saltscapstone/capstone/robot_photos/IMG_0165.JPG

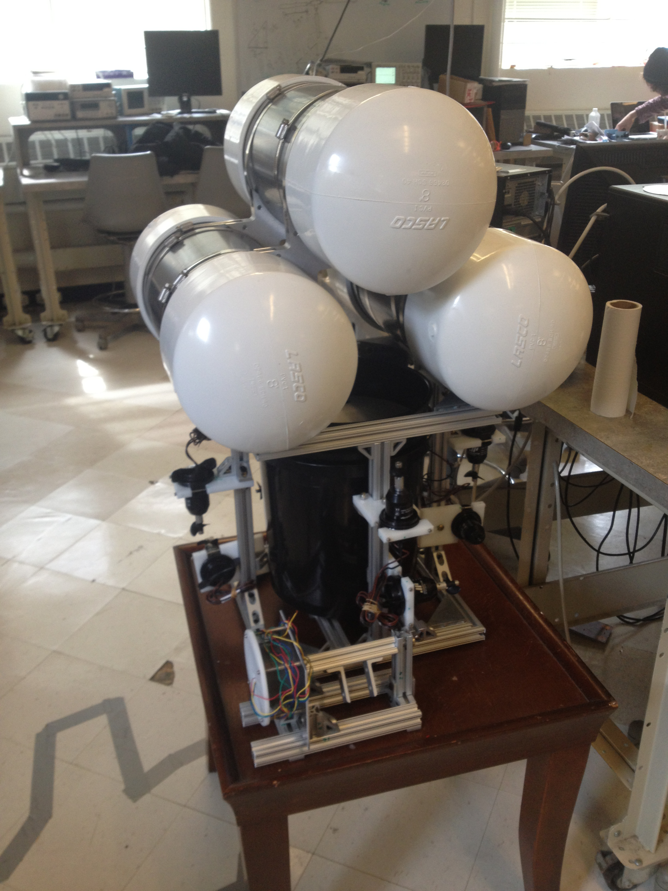
robot_photos/IMG_0165.JPG
