saltscapstone/capstone/robot_photos/IMG_0167.JPG

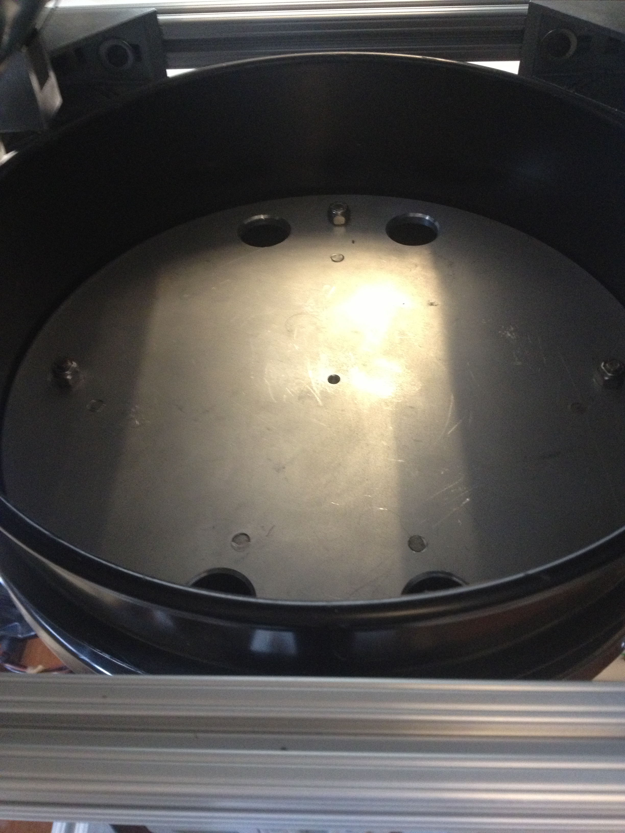
robot_photos/IMG_0167.JPG
