saltscapstone/capstone/robot_final/Team Drawings/E-VolumeForElectronics.pdf

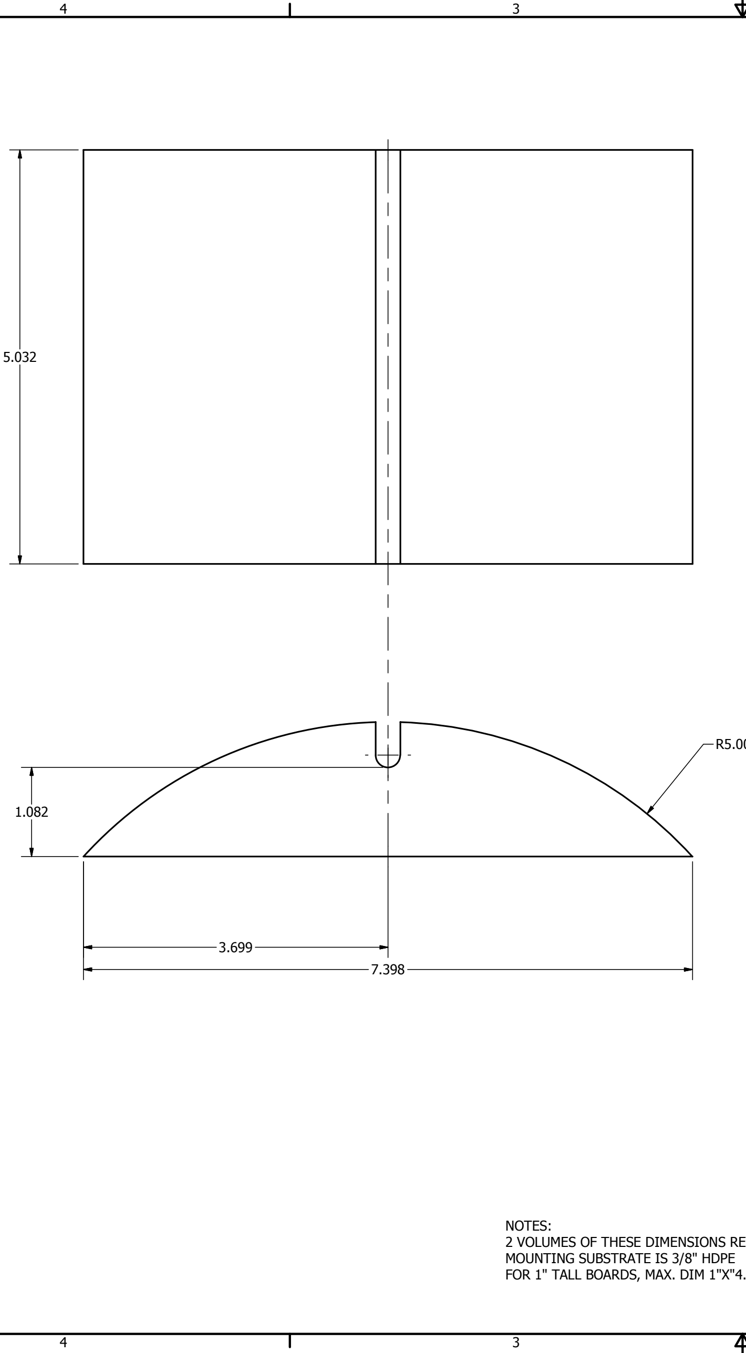
[picture p35: figure]
RAT
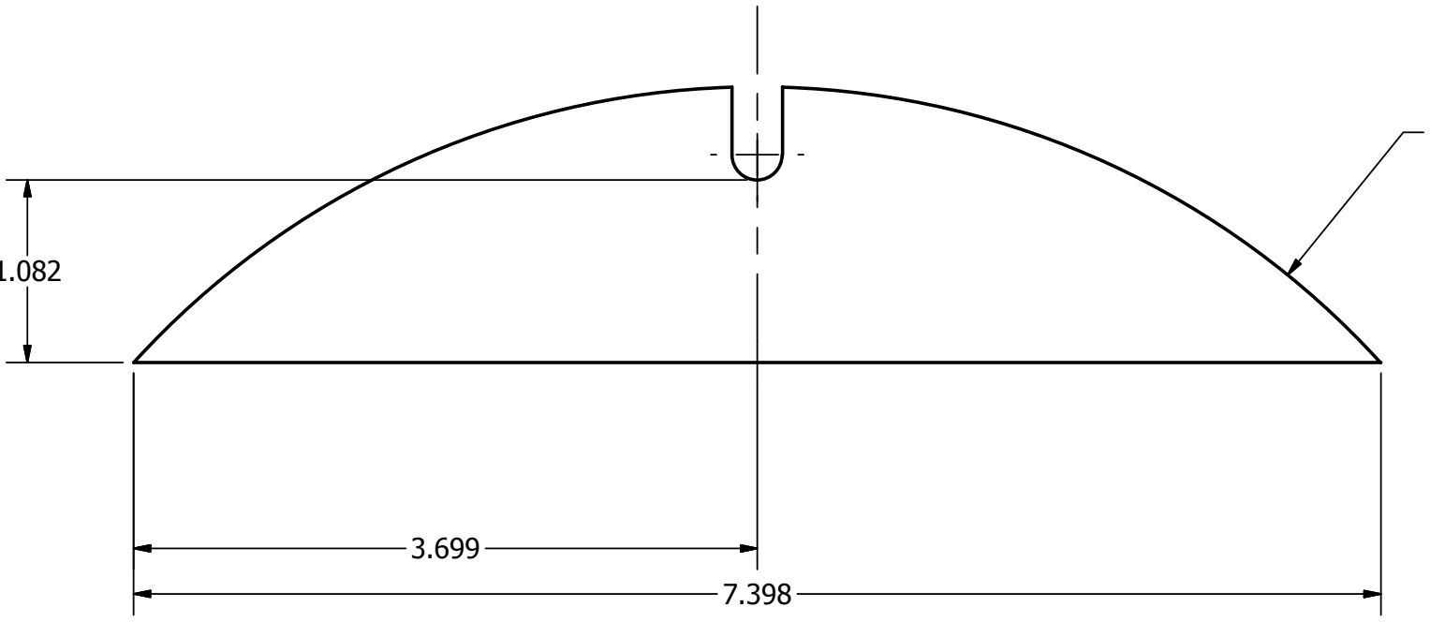
[picture p36: figure]

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
## TIO

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
## TIO

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
## PRODUCED BY AN AUTODESK EDUCATIONAL PRODUCT

## PRODUCED BY AN AUTODESK EDUCATIONAL PRODUCT

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
## olu

m

e

F

o

r

## Ele

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
