saltscapstone/capstone/robot_final/Drawings/RenumberedDrawings/1.pdf

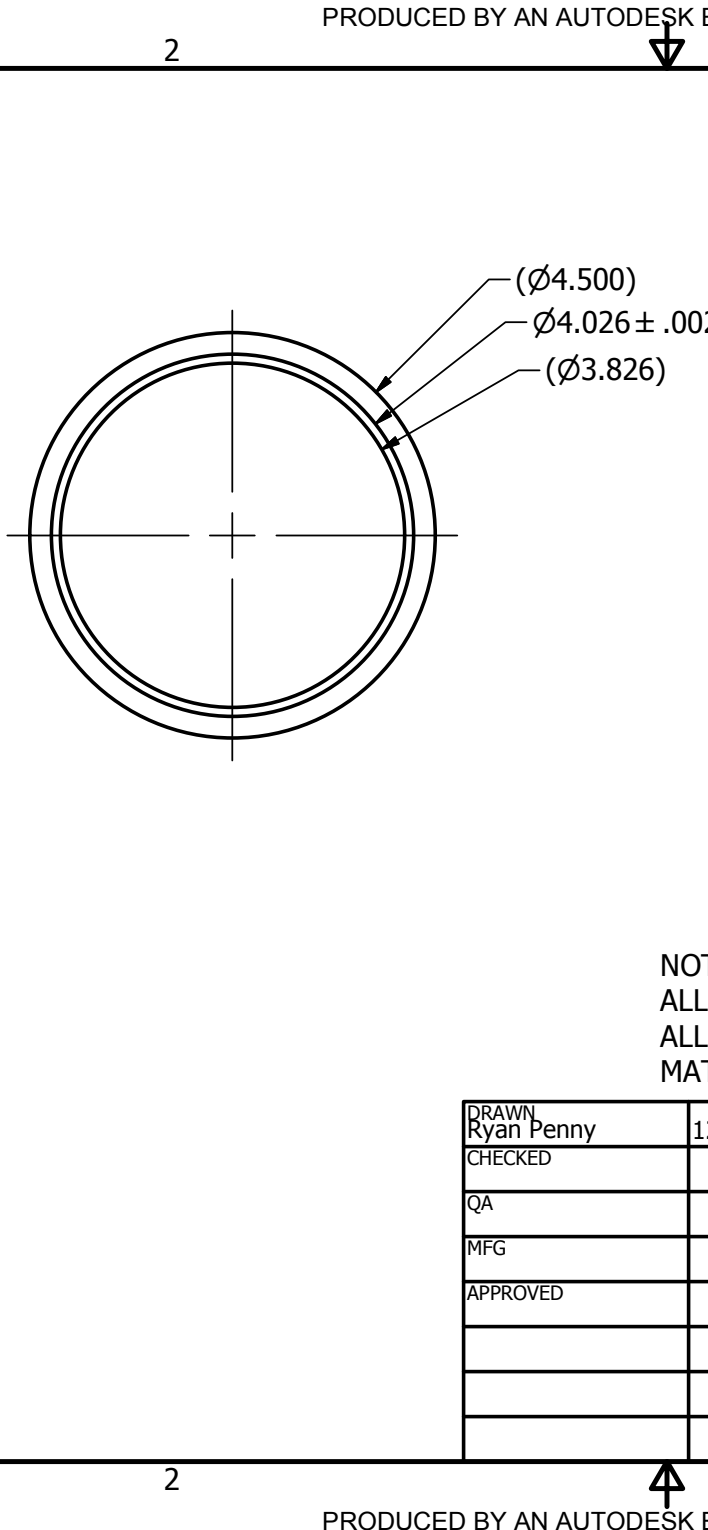
[picture p37: figure]
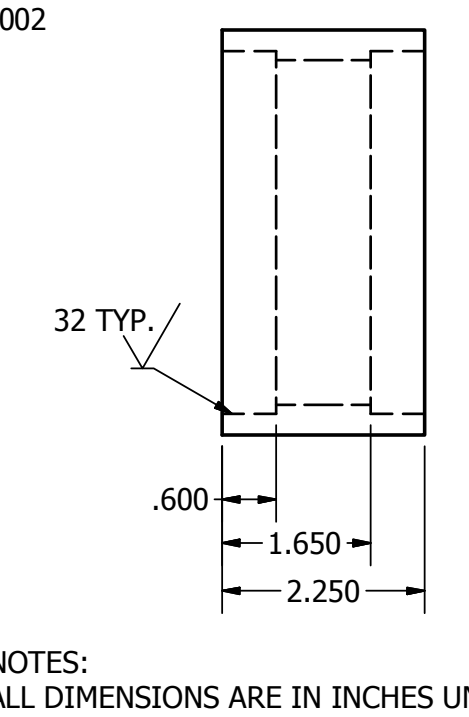
[picture p38: figure]

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
PRODUCED BY AN AUTODESK EDUCATIONAL PRODUCT

PRODUCED BY AN AUTODESK EDUCATIONAL PRODUCT

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
