saltscapstone/capstone/robot_final/Drawings/RenumberedDrawings/13.pdf

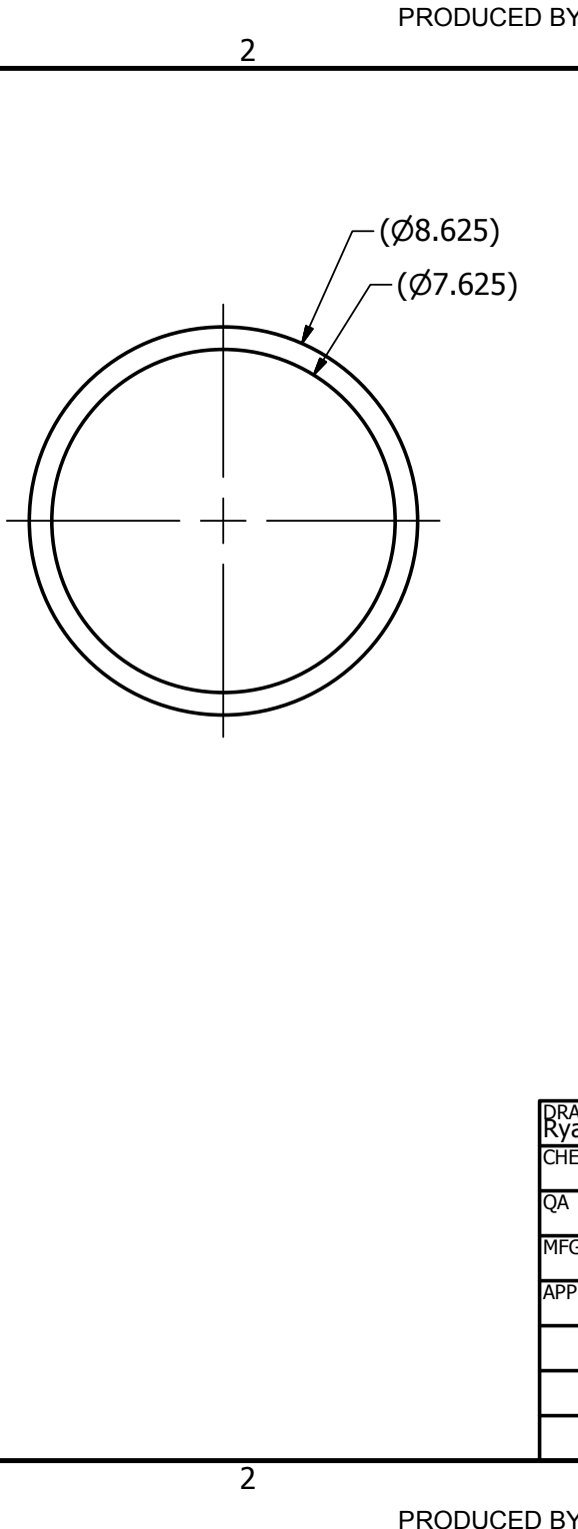
[picture p39: figure]

Y

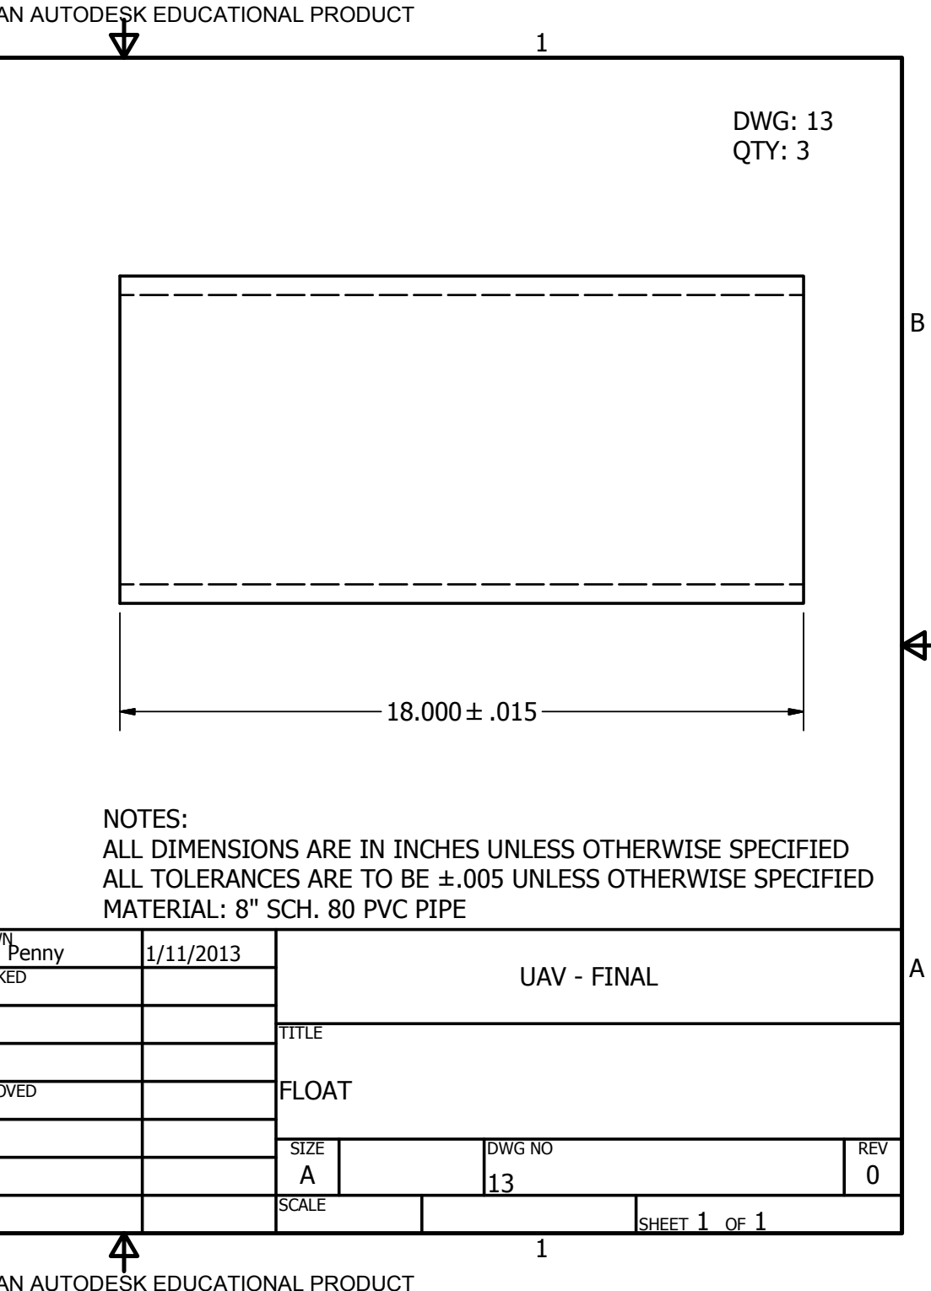
[picture p40: figure]
TIO

A

Y

A

PRODUCED BY AN AUTODESK EDUCATIONAL PRODUCT

PRODUCED BY AN AUTODESK EDUCATIONAL PRODUCT

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
