saltscapstone/capstone/robot_final/Drawings/RenumberedDrawings/24.pdf

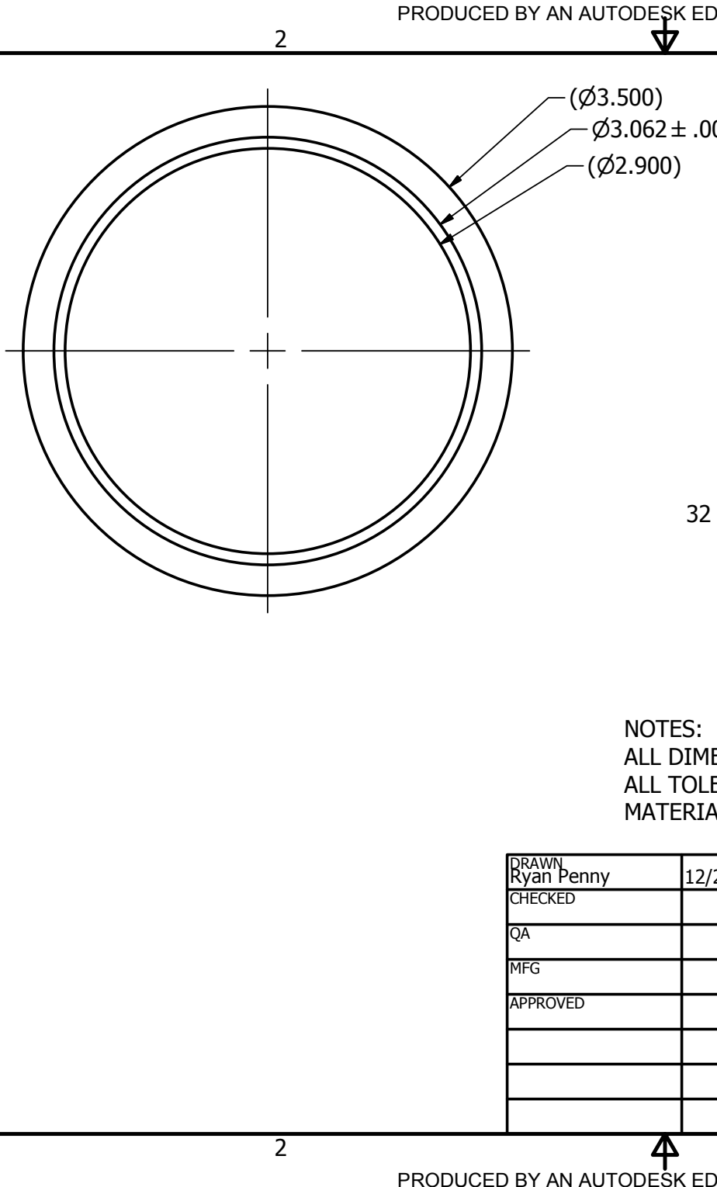
[picture p41: figure]

PRODUCED BY AN AUTODESK EDUCATIONAL PRODUCT

PRODUCED BY AN AUTODESK EDUCATIONAL PRODUCT

A

A

B

B

R

E

V0

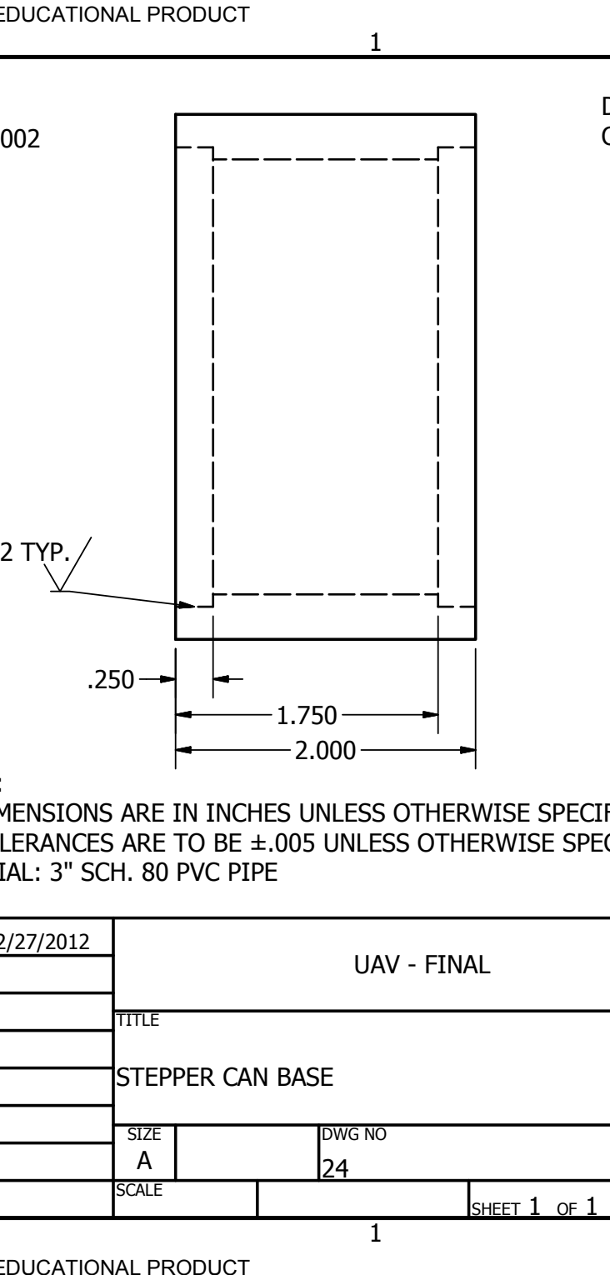
[picture p42: figure]
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
