saltscapstone/capstone/robot_final/MotorAssyR.bmp

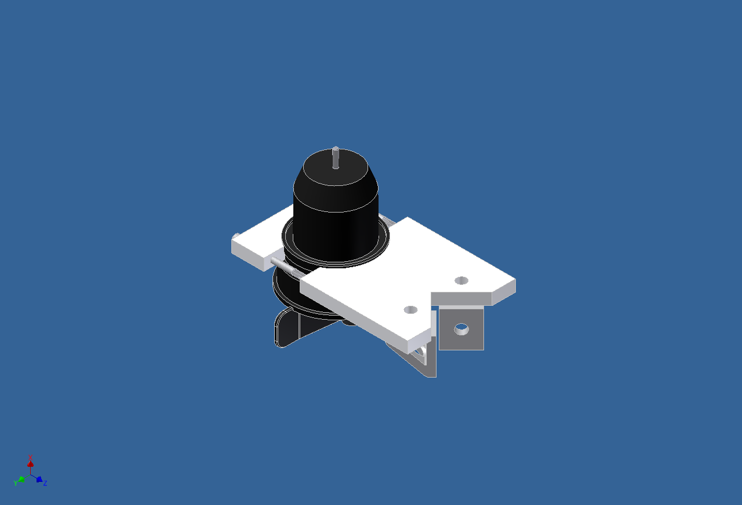
robot_final/MotorAssyR.bmp
