saltscapstone/capstone/robot_final/Team Drawings/JAN-8-2012.jpg

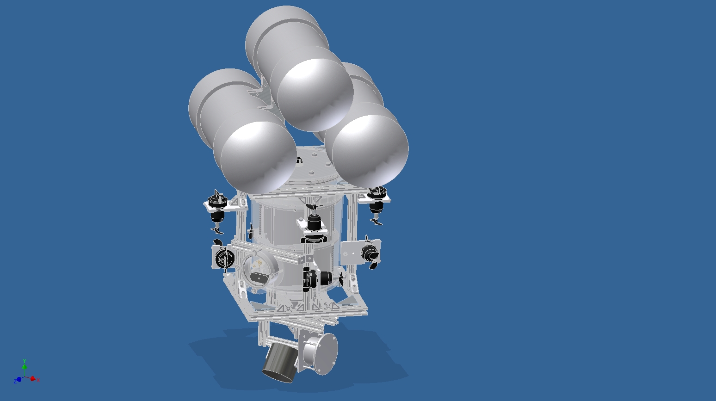
robot_final/Team Drawings/JAN-8-2012.jpg
