saltscapstone/capstone/robot_photos/Camera.bmp

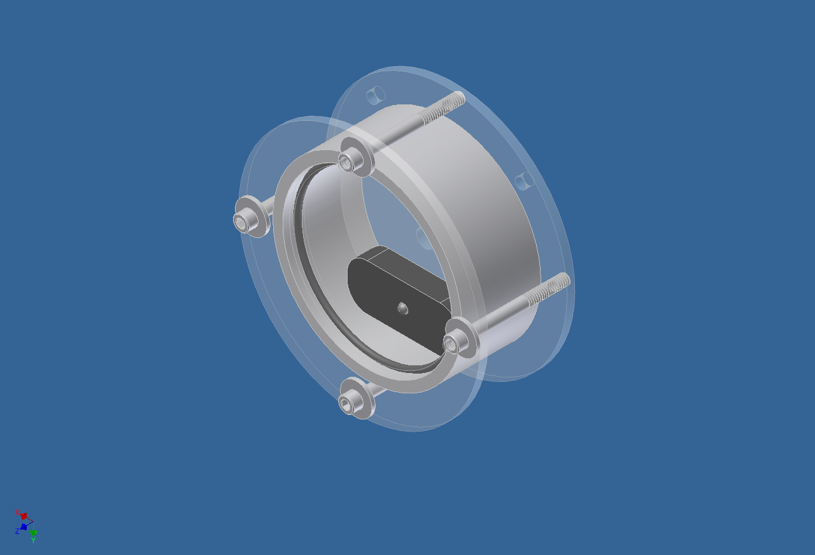
robot_photos/Camera.bmp
