saltscapstone/capstone/robot_photos/Electrical2.bmp

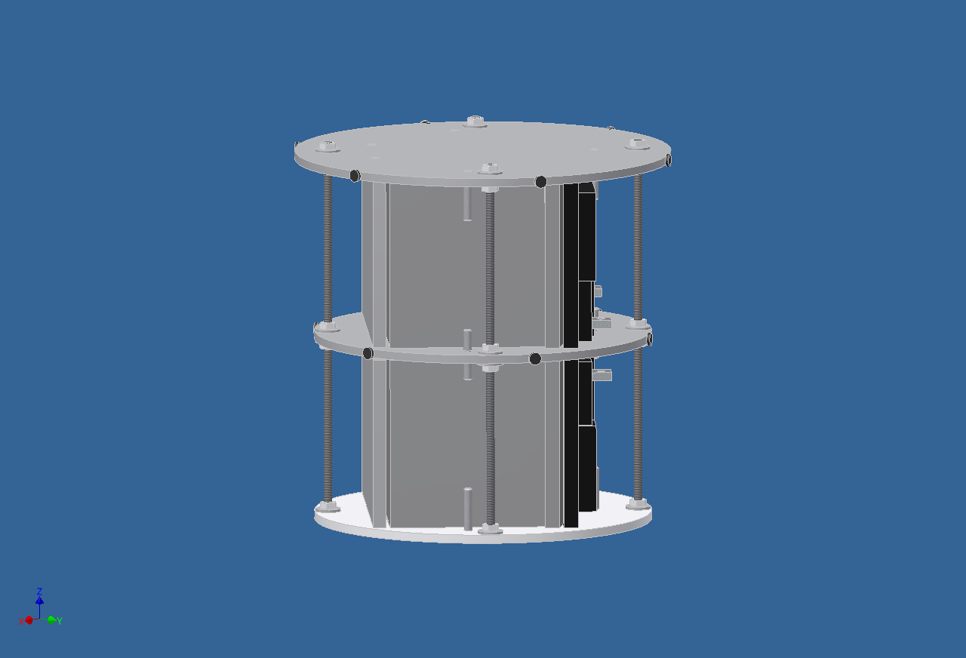
robot_photos/Electrical2.bmp
