saltscapstone/capstone/robot_photos/Electrical.bmp

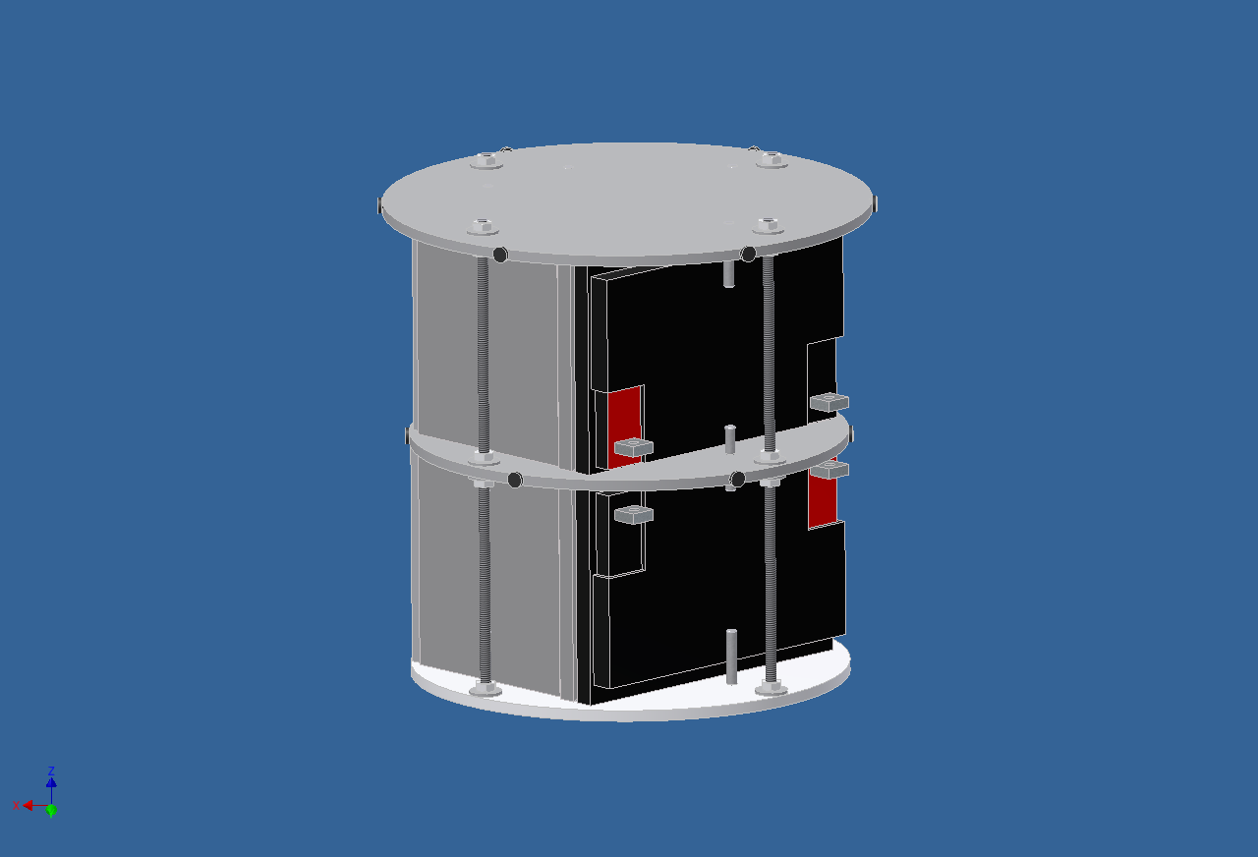
robot_photos/Electrical.bmp
