saltscapstone/capstone/robot_photos/Gimbal.bmp

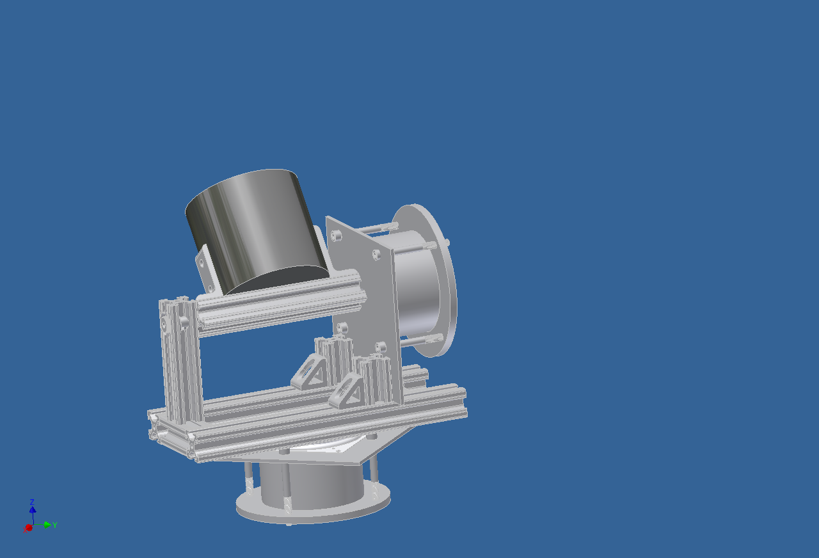
robot_photos/Gimbal.bmp
