saltscapstone/capstone/robot_photos/IMG_0157.JPG

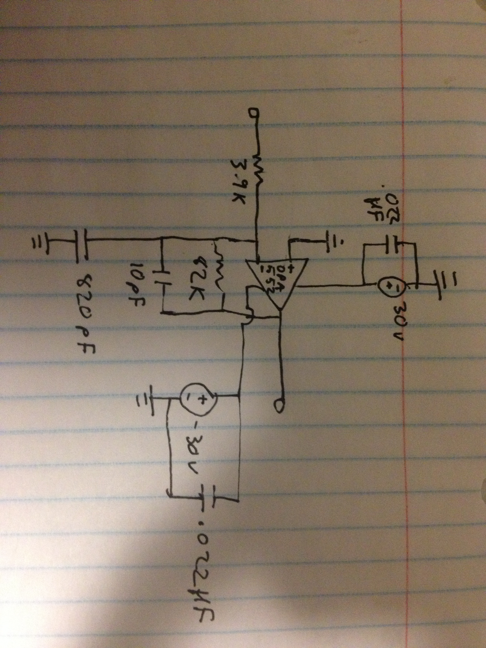
robot_photos/IMG_0157.JPG
