saltscapstone/capstone/robot_photos/IMG_0159.JPG

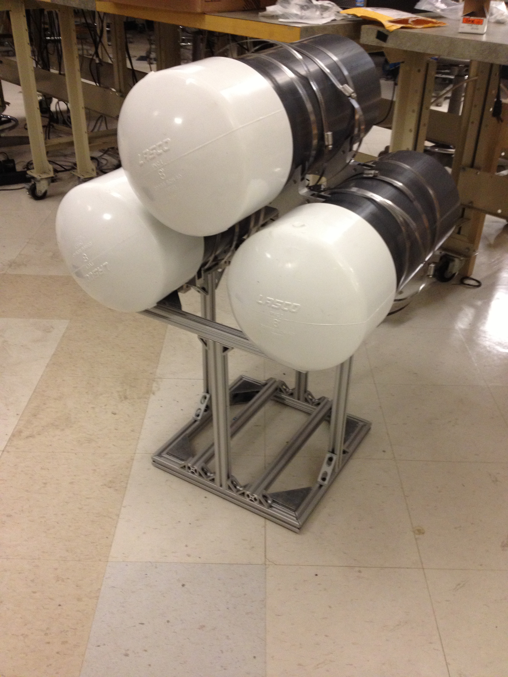
robot_photos/IMG_0159.JPG
