saltscapstone/capstone/robot_photos/IMG_0160.JPG

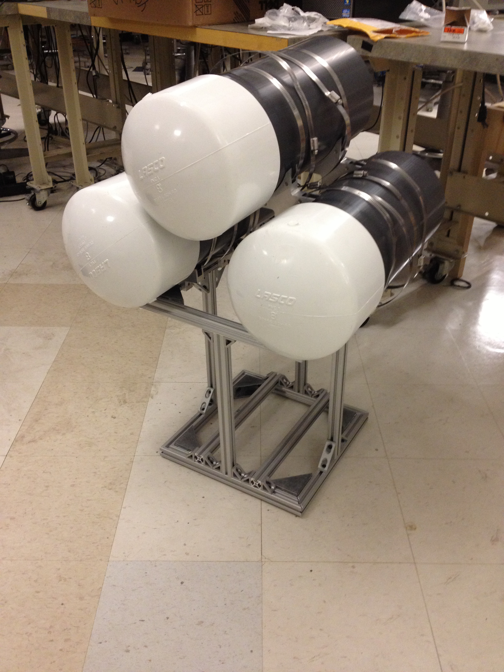
robot_photos/IMG_0160.JPG
