saltscapstone/capstone/robot_photos/IMG_0163.JPG

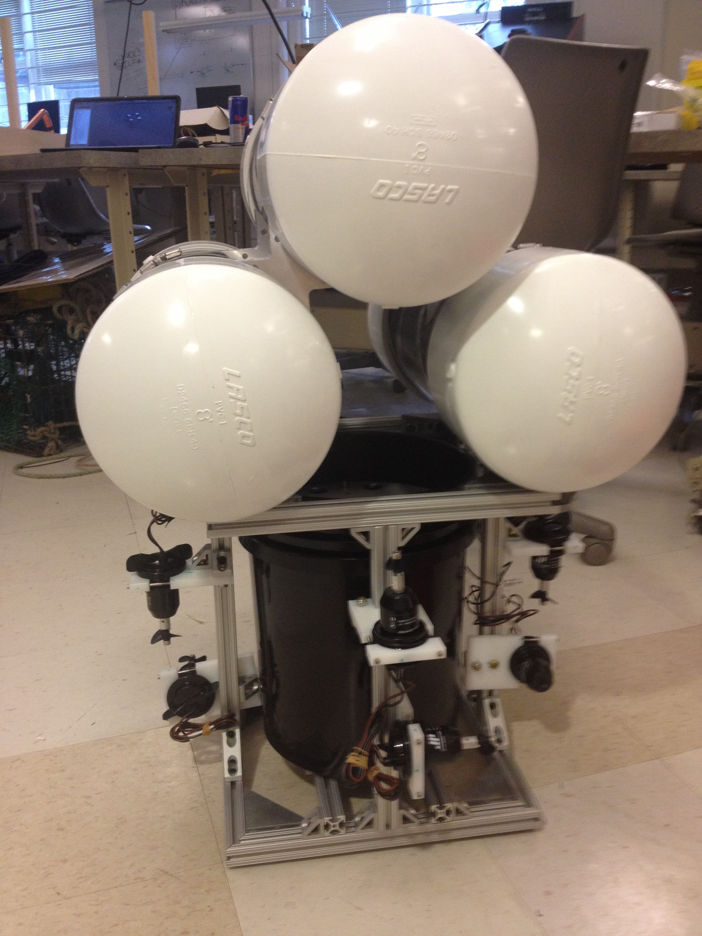
robot_photos/IMG_0163.JPG
