saltscapstone/capstone/robot_photos/IMG_0164.JPG

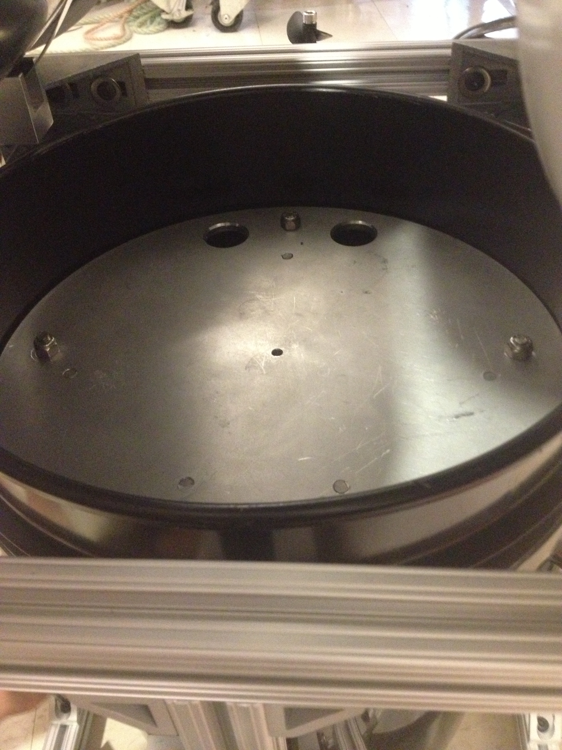
robot_photos/IMG_0164.JPG
