saltscapstone/capstone/robot_photos/IMG_0166.JPG

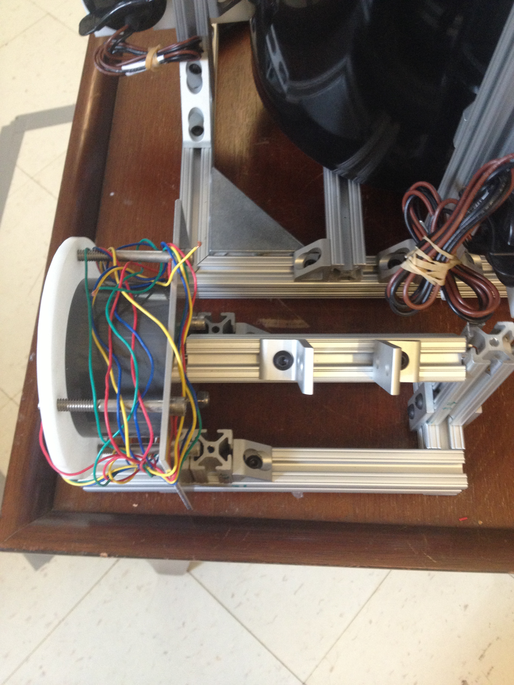
robot_photos/IMG_0166.JPG
