saltscapstone/capstone/robot_photos/IMG_0179.JPG

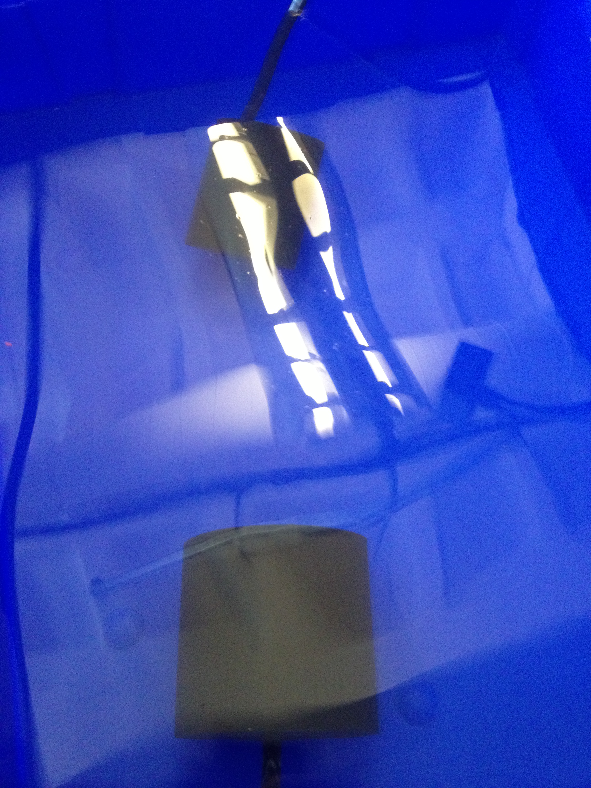
robot_photos/IMG_0179.JPG
