saltscapstone/capstone/robot_photos/IMG_0183.JPG

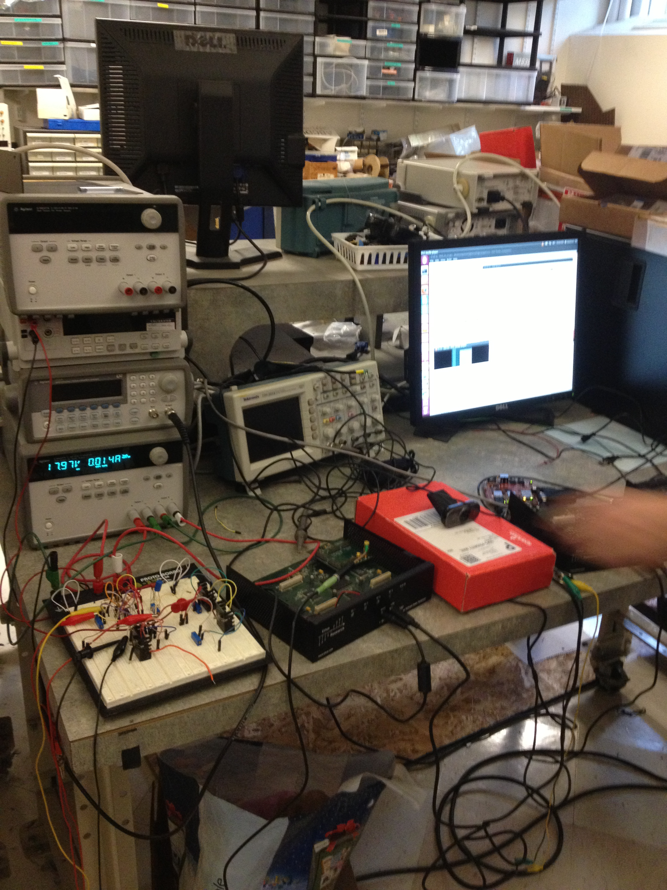
robot_photos/IMG_0183.JPG
