saltscapstone/capstone/robot_photos/IMG_0184.JPG

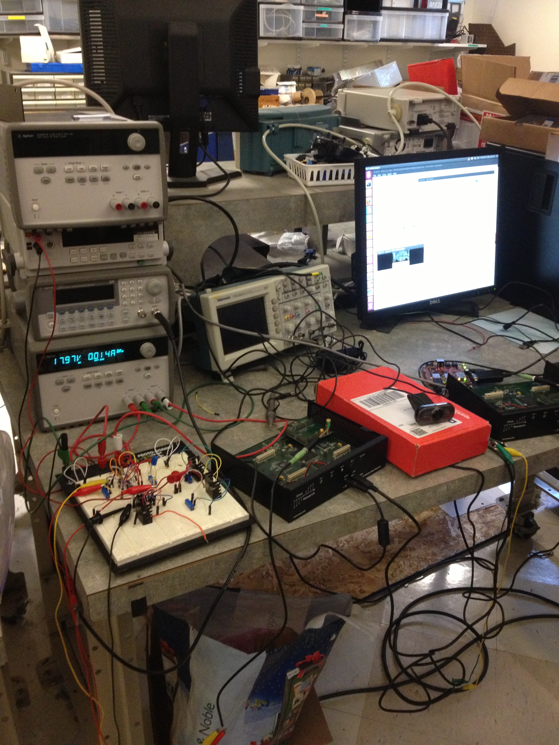
robot_photos/IMG_0184.JPG
