saltscapstone/capstone/robot_photos/IMG_0185.JPG

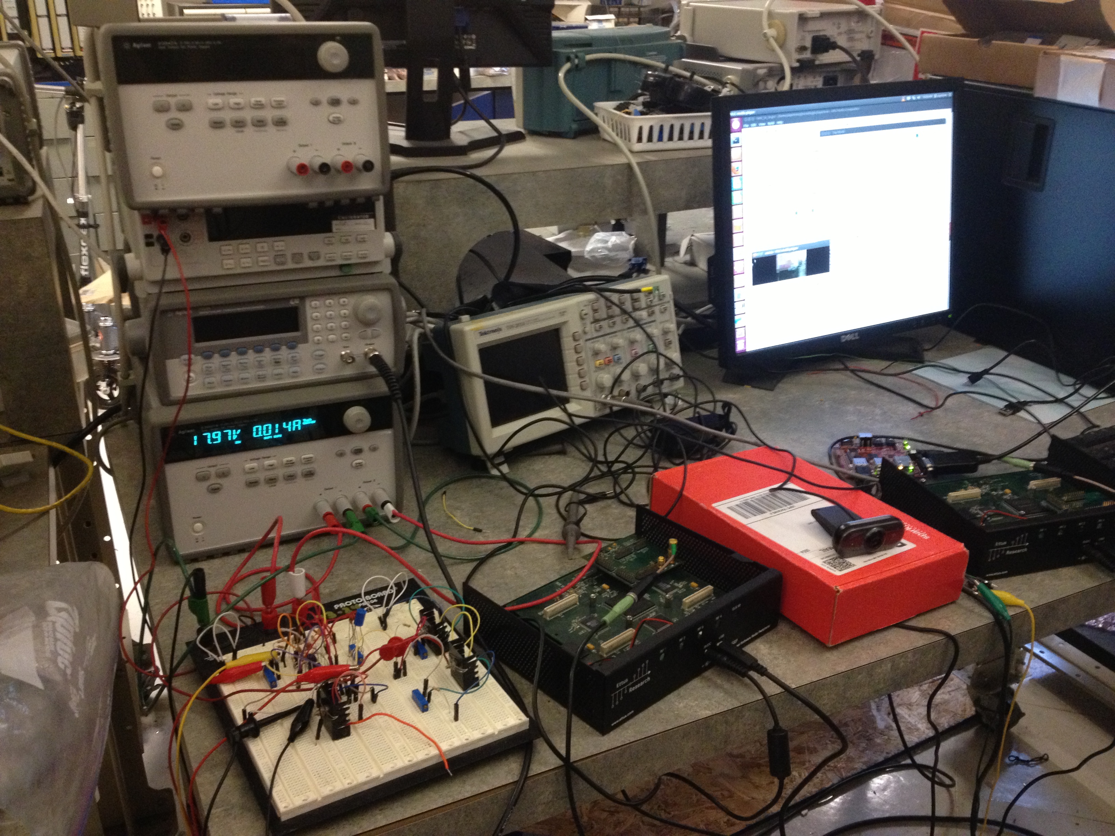
robot_photos/IMG_0185.JPG
