saltscapstone/capstone/robot_photos/MotorAssyT.bmp

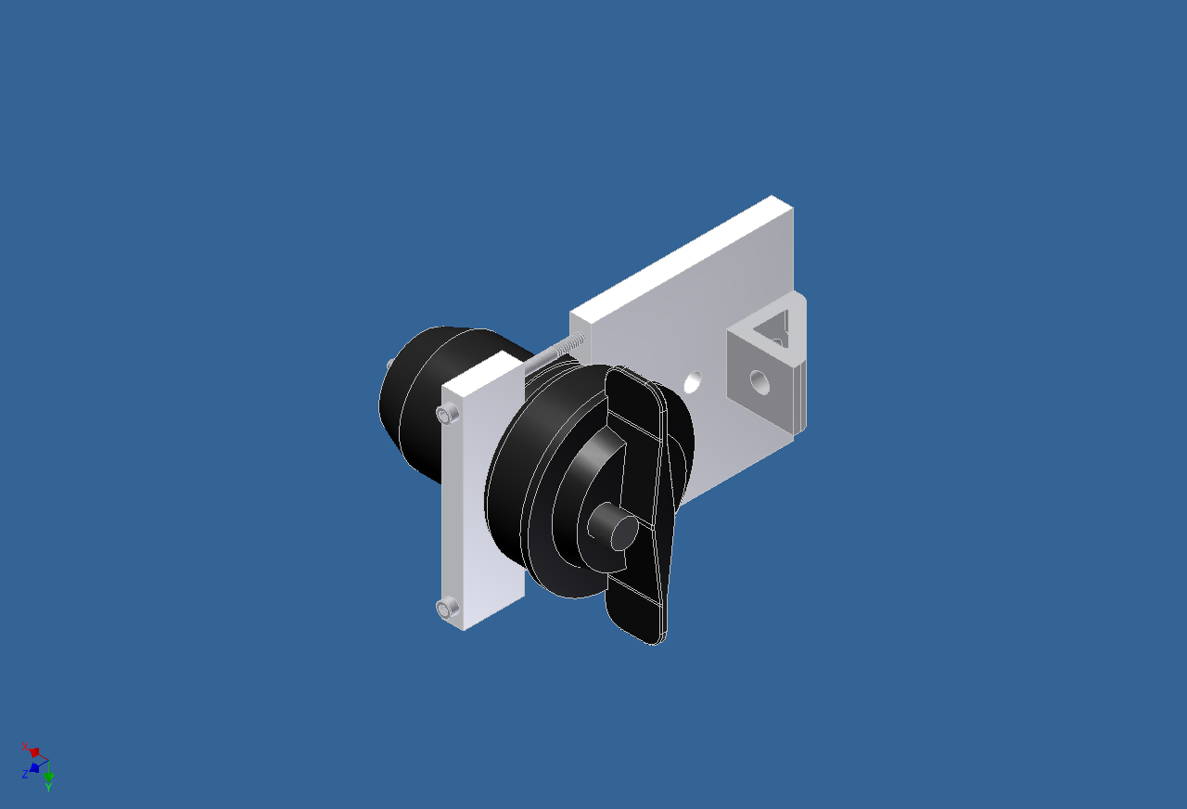
robot_photos/MotorAssyT.bmp
