saltscapstone/capstone/admin/Capstone Group 1 Expense Report.xlsx

Date | Part # | Item Name | QTY | Subtotal | Shipping(if any) | Tax(if any) | Reimburse | Link
2012-06-08 | N/A | Logitech Webcam C210 | 1 | 24.94 | 0 | 0 | Rafal | http://www.amazon.com/gp/product/B003LVZO88/ref=oh_details_o06_s00_i00?ie=UTF8&psc=1
2012-09-13 | SLA-12V35 | 12 Volt 35 Ah AGM Lead Acid Battery | 2 | 129.44 | 18.01 | 0 | Rafal | http://www.batterymart.com/p-12v-35ah-sealed-lead-acid-battery-group-u1.html
2012-09-13 | GW0.5-01-14 | Acetal Worm Gear | 3 | 7.5 | 0 | 0 | Rafal | http://www.gizmoszone.com/shopping/agora.cgi
 | GWG0.5-20-31 | 20 Tooth Acetal Worm Gear | 3 | 6.45 | 4 | 0 | Rafal | http://www.gizmoszone.com/shopping/agora.cgi
2012-09-13 | MAY-28552 | MayFair Bilge Pump Motors | 8 | 136.56 | 10.89 | 0 | Rafal | http://www.wholesalemarine.com/p/MAY-28552/Mayfair+Replacement+Cartridge+Bilge+Pump+Motors.html
2012-09-13 | 3995T439 | 5 Gallon Bucket | 2 | 21.78 | 12.91 | 0 | Rafal | 3995T439
2012-09-13 | ROB-09238 | Stepper Motors | 2 | 29.9 | 7.78 | 0 | Rafal | ROB-09238
2012-11-28 | RA3002 | 40mm Propeller Dog | 7 | 11.83 | 2.55 | 0 | Rafal | http://www.hobby-lobby.com/40mm_prop_3_16_drive_dog_2939_prd1.htm
2013-01-11 | 296-25798-ND | BEAGLEBOARD XM | 1 | 149 | 5.61 | 9.31 | Rafal | http://www.digikey.com/scripts/DkSearch/dksus.dll?WT.z_header=search_go&lang=en&x=0&y=0&cur=USD
2013-01-25 | 927 | .5 EXT AL ROUND | 1 | 0 | 0 | 0 | Rafal | N/A - In Peson
 | 7974 | .125 AL SHEET | 1 | 0 | 0 | 0 | Rafal | N/A - In Peson
 | R4271 | .25 AL PLATE | 1 | 0 | 0 | 0 | Rafal | N/A - In Peson
 | 772 | 3x5 AL RECTANGLE | 1 | 153.92 | 0 | 0 | Rafal | N/A - In Peson
2013-01-28 | 1008 | 12x4 EXT AL ROUND | 1 | 155.09 | 0 | 0 | Rafal | N/A - In Peson
2013-01-30 | 8549T28 | 3/8 NPT Male to Male | 1 | 22.37 | 0 | 0 | Rafal | http://www.mcmaster.com/nav/enter.asp?partnum=8549T28
 | 4464K236 | Type 304 Stainless Steel Fitting | 1 | 6.32 | 0 | 0 | Rafal | http://www.mcmaster.com/nav/enter.asp?partnum=4464K236
 | 8619k83 | 12"x48 HDPE Polyethylene | 1 | 60.21 | 0 | 0 | Rafal | http://www.mcmaster.com/nav/enter.asp?partnum=8619K83
 | 93250A029 | 1/4"-20 Thread 6' Stainless STL ROD | 1 | 12.04 | 0 | 0 | Rafal | http://www.mcmaster.com/nav/enter.asp?partnum=93250A029
 | 48855K43 | Sched 80 PVC Unthreaded | 1 | 116.19 | 0 | 0 | Rafal | http://www.mcmaster.com/nav/enter.asp?partnum=48855K43
 | 9173K421 | Sched 80 PVC Size 3 Nipple | 1 | 24.2 | 0 | 0 | Rafal | http://www.mcmaster.com/nav/enter.asp?partnum=9173K421
 | 9173K622 | Sched 80 PVC Size 4 Nipple | 1 | 17.44 | 48.49 | 0 | Rafal | http://www.mcmaster.com/nav/enter.asp?partnum=9173K622
2013-01-30 | 8560K165 | Optically Clear Acryllic Sheet | 1 | 21.38 | 5.47 | 0 | Rafal | http://www.mcmaster.com/#catalog/119/3558/=m28qoe
2013-01-31 | 6620K41 | 12"x12" Type 304 Stainless Steel | 1 | 123.97 | 9.52 | 0 | Rafal | http://www.mcmaster.com/nav/enter.asp?partnum=6620K41
2013-01-31 | 1010x97 | 80/20 Extrusion | 3 | 66.93 | 19.8 | 0 | Rafal | www.airinc.com
2013-02-06 | PA0095-S | Stensil | 1 | 10.99 | 0 | 0 | Rafal
 | PA0095 | Break Out Board | 1 | 12.99 | 8 | 0 | Rafal | http://www.proto-advantage.com/store/product_info.php?products_id=2200111{1}1{2}6
2013-02-26 | 25R8311 | Microchip PicKit3 | 1 | 44.95 | 5.29 | 0 | Rafal | http://www.newark.com/microchip/dv164131/debug-express-pickit-3-mplab-ide/dp/50P9695
2013-03-10 | DA2032-ALB | Transformers | 5 | 11.9 | 8 | 0 | Rafal | http://www.coilcraft.com/da2032.cfm | Transformers | 5 | 11.9 | 8 | 0 | Rafal
 |  |  |  | 1378.29 | 166.32 | 9.31
 |  |  |  | Total Cost | Total Shipping | Total Tax | 1544.61 | Reimburse Complete
2013-03-12 | 9452K375 | Buna-N O-Ring,Number 276 | 2 | 17.94 |  | 0 | Rafal
 | 9452K191 | Buna-N O-Ring, AS568A Dash Number 240 | 1 | 11.15 |  | 0 | Rafal
 | 9452K157 | Buna-N O-Ring, AS568A Dash Number 150 | 1 | 8.68 |  | 0 | Rafal
 | 6031K2 | Corrosion-Resistant Turntable, Aluminum, 4" Square | 1 | 14.95 |  | 0 | Rafal
 | 91292A025 | Metric 18-8 Stainless Steel Socket Head Cap Screw, M3 Thread, 45MM Length, 0.5MM Pitch, packs of 50 | 1 | 10.81 |  | 0 | Rafal
 | 92290A113 | Metric 316 Stainless Steel Socket Head Cap Screw, M3 Thread, 8MM Length, .5MM Pitch, packs of 50 | 1 | 9.63 |  | 0 | Rafal
 | 93783A007 | Pressure-Sealing Washer for Screws & Bolts, No. 6 Screw Size, .39" OD, .03"-.05" Thickness, packs of 10 | 2 | 20.6 |  | 0 | Rafal
 | 97345A624 | 316 Stainless Steel Shoulder Screw, 3/8" Shoulder Diameter, 1" L Shoulder, 5/16"-18 Thread | 1 | 6.07 |  | 0 | Rafal
 | 93783A031 | Pressure-Sealing Washer for Screws & Bolts, 3/8" Screw Size, .67" OD, .04"-.06" Thickness, packs of 10 | 1 | 10.64 |  | 0 | Rafal
 | 92196A621 | 18-8 Stainless Steel Socket Head Cap Screw, 3/8"-16 Thread, 5/8" Length, packs of 10 | 1 | 6.8 |  | 0 | Rafal
 | 97022A243 | Type 316 Stainless Steel Shim, .045" Thick, 1/2" ID, 3/4" OD, packs of 10 | 1 | 11.27 |  | 0 | Rafal
 | 91831A029 | 18-8 Stainless Steel Nylon-Insert Hex Locknut, 1/4"-20 Thread Size, 7/16" Width, 5/16" Height, packs of 50 | 1 | 5.01 |  | 0 | Rafal
 | 92313A143 | Type 316 Stainless Steel Cup Point Set Screw, 6-32 Thread, 3/16" Long, packs of 50 | 1 | 5.14 |  | 0 | Rafal
 | 92185A541 | Type 316 Stainless Steel Socket Head Cap Screw, 1/4"-20 Thread, 7/8" Length, packs of 10 | 1 | 5.23 |  | 0 | Rafal
 | 92196A160 | 18-8 Stainless Steel Socket Head Cap Screw, 6-32 Thread, 2-1/4" Length, packs of 25 | 1 | 5.71 |  | 0 | Rafal
 | 8635K83 | Medium-Strength Oil-Resistant Buna-N Rubber, Adhesive Back, 1/8" Thickness, 12" X 24", 40A Durometer | 1 | 29.35 |  | 0 | Rafal
 | 9309K12 | Rubber Push-in Bumper, Tight-Grip Ridged Stem, Fits 5/32" Hole Size, packs of 100 | 1 | 8.15 |  | 0 | Rafal
 | 93852A102 | 18-8 Stainless Steel Type A USS Flat Washer, 1/4" Screw Size, 3/4" OD, .05"-.08" Thick, packs of 50 | 1 | 5.88 |  | 0 | Rafal
 | 92196A552 | 18-8 Stainless Steel Socket Head Cap Screw, 1/4"-20 Thread, 2-1/2" Length, packs of 25 | 1 | 9.14 |  | 0 | Rafal
 | 4880K142 | Standard-Wall White PVC Pipe Fitting, 8 Pipe Size, Cap | 6 | 192.18 |  | 0 | Rafal
 | 5416K43 | Worm-Drive Hose & Tube Clamp with 410SS Screw, 7-1/8" to 10" Clamp Diameter Range, 9/16" Band Width, Packs of 5 | 2 | 18.46 |  | 0 | Rafal
 | 90145A542 | 18-8 Stainless Steel Dowel Pin, 1/4" Diameter, 1" Length, Packs of 10 | 4 | 24.96 | 28.88 | 0 | Rafal
2013-03-15 | 91292A025 | Metric 18-8 Stainless Steel Socket Head Cap Screw, M3 Thread, 45MM Length, 0.5MM Pitch, Packs of 50 | 1 | 10.81 | 4.8 | 0 | Rafal
2013-03-15 | RA3002 | 40mm Propeller Dog | 1 | 1.69 | 1 | 0 | Rafal | http://www.hobby-lobby.com/40mm_prop_3_16_drive_dog_2939_prd1.htm
2013-03-18 | 14103 | 4 Hole inside corner bracket | 8 | 44.8 |  | 0 | Rafal | www.airinc.com
 | 4132 | 1x1 corner gusset | 33 | 130.35 |  | 0 | Rafal | www.airinc.com
 | 4136 | 2x1 ins corner gusser | 16 | 90.4 |  | 0 | Rafal | www.airinc.com
 | 4176 | #10 ins/cor/bracket | 4 | 15.4 |  | 0 | Rafal | www.airinc.com
 | 4107 | #10 2hole join strip | 10 | 34 |  | 0 | Rafal | www.airinc.com
 | 3204 | 10s 1/4-20 std t-nut black | 200 | 158 | 10.51 | 0 | Rafal | www.airinc.com
2013-03-22 | 1010x97 | 80/20 Extrusion | 1 | 24.26 | 12.3 | 0 | Rafal
2013-03-26 | 18815K91 | PVC Cement for 8" & Up Pipe, 8 oz Can, Clear | 1 | 5.3 |  | 0 | Rafal
 | 18815K71 | PVC & CPVC Primer, 8 oz Can, Purple | 1 | 5.16 |  | 0 | Rafal
 | 7448A22 | Urethane Adhesive in Easy-Dispensing Syringe, Begins to Harden at 4-6 Minutes, 1.7-Ounce, Black | 1 | 10.1 |  | 0 | Rafal
 | 3995T21 | Snap-Lock Black Lid with Spout for, UN-Compliant Plastic Shipping Pail | 2 | 9.36 |  | 0 | Rafal
 | 5416K44 | Worm-Drive Hose & Tube Clamp with 410SS Screw, 9-3/8" to 12-1/4" Clamp Diameter Range, 9/16" Band Width, packs of 5 | 1 | 9.25 |  | 0 | Rafal
 | 8969K73 | Ultra-Strength Oil-Resistant Buna-N Rubber, Plain Back, 1/16" Thick, 12" X 24", 50A Durometer | 1 | 17.85 |  | 0 | Rafal
 | 6455K15 | Lubrication-Free Acetal Ball Bearing, Stainless Steel Balls, 3/8" Shaft Diameter, 7/8" OD, 7/32" Width | 1 | 6.39 |  | 0 | Rafal
 | 9452K168 | Buna-N O-Ring, AS568A Dash Number 106, packs of 100 | 1 | 1.97 |  | 0 | Rafal
 | 91420A140 | Metric Flat Head Phillips Machine Screw, Zinc-Plated Steel, M3 Size, 50MM Length, .5MM Pitch, packs of 50 | 1 | 9 |  | 0 | Rafal
 | 91292A026 | Multicord Nylon Liquid-Tight Cord Grip, 1/2" NPT, for 6 Cords, 0.10"-0.12" Cord Diameter Range | 3 | 12.99 |  | 0 | Rafal
 | 7807K42 | Multicord Nylon Liquid-Tight Cord Grip, 3/4" NPT, for 4 Cords, 0.20"-0.24" Cord Diameter Range | 1 | 6.24 |  | 0 | Rafal
 | 7807K46 | Nylon Liquid-Tight Cord Grip (NEMA 6), Straight Standard, 1/2" NPT, .39"-.56" Cord Diameter | 1 | 3.46 |  | 0 | Rafal
 | 69915K57 | Metric 18-8 Stainless Steel Socket Head Cap Screw, M3 Thread, 14MM Length, 0.5MM Pitch, packs of 100 | 1 | 3.26 | 5.97 | 0 | Rafal
2013-03-26 | 5416K43 | Worm-Drive Hose & Tube Clamp with 410SS Screw, 7-1/8" to 10" Clamp Diameter Range, 9/16" Band Width, Packs of 5 | 1 | 9.23 | 4.8 | 0 | Rafal
2013-03-22 | 1124049 | 1/4-20 x1/2 BHSCS | 1 | 10.71 | 0 | 0.67 | Rafal | Fastenal (in store)
2013-04-12 | 1124050 | 1/4-20 x5/8 BHSCS | 1 | 12.48 | 0 |  | Rafal
 | 1123214 | 1/4-20 x2-3/4 SHCS | 1 | 22.38 | 0 |  | Rafal
 | 1124049 | 1/2-20 x1/2 BHSCS | 1 | 10.71 | 0 | 2.85 | Rafal
2013-03-22 |  | allen wrenches | 1 | 10.59 | 0 | 0 | Rafal | home depot (in store)
2013-04-15 |  | 1/4-20 x2.5 pan handle plus 1/4-20 x3/4 pan screw | 1 | 10.41 | 0 | 0 | Rafal | home depot (in store)
 |  | 1/4-20 by 1inch screws | 1 | 8.16 | 0 | 0 | Rafal | home depot (in store)
 |  |  |  | 1142.46 | 68.26 |  | 1210.72
Date | Part # | Item Name | QTY | Subtotal | Shipping(if any) | Tax(if any) | Reimburse | Link
2013-02-27 | 844-IRF9630PBF | P-Chan 200V 6.5A | 5 | 12.84 | 6.99 | 0 | JAMES
2013-02-27 | AIUR-06-8R2K-ND | Inductor Power 8.2UH 10% T/H | 10 | 5.5 | 0 | 0 | JAMES
 | OPA552FAKTWT | IC OPAMP GP 12MHz SGL HV | 5 | 34.35 | 0 | 0 | JAMES
 | 1N4007-E3/54GICT-ND | DIODE GP 1000V 1A | 10 | 2.85 | 0 | 0 | JAMES
 | IRF630PBF-ND | MOSFET N-Chan 200V 9A | 3 | 3.27 | 0 | 0 | JAMES
 | 237-1251-ND | XFORMER PWR 10.0VCT 2.5A QC .187 | 1 | 7.8 | 7.66 | 4.71 | JAMES
2013-03-06 | LMD18201T/NOPB | Drivers 3A 55V H-Bridge | 14 | 194.04 | 0 | 0 | JAMES
 | 593002B03400G | Heat Sinks TO-220 VERT 13.4 TR | 20 | 12.6 | 0 | 0 | JAMES
 | IRF9630PBF | MOSFET P-Chan 200V 6.5 Amp | 3 | 3.51 | 0 | 0 | JAMES
 | IRF630PBF | MOSFET N-Chan 200V 9.0 Amp | 4 | 4.36 | 0 | 0 | JAMES
 | 1N4744A-TR | Zener Diodes 15 Volt 1.3 Watt | 5 | 1.25 | 0 | 0 | JAMES
 | PCA9306DC1,125 | Translation - Voltage Levels DUAL I2C | 2 | 1.6 | 0 | 0 | JAMES
 | 2N5401G | Transistors Bipolar - BJT 500mA 160V PNP | 5 | 0.6 | 0 | 0 | JAMES
 | 2N5550G | Transistors Bipolar - BJT 600mA 160V NPN | 5 | 1.75 | 6.99 | 0 | JAMES
 | ROBOT_REVA | Robot Board | 2 | 66 | 30.72 | 0 | JAMES
 |  |  |  | 352.32 | 52.36 | 4.71
 |  |  |  | Total Cost | Total Shipping | Total Tax | 409.39
Date | Part # | Item Name | QTY | Subtotal | Shipping(if any) | Tax(if any) | Reimburse | Link
 |  |  |  |  |  |  | COLEMAN
 |  |  |  | Total Cost | Total Shipping | Total Tax
Date | Part # | Item Name | QTY | Subtotal | Shipping(if any) | Tax(if any) | Reimburse | Link
 |  |  |  |  |  |  | RYAN
 |  |  |  | Total Cost | Total Shipping | Total Tax
Date | Part # | Item Name | QTY | Subtotal | Shipping(if any) | Tax(if any) | Reimburse | Link
 |  |  |  |  |  |  | PAT
 |  |  |  | Total Cost | Total Shipping | Total Tax
Date | Part # | Item Name | QTY | Subtotal | Shipping(if any) | Tax(if any) | Reimburse | Link
 |  |  |  |  |  |  | STEVE
 |  |  |  | Total Cost | Total Shipping | Total Tax
 |  | Total Budget
 |  | 3160.01
 |  | 1210.72
 |  | 863.34
 |  | 17.95
 |  | 49.07
 |  | 2141.08
 |  | 678.4
