saltscapstone/capstone/robot_final/8020-4136.SLDPRT

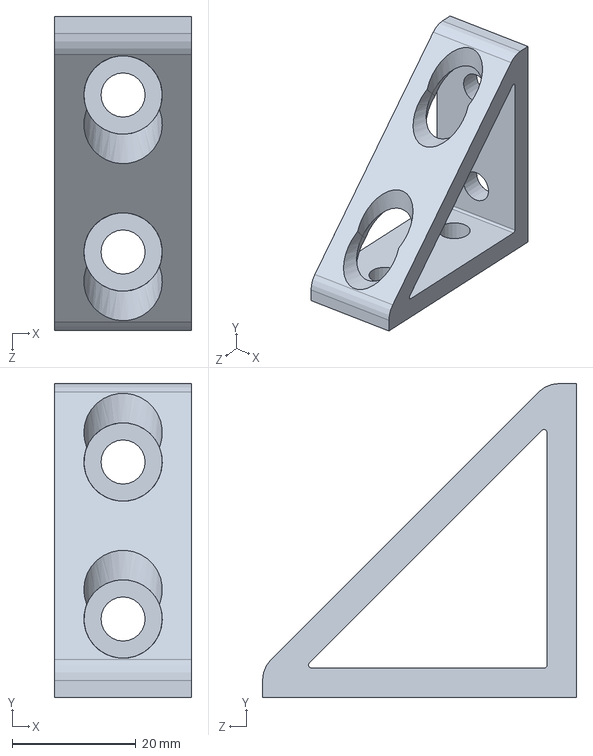
[picture p60: CAD file, 2013-04-26]
robot_final/8020-4136.SLDPRT
22.2 x 50.8 x 50.8 mm
