saltscapstone/capstone/robot_final/92196A160.SLDPRT

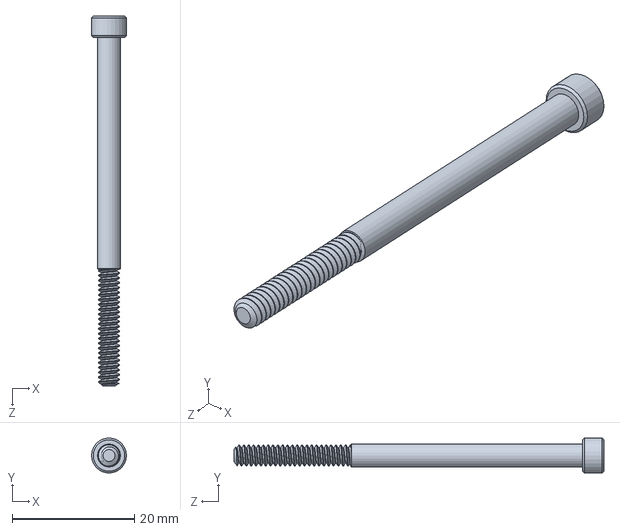
[picture p61: CAD file, 2013-04-26]
robot_final/92196A160.SLDPRT
5.74 x 5.70 x 60.7 mm
