saltscapstone/capstone/robot_project/UAV Final/90145A540.SLDPRT

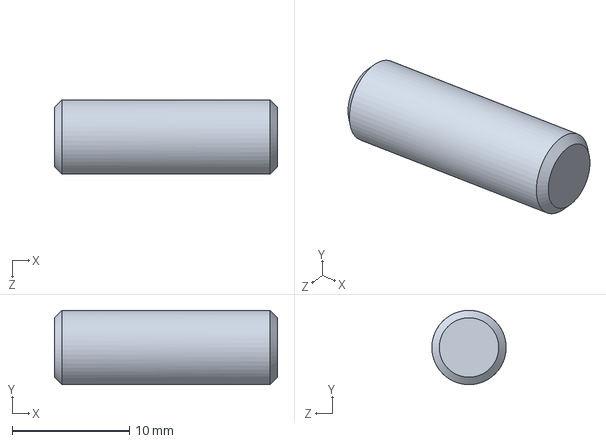
[picture p62: CAD file, 2013-04-26]
robot_project/UAV Final/90145A540.SLDPRT
19.1 x 6.35 x 6.35 mm
