saltscapstone/capstone/robot_project/UAV Final/90145A542.SLDPRT

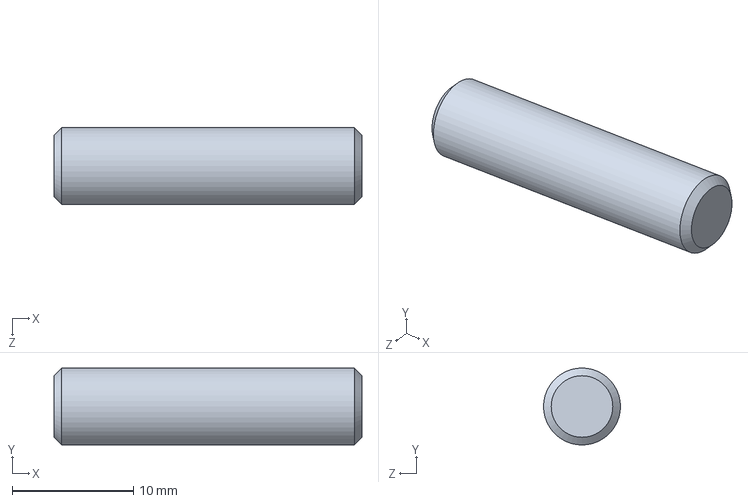
[picture p63: CAD file, 2013-04-26]
robot_project/UAV Final/90145A542.SLDPRT
25.4 x 6.35 x 6.35 mm
