saltscapstone/capstone/robot_final/92290A113.SLDPRT

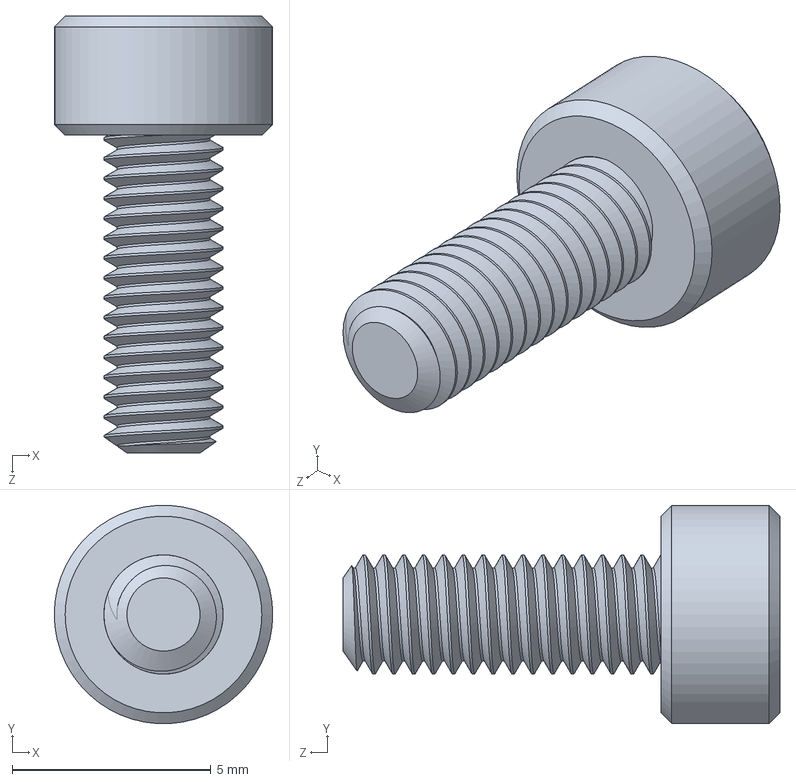
[picture p64: CAD file, 2013-04-26]
robot_final/92290A113.SLDPRT
5.50 x 5.49 x 11.0 mm
