saltscapstone/capstone/robot_project/UAV Final/1413T160.SLDPRT

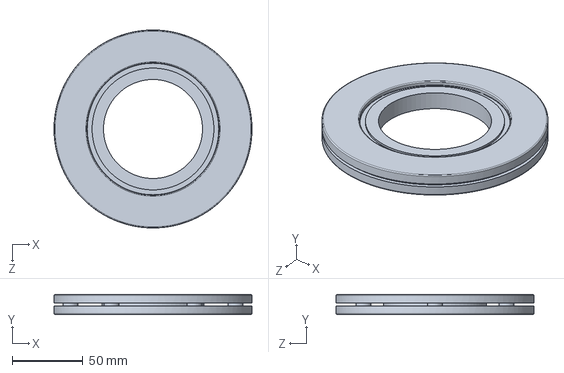
[picture p65: CAD file, 2013-04-26]
robot_project/UAV Final/1413T160.SLDPRT
139.7 x 14.3 x 139.7 mm
