saltscapstone/capstone/robot_final/93783A032.SLDPRT

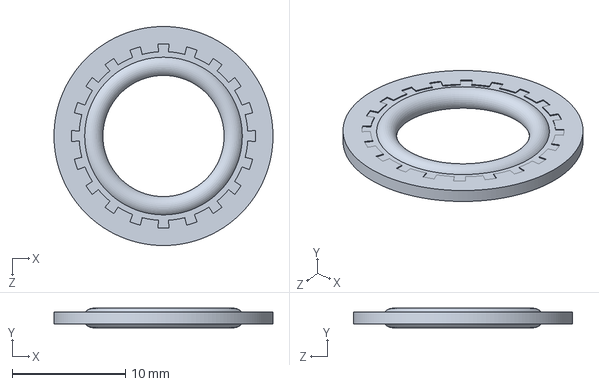
[picture p66: CAD file, 2013-04-26]
robot_final/93783A032.SLDPRT
19.3 x 1.72 x 19.3 mm
