saltscapstone/capstone/robot_final/92185A541.SLDPRT

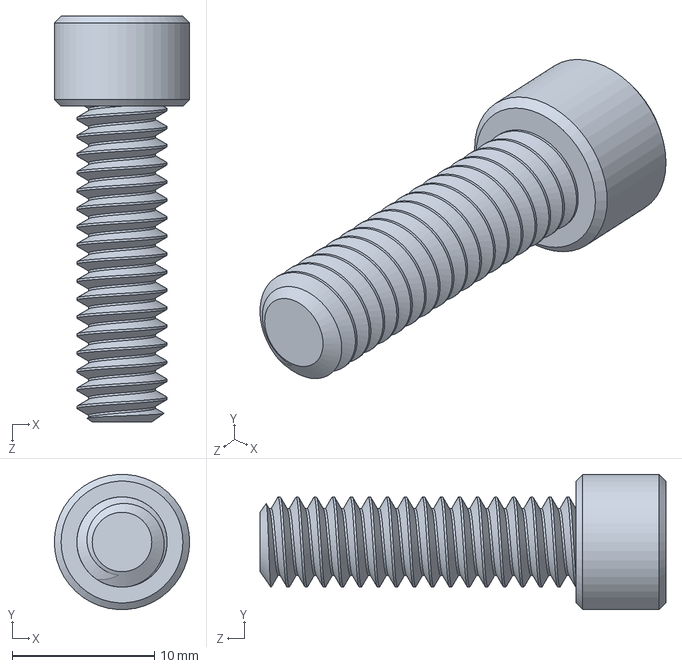
[picture p67: CAD file, 2013-04-26]
robot_final/92185A541.SLDPRT
9.53 x 9.50 x 28.6 mm
