saltscapstone/capstone/robot_project/UAV Final/4452K544.SLDPRT

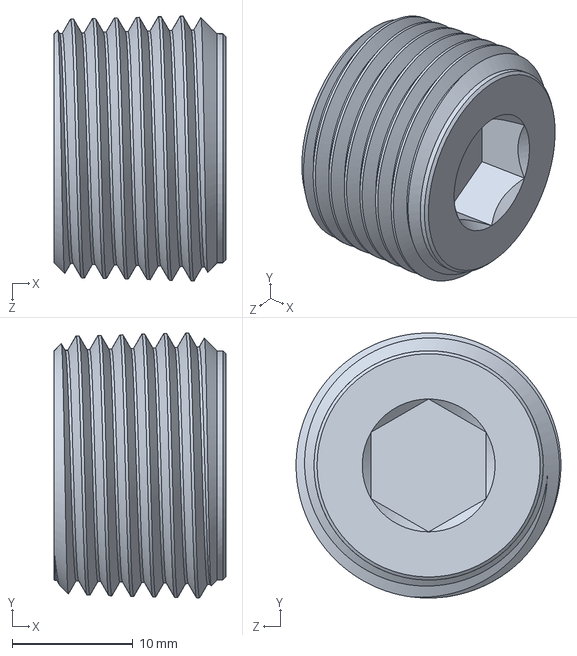
[picture p68: CAD file, 2013-04-26]
robot_project/UAV Final/4452K544.SLDPRT
14.2 x 21.9 x 21.9 mm
