saltscapstone/capstone/robot_final/92196A537.SLDPRT

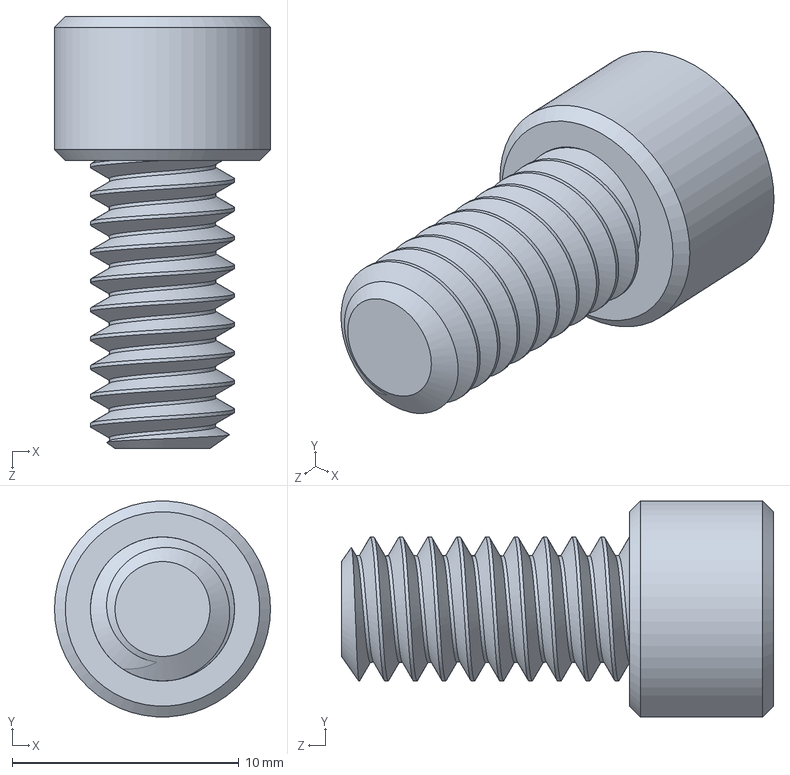
[picture p69: CAD file, 2013-04-26]
robot_final/92196A537.SLDPRT
9.53 x 9.51 x 19.1 mm
