saltscapstone/capstone/robot_project/UAV Final/6031K200.SLDPRT

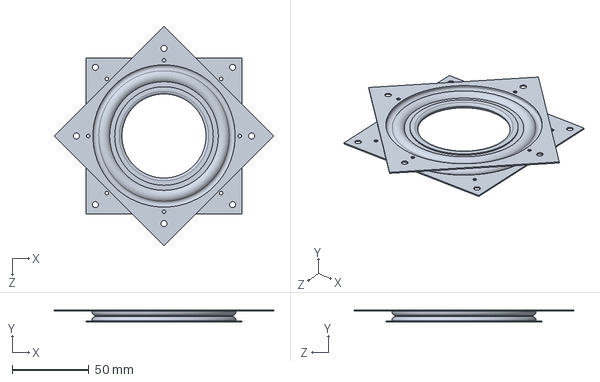
[picture p70: CAD file, 2013-04-26]
robot_project/UAV Final/6031K200.SLDPRT
143.7 x 8.13 x 143.7 mm
