saltscapstone/capstone/robot_final/92196A665.SLDPRT

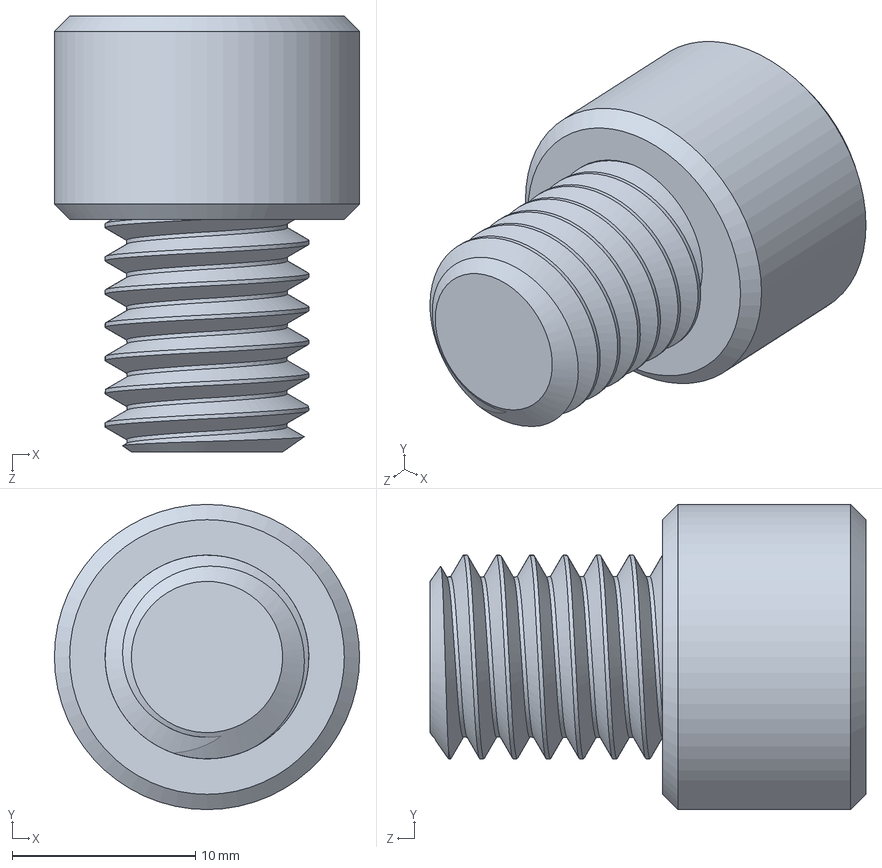
[picture p71: CAD file, 2013-04-26]
robot_final/92196A665.SLDPRT
16.7 x 16.7 x 23.8 mm
