saltscapstone/capstone/robot_project/UAV Final/90257A029.SLDPRT

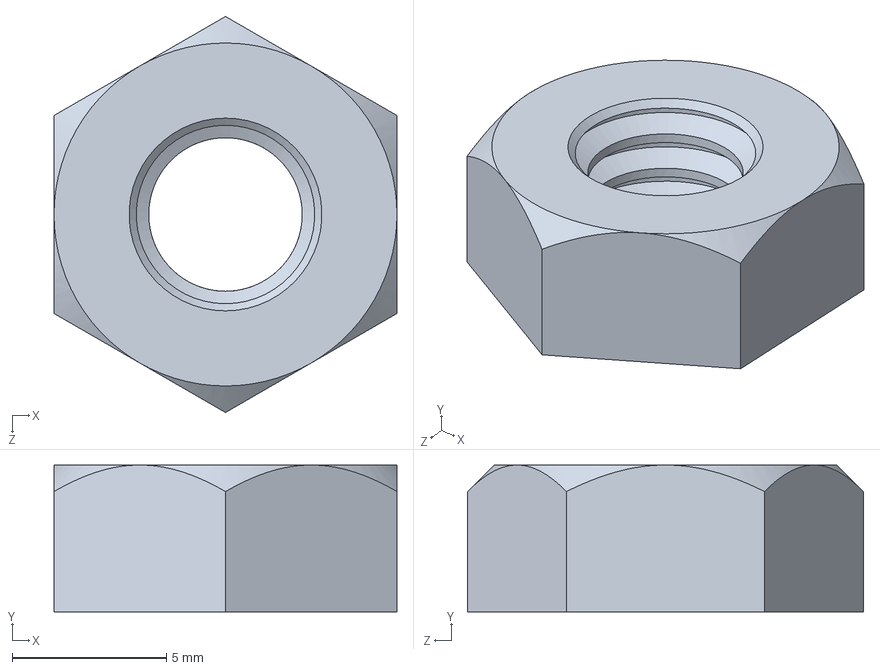
[picture p72: CAD file, 2013-04-26]
robot_project/UAV Final/90257A029.SLDPRT
11.1 x 4.76 x 12.8 mm
