saltscapstone/capstone/robot_final/92196A552.SLDPRT

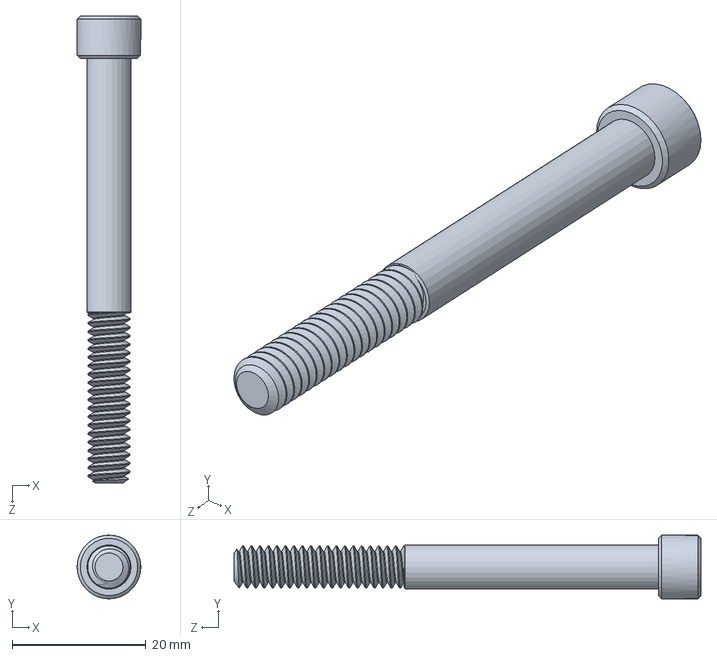
[picture p73: CAD file, 2013-04-26]
robot_final/92196A552.SLDPRT
9.53 x 9.51 x 69.8 mm
