saltscapstone/capstone/robot_project/UAV Final/6455K150.SLDPRT

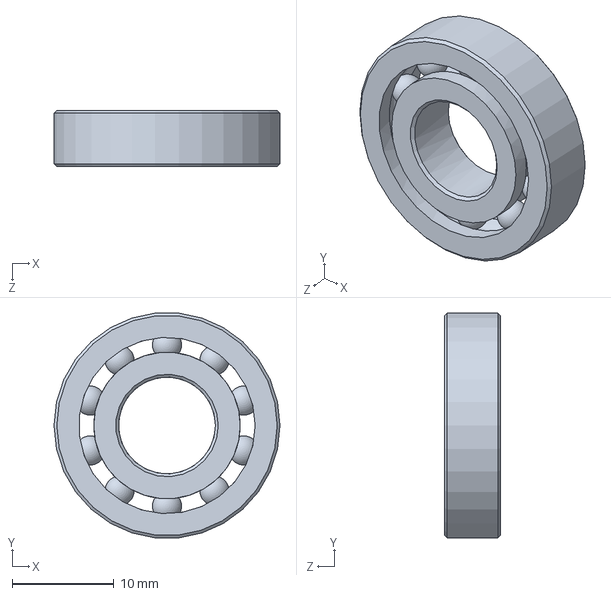
[picture p74: CAD file, 2013-04-26]
robot_project/UAV Final/6455K150.SLDPRT
22.2 x 22.1 x 5.56 mm
