saltscapstone/capstone/robot_final/93783A031.SLDPRT

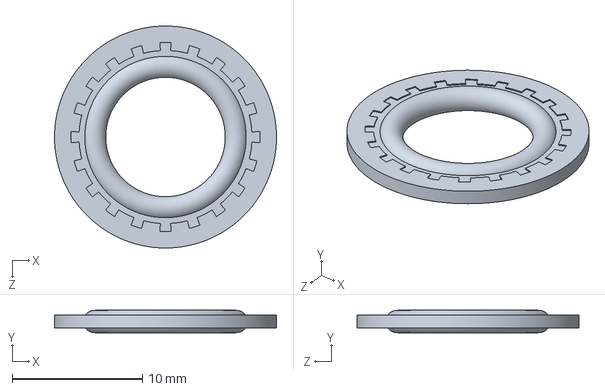
[picture p75: CAD file, 2013-04-26]
robot_final/93783A031.SLDPRT
17.0 x 1.73 x 17.0 mm
