saltscapstone/capstone/robot_final/91292A025.SLDPRT

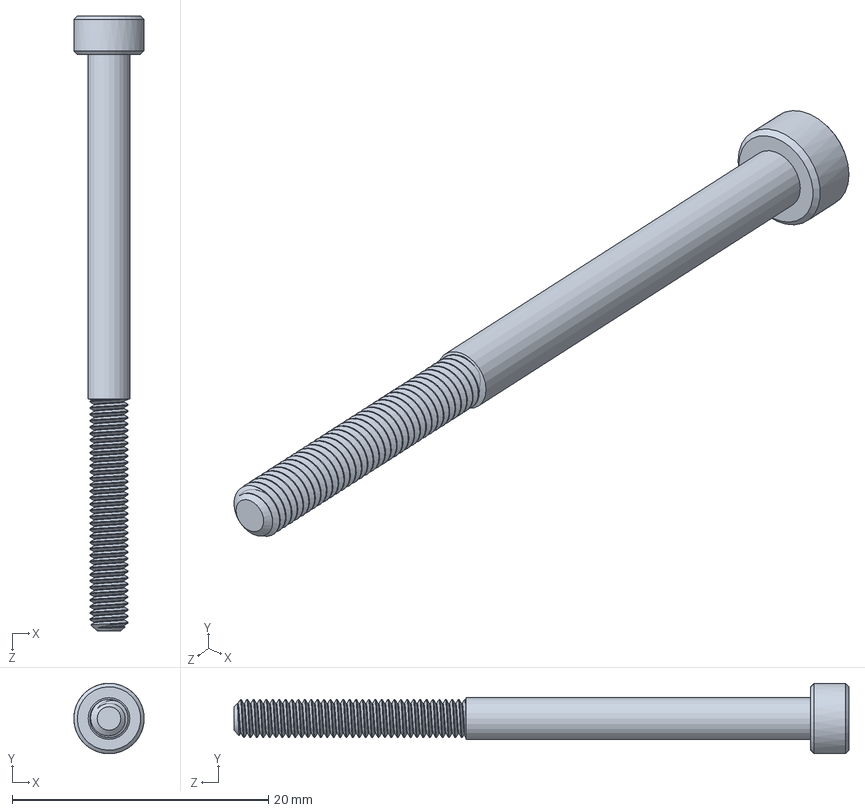
[picture p76: CAD file, 2013-04-26]
robot_final/91292A025.SLDPRT
5.50 x 5.49 x 48.0 mm
