saltscapstone/capstone/(list of files, cad)

Other CAD files:
robot_final/1010-1-5.ipt
robot_final/1010-10.ipt
robot_final/1010-11.75.ipt
robot_final/1010-12.ipt
robot_final/1010-13.75.ipt
robot_final/1010-14.ipt
robot_final/1010-15.ipt
robot_final/1010-18.ipt
robot_final/1010-2-188-M.ipt
robot_final/1010-2-188.ipt
robot_final/1010-2-5.ipt
robot_final/1010-3.ipt
robot_final/1010-4-2.ipt
robot_final/1010-6.ipt
robot_final/1010-8020-12.ipt
robot_final/1010-9-753.ipt
robot_final/1010-M-11-96.ipt
robot_final/1010-M-15.ipt
robot_final/1010-M-7-5.ipt
robot_final/1010-M-9-96.ipt
robot_final/12V 35Ah SLAB.ipt
robot_final/1413T160-TURNTABLE.ipt
robot_final/3IN-PVC-CAP.ipt
robot_final/40MM PROPELLER.ipt
robot_final/4452K544-1-2-NPT PLUG.ipt
robot_final/4464K236-1-NPT PLUG.ipt
robot_final/451-O-Ring-Stretched.ipt
robot_final/4IN-PVC ELBOW-SCH80.ipt
robot_final/6031K200-TURNABLE.ipt
robot_final/6455K150-BALL BEARING.ipt
robot_final/6455K150-BALL BERRING.ipt
robot_final/8020-14103-CORNER BRACKET.ipt
robot_final/8020-14103.ipt
robot_final/8020-4107.PRT
robot_final/8020-4107.ipt
robot_final/8020-4132.PRT
robot_final/8020-4132.ipt
robot_final/8020-4136.PRT
robot_final/8020-4136.ipt
robot_final/8020-4152.PRT
robot_final/8020-4152.ipt
robot_final/8020-4176.PRT
robot_final/8020-4176.ipt
robot_final/8IN-12-SCH80PVC.ipt
robot_final/8IN-CAP-SCH80-PVC.ipt
robot_final/8INx18-SCH80-PVC.ipt
robot_final/90145A540-1-4-DOWEL PIN.ipt
robot_final/90145A542-1-4x1-DOWEL PIN.ipt
robot_final/90257A029-1-4-NUT.ipt
robot_final/91292A025-M3-45-SHCS.ipt
robot_final/91831A029-1-4-LOCK NUT.ipt
robot_final/91831A029.SLDPRT
robot_final/92185A541-1-4-7-8-SHCS.ipt
robot_final/92196A160-6-32-SHCS.ipt
robot_final/92196A537-1-4-1-2.ipt
robot_final/92196A552-1-4-20x2-1-2.ipt
robot_final/92196A621-3-8-5-8-SHCS.ipt
robot_final/92196A621.SLDPRT
robot_final/92196A665-7-16-1-2-SHCS.ipt
robot_final/92290A113-M3-8.ipt
robot_final/92313A143-6-32--1-8-SET SCREW.ipt
robot_final/92313A143.SLDPRT
robot_final/9309K12-BUMPER.ipt
robot_final/93783A007-Sealing Washer No 6.ipt
robot_final/93783A007.SLDPRT
robot_final/93783A031-3-8-SEALING WASHER.ipt
robot_final/93783A032-7-16-SEALING WASHER.ipt
robot_final/93852A102-1-4-WASHER.ipt
robot_final/93852A102.SLDPRT
robot_final/97022A243-SHIMS.ipt
robot_final/97345A624-SHOULDER-BOLT.ipt
robot_final/97345A624.SLDPRT
robot_final/97395A494-1-4 Dowel Pin-316SS.ipt
robot_final/97395A494.SLDPRT
robot_final/9964K110-SHAFT COLLAR.ipt
robot_final/9964K110.SLDPRT
robot_final/C-101.ipt
robot_final/C-102.ipt
robot_final/C-103.ipt
robot_final/C-104.ipt
robot_final/Camera.iam
robot_final/CompleteAssy.iam
robot_final/Drawings/Inconsistant Drawings/1010-A.idw
robot_final/Drawings/Inconsistant Drawings/C-102-0.idw
robot_final/Drawings/Inconsistant Drawings/C-103-0.idw
robot_final/Drawings/Inconsistant Drawings/C-104-0.idw
robot_final/Drawings/Inconsistant Drawings/E-104.idw
robot_final/Drawings/OldVersions/1010-15-0-M.0001.idw
robot_final/Drawings/OldVersions/1010-2-5-M.0001.idw
robot_final/Drawings/OldVersions/1010-4-2-M.0001.idw
robot_final/Drawings/OldVersions/1010.0001.idw
robot_final/Drawings/OldVersions/C-102-0.0005.idw
robot_final/Drawings/OldVersions/C-102.0002.idw
robot_final/Drawings/OldVersions/C-103-0.0004.idw
robot_final/Drawings/OldVersions/C-103.0003.idw
robot_final/Drawings/OldVersions/C-104.0003.idw
robot_final/Drawings/OldVersions/E-102.0005.idw
robot_final/Drawings/OldVersions/E-104-105.0003.idw
robot_final/Drawings/OldVersions/E-104.0002.idw
robot_final/Drawings/OldVersions/E-106.0001.idw
robot_final/Drawings/OldVersions/F-101.0003.idw
robot_final/Drawings/OldVersions/F-102.0001.idw
robot_final/Drawings/OldVersions/F-103.0002.idw
robot_final/Drawings/OldVersions/F-104.0001.idw
robot_final/Drawings/OldVersions/F-104.0002.idw
robot_final/Drawings/OldVersions/G-101.0003.idw
robot_final/Drawings/OldVersions/G-102.0001.idw
robot_final/Drawings/OldVersions/G-103.0002.idw
robot_final/Drawings/OldVersions/MA-101.0004.idw
robot_final/Drawings/OldVersions/MA-102.0002.idw
robot_final/Drawings/OldVersions/MA-103.0003.idw
robot_final/Drawings/OldVersions/MA-104.0001.idw
robot_final/Drawings/OldVersions/MA-104.0003.idw
robot_final/Drawings/OldVersions/PV-101.0002.idw
robot_final/Drawings/OldVersions/PV-102.0002.idw
robot_final/Drawings/OldVersions/SC-101.0003.idw
robot_final/Drawings/OldVersions/SC-102.0003.idw
robot_final/Drawings/OldVersions/SC-103.0003.idw
robot_final/Drawings/RenumberedDrawings/1.idw
robot_final/Drawings/RenumberedDrawings/10.idw
robot_final/Drawings/RenumberedDrawings/11.idw
robot_final/Drawings/RenumberedDrawings/12.idw
robot_final/Drawings/RenumberedDrawings/13.idw
robot_final/Drawings/RenumberedDrawings/14.idw
robot_final/Drawings/RenumberedDrawings/15.idw
robot_final/Drawings/RenumberedDrawings/16.idw
robot_final/Drawings/RenumberedDrawings/17.idw
robot_final/Drawings/RenumberedDrawings/18.idw
robot_final/Drawings/RenumberedDrawings/19.idw
robot_final/Drawings/RenumberedDrawings/2.idw
robot_final/Drawings/RenumberedDrawings/20.idw
robot_final/Drawings/RenumberedDrawings/21.idw
robot_final/Drawings/RenumberedDrawings/22-23.idw
robot_final/Drawings/RenumberedDrawings/24.idw
robot_final/Drawings/RenumberedDrawings/25.idw
robot_final/Drawings/RenumberedDrawings/26.idw
robot_final/Drawings/RenumberedDrawings/27-32.idw
robot_final/Drawings/RenumberedDrawings/3.idw
robot_final/Drawings/RenumberedDrawings/33.idw
robot_final/Drawings/RenumberedDrawings/34.idw
robot_final/Drawings/RenumberedDrawings/35.idw
robot_final/Drawings/RenumberedDrawings/36.idw
robot_final/Drawings/RenumberedDrawings/4.idw
robot_final/Drawings/RenumberedDrawings/5-REDIM.idw
robot_final/Drawings/RenumberedDrawings/5.idw
robot_final/Drawings/RenumberedDrawings/6-7-REDIM.idw
robot_final/Drawings/RenumberedDrawings/6-7.idw
robot_final/Drawings/RenumberedDrawings/8.idw
robot_final/Drawings/RenumberedDrawings/9.idw
robot_final/Drawings/RenumberedDrawings/OldVersions/10.0002.idw
robot_final/Drawings/RenumberedDrawings/OldVersions/101.0003.idw
robot_final/Drawings/RenumberedDrawings/OldVersions/1010.0002.idw
robot_final/Drawings/RenumberedDrawings/OldVersions/11.0003.idw
robot_final/Drawings/RenumberedDrawings/OldVersions/12.0004.idw
robot_final/Drawings/RenumberedDrawings/OldVersions/13.0001.idw
robot_final/Drawings/RenumberedDrawings/OldVersions/14.0005.idw
robot_final/Drawings/RenumberedDrawings/OldVersions/15.0002.idw
robot_final/Drawings/RenumberedDrawings/OldVersions/16.0003.idw
robot_final/Drawings/RenumberedDrawings/OldVersions/17.0005.idw
robot_final/Drawings/RenumberedDrawings/OldVersions/18.0004.idw
robot_final/Drawings/RenumberedDrawings/OldVersions/19.0004.idw
robot_final/Drawings/RenumberedDrawings/OldVersions/2.0004.idw
robot_final/Drawings/RenumberedDrawings/OldVersions/20.0004.idw
robot_final/Drawings/RenumberedDrawings/OldVersions/21.0003.idw
robot_final/Drawings/RenumberedDrawings/OldVersions/22-23.0003.idw
robot_final/Drawings/RenumberedDrawings/OldVersions/24.0004.idw
robot_final/Drawings/RenumberedDrawings/OldVersions/25.0004.idw
robot_final/Drawings/RenumberedDrawings/OldVersions/26.0005.idw
robot_final/Drawings/RenumberedDrawings/OldVersions/3.0004.idw
robot_final/Drawings/RenumberedDrawings/OldVersions/33.0002.idw
robot_final/Drawings/RenumberedDrawings/OldVersions/34.0002.idw
robot_final/Drawings/RenumberedDrawings/OldVersions/35.0001.idw
robot_final/Drawings/RenumberedDrawings/OldVersions/36.0002.idw
robot_final/Drawings/RenumberedDrawings/OldVersions/4.0001.idw
robot_final/Drawings/RenumberedDrawings/OldVersions/5.0008.idw
robot_final/Drawings/RenumberedDrawings/OldVersions/6-7.0004.idw
robot_final/Drawings/RenumberedDrawings/OldVersions/8.0002.idw
robot_final/Drawings/RenumberedDrawings/OldVersions/9.0004.idw
robot_final/E-101-1.ipt
robot_final/E-102-1.ipt
robot_final/E-103-1.ipt
robot_final/E-104-1.ipt
robot_final/E-105-1.ipt
robot_final/E-106-1.ipt
robot_final/E-VolumeForElectronics.ipt
robot_final/Electrical.iam
robot_final/F-101-0.ipt
robot_final/F-102-0.ipt
robot_final/F-103-0.ipt
robot_final/F-104-0.ipt
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
