saltscapstone/capstone/lab/Transducer Characterizations.xlsx

Sheet: L-Tx_B-Rx_1ft
Freq (kHz) | Vp-p(Tx) | Vp-p(Rx) | Loss (dB) | Vp-p(Tx) | Vp-p(Rx) | Loss (dB) | Vp-p(Tx) | Vp-p(Rx) | Loss (dB)
45 | 1 | 0.156 | -16.13750803 | 0.1 | 0.02 | -13.97940009 | 10 | 1.58 | -16.02685826
45.5 | 1 | 0.128 | -17.85580061 | 0.1 | 0.019 | -14.42492798 | 10 | 1.3 | -17.72113295
46 | 1 | 0.128 | -17.85580061 | 0.1 | 0.022 | -13.15154638 | 10 | 1.26 | -17.9925891
46.5 | 1 | 0.184 | -14.70364354 | 0.1 | 0.019 | -14.42492798 | 10 | 1.86 | -14.60974112
47 | 1 | 0.156 | -16.13750803 | 0.1 | 0.019 | -14.42492798 | 10 | 1.58 | -16.02685826
47.5 | 1 | 0.164 | -15.70312304 | 0.1 | 0.02 | -13.97940009 | 10 | 1.66 | -15.59783824
48 | 1 | 0.144 | -16.83275016 | 0.1 | 0.02 | -13.97940009 | 10 | 1.44 | -16.83275016
48.5 | 1 | 0.208 | -13.6387333 | 0.1 | 0.026 | -11.70053304 | 10 | 2.08 | -13.6387333
49 | 1 | 0.121 | -18.34429259 | 0.1 | 0.02 | -13.97940009 | 10 | 1.26 | -17.9925891
49.5 | 1 | 0.168 | -15.49381437 | 0.1 | 0.021 | -13.55561411 | 10 | 1.7 | -15.39102157
50 | 1 | 0.192 | -14.33397543 | 0.1 | 0.026 | -11.70053304 | 10 | 1.92 | -14.33397543
50.5 | 1 | 0.188 | -14.51684301 | 0.1 | 0.024 | -12.39577517 | 10 | 1.84 | -14.70364354
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
