saltscapstone/capstone/power/webench_project_3520048_6_294604728.pdf

# WEBENCH® Power Architect

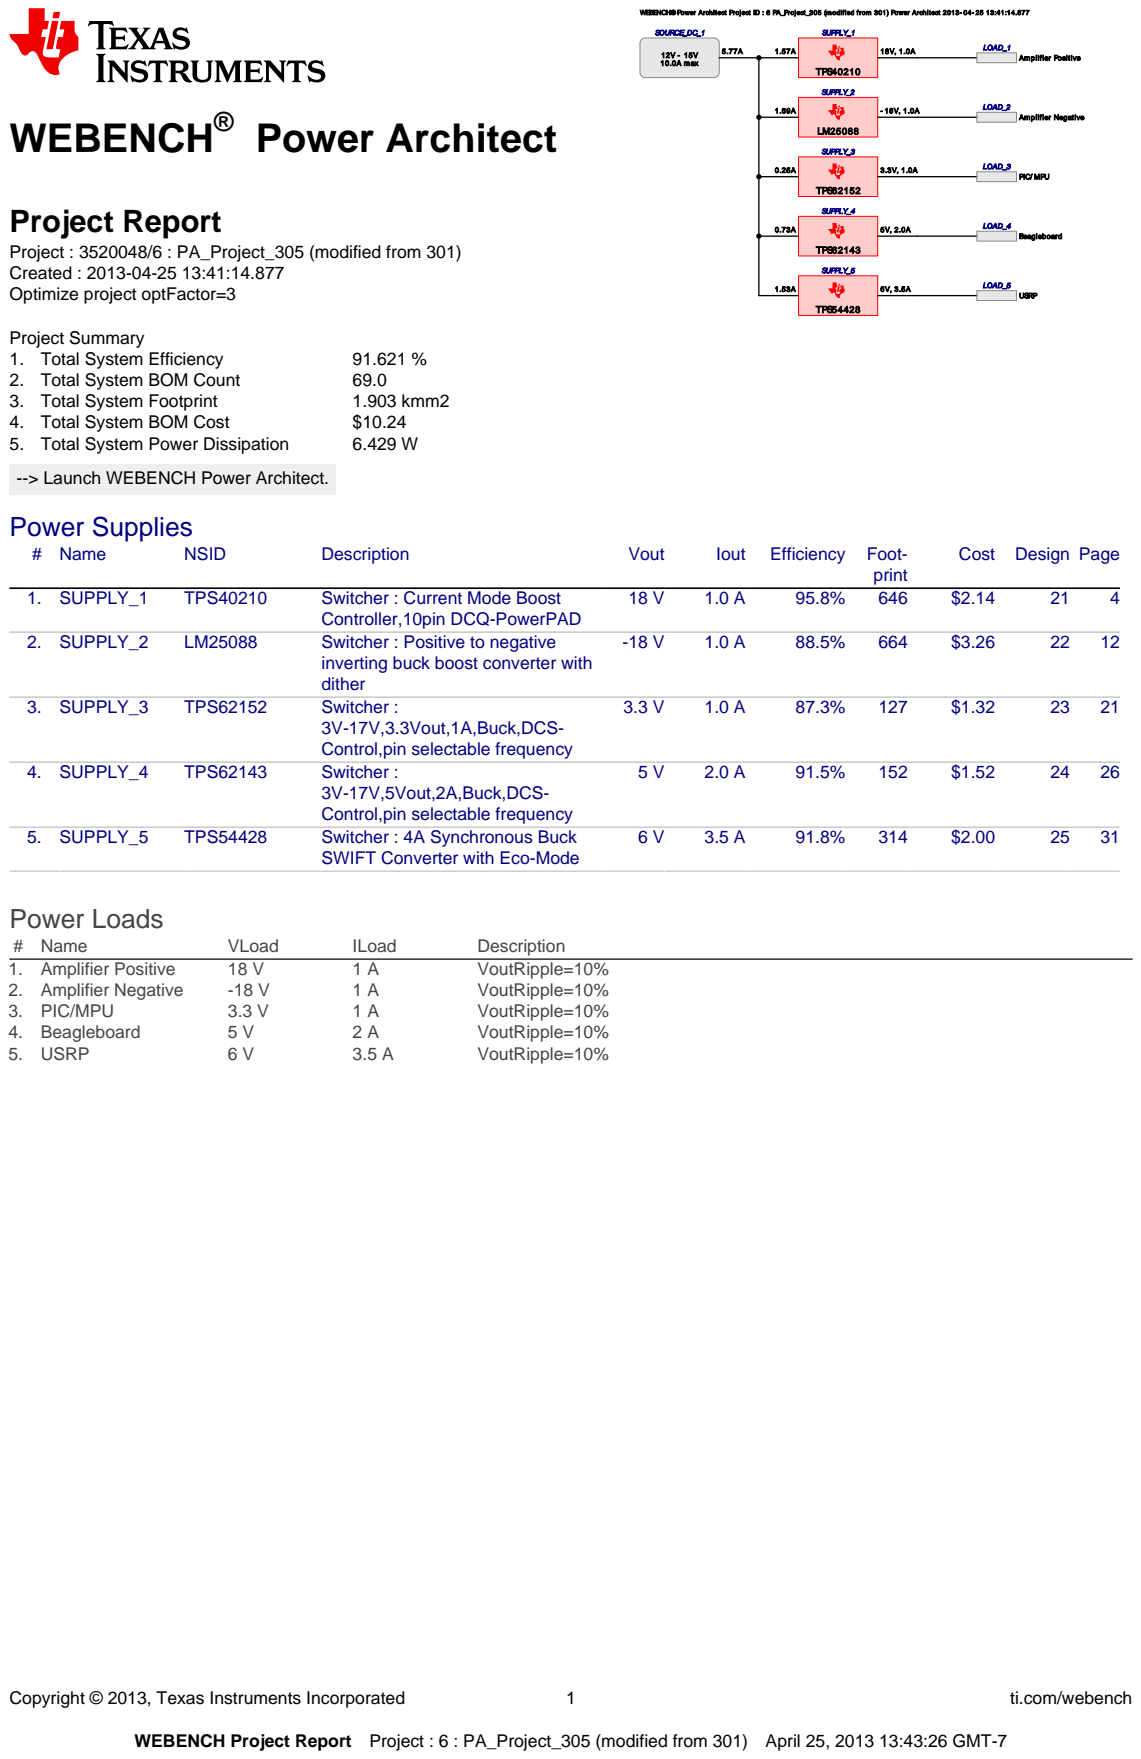
[picture p77: page 1]
Copyright © 2013, Texas Instruments Incorporated; ti.com/webench; 1. Total System Efficiency; 2. Total System BOM Count; 3. Total System Footprint; 1.903 kmm2; 4. Total System BOM Cost; 5. Total System Power Dissipation; LOAD_1; Amplifier Positive; TPS40210; SUPPLY_1; LOAD_2; Amplifier Negative; SUPPLY_2; LOAD_3; PIC/ MPU; TPS62152; SUPPLY_3; LOAD_4; Beagleboard; TPS62143; SUPPLY_4; LOAD_5; USRP; TPS54428; SUPPLY_5; 12V - 15V 10.0A max; SOURCE_DC_1; # Name; NSID; Description; Vout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

WEBENCH® Power Architect Project ID : 6 PA_Project_305 (modified from 301) Power Architect 2013- 04- 25 13:41:14.877

Project Report
Project : 3520048/6 : PA_Project_305 (modified from 301)
Created : 2013-04-25 13:41:14.877
Optimize project optFactor=3

Project Summary
--> Launch WEBENCH Power Architect. (http://webench.ti.com/webench5/power/webench5.cgi?app=powerarchitect&project_id=6)
Power Supplies

Cost Design Page

Controller,10pin DCQ-PowerPAD

inverting buck boost converter with
dither

3V-17V,3.3Vout,1A,Buck,DCS-
Control,pin selectable frequency

3V-17V,5Vout,2A,Buck,DCS-

SWIFT Converter with Eco-Mode

WEBENCH Project Report Project : 6 : PA_Project_305 (modified from 301) April 25, 2013 13:43:26 GMT-7

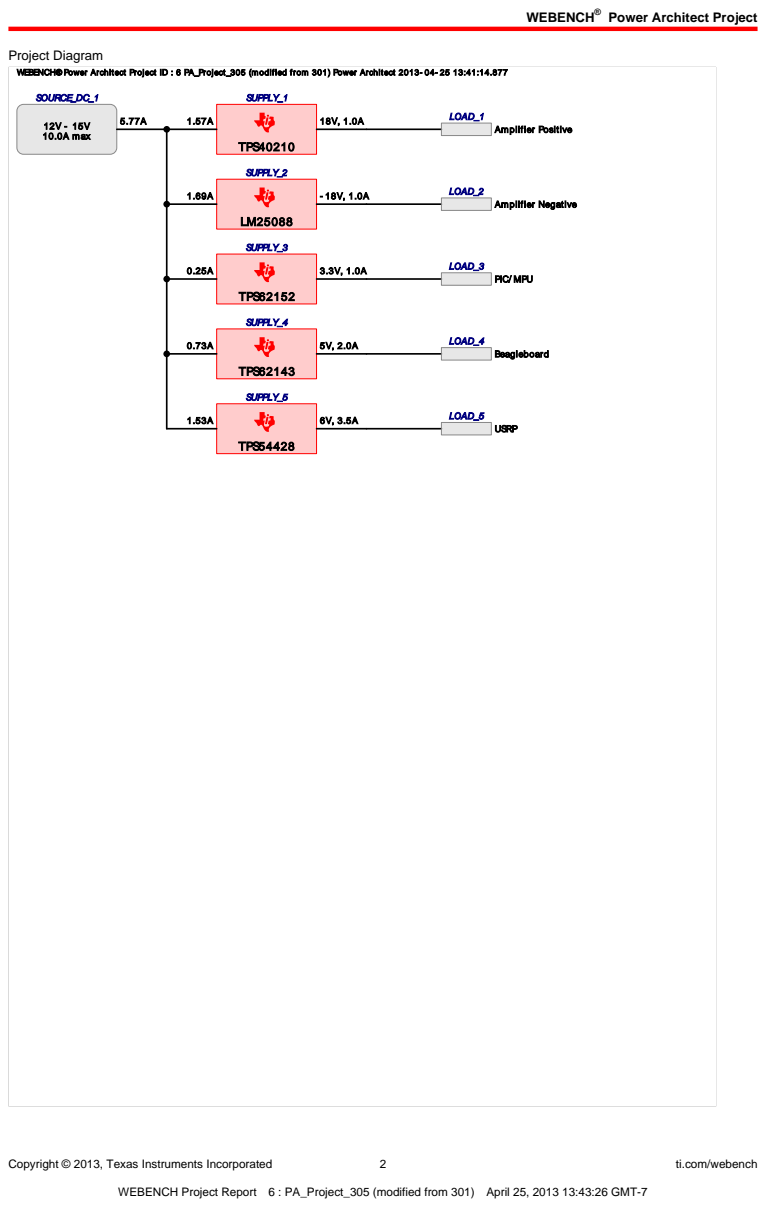
[picture p78: page 2]
WEBENCH®; Copyright © 2013, Texas Instruments Incorporated; ti.com/webench; Project Diagram; LOAD_1; Amplifier Positive; TPS40210; SUPPLY_1; LOAD_2; Amplifier Negative; SUPPLY_2; LOAD_3; PIC/ MPU; TPS62152; SUPPLY_3; LOAD_4; Beagleboard; TPS62143; SUPPLY_4; LOAD_5; USRP; TPS54428; SUPPLY_5; 12V - 15V 10.0A max; SOURCE_DC_1

Power Architect Project

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

WEBENCH Project Report 6 : PA_Project_305 (modified from 301) April 25, 2013 13:43:26 GMT-7

Copyright © 2013, Texas Instruments Incorporated | 3 | ti.com/webench

### Electrical Procurement BOM

Manufacturer | Part Number | Description | Quantity Budgetary Price | Footprint
(mm²
)
AVX | 08053C104KAT2A | 0805 | 2 | $0.01 | 26
AOS | AON7246 | TRANS_AOS_DFN3X3 | 1 | $0.26 | 25
Diodes Inc. | B340A-13-F | SMA | 1 | $0.11 | 37
Kemet | C0603C104K3RACTU | 0603 | 1 | $0.01 | 10
Kemet | C0805C332K5RACTU | 0805 | 2 | $0.01 | 26
Kemet | C1206C105K3RACTU | 1206 | 1 | $0.04 | 19
TDK | C1608X5R1C105K | 0603 | 2 | $0.01 | 20
TDK | C2012X5R0J226M | 0805 | 1 | $0.06 | 13
TDK | C3216X7R1H105K | 1206 | 1 | $0.04 | 19
TDK | C5750X7R1E226M | 2220 | 1 | $0.84 | 60
Yageo America | CC0805DRNP09BN7R0 | 0805 | 1 | $0.01 | 13
Yageo America | CC0805DRNP09BN9R0 | 0805 | 1 | $0.01 | 13
Yageo America | CC0805JRNP09BN101 | 0805 | 1 | $0.01 | 13
Yageo America | CC0805JRNP09BN151 | 0805 | 1 | $0.01 | 13
Yageo America | CC0805KRX7R9BB152 | 0805 | 1 | $0.01 | 13
Yageo America | CC0805KRX7R9BB821 | 0805 | 1 | $0.01 | 13
Vishay-Dale | CRCW0402100KFKED | 0402 | 2 | $0.01 | 15
Vishay-Dale | CRCW040210K0FKED | 0402 | 2 | $0.01 | 15
Vishay-Dale | CRCW040210K2FKED | 0402 | 1 | $0.01 | 8
Vishay-Dale | CRCW0402154KFKED | 0402 | 1 | $0.01 | 8
Vishay-Dale | CRCW0402187KFKED | 0402 | 1 | $0.01 | 8
Vishay-Dale | CRCW04021K00FKED | 0402 | 1 | $0.01 | 8
Vishay-Dale | CRCW04021K43FKED | 0402 | 1 | $0.01 | 8
Vishay-Dale | CRCW04021K65FKED | 0402 | 1 | $0.01 | 8
Vishay-Dale | CRCW040222K1FKED | 0402 | 1 | $0.01 | 8
Vishay-Dale | CRCW040223K2FKED | 0402 | 2 | $0.01 | 15
Vishay-Dale | CRCW04022K05FKED | 0402 | 1 | $0.01 | 8
Vishay-Dale | CRCW040251K1FKED | 0402 | 1 | $0.01 | 8
Vishay-Dale | CRCW040251R1FKED | 0402 | 1 | $0.01 | 8
Vishay-Dale | CRCW0402649KFKED | 0402 | 1 | $0.01 | 8
Texas Instruments | CSD17313Q2 | TRANS_NexFET_Q2 | 1 | $0.17 | 16
Stackpole Electronics Inc | CSR1206FK20L0 | 1206 | 1 | $0.10 | 19
Panasonic | EEE-FK1V331P | SM_RADIAL_G | 1 | $0.28 | 172
Panasonic | ERJ-L14KF39MU | 1210 | 1 | $0.11 | 23
Taiyo Yuden | GMK212B7105KG-T | 0805 | 1 | $0.05 | 13
MuRata | GRM1555C1E301JA01D | 0402 | 1 | $0.01 | 8
MuRata | GRM155C80J334KE01D | 0402 | 1 | $0.01 | 8
MuRata | GRM155R61A105KE15D | 0402 | 1 | $0.01 | 8
MuRata | GRM155R61A154KE19D | 0402 | 1 | $0.01 | 8
MuRata | GRM155R61A274KE15D | 0402 | 1 | $0.02 | 8
MuRata | GRM155R71A104KA01D | 0402 | 1 | $0.01 | 8
MuRata | GRM155R71A393KA01D | 0402 | 1 | $0.01 | 8
MuRata | GRM155R71E822KA01D | 0402 | 1 | $0.01 | 8
MuRata | GRM1885C1H750JA01D | 0603 | 1 | $0.01 | 10
MuRata | GRM21BR61E475MA12L | 0805 | 2 | $0.06 | 13
MuRata | GRM31CR61E106KA12L | 1206 | 2 | $0.07 | 37
MuRata | GRM32ER61C476ME15L | 1210 | 1 | $0.22 | 23
MuRata | GRM32ER61E226KE15L | 1210 | 1 | $0.31 | 23
Texas Instruments | LM25088MH-1/NOPB | MXA16A | 1 | $1.25 | 59
Taiyo Yuden | LMK212BJ226MG-T | 0805 | 1 | $0.12 | 13
Susumu Co Ltd | RR1220P-124-D | 0805 | 1 | $0.01 | 13
Bourns | SDR0403-2R2ML | SDR0403 | 1 | $0.17 | 39
Bourns | SDR1307-120ML | SDR1307 | 1 | $0.34 | 227
TDK | SLF10165T-4R7N4R73PF | SLF10165 | 1 | $0.05 | 146
Bourns | SRN6045-2R2Y | SRN6045 | 1 | $0.16 | 64
Bourns | SRR1260-330M | SRR1260 | 1 | $0.41 | 210
Vishay-Semiconductor | SS36-E3/57T | SMC | 1 | $0.18 | 83
Texas Instruments | TPS40210DGQR | S-PDSO-G10 | 1 | $0.80 | 36
Texas Instruments | TPS54428DDAR | R-PDSO-G8 | 1 | $1.35 | 57
Texas Instruments | TPS62143RGTR | S-PVQFN-N16 | 1 | $1.15 | 36
Texas Instruments | TPS62152RGTR | S-PVQFN-N16 | 1 | $1.00 | 36
Total | | | 69 | $10.25 | 1,891

## WEBENCH ® Design Report

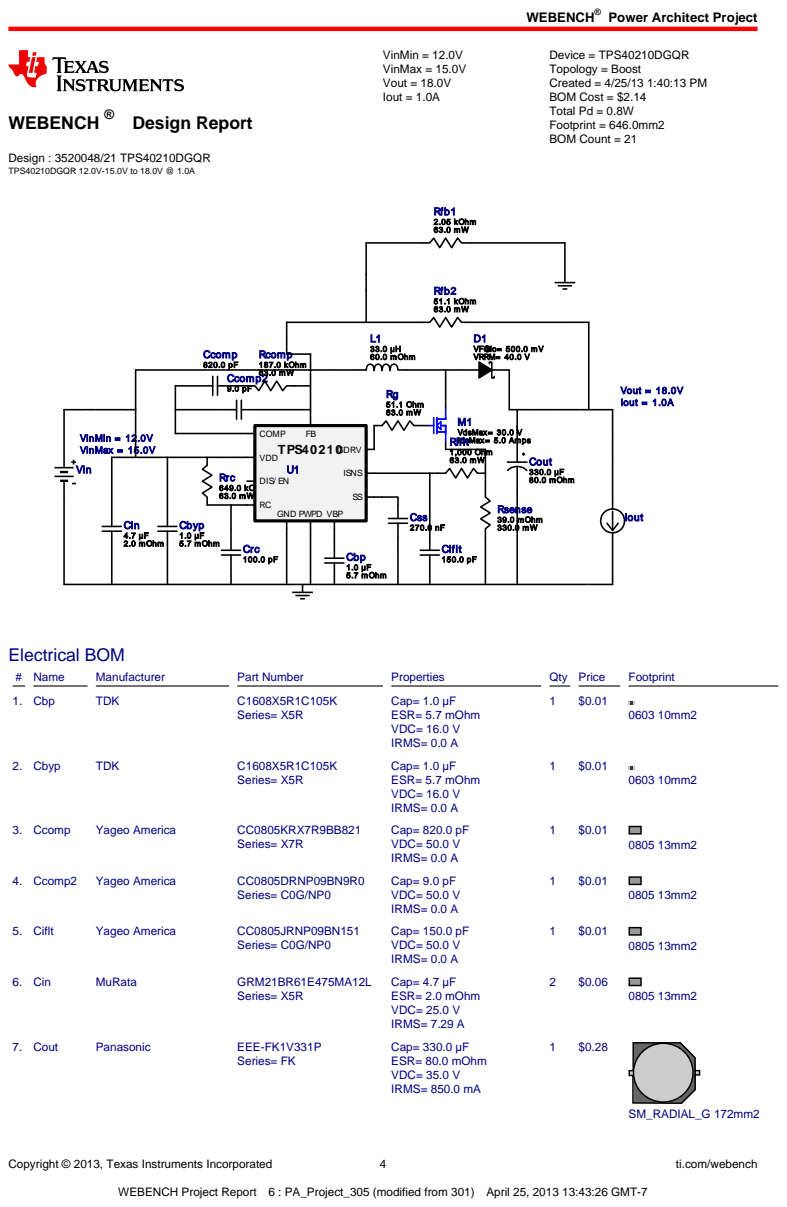
[picture p79: page 4]
Copyright © 2013, Texas Instruments Incorporated; ti.com/webench; Design : 3520048/21 TPS40210DGQR TPS40210DGQR 12.0V-15.0V to 18.0V @ 1.0A; VinMin = 12.0V VinMax = 15.0V Vout = 18.0V Iout = 1.0A; Device = TPS40210DGQR Topology = Boost Created = 4/25/13 1:40:13 PM BOM Cost = $2.14 Total Pd = 0.8W Footprint = 646.0mm2 BOM Count = 21; Cbp 1.0 µF 5.7 mOhm; Cbyp 1.0 µF 5.7 mOhm; Ccomp 820.0 pF Ccomp2 9.0 pF; Ciflt 150.0 pF; Cin 4.7 µF 2.0 mOhm; Cout 330.0 µF 80.0 mOhm; Crc 100.0 pF; Css 270.0 nF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

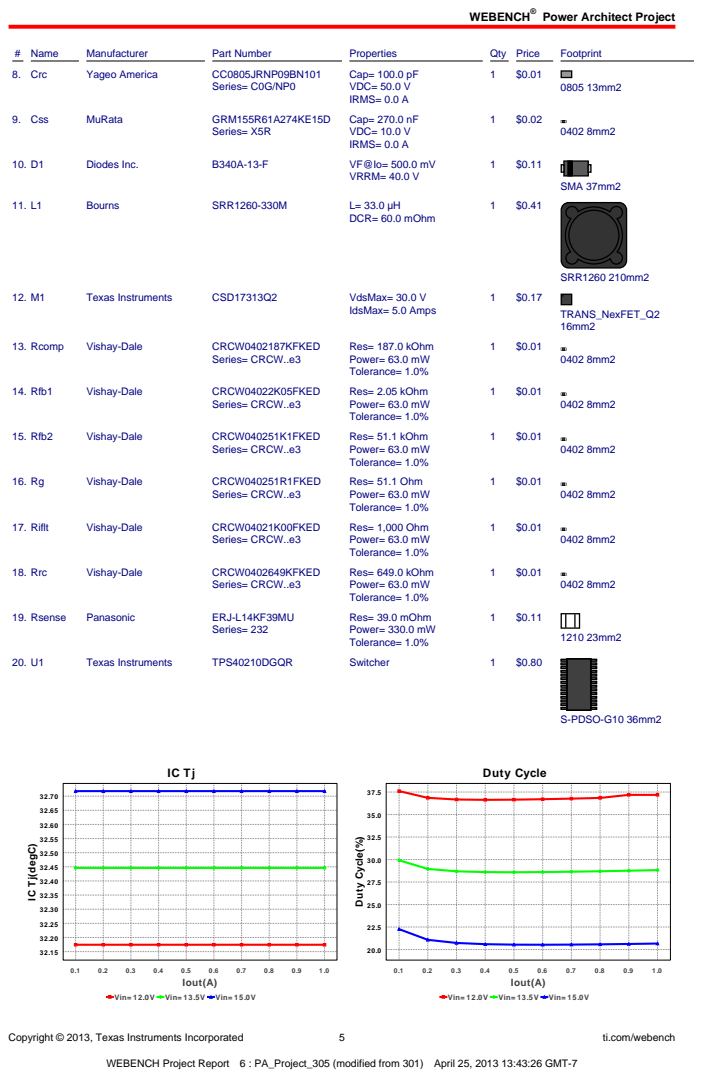
[picture p80: page 5]
Copyright © 2013, Texas Instruments Incorporated; ti.com/webench; # Name; Manufacturer; Part Number; Properties; Qty Price; Footprint; 8. Crc; Yageo America; CC0805JRNP09BN101; Series= C0G/NP0; Cap= 100.0 pF VDC= 50.0 V IRMS= 0.0 A; 9. Css; MuRata; GRM155R61A274KE15D; Series= X5R; Cap= 270.0 nF VDC= 10.0 V IRMS= 0.0 A; Diodes Inc.; VRRM= 40.0 V; SMA 37mm2; Bourns; SRR1260-330M; DCR= 60.0 mOhm; SRR1260 210mm2; Texas Instruments; CSD17313Q2; VdsMax= 30.0 V; IdsMax= 5.0 Amps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

IC Tj(degC)

Vin= 12.0V Vin= 13.5V Vin= 15.0V

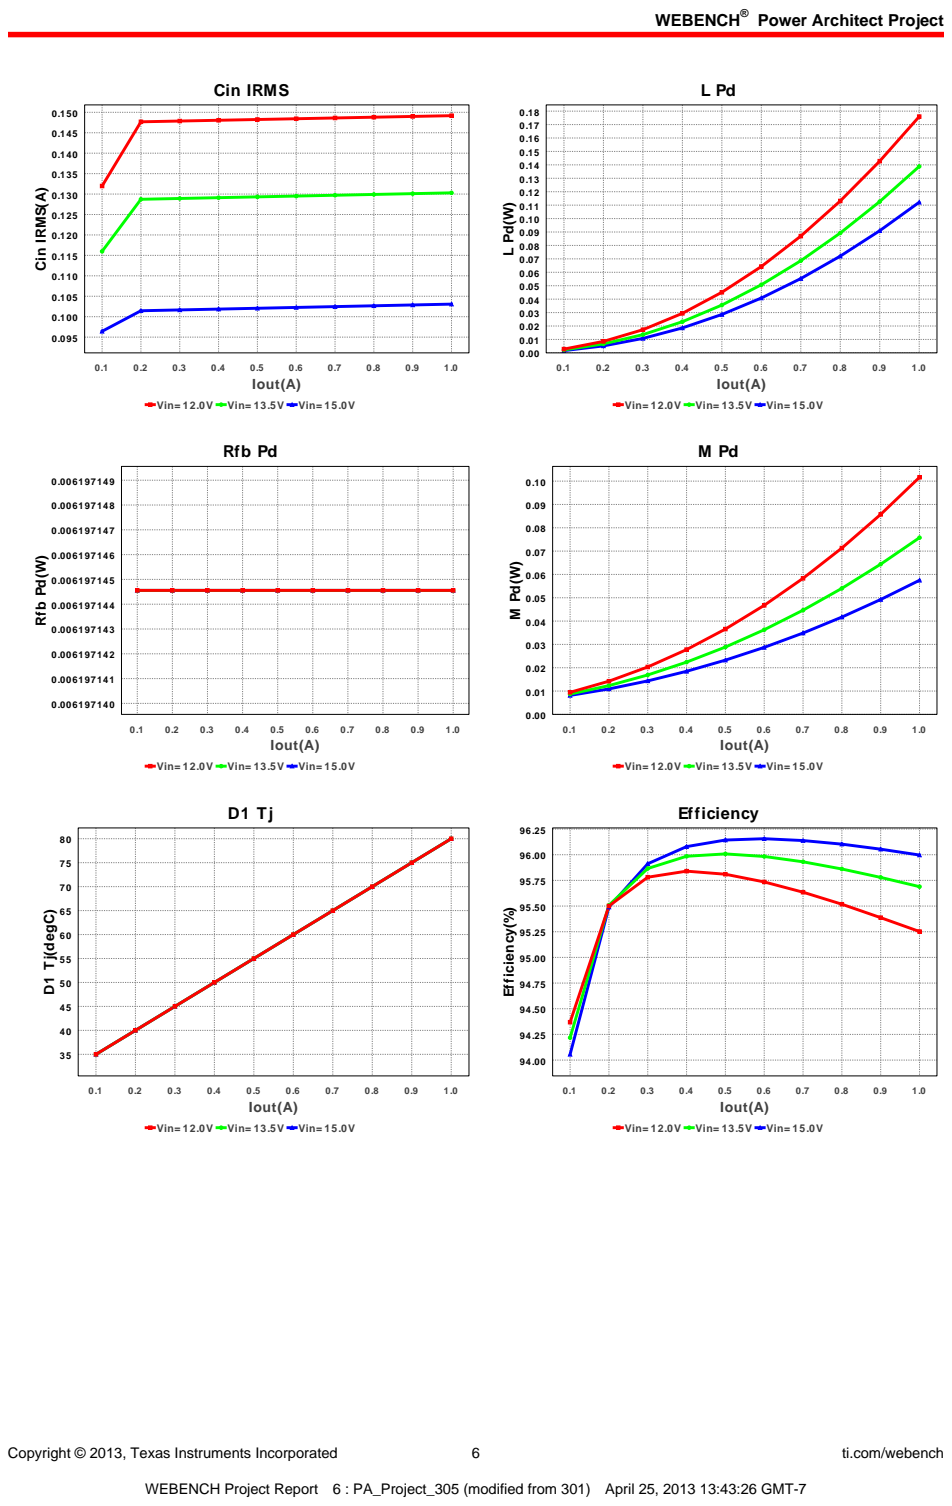
[picture p81: page 6]
Copyright © 2013, Texas Instruments Incorporated; ti.com/webench; Cin IRMS; Iout(A); Cin IRMS(A); Rfb Pd; Rfb Pd(W); D1 Tj(degC); Efficiency; Efficiency(%)

Vin= 12.0V Vin= 13.5V Vin= 15.0V

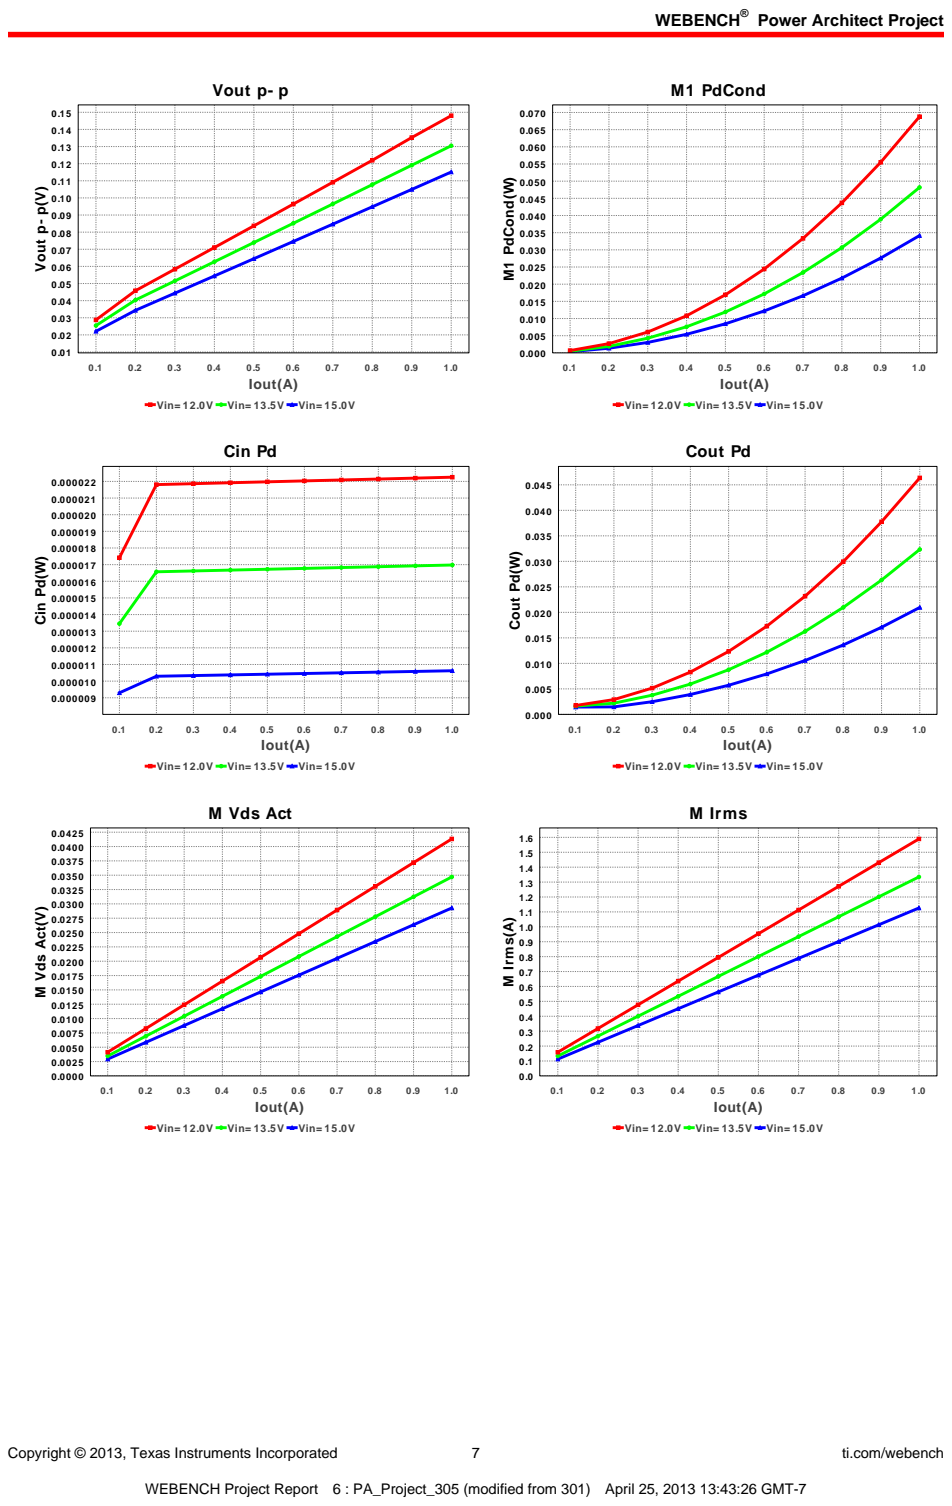
[picture p82: page 7]
Copyright © 2013, Texas Instruments Incorporated; ti.com/webench; Vout p- p; Iout(A); Vout p- p(V); M1 PdCond; M1 PdCond(W); Cin Pd; Cin Pd(W); Cout Pd; Cout Pd(W); M Vds Act; M Vds Act(V); M Irms; M Irms(A)

Vin= 12.0V Vin= 13.5V Vin= 15.0V

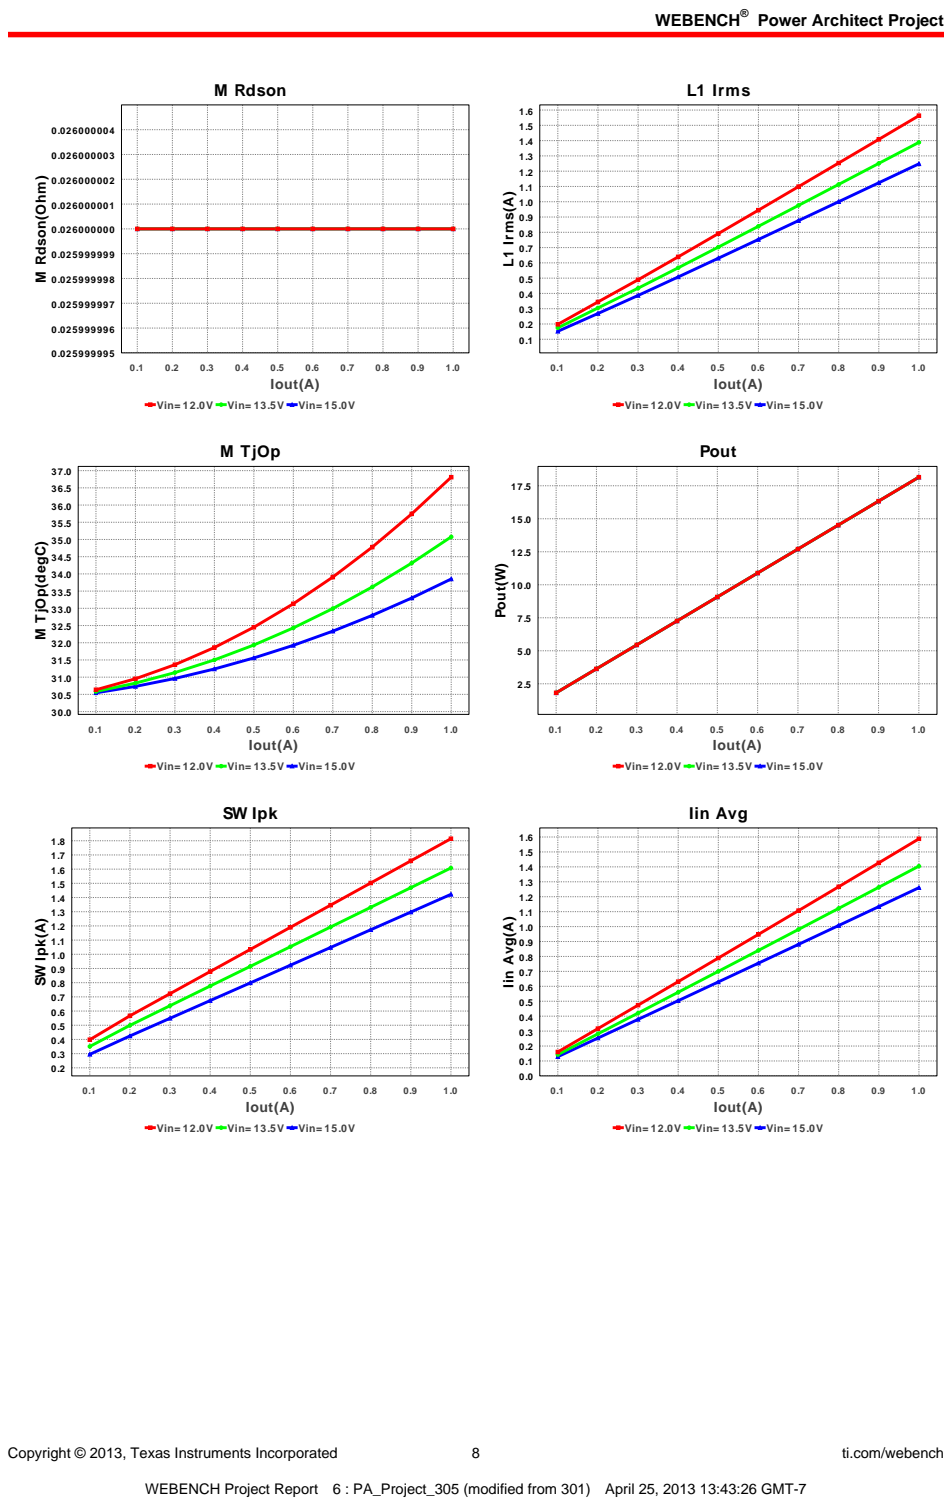
[picture p83: page 8]
Copyright © 2013, Texas Instruments Incorporated; ti.com/webench; M Rdson; Iout(A); M Rdson(Ohm); L1 Irms; L1 Irms(A); M TjOp; M TjOp(degC); Pout; Pout(W); SW Ipk; SW Ipk(A); Iin Avg; Iin Avg(A)

Vin= 12.0V Vin= 13.5V Vin= 15.0V

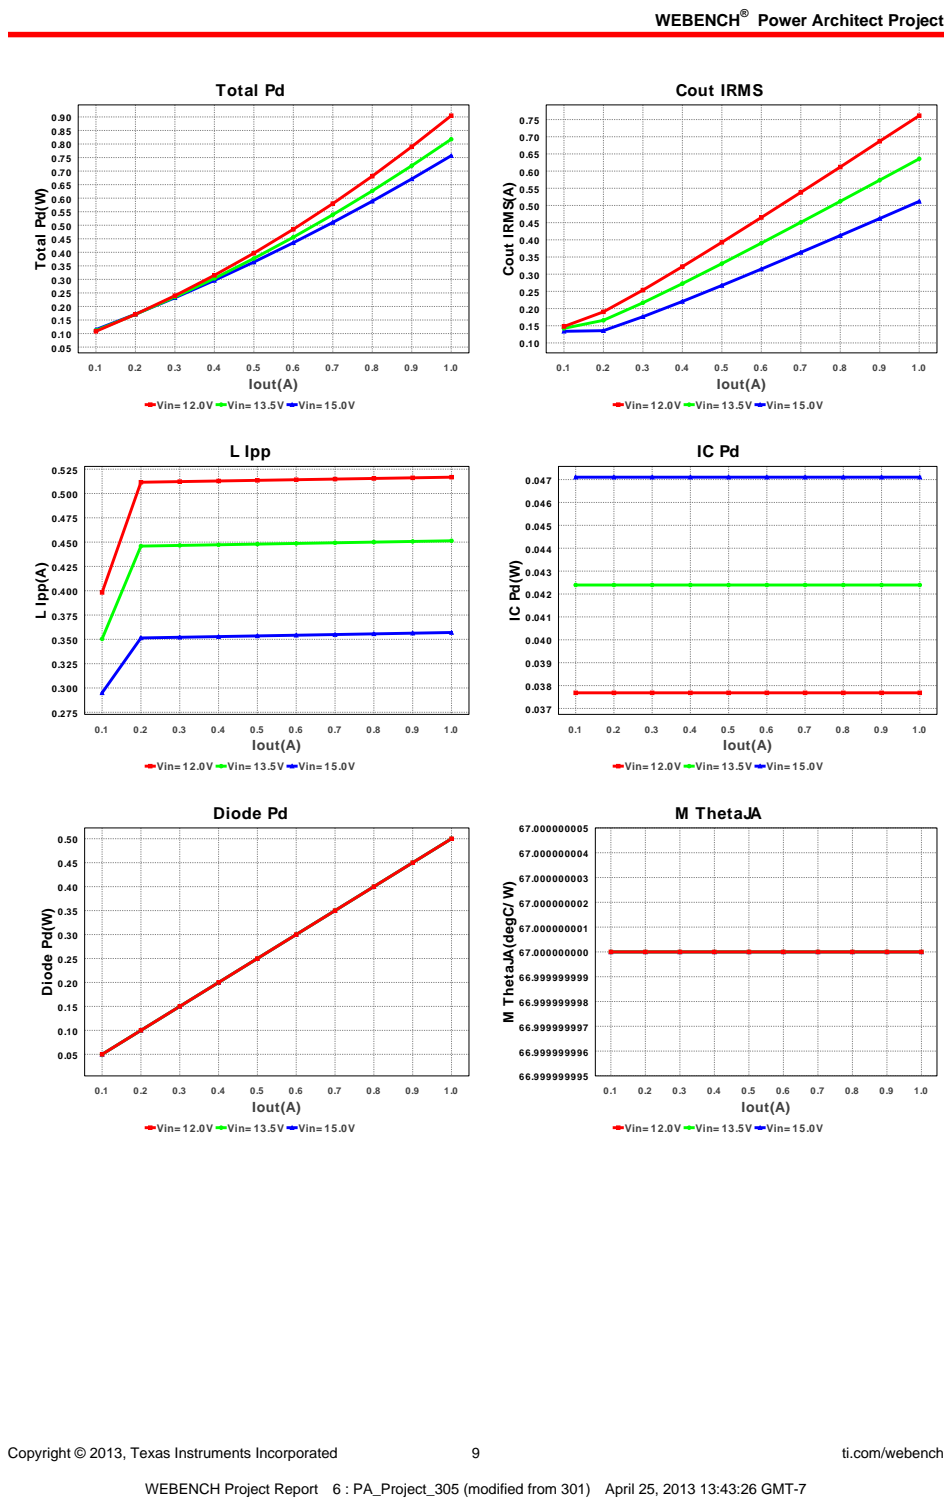
[picture p84: page 9]
Copyright © 2013, Texas Instruments Incorporated; ti.com/webench; Total Pd; Iout(A); Total Pd(W); Cout IRMS; Cout IRMS(A); L Ipp; L Ipp(A); Diode Pd; Diode Pd(W); M ThetaJA; M ThetaJA(degC/ W)

Vin= 12.0V Vin= 13.5V Vin= 15.0V

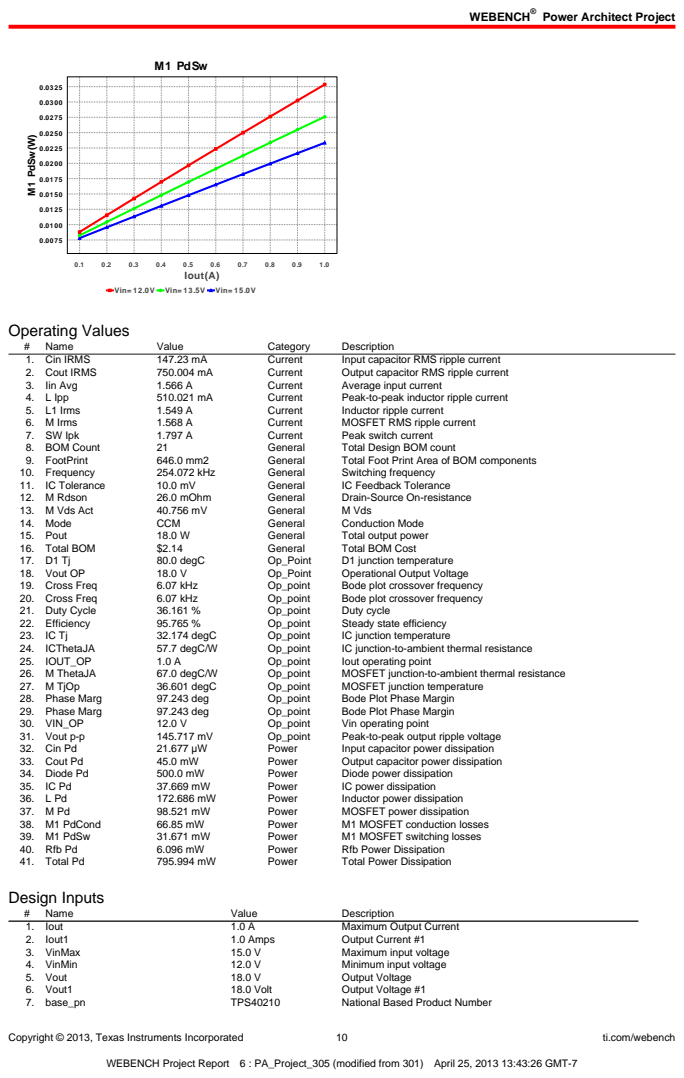
[picture p85: page 10]
Copyright © 2013, Texas Instruments Incorporated; ti.com/webench; M1 PdSw; Iout(A); M1 PdSw(W); Operating Values; Name; Value; Category; Description; 1. Cin IRMS; Current; Input capacitor RMS ripple current; 2. Cout IRMS; Output capacitor RMS ripple current; 3. Iin Avg; Average input current; 4. L Ipp; Peak-to-peak inductor ripple current; 5. L1 Irms; Inductor ripple current; 6. M Irms; MOSFET RMS ripple current; 7. SW Ipk; Peak switch current; 8. BOM Count; General; Total Design BOM count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

Vin= 12.0V Vin= 13.5V Vin= 15.0V

Copyright © 2013, Texas Instruments Incorporated | 11 | ti.com/webench
# | Name | Value | Description

8. source | DC | Input Source Type
9. Ta | 30.0 degC | Ambient temperature

## Design Assistance

1. TPS40210 Product Folder : http://www.ti.com/product/tps40210 : contains the data sheet and other resources.

## WEBENCH ® Design Report

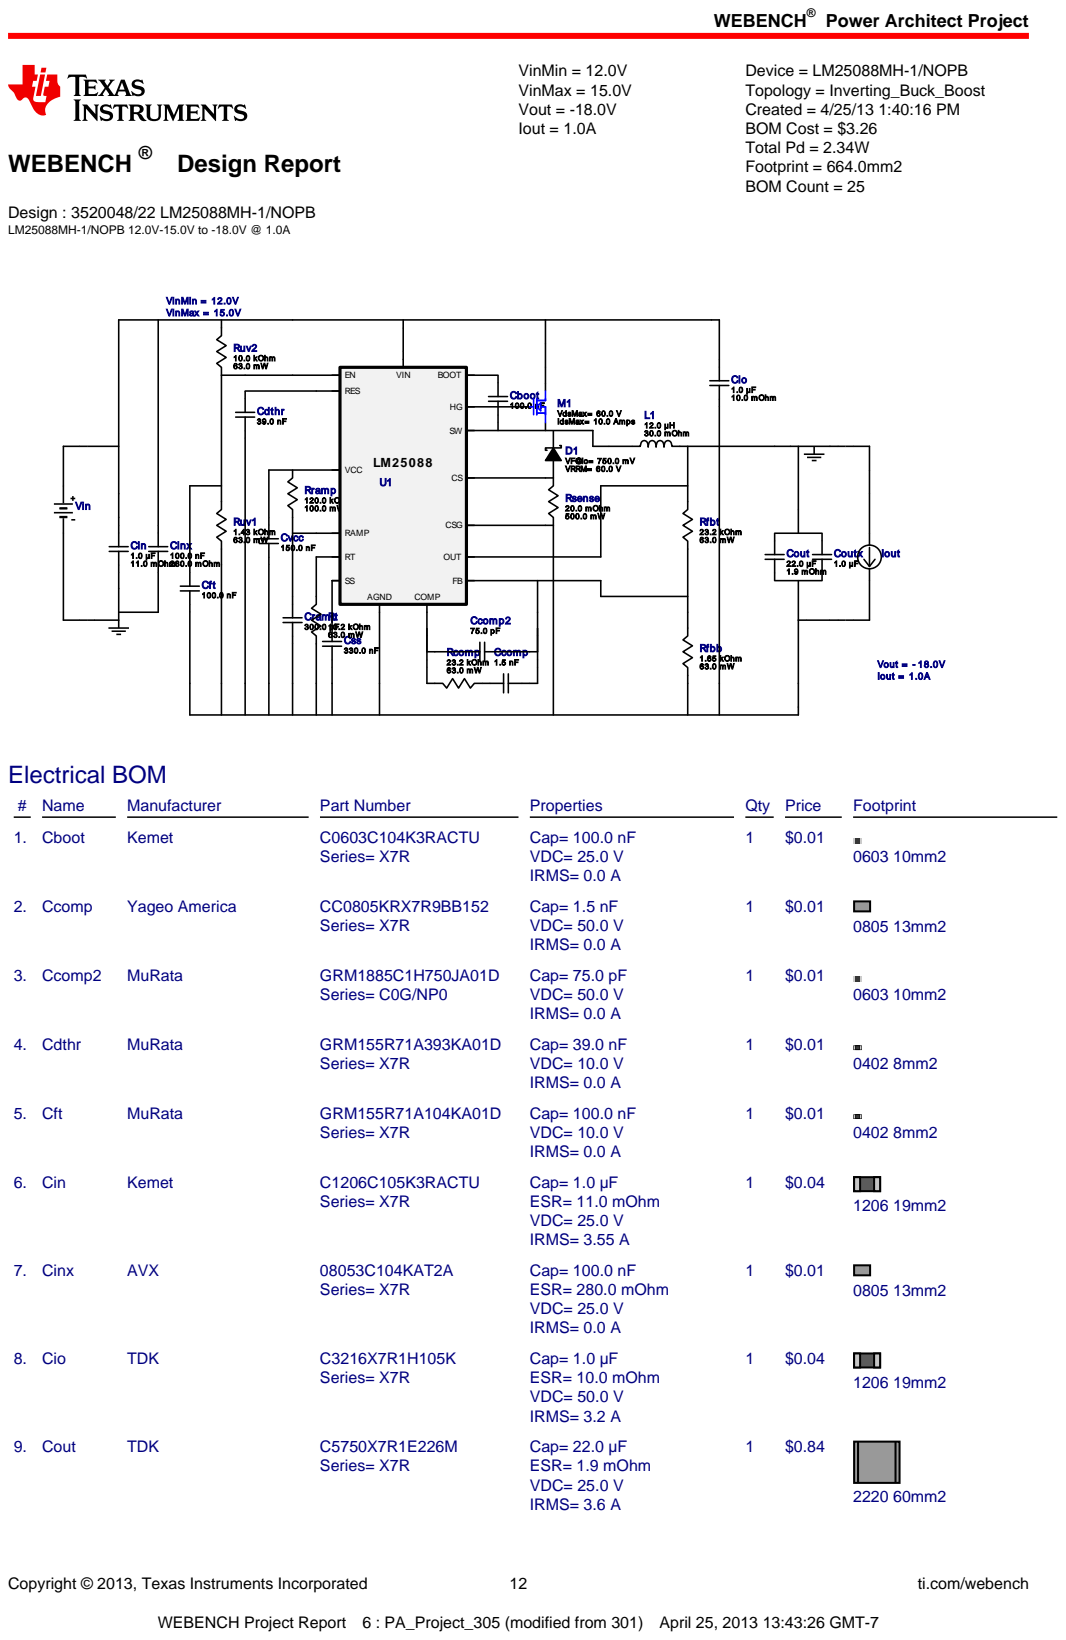
[picture p86: page 12]
Copyright © 2013, Texas Instruments Incorporated; ti.com/webench; Design : 3520048/22 LM25088MH-1/NOPB LM25088MH-1/NOPB 12.0V-15.0V to -18.0V @ 1.0A; VinMin = 12.0V VinMax = 15.0V Vout = -18.0V Iout = 1.0A; Device = LM25088MH-1/NOPB Topology = Inverting_Buck_Boost Created = 4/25/13 1:40:16 PM BOM Cost = $3.26 Total Pd = 2.34W Footprint = 664.0mm2 BOM Count = 25; Cboot; nF Cdthr; Cft 100.0 nF; Cin 1.0 µF 11.0 mOhm; Cinx 100.0 nF 280.0 mOhm; Cio 1.0 µF 10.0 mOhm; Cout 22.0 µF 1.9 mOhm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

Copyright © 2013, Texas Instruments Incorporated | 13 | ti.com/webench
# Name | Manufacturer | Part Number | Properties | Qty Price | Footprint

10. Coutx | Taiyo Yuden | GMK212B7105KG-T (http://www.yuden.co.jp/ut/product/pdf/djmk%5Fe.pdf) Series= X7R | Cap= 1.0 µF VDC= 35.0 V IRMS= 0.0 A
1 | $0.05
| | | | | 0805 13mm2
11. Cramp | MuRata | GRM1555C1E301JA01D (http://search.murata.co.jp/Ceramy/PnsearchViewAction.do) Series= C0G/NP0 | Cap= 300.0 pF VDC= 25.0 V IRMS= 0.0 A
1 | $0.01
| | | | | 0402 8mm2
12. Css | MuRata | GRM155C80J334KE01D (http://search.murata.co.jp/Ceramy/PnsearchViewAction.do) Series= 379 | Cap= 330.0 nF VDC= 6.3 V IRMS= 0.0 A
1 | $0.01
| | | | | 0402 8mm2
13. Cvcc | MuRata | GRM155R61A154KE19D (http://search.murata.co.jp/Ceramy/PnsearchViewAction.do) Series= X5R | Cap= 150.0 nF VDC= 10.0 V IRMS= 0.0 A
1 | $0.01
| | | | | 0402 8mm2
14. D1 | Vishay-Semiconductor | SS36-E3/57T (http://www.vishay.com/docs/88751/88751.pdf) | VF@Io= 750.0 mV VRRM= 60.0 V
1 | $0.18
| | | | | SMC 83mm2
15. L1 | Bourns | SDR1307-120ML (http://www.bourns.com/pdfs/SDR1307.pdf) | L= 12.0 µH DCR= 30.0 mOhm
1 | $0.34

SDR1307 227mm2
16. M1 | AOS | AON7246 (http://www.aosmd.com/res/data%5Fsheets/AON7246.pdf) | VdsMax= 60.0 V IdsMax= 10.0 Amps | 1 | $0.26

TRANS_AOS_DFN3X3
25mm2
17. Rcomp | Vishay-Dale | CRCW040223K2FKED (http://www.vishay.com/docs/20035/dcrcwe3.pdf) Series= CRCW..e3 | Res= 23.2 kOhm Power= 63.0 mW Tolerance= 1.0% | 1 | $0.01
0402 8mm2
18. Rfbb | Vishay-Dale | CRCW04021K65FKED (http://www.vishay.com/docs/20035/dcrcwe3.pdf) Series= CRCW..e3 | Res= 1.65 kOhm Power= 63.0 mW Tolerance= 1.0% | 1 | $0.01
0402 8mm2
19. Rfbt | Vishay-Dale | CRCW040223K2FKED (http://www.vishay.com/docs/20035/dcrcwe3.pdf) Series= CRCW..e3 | Res= 23.2 kOhm Power= 63.0 mW Tolerance= 1.0% | 1 | $0.01
0402 8mm2
20. Rramp | Susumu Co Ltd | RR1220P-124-D (http://www.susumu.co.jp/english/pdf/products-j01-04.pdf) Series= 264 | Res= 120.0 kOhm Power= 100.0 mW Tolerance= 0.5% | 1 | $0.01
0805 13mm2
21. Rsense | Stackpole Electronics Inc CSR1206FK20L0 (http://www.seielect.com/Catalog/SEI-csr.pdf)
| | Series= ? | Res= 20.0 mOhm Power= 500.0 mW Tolerance= 1.0% | 1 | $0.10
1206 19mm2
22. Rt | Vishay-Dale | CRCW040210K2FKED (http://www.vishay.com/docs/20035/dcrcwe3.pdf) Series= CRCW..e3 | Res= 10.2 kOhm Power= 63.0 mW Tolerance= 1.0% | 1 | $0.01
0402 8mm2
23. Ruv1 | Vishay-Dale | CRCW04021K43FKED (http://www.vishay.com/docs/20035/dcrcwe3.pdf) Series= CRCW..e3 | Res= 1.43 kOhm Power= 63.0 mW Tolerance= 1.0% | 1 | $0.01
0402 8mm2
24. Ruv2 | Vishay-Dale | CRCW040210K0FKED (http://www.vishay.com/docs/20035/dcrcwe3.pdf) Series= CRCW..e3 | Res= 10.0 kOhm Power= 63.0 mW Tolerance= 1.0% | 1 | $0.01
0402 8mm2
25. U1 | Texas Instruments | LM25088MH-1/NOPB (http://www.ti.com/product/lm25088) | Switcher | 1 | $1.25

MXA16A 59mm2

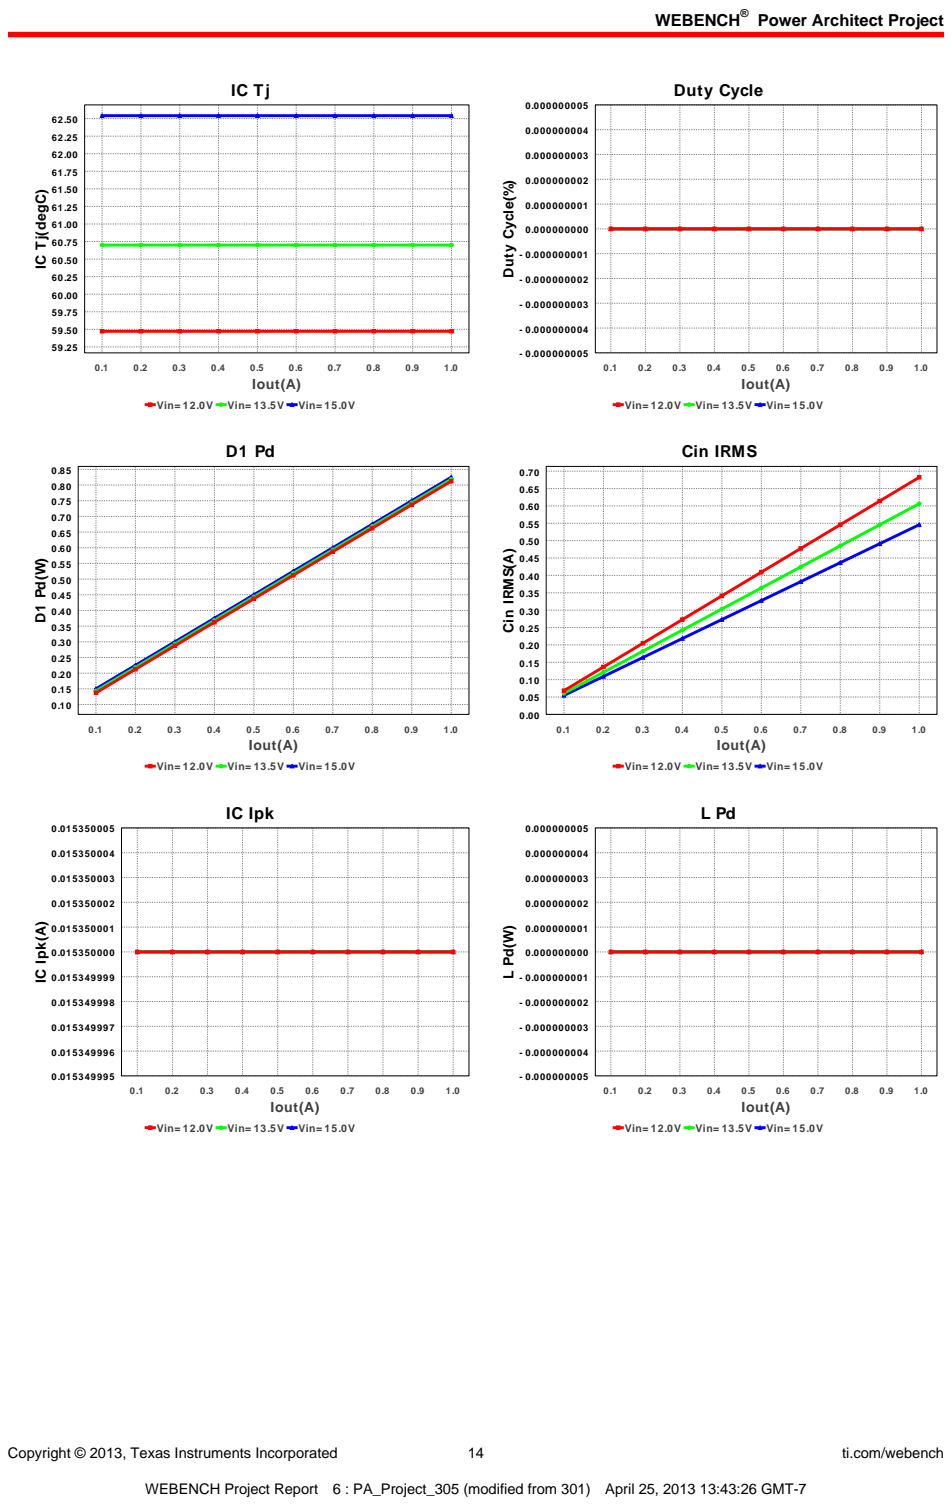
[picture p87: page 14]
Copyright © 2013, Texas Instruments Incorporated; ti.com/webench; Iout(A); Duty Cycle; Duty Cycle(%); Cin IRMS; Cin IRMS(A); IC Ipk; IC Ipk(A)

IC Tj(degC)

Vin= 12.0V Vin= 13.5V Vin= 15.0V

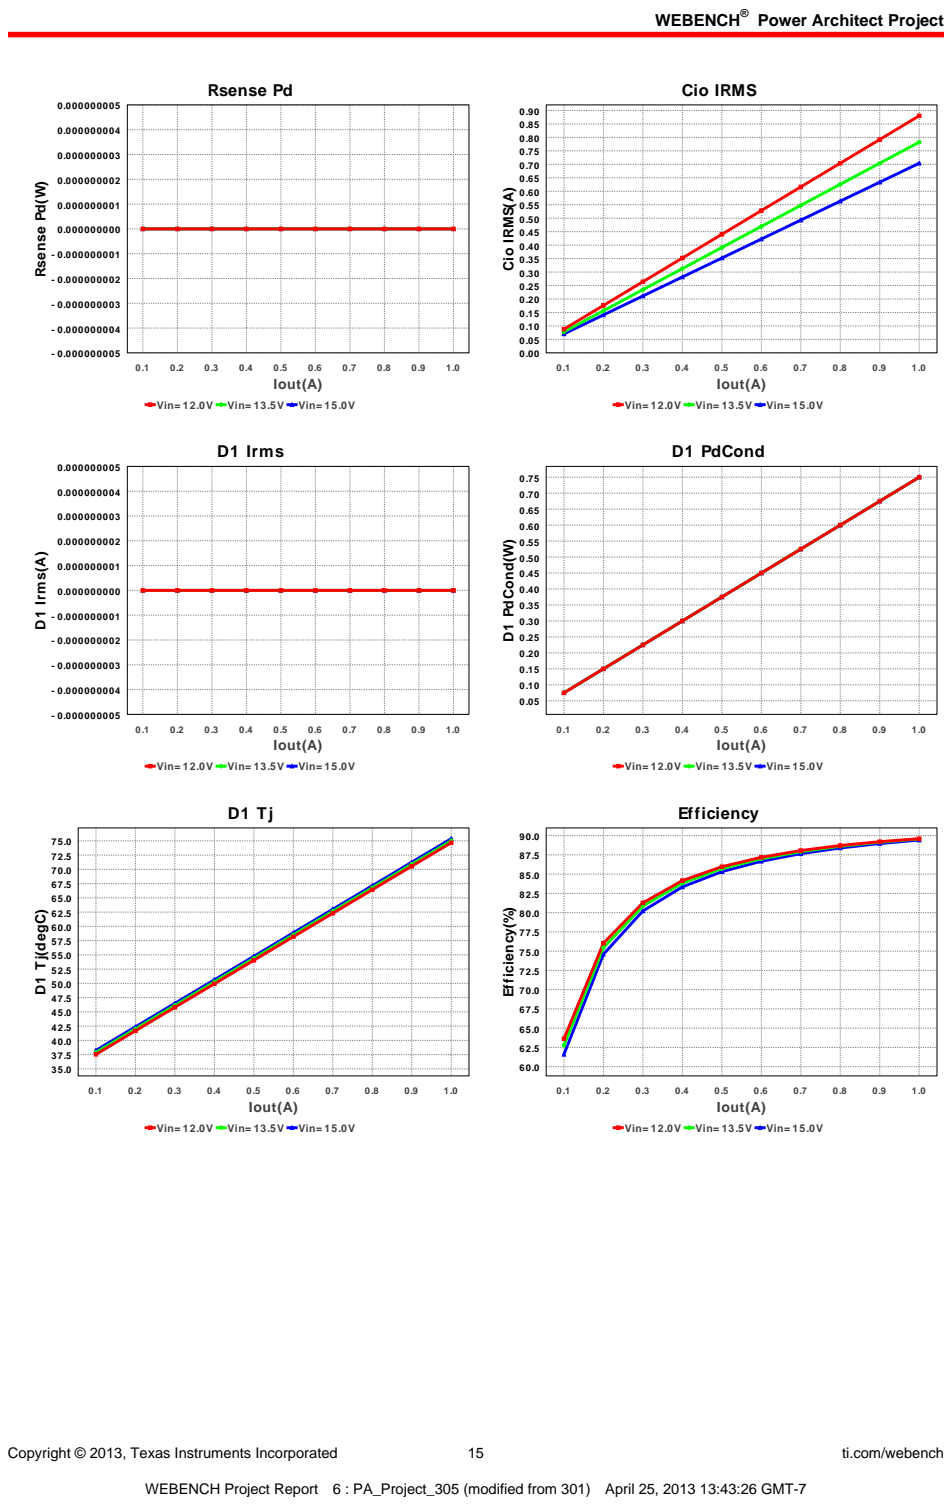
[picture p88: page 15]
Copyright © 2013, Texas Instruments Incorporated; ti.com/webench; Rsense Pd; Iout(A); Rsense Pd(W); Cio IRMS; Cio IRMS(A); D1 Irms; D1 Irms(A); D1 PdCond; D1 PdCond(W); D1 Tj(degC); Efficiency; Efficiency(%)

Vin= 12.0V Vin= 13.5V Vin= 15.0V

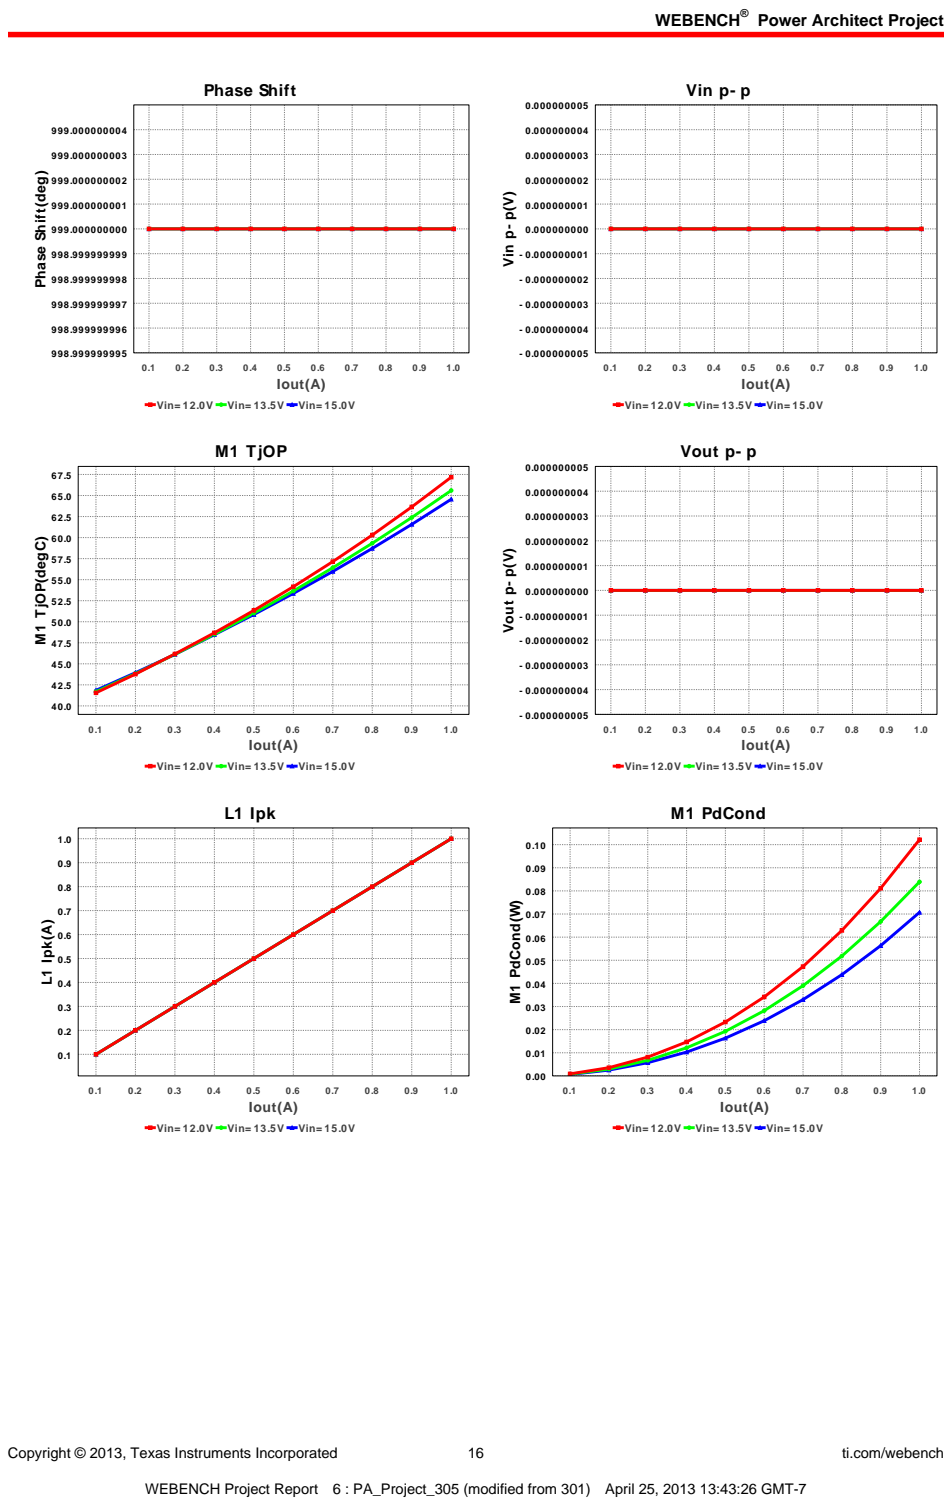
[picture p89: page 16]
Copyright © 2013, Texas Instruments Incorporated; ti.com/webench; Phase Shift; Iout(A); Vin p- p; Vin p- p(V); M1 TjOP; M1 TjOP(degC); Vout p- p; Vout p- p(V); L1 Ipk; L1 Ipk(A); M1 PdCond; M1 PdCond(W)

Phase Shift(deg)

Vin= 12.0V Vin= 13.5V Vin= 15.0V

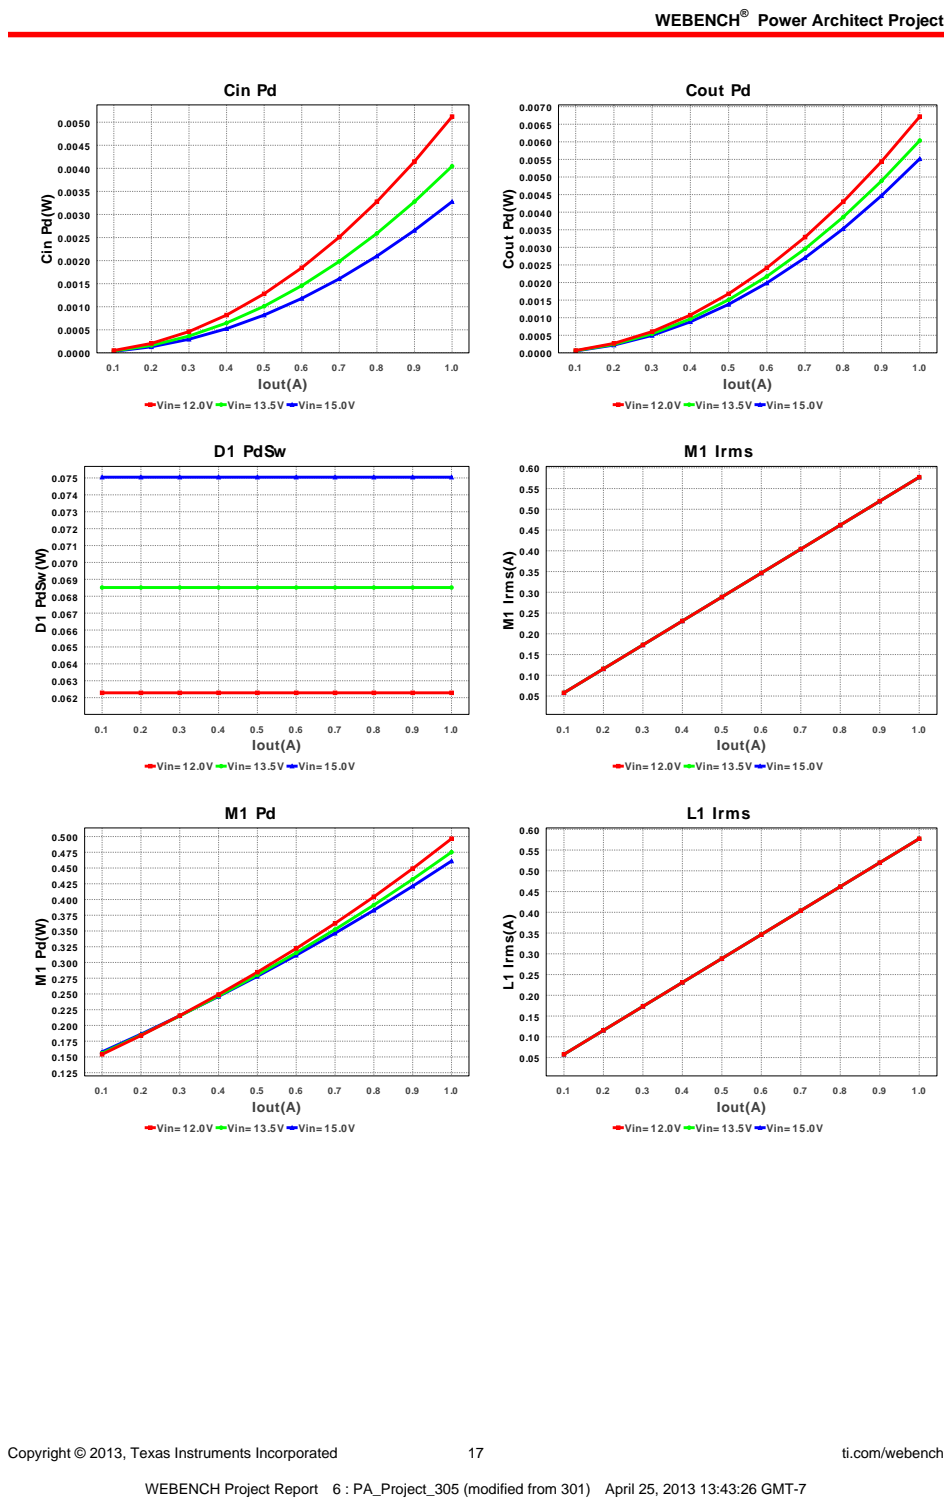
[picture p90: page 17]
Copyright © 2013, Texas Instruments Incorporated; ti.com/webench; Cin Pd; Iout(A); Cin Pd(W); Cout Pd; Cout Pd(W); D1 PdSw; D1 PdSw(W); M1 Irms; M1 Irms(A); L1 Irms; L1 Irms(A)

Vin= 12.0V Vin= 13.5V Vin= 15.0V

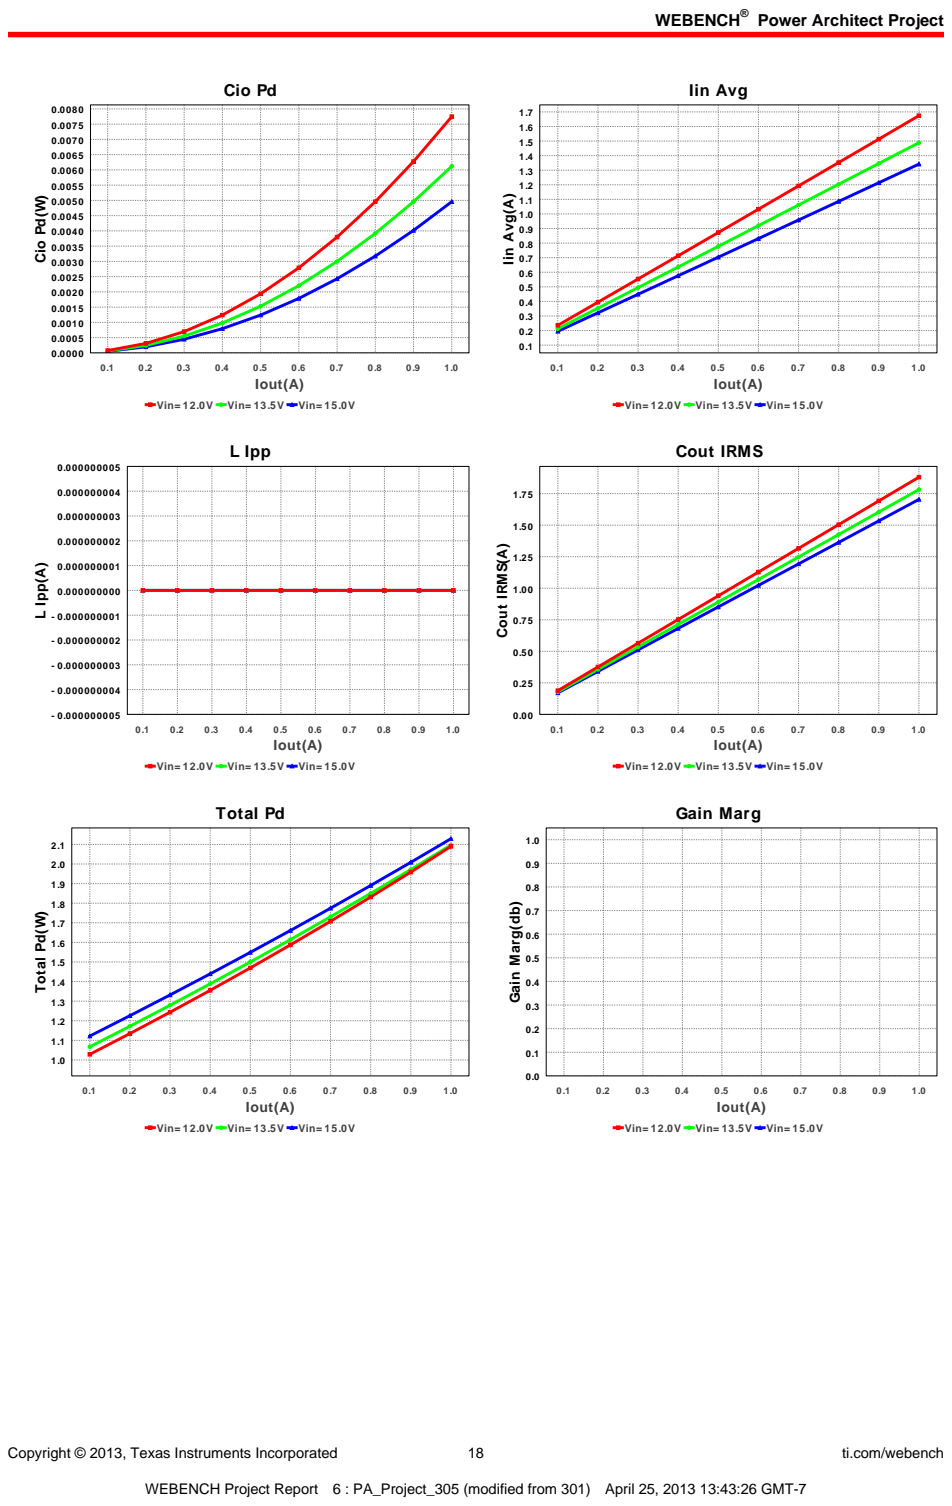
[picture p91: page 18]
Copyright © 2013, Texas Instruments Incorporated; ti.com/webench; Cio Pd; Iout(A); Cio Pd(W); Iin Avg; Iin Avg(A); L Ipp; L Ipp(A); Cout IRMS; Cout IRMS(A); Total Pd; Total Pd(W); Gain Marg

Vin= 12.0V Vin= 13.5V Vin= 15.0V

Gain Marg(db)

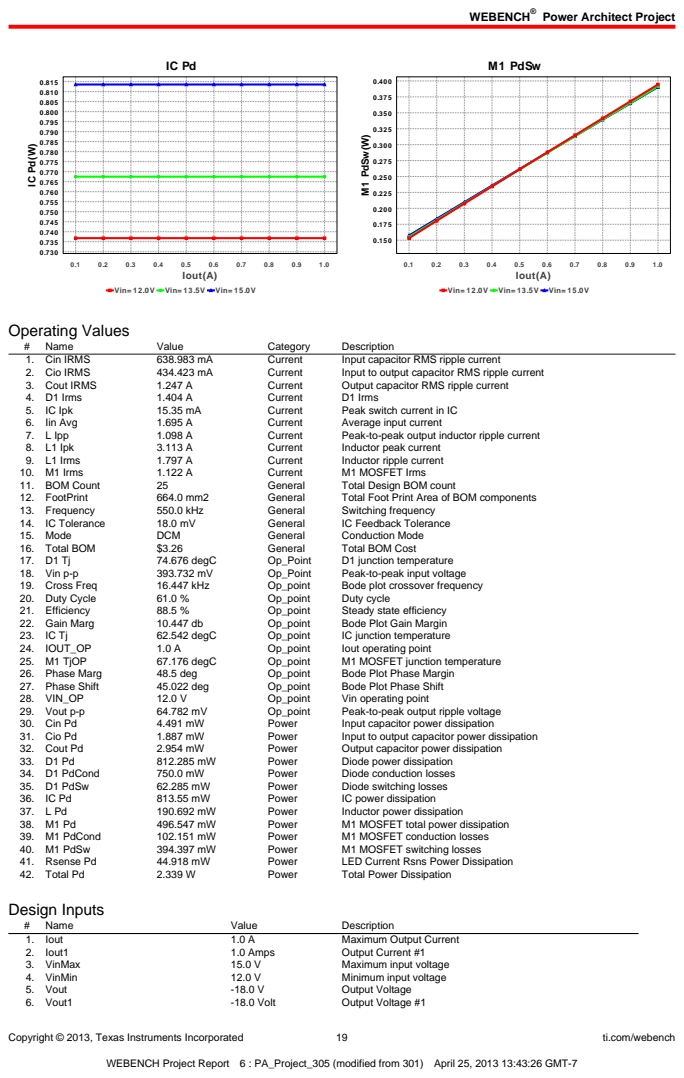
[picture p92: page 19]
Copyright © 2013, Texas Instruments Incorporated; ti.com/webench; Iout(A); M1 PdSw; M1 PdSw(W); Operating Values; Name; Value; Category; Description; 1. Cin IRMS; Current; Input capacitor RMS ripple current; 2. Cio IRMS; Input to output capacitor RMS ripple current; 3. Cout IRMS; Output capacitor RMS ripple current; 4. D1 Irms; D1 Irms; 5. IC Ipk; Peak switch current in IC; 6. Iin Avg; Average input current; 7. L Ipp; Peak-to-peak output inductor ripple current; 8. L1 Ipk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

Vin= 12.0V Vin= 13.5V Vin= 15.0V

Copyright © 2013, Texas Instruments Incorporated | 20 | ti.com/webench
# | Name | Value | Description

7. base_pn | LM25088 | National Based Product Number
8. source | DC | Input Source Type
9. Ta | 30.0 degC | Ambient temperature

## Design Assistance

1. LM25088 Product Folder : http://www.ti.com/product/lm25088 : contains the data sheet and other resources.

## WEBENCH ® Design Report

### TPS62152

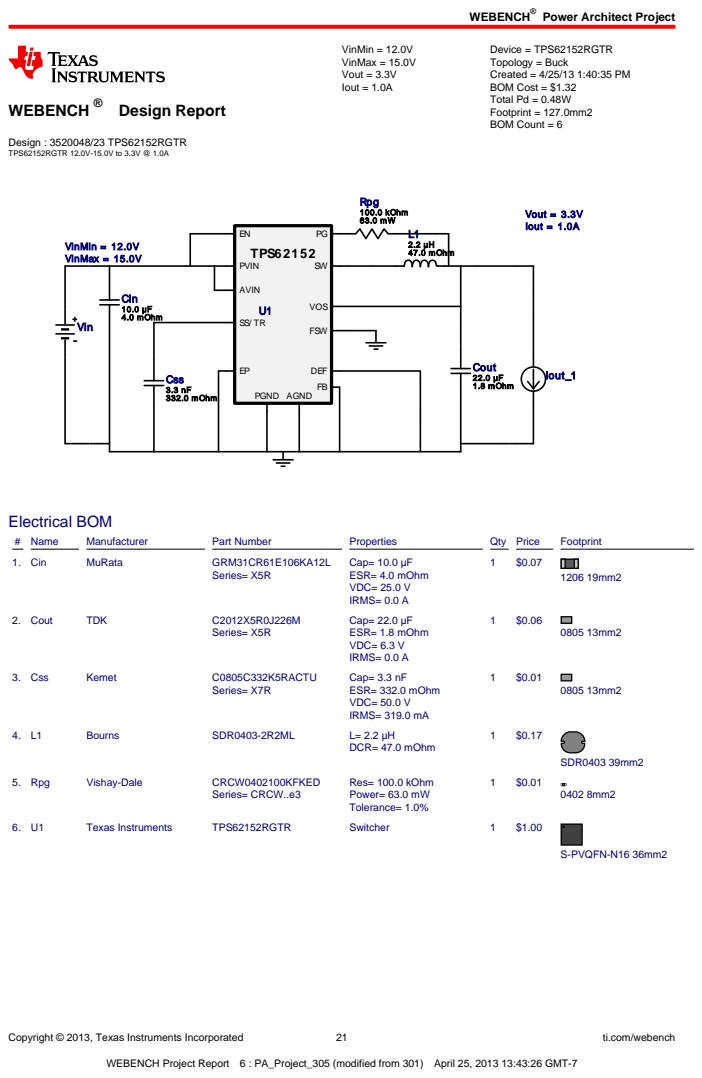
[picture p93: page 21]
Copyright © 2013, Texas Instruments Incorporated; ti.com/webench; Design : 3520048/23 TPS62152RGTR TPS62152RGTR 12.0V-15.0V to 3.3V @ 1.0A; VinMin = 12.0V VinMax = 15.0V Vout = 3.3V Iout = 1.0A; Device = TPS62152RGTR Topology = Buck Created = 4/25/13 1:40:35 PM BOM Cost = $1.32 Total Pd = 0.48W Footprint = 127.0mm2 BOM Count = 6; Cin 10.0 µF 4.0 mOhm; Cout 22.0 µF 1.8 mOhm Css 3.3 nF 332.0 mOhm; L1 2.2 µH 47.0 mOhm; Rpg 100.0 kOhm 63.0 mW; AGND; FSW; DEF; AVIN; PVIN; VOS; PGND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

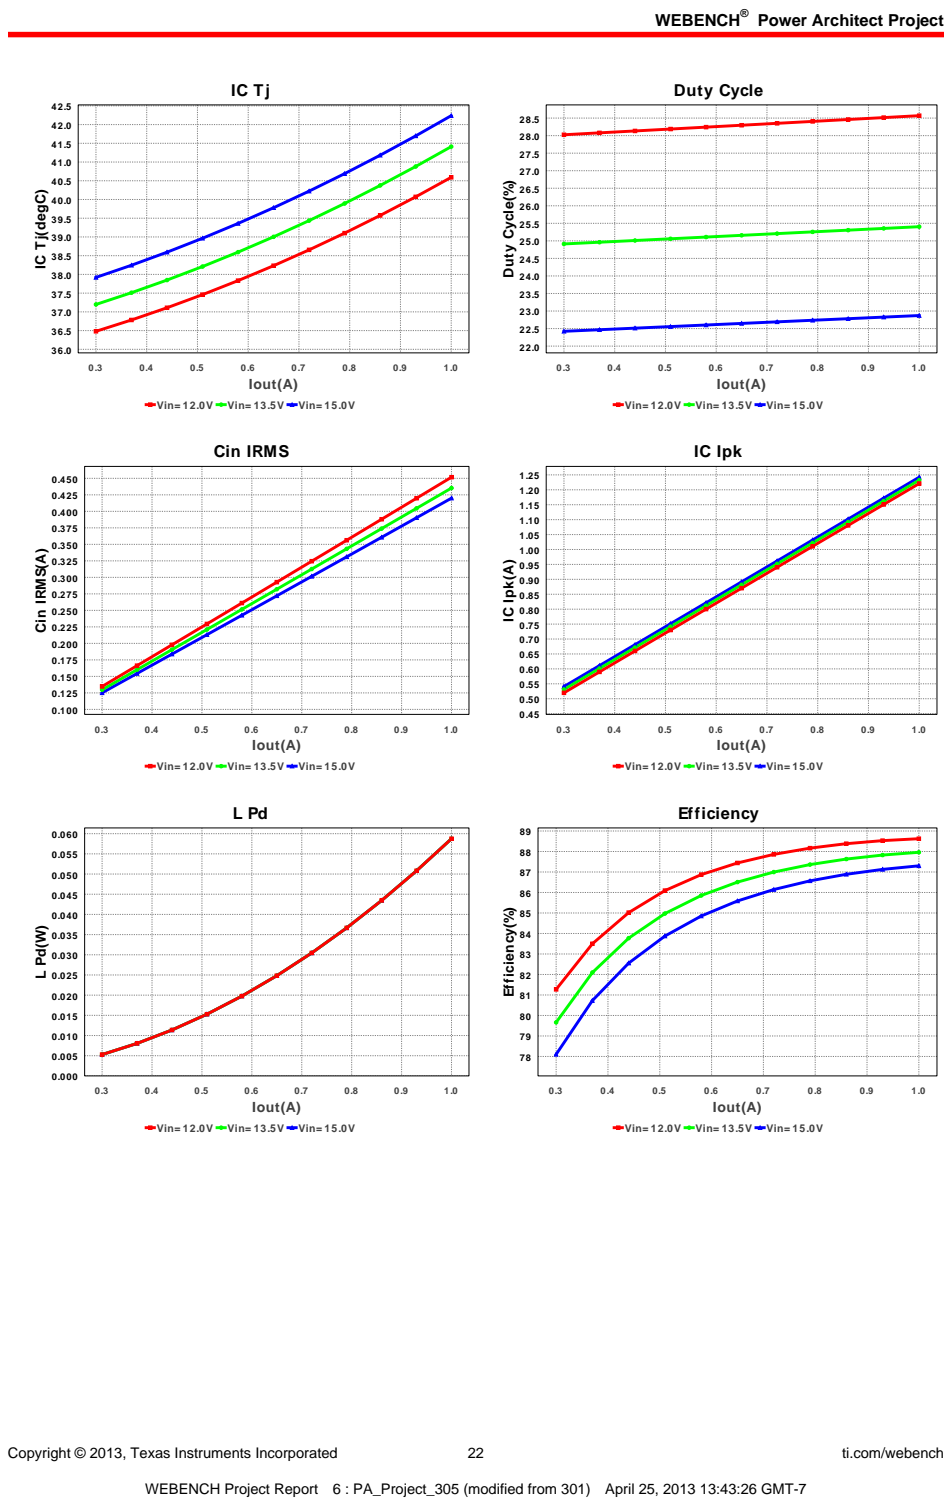
[picture p94: page 22]
Copyright © 2013, Texas Instruments Incorporated; ti.com/webench; Iout(A); Duty Cycle; Duty Cycle(%); Cin IRMS; Cin IRMS(A); IC Ipk; IC Ipk(A); Efficiency; Efficiency(%)

IC Tj(degC)

Vin= 12.0V Vin= 13.5V Vin= 15.0V

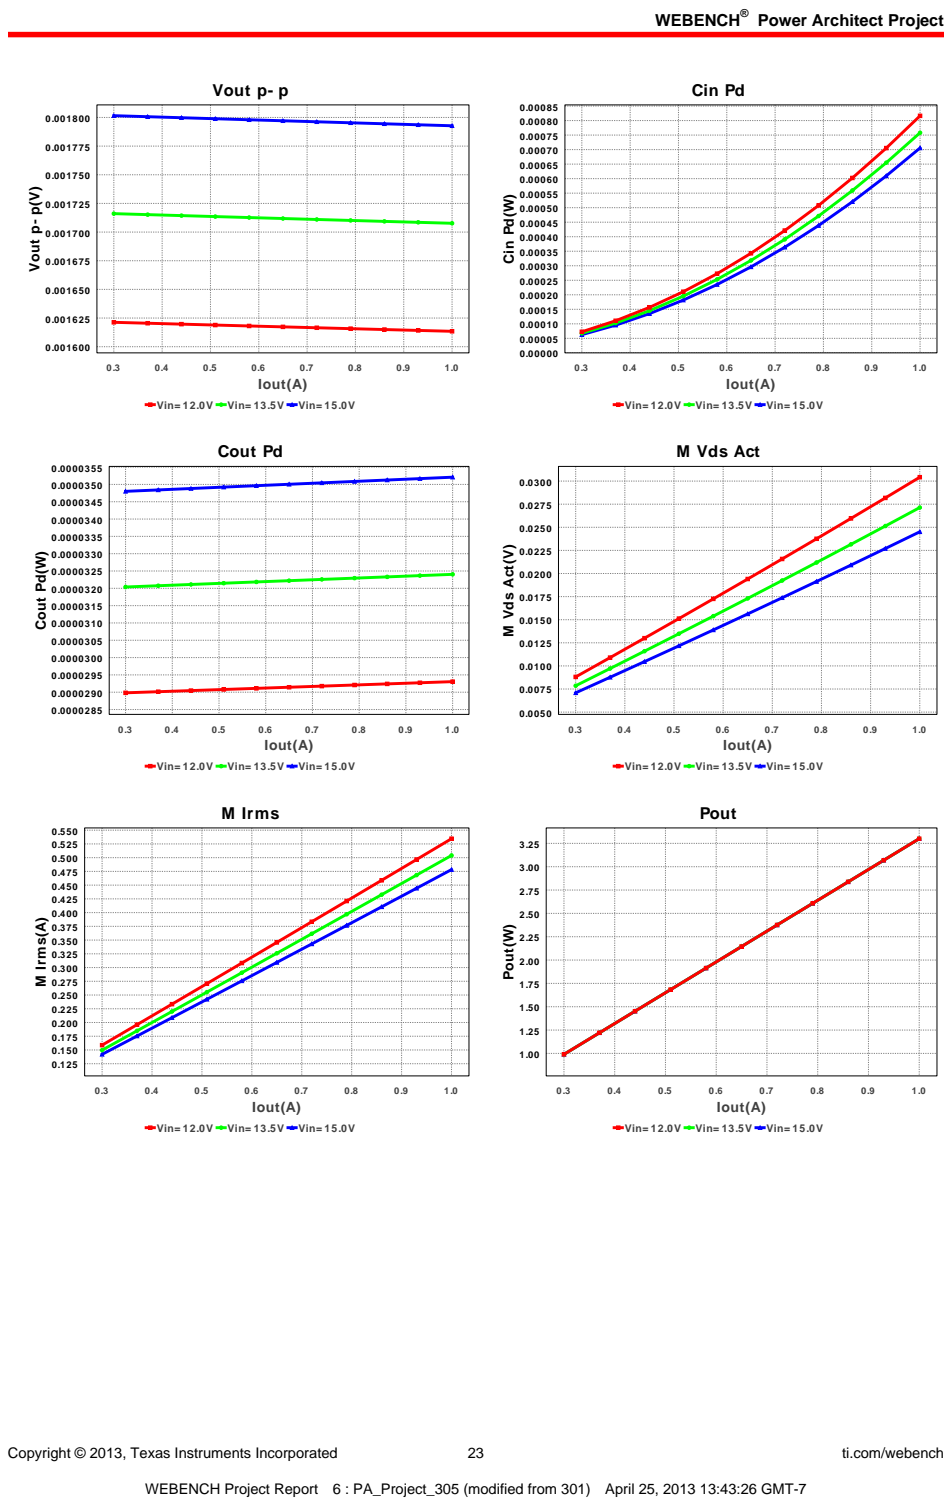
[picture p95: page 23]
Copyright © 2013, Texas Instruments Incorporated; ti.com/webench; Vout p- p; Iout(A); Vout p- p(V); Cin Pd; Cin Pd(W); Cout Pd; Cout Pd(W); M Vds Act; M Vds Act(V); M Irms; M Irms(A); Pout; Pout(W)

Vin= 12.0V Vin= 13.5V Vin= 15.0V

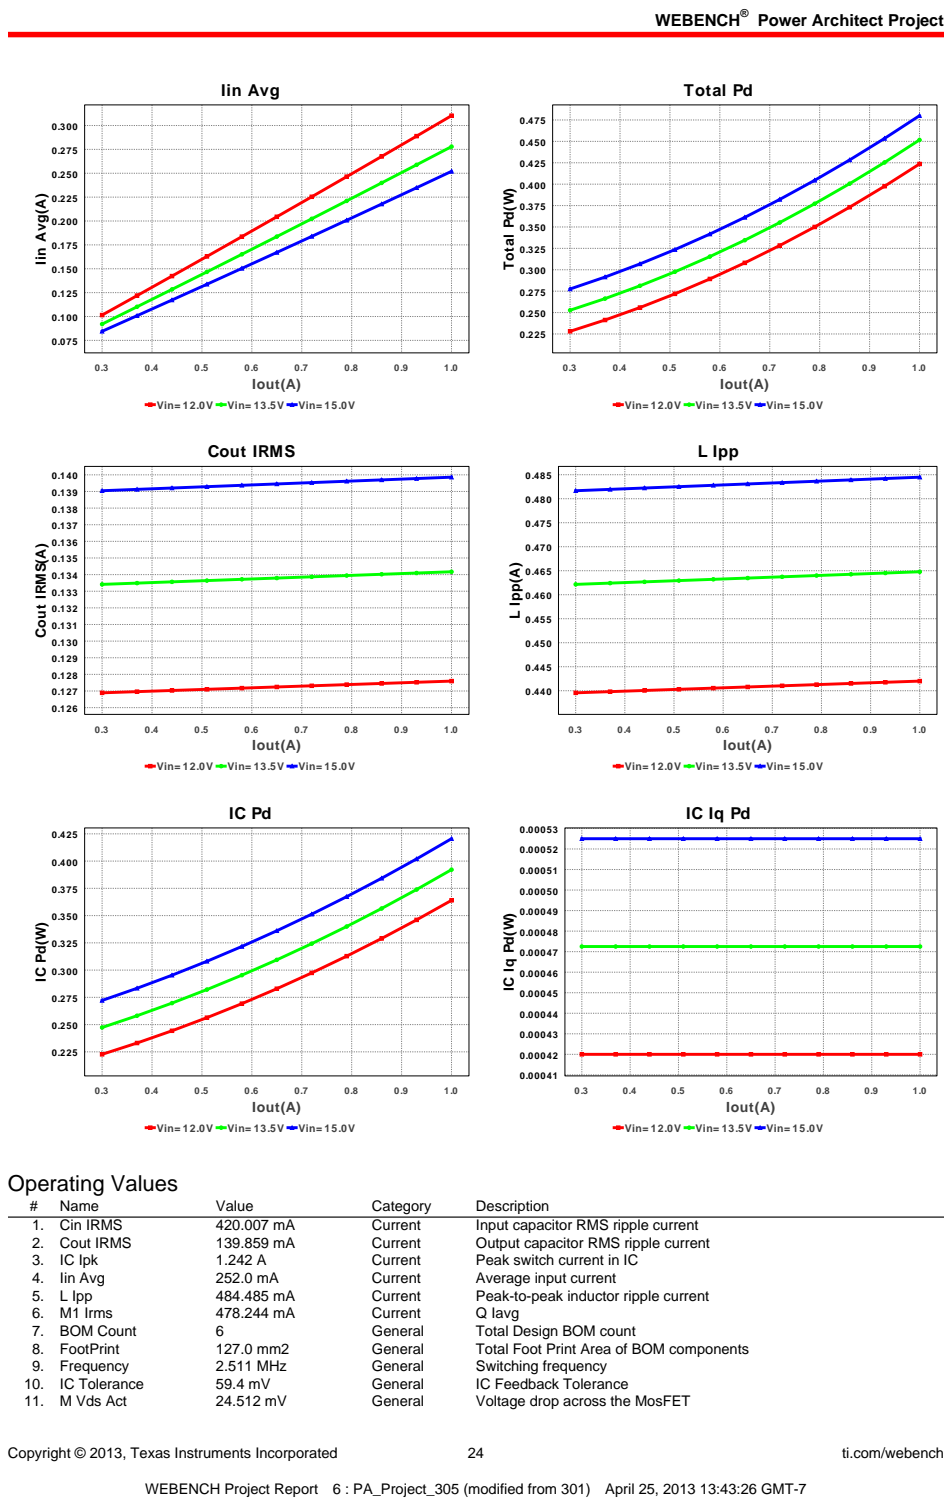
[picture p96: page 24]
Copyright © 2013, Texas Instruments Incorporated; ti.com/webench; Iin Avg; Iout(A); Iin Avg(A); Total Pd; Total Pd(W); Cout IRMS; Cout IRMS(A); L Ipp; L Ipp(A); Operating Values; Name; Value; Category; Description; 1. Cin IRMS; Current; Input capacitor RMS ripple current; 2. Cout IRMS; Output capacitor RMS ripple current; 3. IC Ipk; Peak switch current in IC; 4. Iin Avg; Average input current; 5. L Ipp; Peak-to-peak inductor ripple current; 6. M1 Irms; Q Iavg; 7. BOM Count; General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

Vin= 12.0V Vin= 13.5V Vin= 15.0V

Copyright © 2013, Texas Instruments Incorporated | 25 | ti.com/webench
# | Name | Value | Category | Description

12. Mode | CCM | General | Conduction Mode
13. Pout | 3.3 W | General | Total output power
14. Total BOM | $1.32 | General | Total BOM Cost
15. Vout OP | 3.3 V | Op_Point | Operational Output Voltage
16. Duty Cycle | 22.872 % | Op_point | Duty cycle
17. Efficiency | 87.301 % | Op_point | Steady state efficiency
18. IC Tj | 42.238 degC | Op_point | IC junction temperature
19. ICThetaJA | 29.1 degC/W | Op_point | IC junction-to-ambient thermal resistance
20. IOUT_OP | 1.0 A | Op_point | Iout operating point
21. VIN_OP | 15.0 V | Op_point | Vin operating point
22. Vout p-p | 1.793 mV | Op_point | Peak-to-peak output ripple voltage
23. Cin Pd | 705.623 µW | Power | Input capacitor power dissipation
24. Cout Pd | 35.209 µW | Power | Output capacitor power dissipation
25. IC Pd | 420.539 mW | Power | IC power dissipation
26. L Pd | 58.75 mW | Power | Inductor power dissipation
27. Total Pd | 480.022 mW | Power | Total Power Dissipation

## Design Inputs

# | Name | Value | Description

1. Iout | 1.0 A | Maximum Output Current
2. Iout1 | 1.0 Amps | Output Current #1
3. VinMax | 15.0 V | Maximum input voltage
4. VinMin | 12.0 V | Minimum input voltage
5. Vout | 3.3 V | Output Voltage
6. Vout1 | 3.3 Volt | Output Voltage #1
7. base_pn | TPS62152 | National Based Product Number
8. source | DC | Input Source Type
9. Ta | 30.0 degC | Ambient temperature

## Design Assistance

1. Feature Highlights: DCS-Control(TM) Architecture with upto 1A output current, 3V to 17V Input Voltage Range, 3.3V Fixed Output voltageSelectable operating frequency, Optional Softstart Capacitor for slow startup, Tracking,Pin selectable output voltage (nominal, +5%) Seamless Power Save Mode for Light Load Efficiency, Power Good Output, 100% Duty Cycle mode, Short Circuit Protection, Thermal Shutdown
2. TPS62152 Product Folder : http://www.ti.com/product/tps62152 : contains the data sheet and other resources.

## WEBENCH ® Design Report

### TPS62143

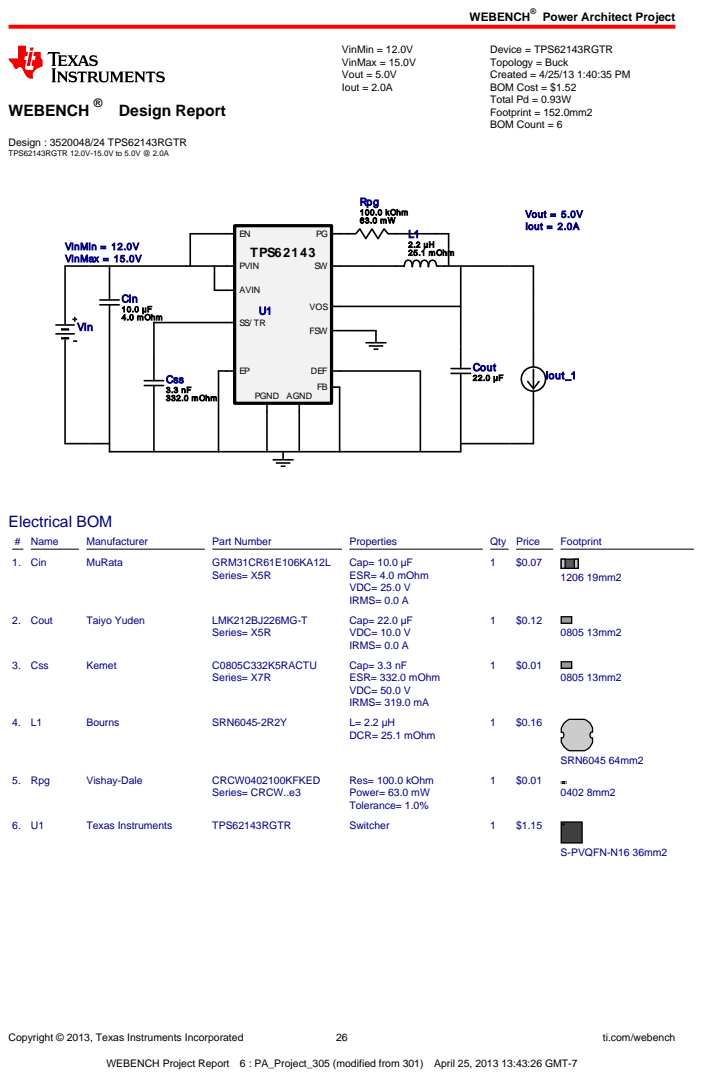
[picture p97: page 26]
Copyright © 2013, Texas Instruments Incorporated; ti.com/webench; Design : 3520048/24 TPS62143RGTR TPS62143RGTR 12.0V-15.0V to 5.0V @ 2.0A; VinMin = 12.0V VinMax = 15.0V Vout = 5.0V Iout = 2.0A; Device = TPS62143RGTR Topology = Buck Created = 4/25/13 1:40:35 PM BOM Cost = $1.52 Total Pd = 0.93W Footprint = 152.0mm2 BOM Count = 6; Cin 10.0 µF 4.0 mOhm; Cout; Css; 3.3 nF 332.0 mOhm; L1 2.2 µH 25.1 mOhm; Rpg 100.0 kOhm 63.0 mW; AGND; FSW; DEF; AVIN; PVIN; VOS; PGND; VinMin = 12.0V VinMax = 15.0V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

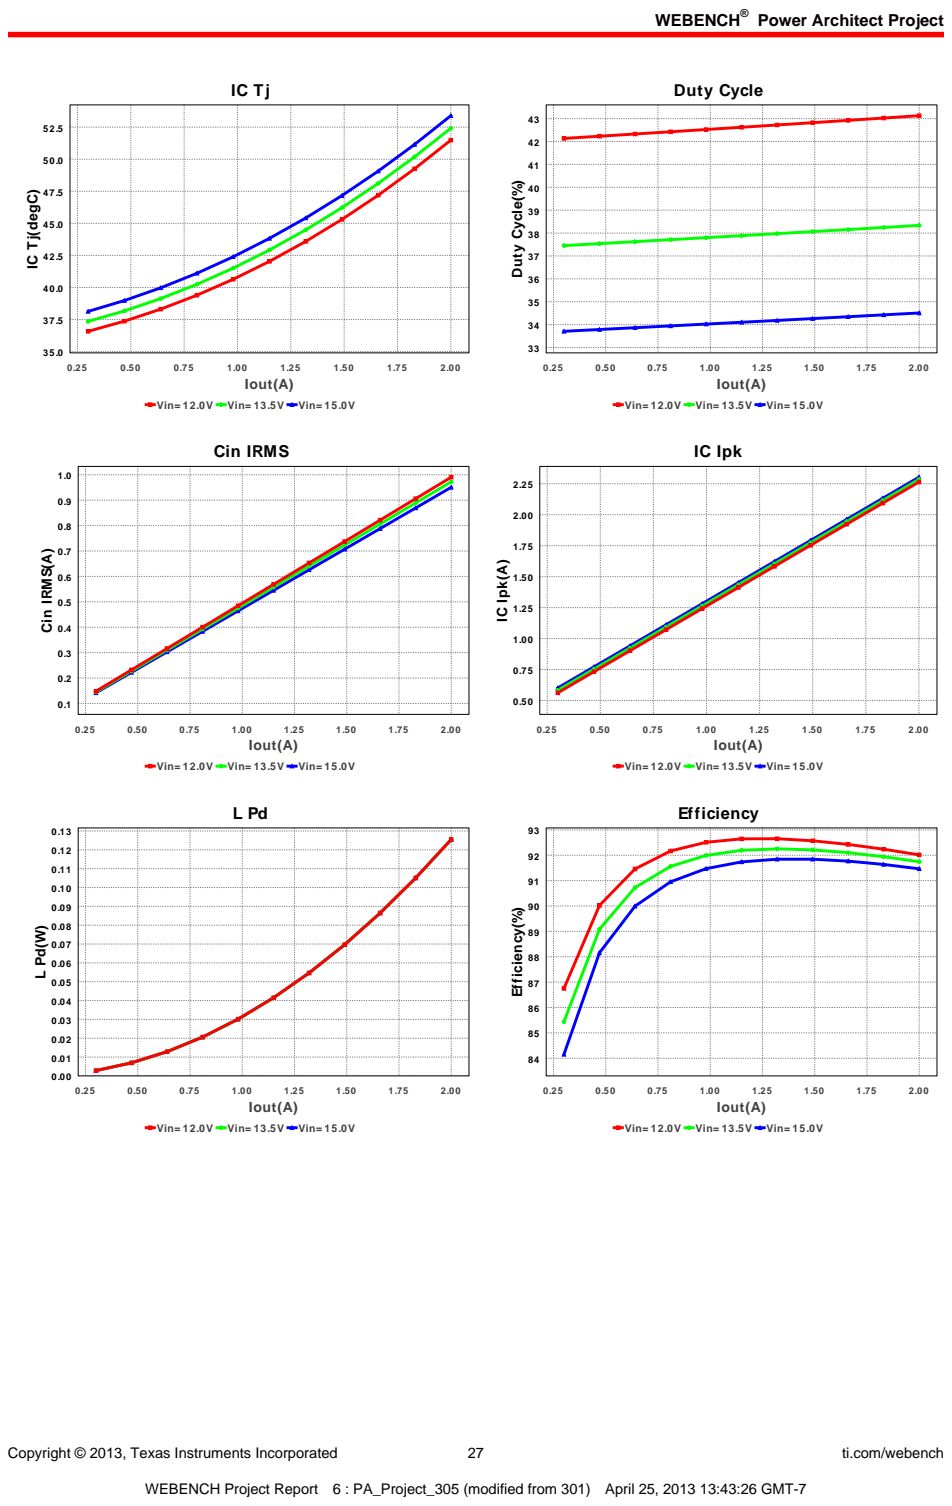
[picture p98: page 27]
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

IC Tj(degC)

Vin= 12.0V Vin= 13.5V Vin= 15.0V

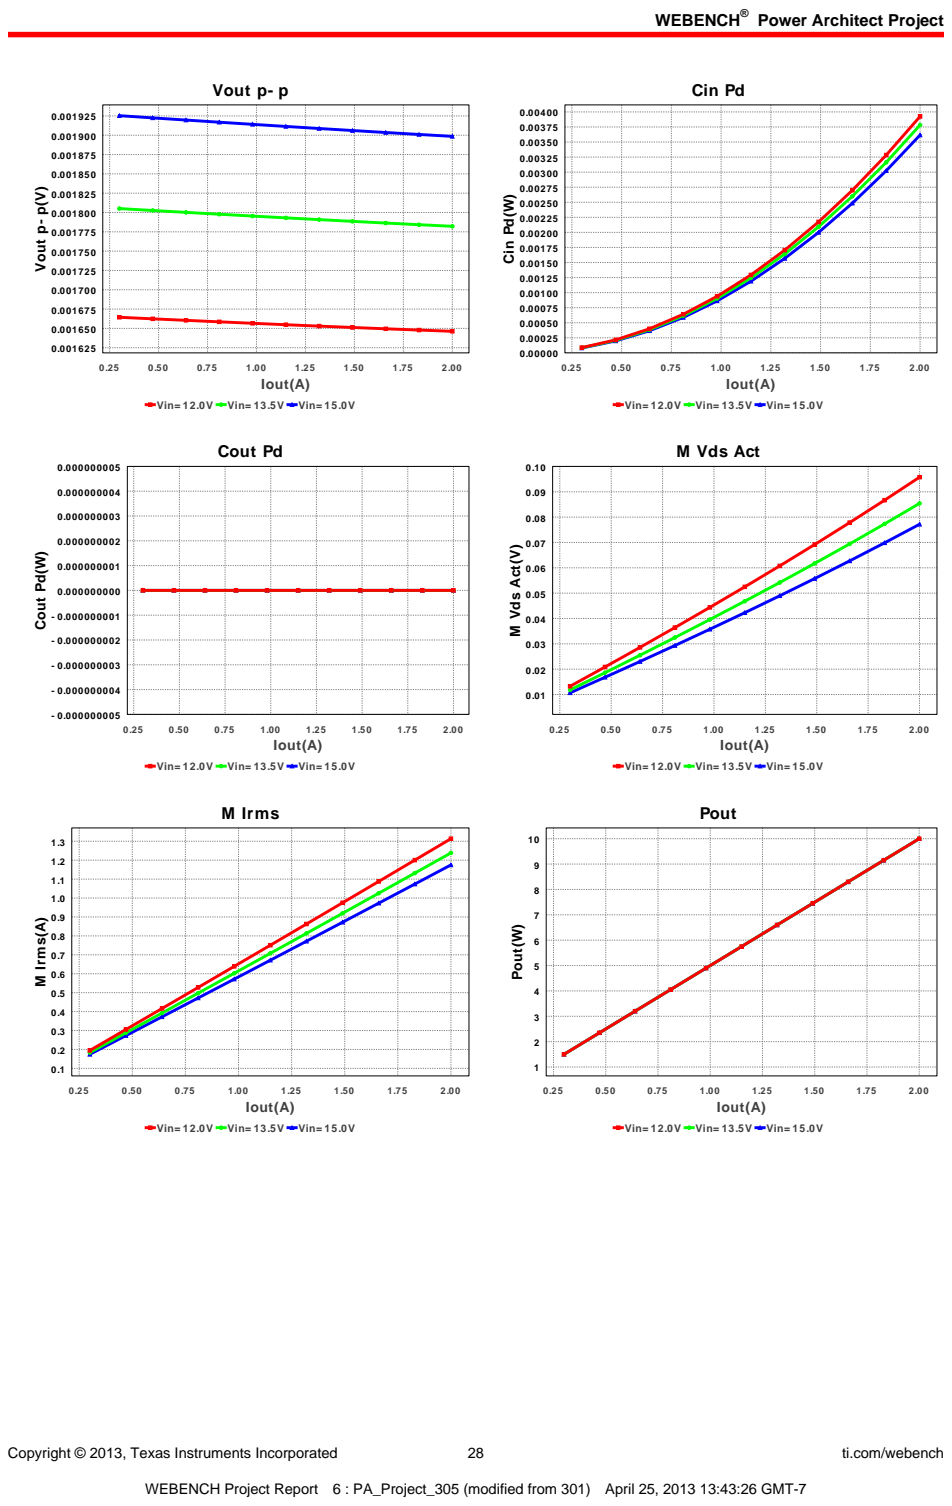
[picture p99: page 28]
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

Vin= 12.0V Vin= 13.5V Vin= 15.0V

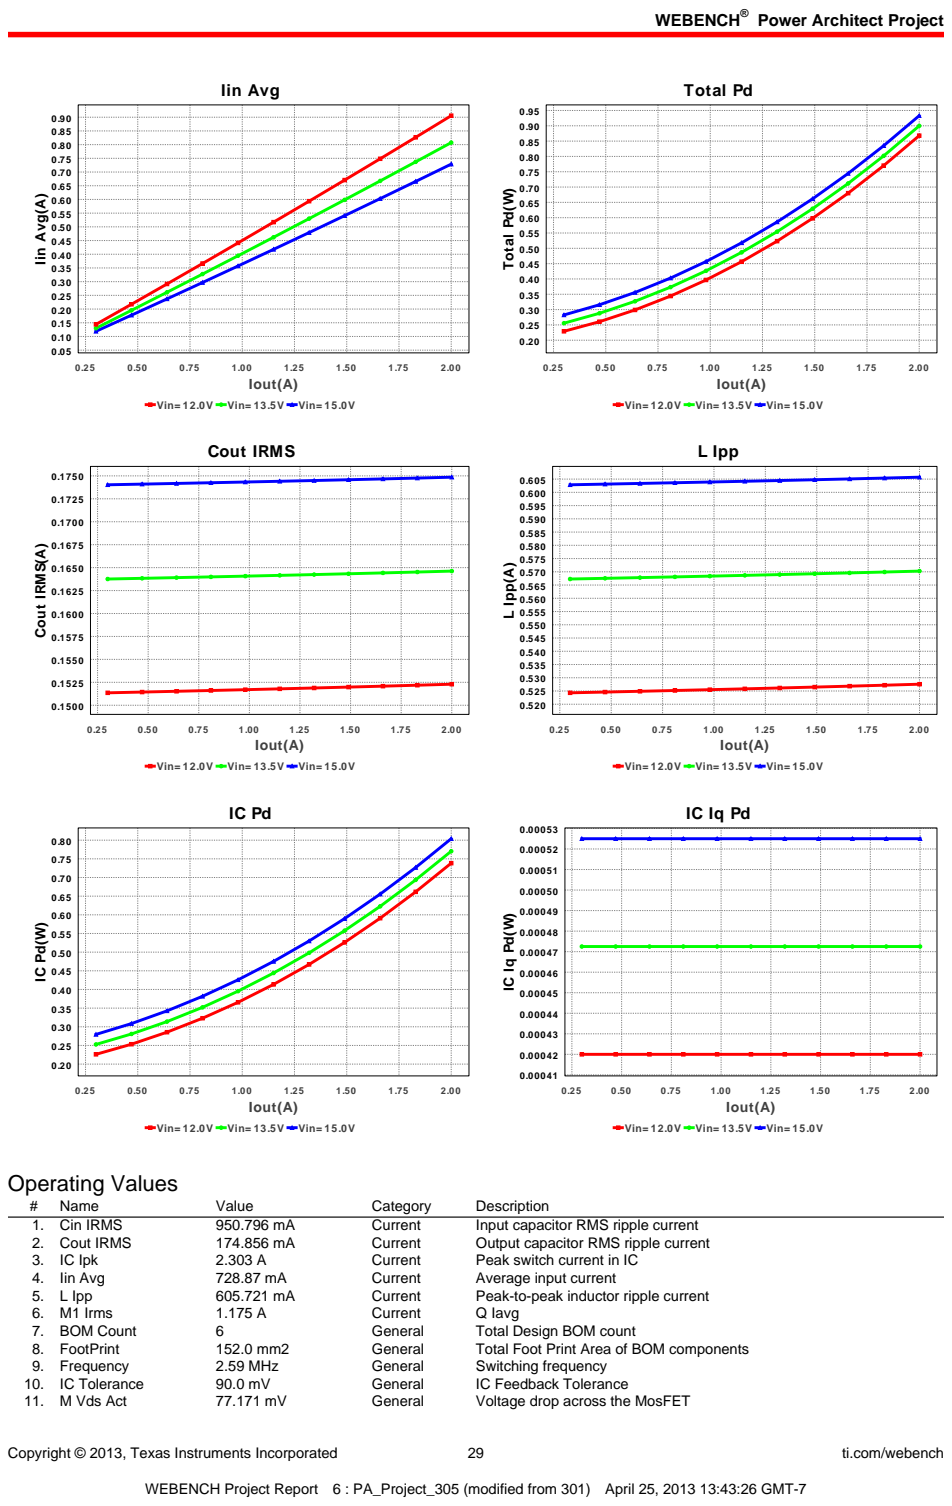
[picture p100: page 29]
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

Vin= 12.0V Vin= 13.5V Vin= 15.0V

Copyright © 2013, Texas Instruments Incorporated | 30 | ti.com/webench
# | Name | Value | Category | Description

12. Mode | CCM | General | Conduction Mode
13. Pout | 10.0 W | General | Total output power
14. Total BOM | $1.52 | General | Total BOM Cost
15. Vout OP | 5.0 V | Op_Point | Operational Output Voltage
16. Duty Cycle | 34.509 % | Op_point | Duty cycle
17. Efficiency | 91.466 % | Op_point | Steady state efficiency
18. IC Tj | 53.395 degC | Op_point | IC junction temperature
19. ICThetaJA | 29.1 degC/W | Op_point | IC junction-to-ambient thermal resistance
20. IOUT_OP | 2.0 A | Op_point | Iout operating point
21. VIN_OP | 15.0 V | Op_point | Vin operating point
22. Vout p-p | 1.899 mV | Op_point | Peak-to-peak output ripple voltage
23. Cin Pd | 3.616 mW | Power | Input capacitor power dissipation
24. Cout Pd | 0.0 W | Power | Output capacitor power dissipation
25. IC Pd | 803.942 mW | Power | IC power dissipation
26. L Pd | 125.5 mW | Power | Inductor power dissipation
27. Total Pd | 933.026 mW | Power | Total Power Dissipation

## Design Inputs

# | Name | Value | Description

1. Iout | 2.0 A | Maximum Output Current
2. Iout1 | 2.0 Amps | Output Current #1
3. VinMax | 15.0 V | Maximum input voltage
4. VinMin | 12.0 V | Minimum input voltage
5. Vout | 5.0 V | Output Voltage
6. Vout1 | 5.0 Volt | Output Voltage #1
7. base_pn | TPS62143 | National Based Product Number
8. source | DC | Input Source Type
9. Ta | 30.0 degC | Ambient temperature

## Design Assistance

1. Feature Highlights: DCS-Control(TM) Architecture with upto 2A output current, 3V to 17V Input Voltage Range, 5.0V Fixed Output voltageSelectable operating frequency, Optional Softstart Capacitor for slow startup, Tracking,Pin selectable output voltage (nominal, +5%) Seamless Power Save Mode for Light Load Efficiency, Power Good Output, 100% Duty Cycle mode, Short Circuit Protection, Thermal Shutdown
2. TPS62143 Product Folder : http://www.ti.com/product/tps62143 : contains the data sheet and other resources.

## WEBENCH ® Design Report

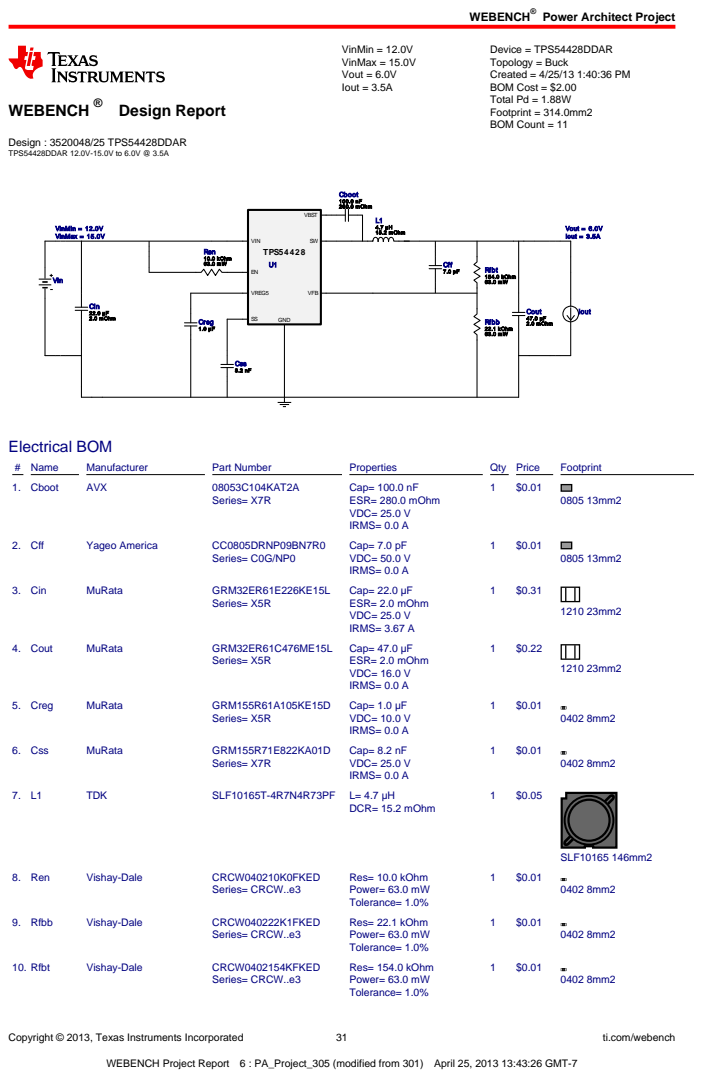
[picture p101: page 31]
Copyright © 2013, Texas Instruments Incorporated; ti.com/webench; Design : 3520048/25 TPS54428DDAR TPS54428DDAR 12.0V-15.0V to 6.0V @ 3.5A; VinMin = 12.0V VinMax = 15.0V Vout = 6.0V Iout = 3.5A; Device = TPS54428DDAR Topology = Buck Created = 4/25/13 1:40:36 PM BOM Cost = $2.00 Total Pd = 1.88W Footprint = 314.0mm2 BOM Count = 11; Cff 7.0 pF; Cboot 100.0 nF 280.0 mOhm; Cin 22.0 µF 2.0 mOhm; Cout; 47.0 µF Creg; 2.0 mOhm; Css 8.2 nF; L1 4.7 µH 15.2 mOhm; Ren 10.0 kOhm 63.0 mW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

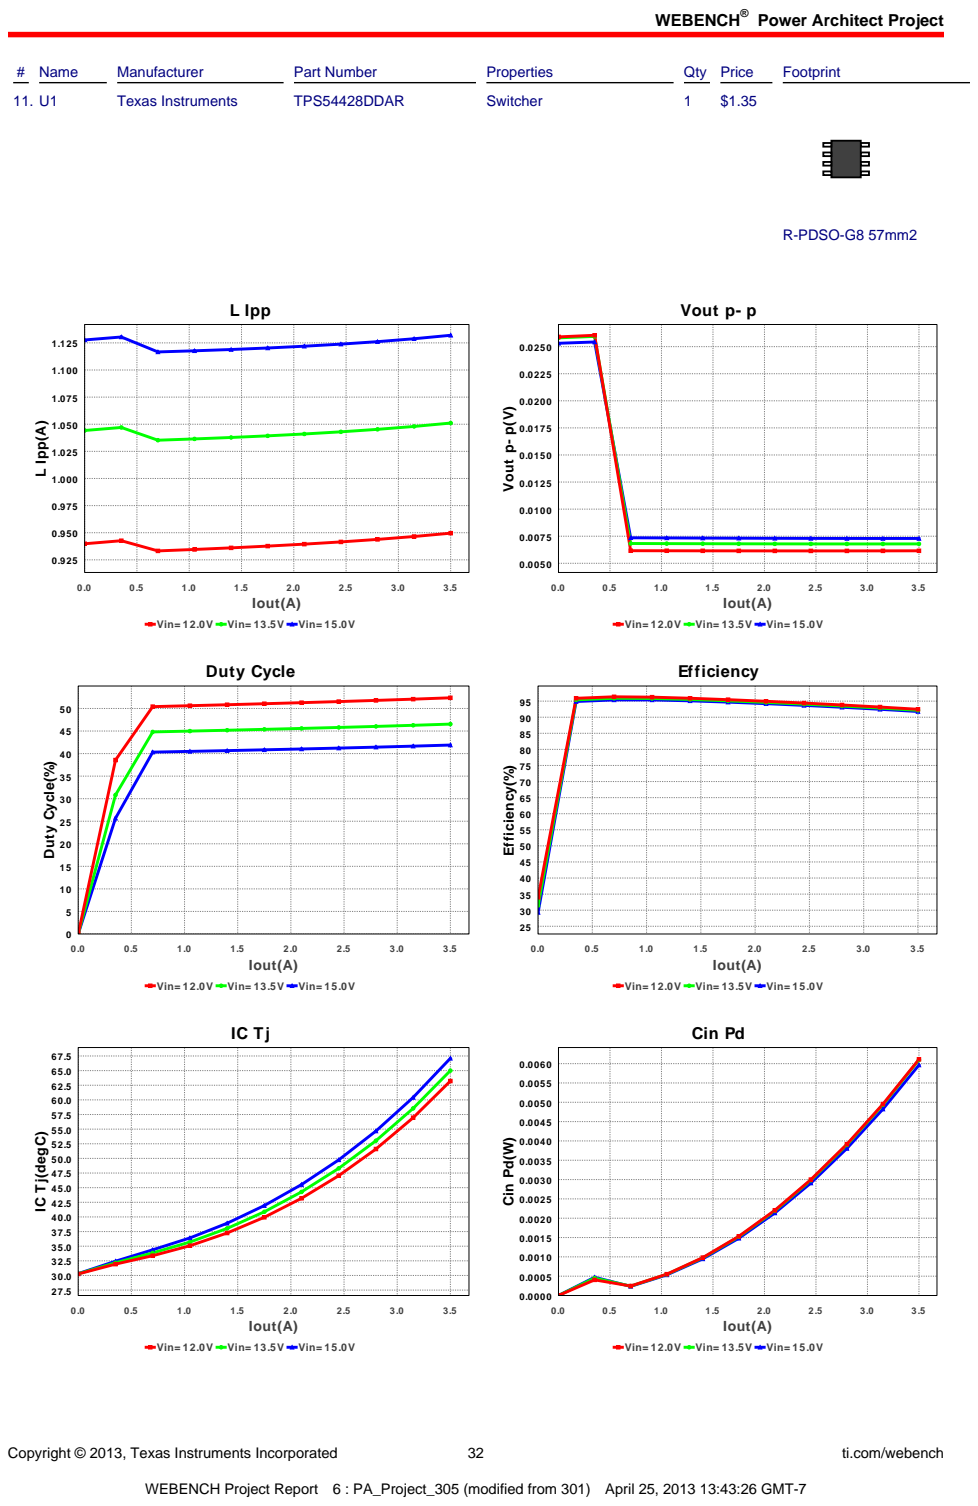
[picture p102: page 32]
Copyright © 2013, Texas Instruments Incorporated; ti.com/webench; # Name; Manufacturer; Part Number; Properties; Qty Price; Footprint; Texas Instruments; TPS54428DDAR; Switcher; R-PDSO-G8 57mm2; L Ipp; Iout(A); L Ipp(A); Vout p- p; Vout p- p(V); Duty Cycle; Duty Cycle(%); Efficiency; Efficiency(%); Cin Pd; Cin Pd(W)

Vin= 12.0V Vin= 13.5V Vin= 15.0V

IC Tj(degC)

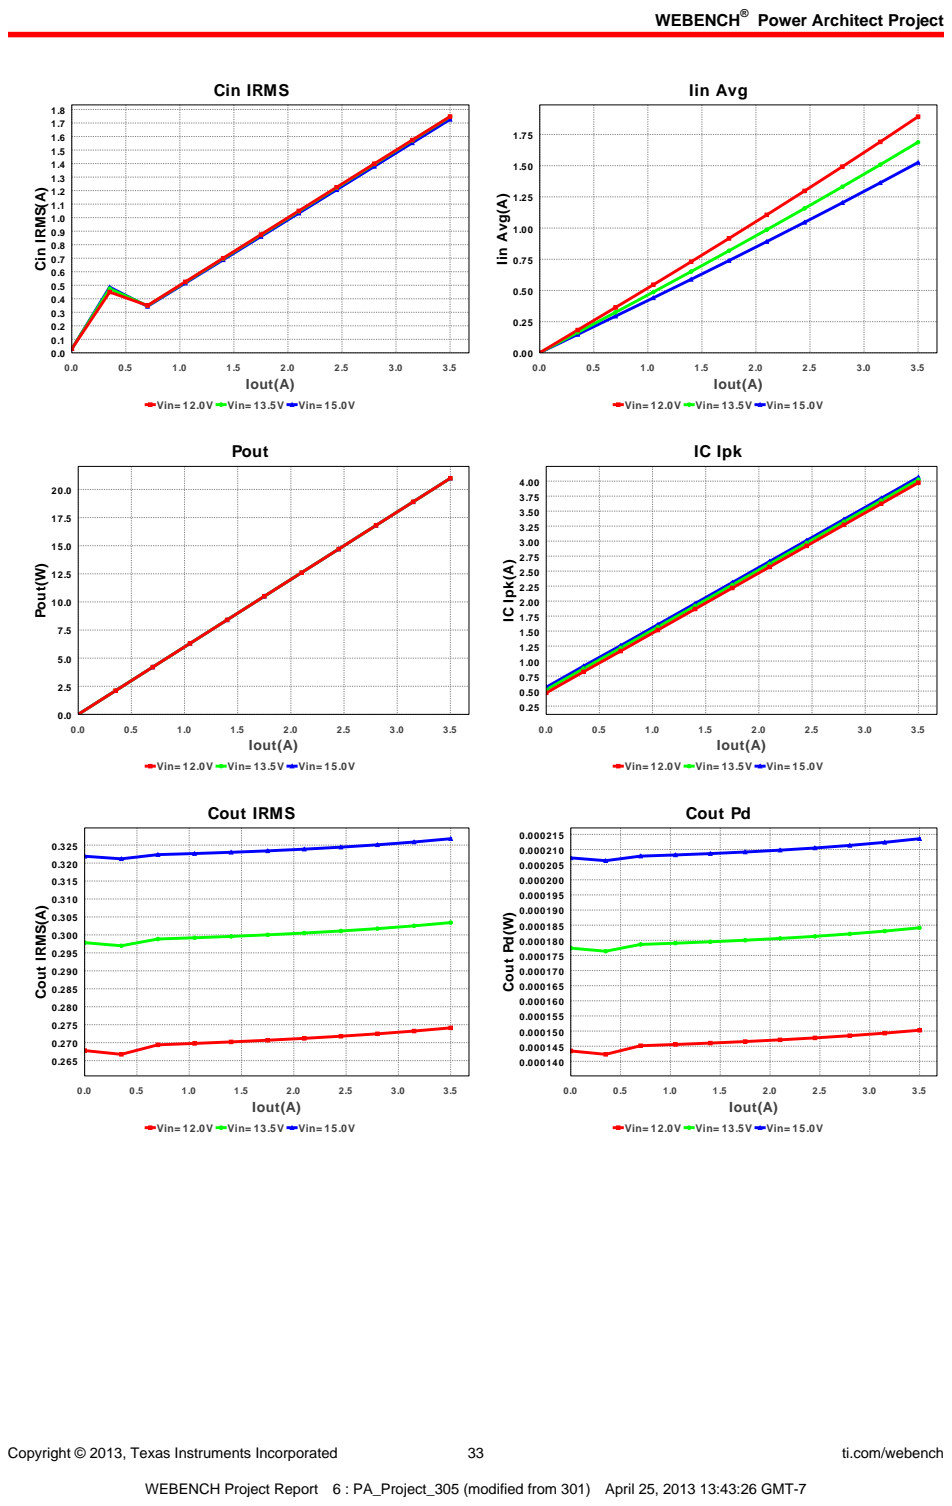
[picture p103: page 33]
Copyright © 2013, Texas Instruments Incorporated; ti.com/webench; Cin IRMS; Iout(A); Cin IRMS(A); Iin Avg; Iin Avg(A); Pout; Pout(W); IC Ipk; IC Ipk(A); Cout IRMS; Cout IRMS(A); Cout Pd; Cout Pd(W)

Vin= 12.0V Vin= 13.5V Vin= 15.0V

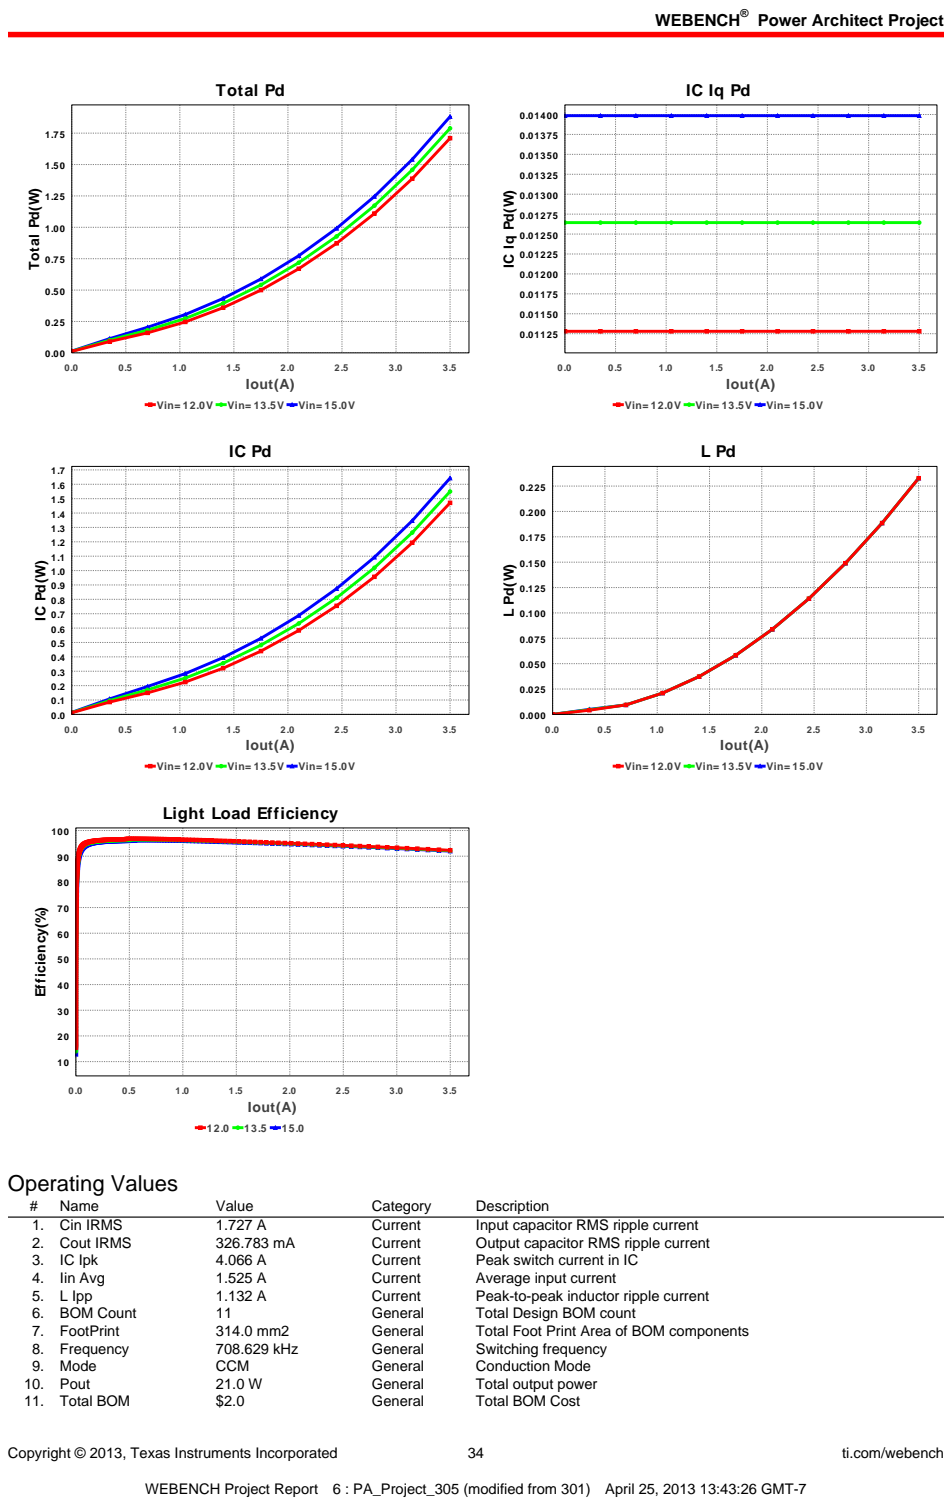
[picture p104: page 34]
Copyright © 2013, Texas Instruments Incorporated; ti.com/webench; Total Pd; Iout(A); Total Pd(W); Efficiency(%); Operating Values; Name; Value; Category; Description; 1. Cin IRMS; Current; Input capacitor RMS ripple current; 2. Cout IRMS; Output capacitor RMS ripple current; 3. IC Ipk; Peak switch current in IC; 4. Iin Avg; Average input current; 5. L Ipp; Peak-to-peak inductor ripple current; 6. BOM Count; General; Total Design BOM count; 7. FootPrint; Total Foot Print Area of BOM components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

Vin= 12.0V Vin= 13.5V Vin= 15.0V

Light Load Efficiency

Copyright © 2013, Texas Instruments Incorporated | 35 | ti.com/webench
# | Name | Value | Category | Description

12. Vout OP | 6.0 V | Op_Point | Operational Output Voltage
13. Duty Cycle | 41.891 % | Op_point | Duty cycle
14. Efficiency | 91.777 % | Op_point | Steady state efficiency
15. IC Tj | 67.102 degC | Op_point | IC junction temperature
16. ICThetaJA | 45.3 degC/W | Op_point | IC junction-to-ambient thermal resistance
17. IOUT_OP | 3.5 A | Op_point | Iout operating point
18. VIN_OP | 15.0 V | Op_point | Vin operating point
19. Vout p-p | 7.293 mV | Op_point | Peak-to-peak output ripple voltage
20. Cin Pd | 5.964 mW | Power | Input capacitor power dissipation
21. Cout Pd | 213.574 µW | Power | Output capacitor power dissipation
22. IC Iq Pd | 13.985 mW | Power | IC Iq Pd
23. IC Pd | 1.643 W | Power | IC power dissipation
24. L Pd | 232.75 mW | Power | Inductor power dissipation
25. Total Pd | 1.882 W | Power | Total Power Dissipation

## Design Inputs

# | Name | Value | Description

1. Iout | 3.5 A | Maximum Output Current
2. Iout1 | 3.5 Amps | Output Current #1
3. VinMax | 15.0 V | Maximum input voltage
4. VinMin | 12.0 V | Minimum input voltage
5. Vout | 6.0 V | Output Voltage
6. Vout1 | 6.0 Volt | Output Voltage #1
7. base_pn | TPS54428 | National Based Product Number
8. source | DC | Input Source Type
9. Ta | 30.0 degC | Ambient temperature

## Design Assistance

1. TPS54428 Product Folder : http://www.ti.com/product/tps54428 : contains the data sheet and other resources.

Texas Instruments' WEBENCH simulation tools attempt to recreate the performance of a substantially equivalent physical implementation
of the design. Simulations are created using Texas Instruments' published specifications as well as the published specifications of other device manufacturers. While Texas Instruments does update this information periodically, this information may not be current at the time the simulation is built. Texas Instruments does not warrant the accuracy or completeness of the specifications or any information contained therein. Texas Instruments does not warrant that any designs or recommended parts will meet the specifications you entered, will be suitable for your application or fit for any particular purpose, or will operate as shown in the simulation in a physical implementation. Texas Instruments does not warrant that the designs are production worthy.
You should completely validate and test your design implementation to confirm the system functionality for your application prior to production.
Use of Texas Instruments' WEBENCH simulation tools is subject to Texas Instruments' Site Terms and Conditions of Use. (http://www.ti.com/corp/docs/legal/termsofuse.shtml) Prototype boards based on WEBENCH created designs are provided AS IS without warranty of any kind for evaluation and testing purposes and are subject to the terms of the Evaluation License Agreement. (http://www.ti.com/corp/docs/legal/termsofuse_estore.shtml)
