saltscapstone/capstone/robot_board/robot.pdf

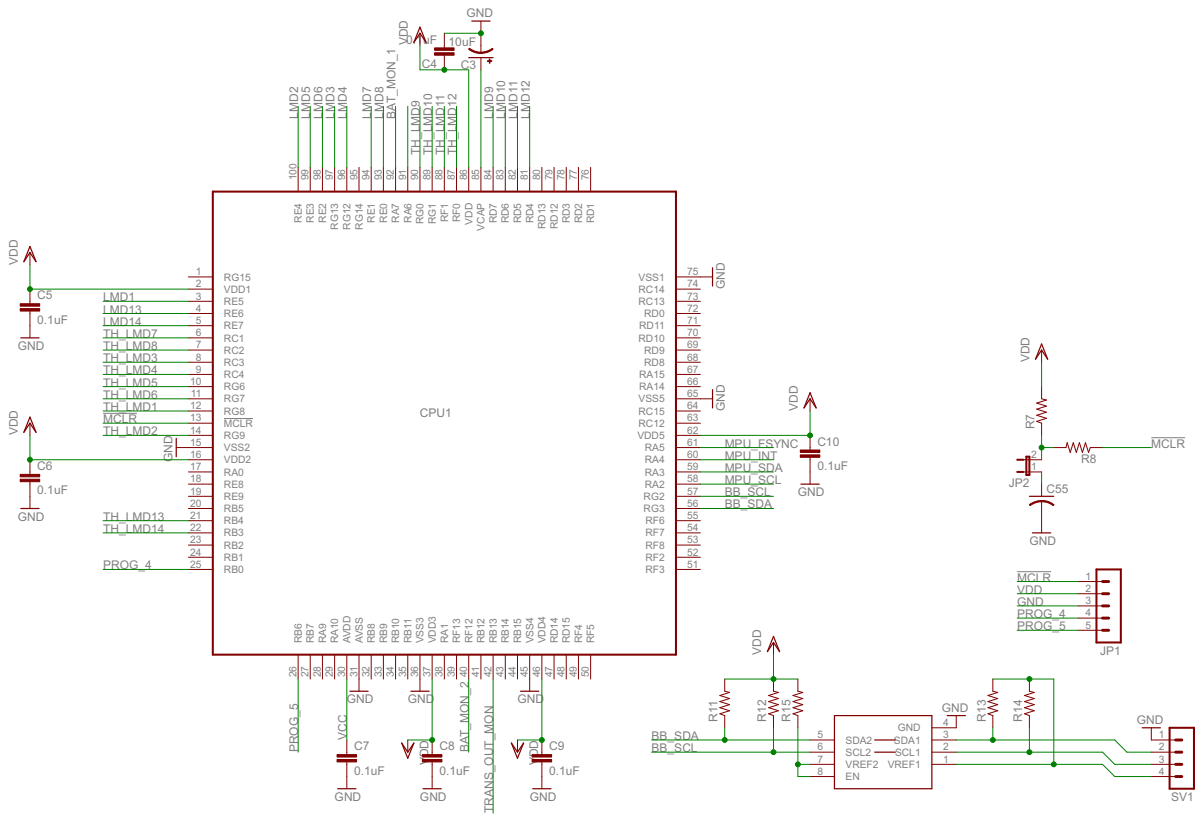
[picture p105: page 1]

GND GND GND GND GND GND 10uFGND 0.1uF 0.1uF 0.1uF 0.1uF 0.1uF 0.1uF 0.1uF GND GND GND GND GND GND VDD VDD VDD VDD VDD VDD VDD GND VDD GND GND CPU1 RG15 1 VDD1 2 RE5 3 RE6 4 RE7 5 RC1 6 RC2 7 RC3 8 RC4 9 RG6 10 RG7 11 RG8 12 MCLR 13 RG9 14 VSS2 15 VDD2 16 RA0 17 RE8 18 RE9 19 RB5 20 RB4 21 RB3 22 RB2 23 RB1 24 RB0 25 RB6 26 RB7 27 RA9 28 RA10 29 AVDD 30 AVSS 31 RB8 32 RB9 33 RB10 34 RB11 35 VSS3 36 VDD3 37 RA1 38 RF13 39 RF12 40 RB12 41 RB13 42 RB14 43 RB15 44 VSS4 45 VDD4 46 RD14 47 RD15 48 RF4 49 RF5 50 RF3 51 RF2 52 RF8 53 RF7 54 RF6 55 RG3 56 RG2 57 RA2 58 RA3 59 RA4 60 RA5 61 VDD5 62 RC12 63 RC15 64 VSS5 65 RA14 66 RA15 67 RD8 68 RD9 69 RD10 70 RD11 71 RD0 72 RC13 73 RC14 74 VSS1 75 RD1 76 RD2 77 RD3 78 RD12 79 RD13 80 RD4 81 RD5 82 RD6 83 RD7 84 VCAP 85 VDD 86 RF0 87 RF1 88 RG1 89 RG0 90 RA6 91 RA7 92 RE0 93 RE1 94 RG14 95 RG12 96 RG13 97 RE2 98 RE3 99 RE4 100 C4 C3 C5C6 C7 C8 C9 C10 JP1 12345 JP2 12R7 R8 C55 SDA1 3 SCL1 2 EN 8 VREF1 1 VREF2 7 SCL2 6 SDA2 5 GND 4 R11 R12 R13 R14 R15 SV1 1234 GND VDD VCC LMD1 MCLR MCLR MCLR PROG_4 PROG_4 PROG_5 PROG_5 BB_SCL BB_SCL BB_SDA BB_SDA LMD12 LMD11 LMD10 LMD9 LMD8 LMD7 LMD2 LMD13 LMD14 TRANS_OUT_MON MPU_INT MPU_FSYNC MPU_SCL MPU_SDA BAT_MON_2 TH_LMD12 TH_LMD9 BAT_MON_1 TH_LMD11 TH_LMD10 LMD3 LMD4 LMD6 LMD5 TH_LMD3 TH_LMD4 TH_LMD5 TH_LMD6 TH_LMD13 TH_LMD14 TH_LMD2 TH_LMD1 TH_LMD7 TH_LMD8

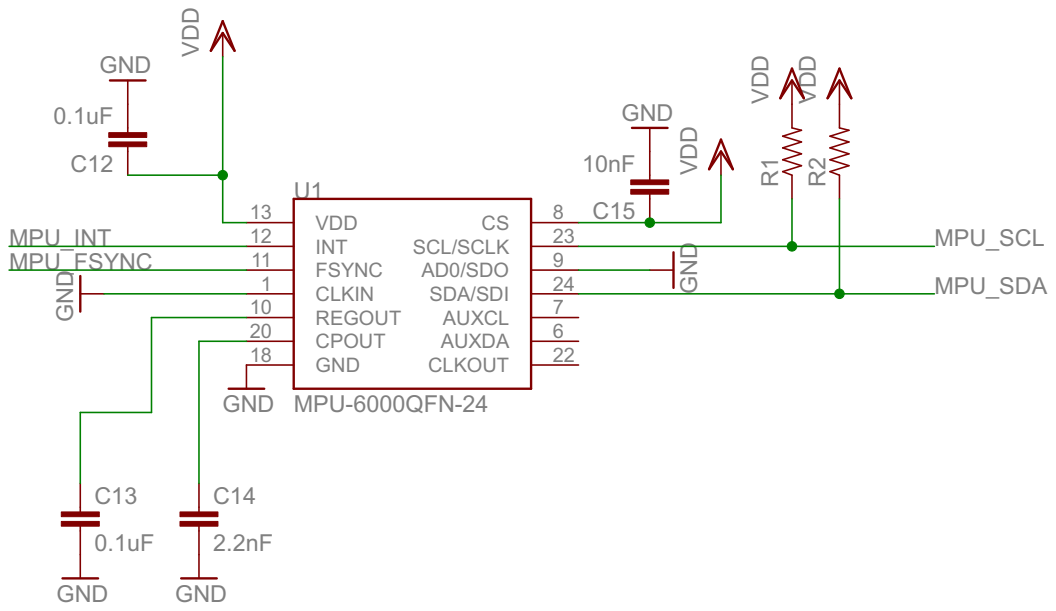
[picture p106: page 2]

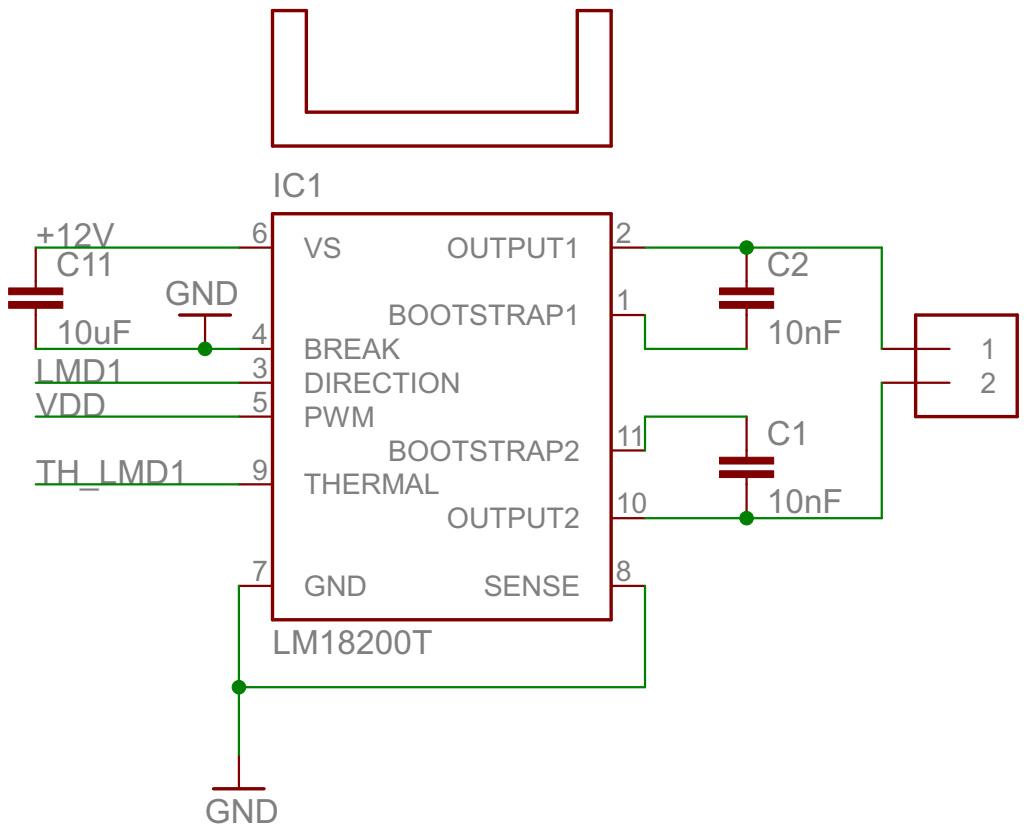
[picture p107: page 3]

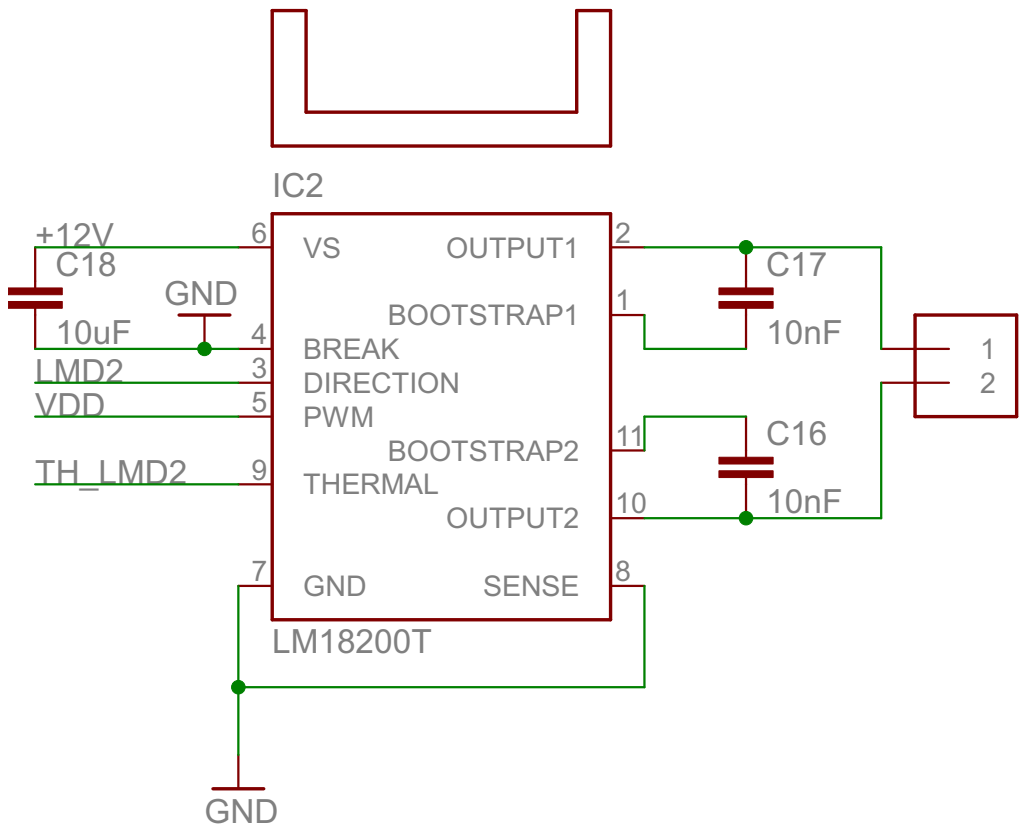
[picture p108: page 4]

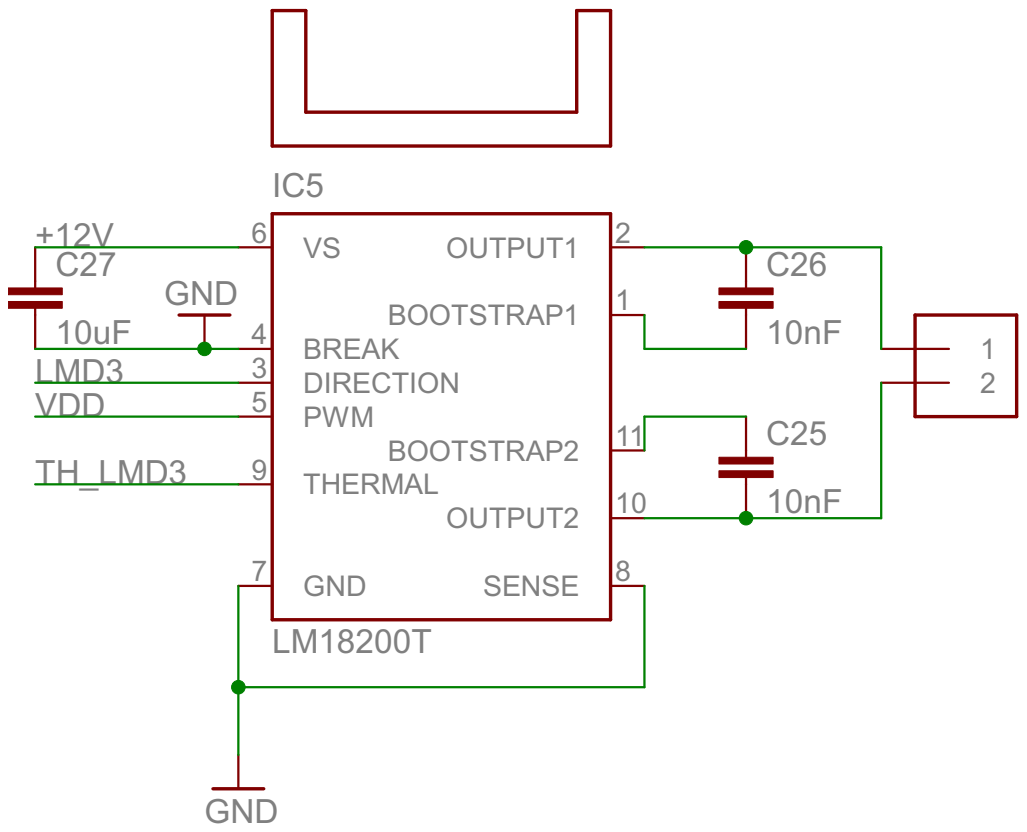
[picture p109: page 5]

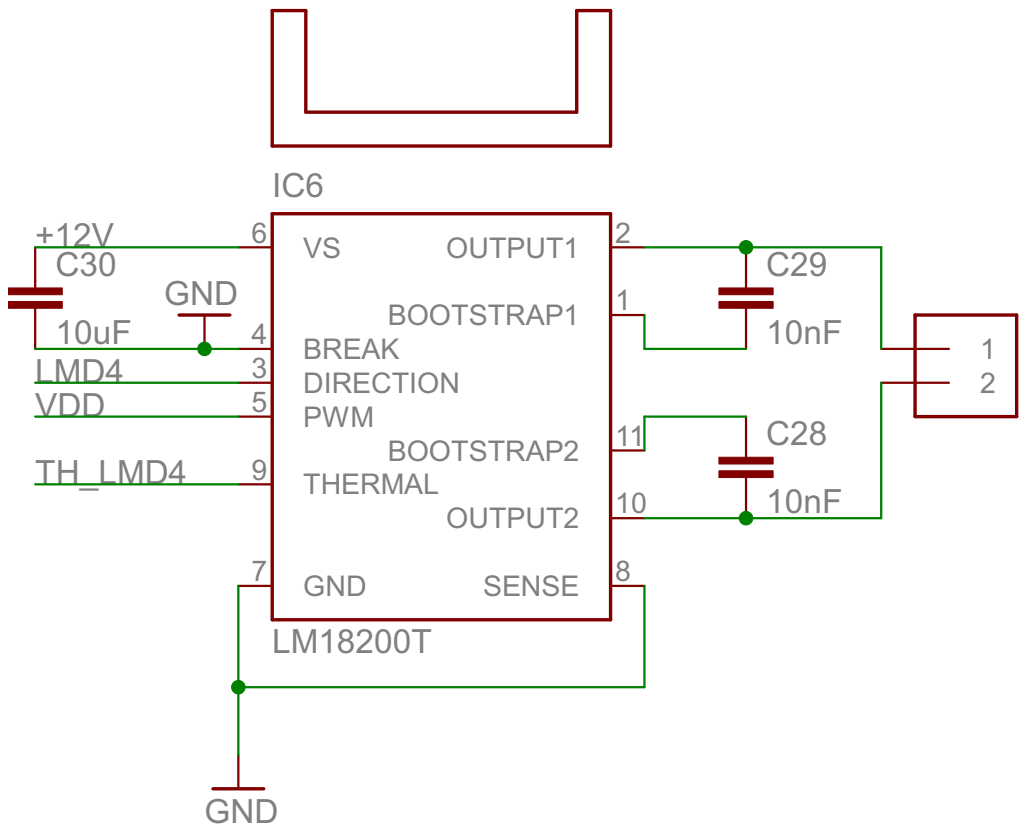
[picture p110: page 6]

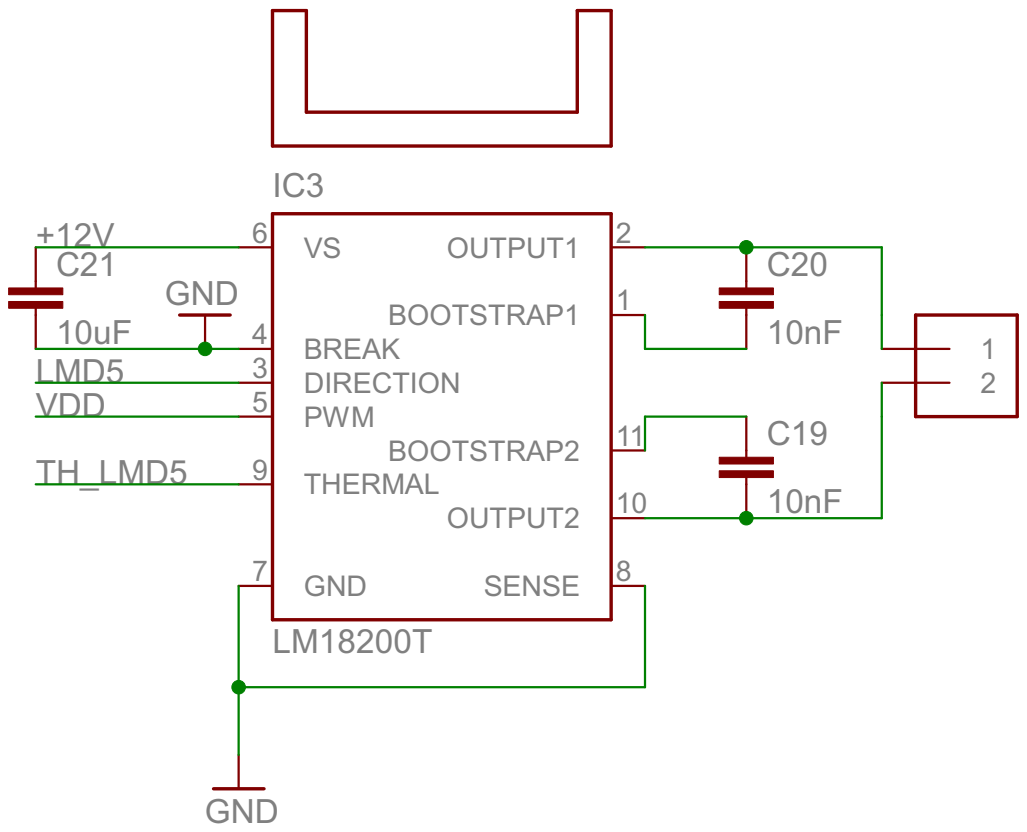
[picture p111: page 7]

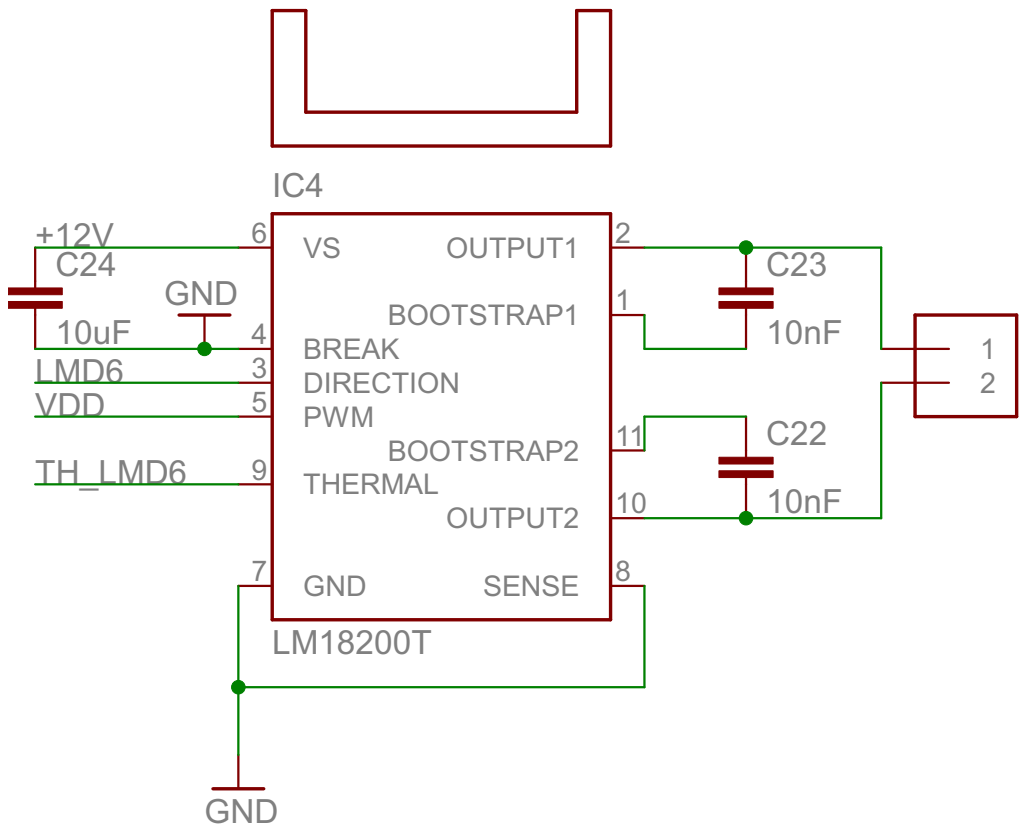
[picture p112: page 8]

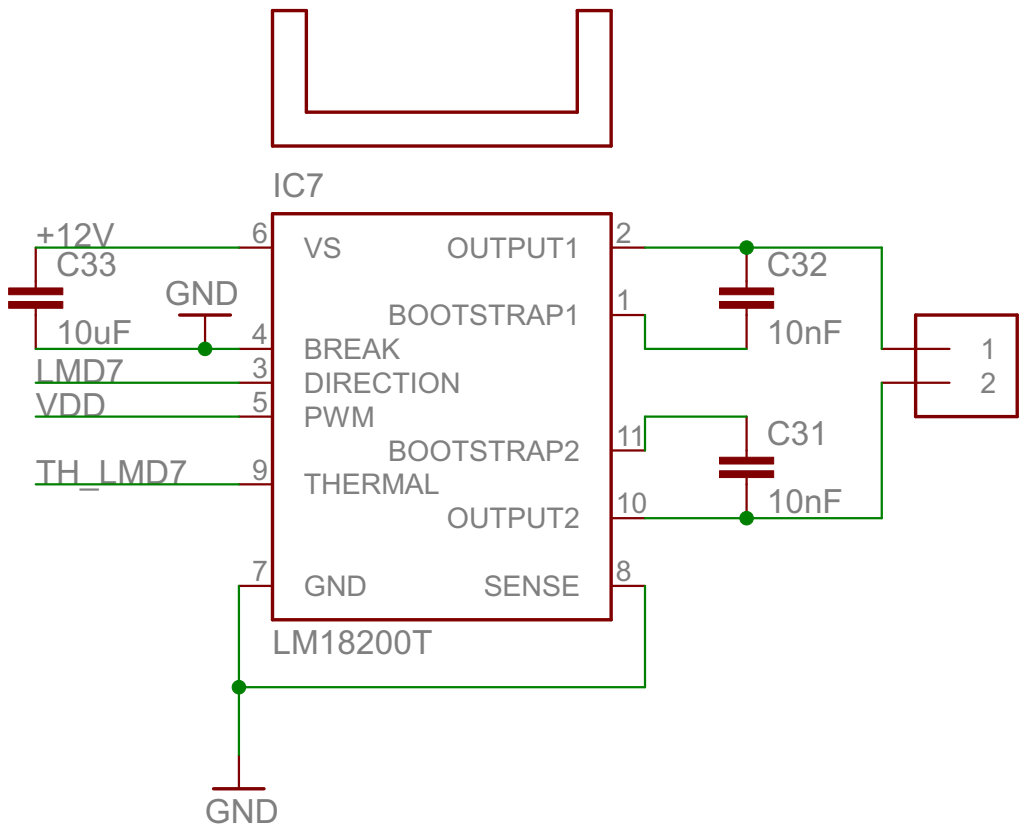
[picture p113: page 9]

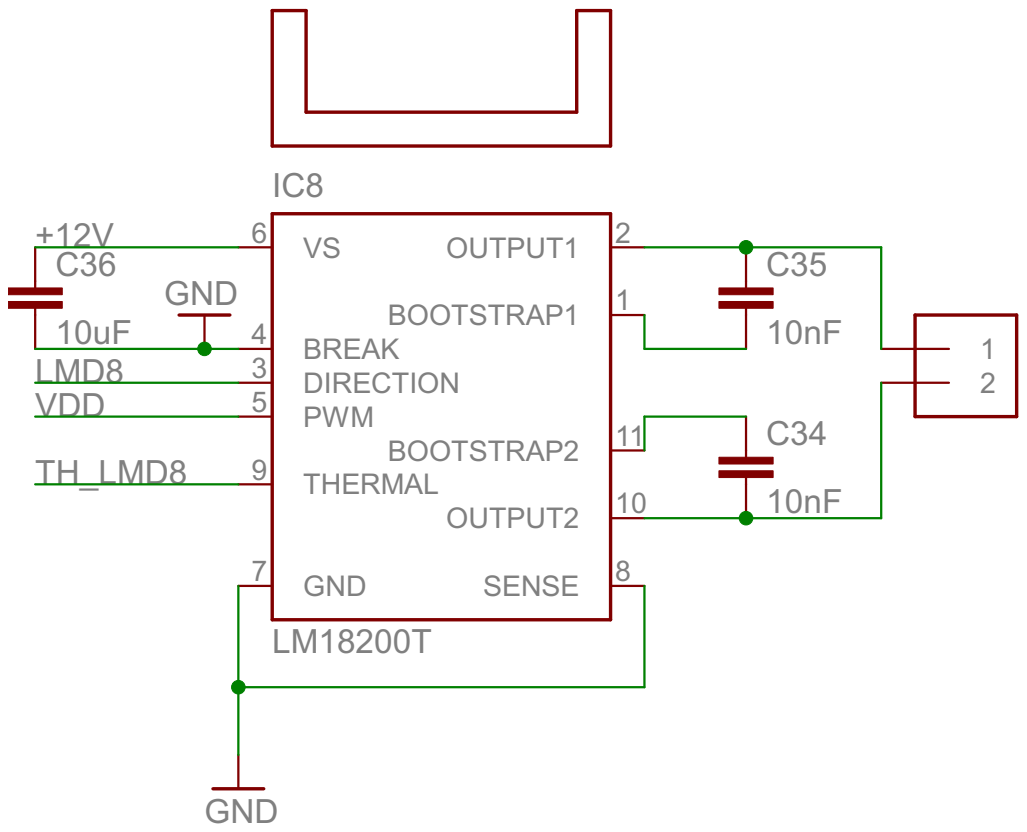
[picture p114: page 10]

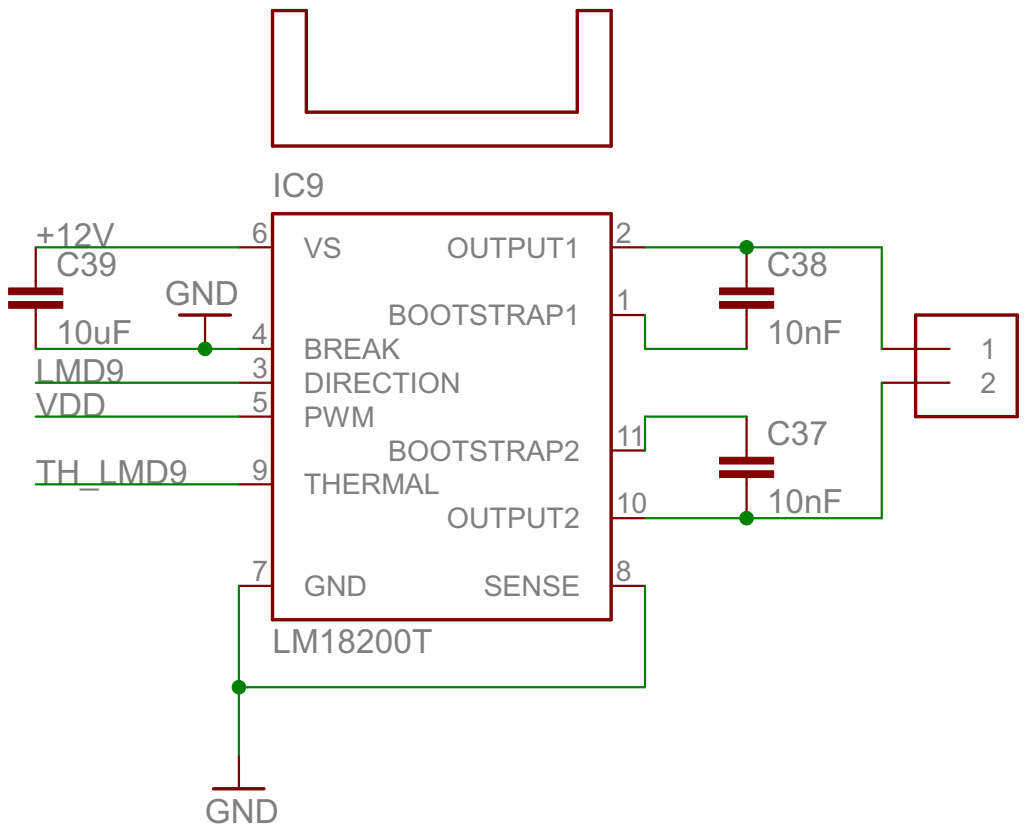
[picture p115: page 11]

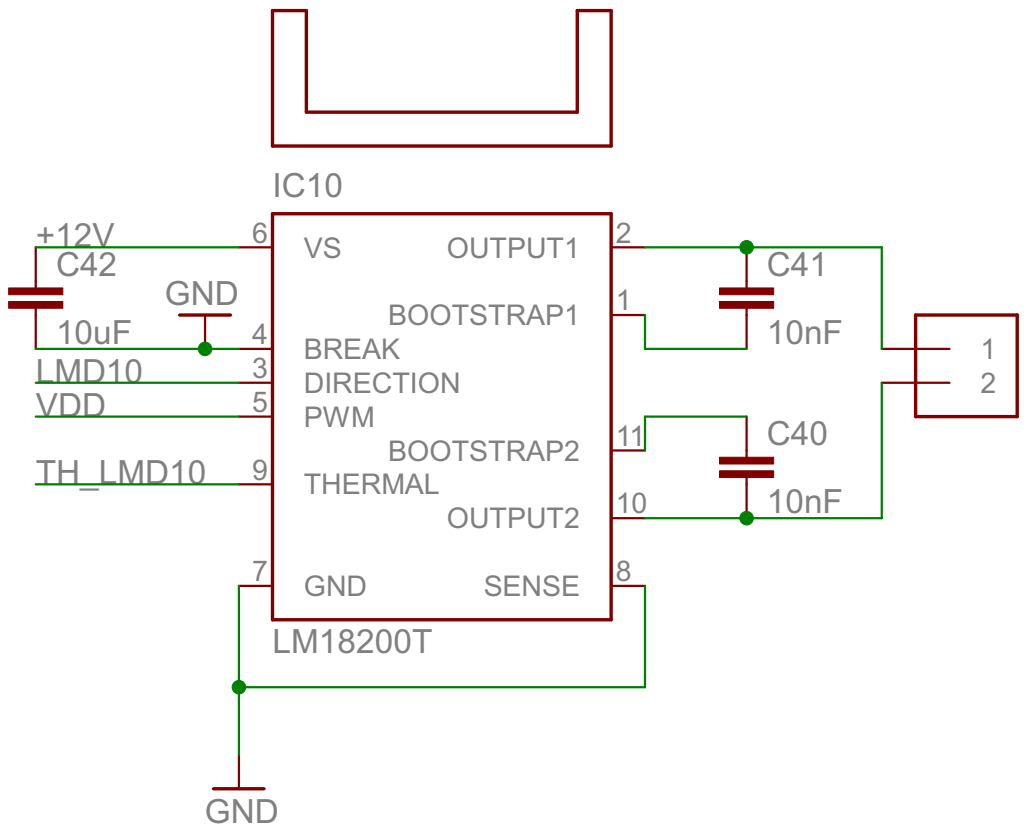
[picture p116: page 12]

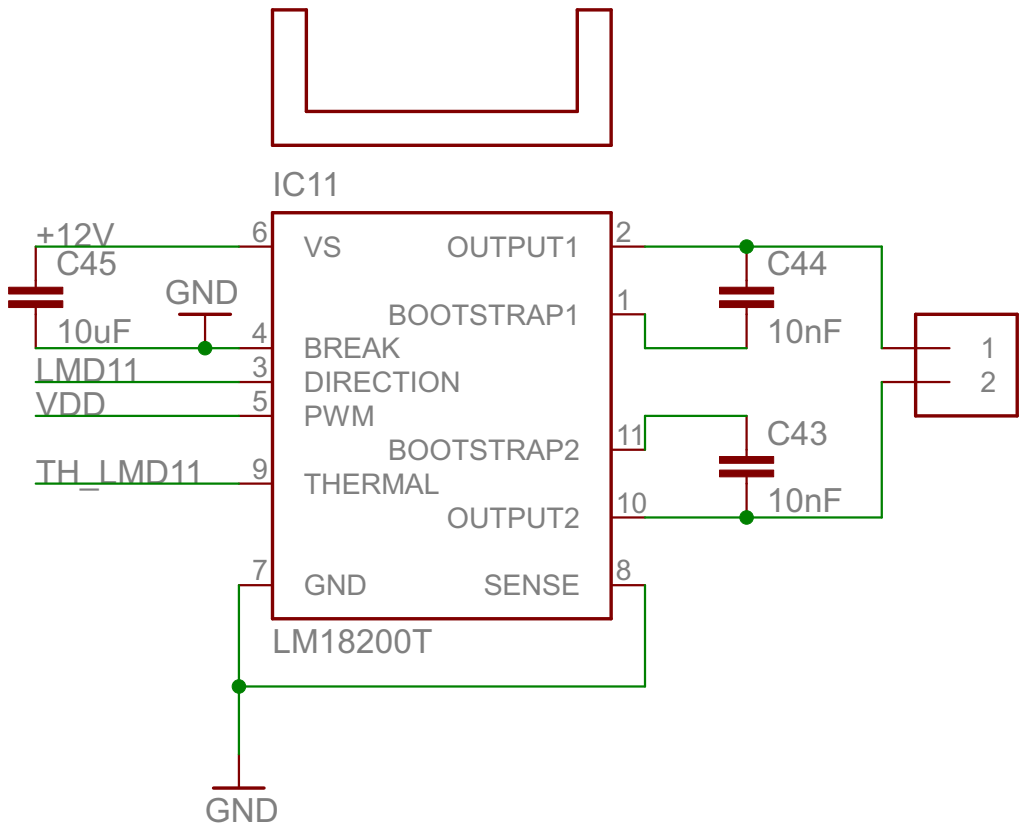
[picture p117: page 13]

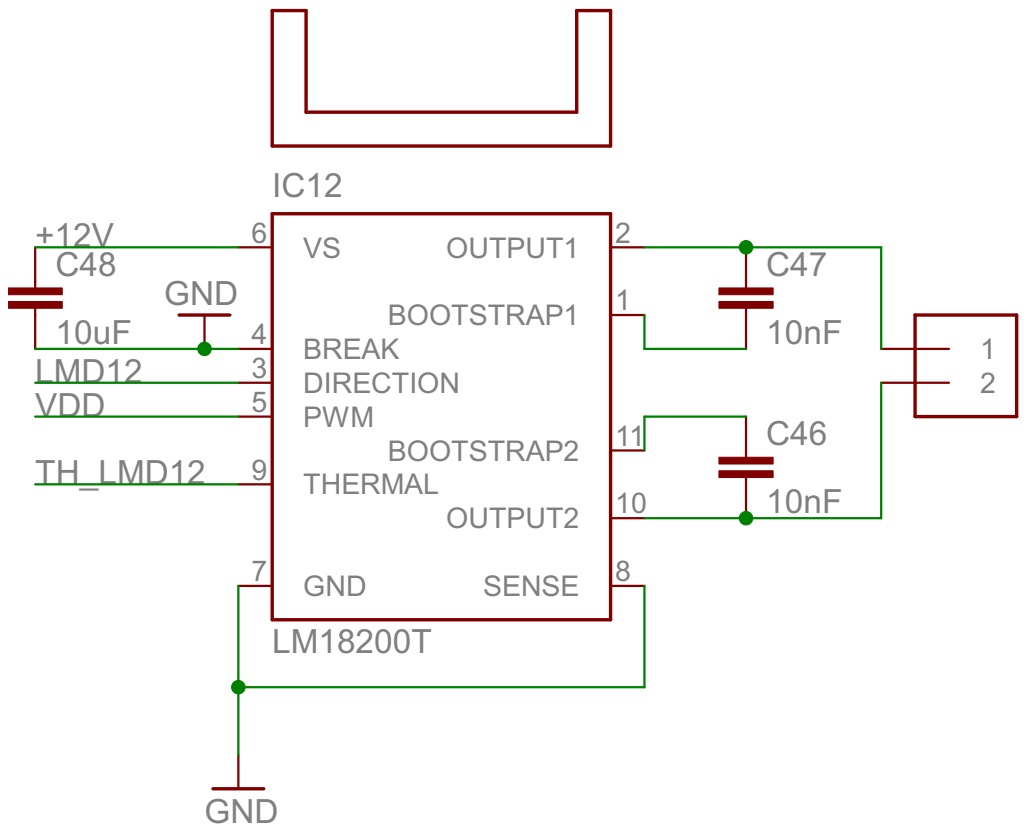
[picture p118: page 14]

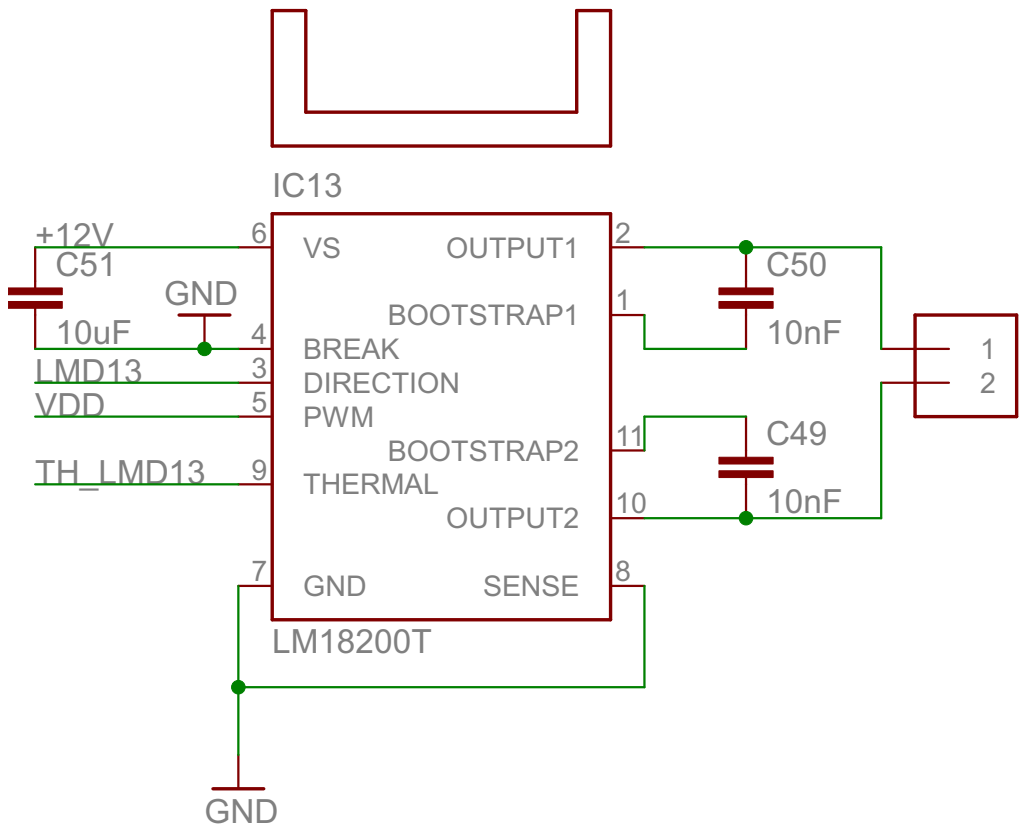
[picture p119: page 15]

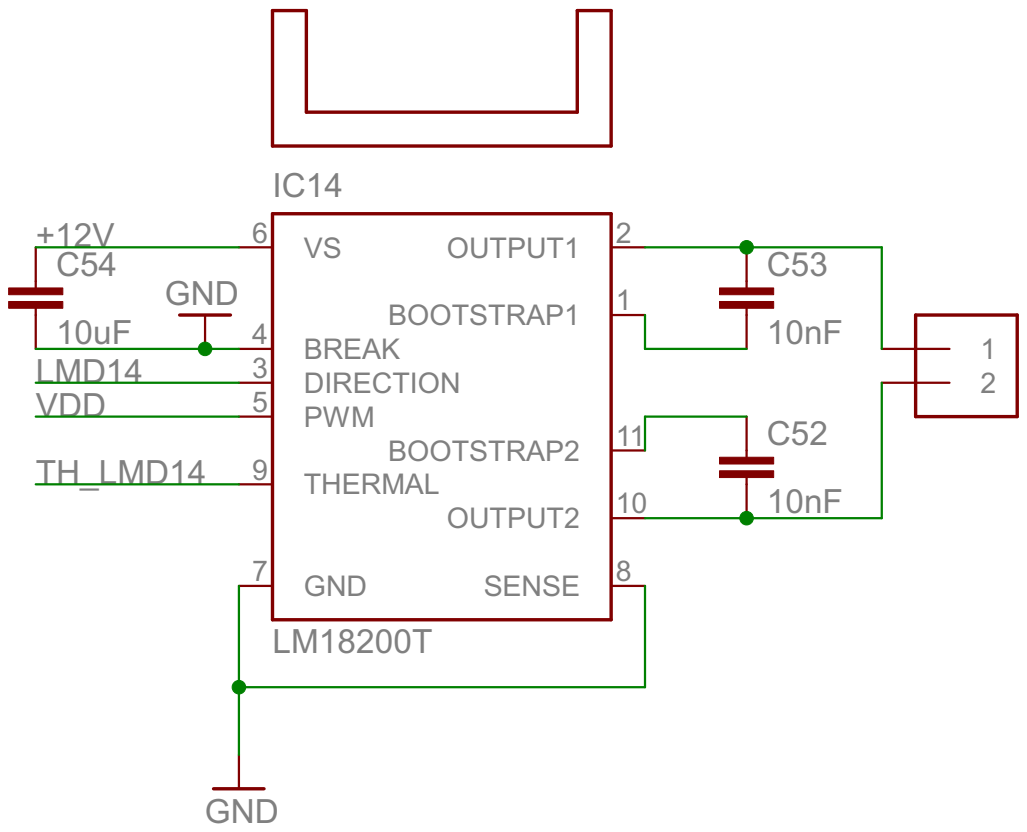
[picture p120: page 16]

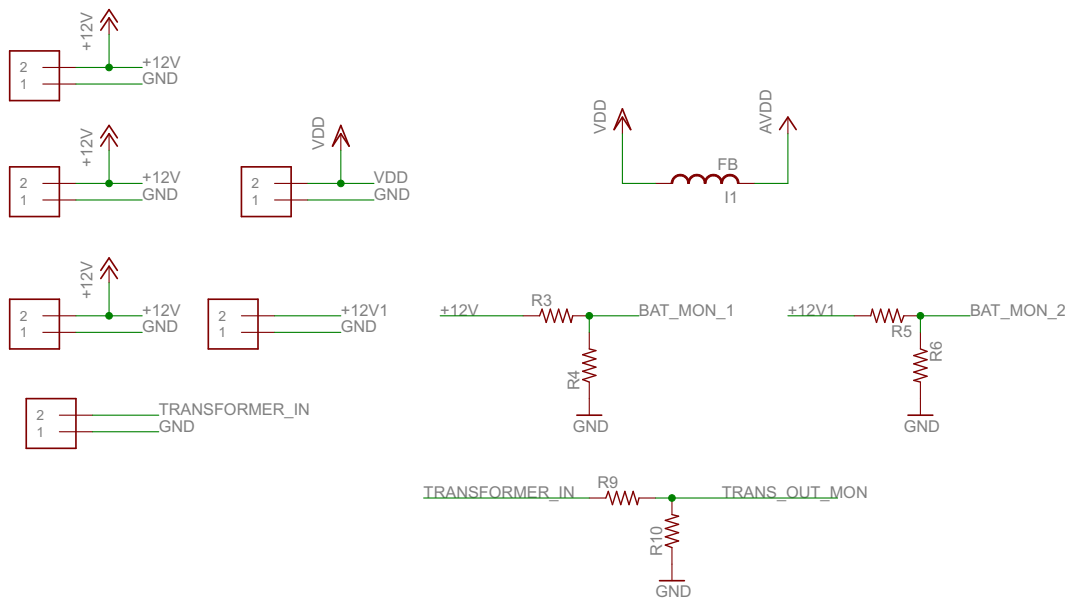
[picture p121: page 17]
