saltscapstone/capstone/robot_final/Drawings/RenumberedDrawings/10.pdf

## VIEW A-A SCALE 1 : 2

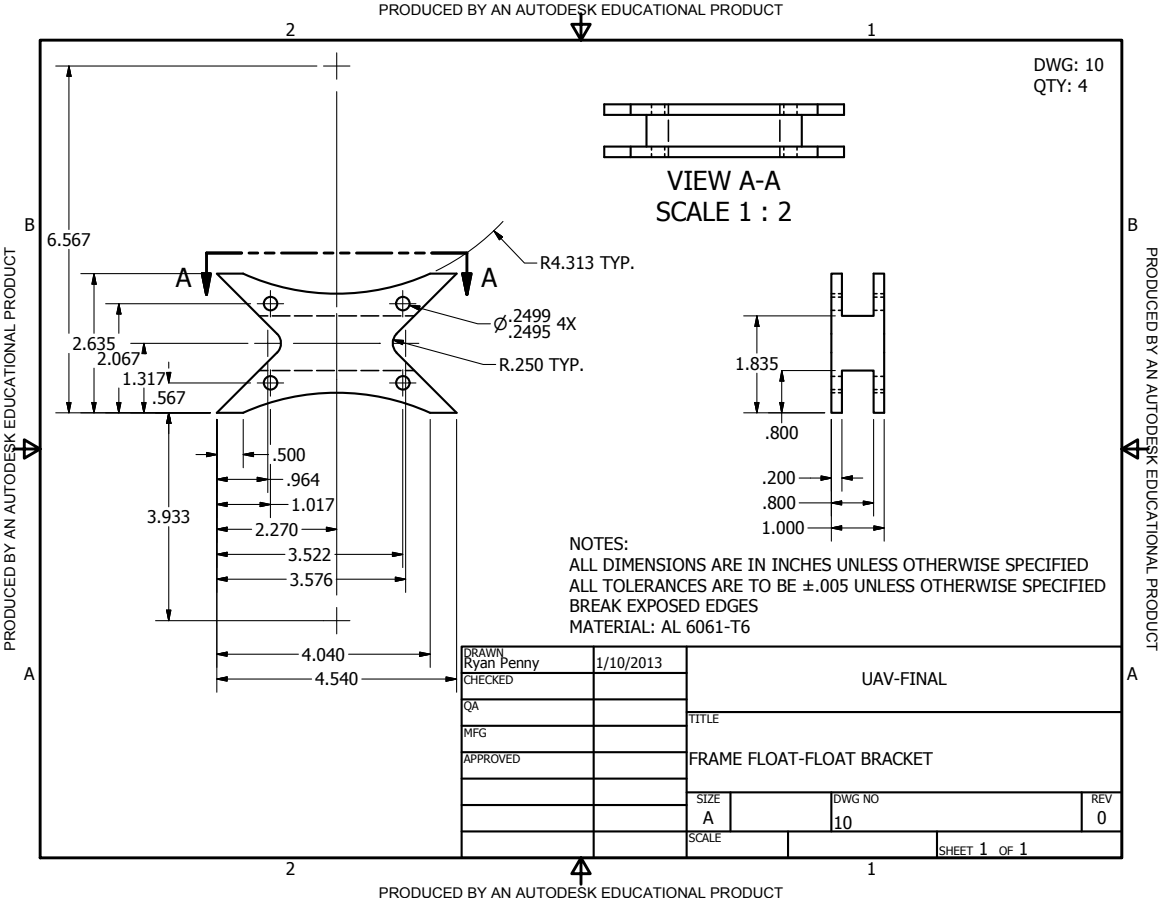
[picture p122: page 1]
TIO; A U T O D E S K E D U C A TIO; DRAWN Ryan Penny; CHECKED; MFG; APPROVED; UAV-FINAL; TITLE; SIZE A; SCALE; DWG NO 10; REV 0; SHEET 1 OF 1; R4.313 TYP.; R.250 TYP.; DWG: 10 QTY: 4

PRODUCED BY AN AUTODESK EDUCATIONAL PRODUCT

NOTES:
ALL DIMENSIONS ARE IN INCHES UNLESS OTHERWISE SPECIFIED
ALL TOLERANCES ARE TO BE ±.005 UNLESS OTHERWISE SPECIFIED
BREAK EXPOSED EDGES
MATERIAL: AL 6061-T6

FRAME FLOAT-FLOAT BRACKET
