saltscapstone/capstone/robot_final/Drawings/RenumberedDrawings/11.pdf

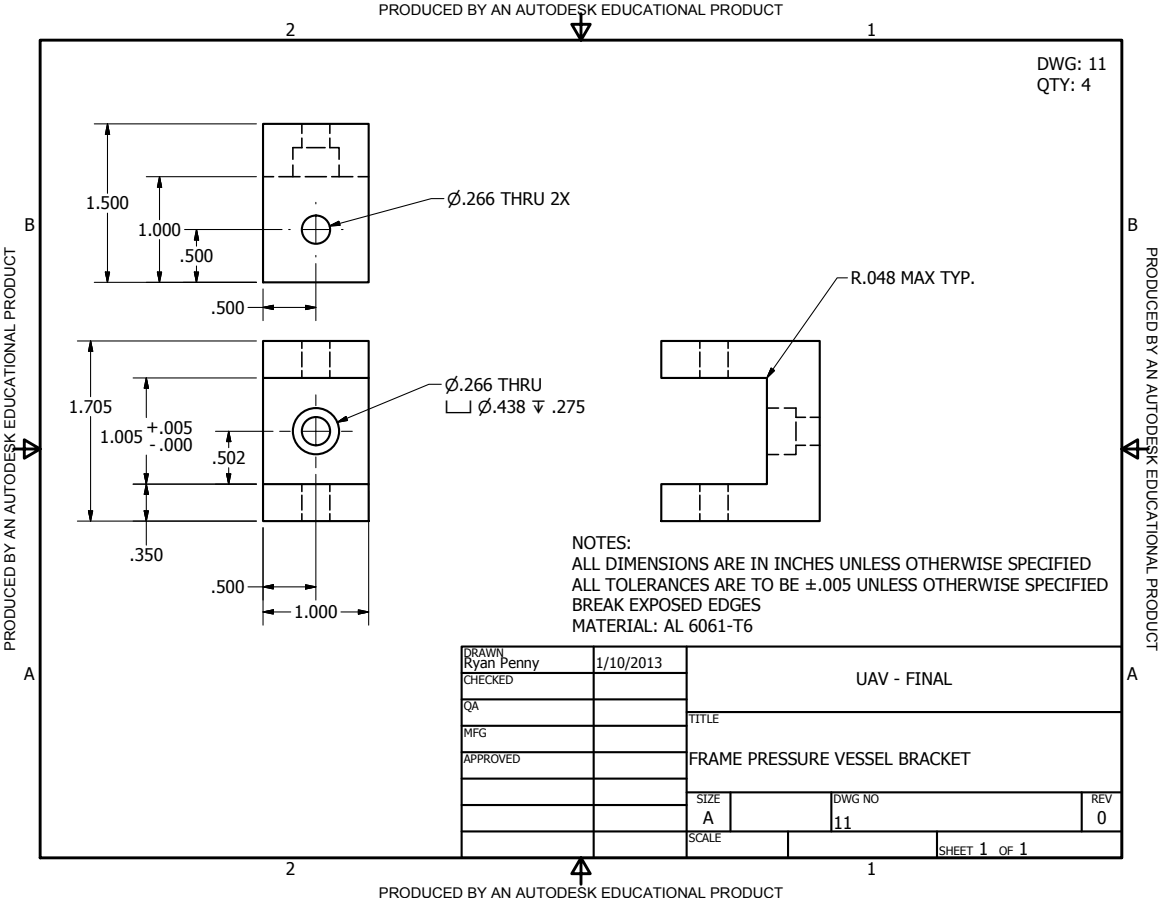
[picture p123: page 1]
TIO; A U T O D E S K E D U C A TIO; DRAWN Ryan Penny; CHECKED; MFG; APPROVED; UAV - FINAL; TITLE; SIZE A; SCALE; DWG NO 11; REV 0; SHEET 1 OF 1; P.266 THRU X P.438 Z .275; P.266 THRU 2X; R.048 MAX TYP.; DWG: 11 QTY: 4

PRODUCED BY AN AUTODESK EDUCATIONAL PRODUCT

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

FRAME PRESSURE VESSEL BRACKET
