saltscapstone/capstone/robot_final/Drawings/RenumberedDrawings/12.pdf

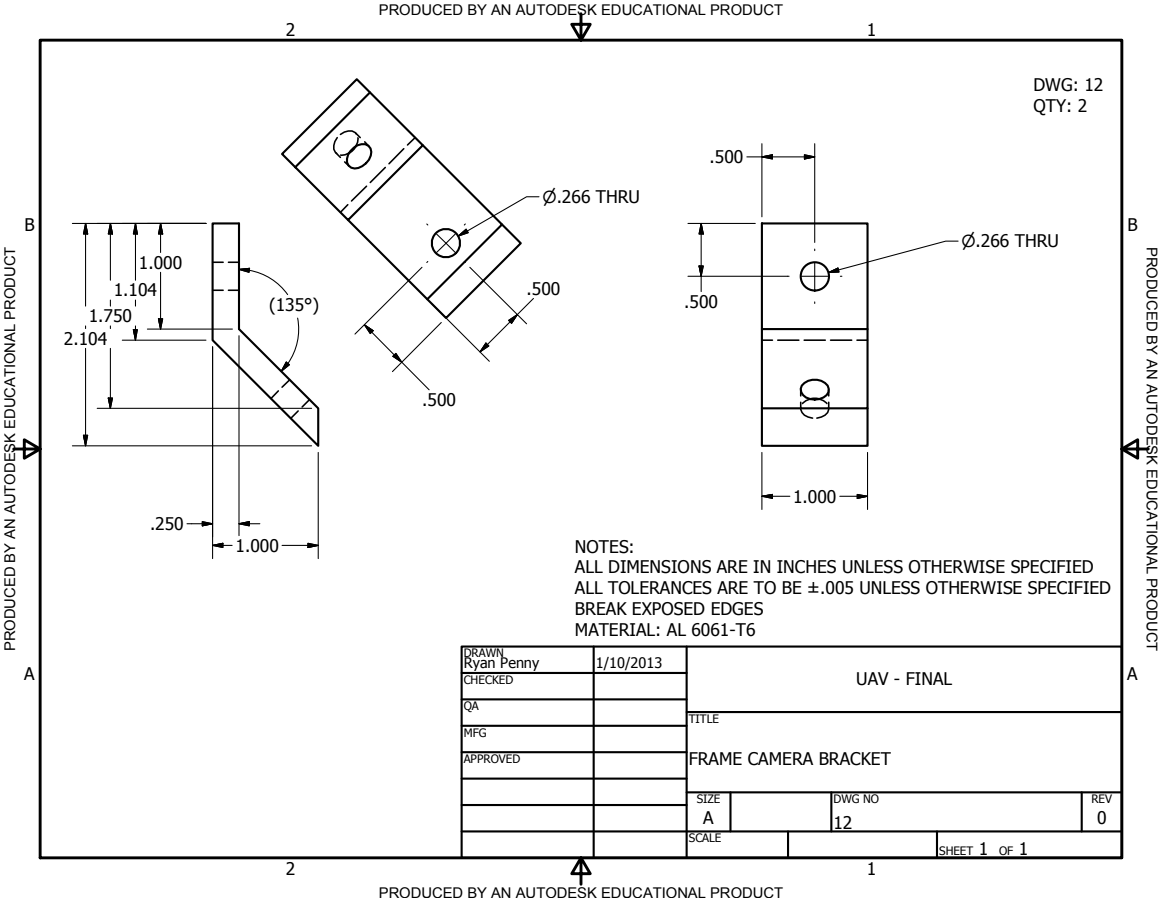
[picture p124: page 1]
TIO; A U T O D E S K E D U C A TIO; DRAWN Ryan Penny; CHECKED; MFG; APPROVED; UAV - FINAL; TITLE; SIZE A; SCALE; DWG NO 12; REV 0; SHEET 1 OF 1; P.266 THRU; DWG: 12 QTY: 2

PRODUCED BY AN AUTODESK EDUCATIONAL PRODUCT

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

FRAME CAMERA BRACKET
