saltscapstone/capstone/robot_final/Drawings/RenumberedDrawings/16.pdf

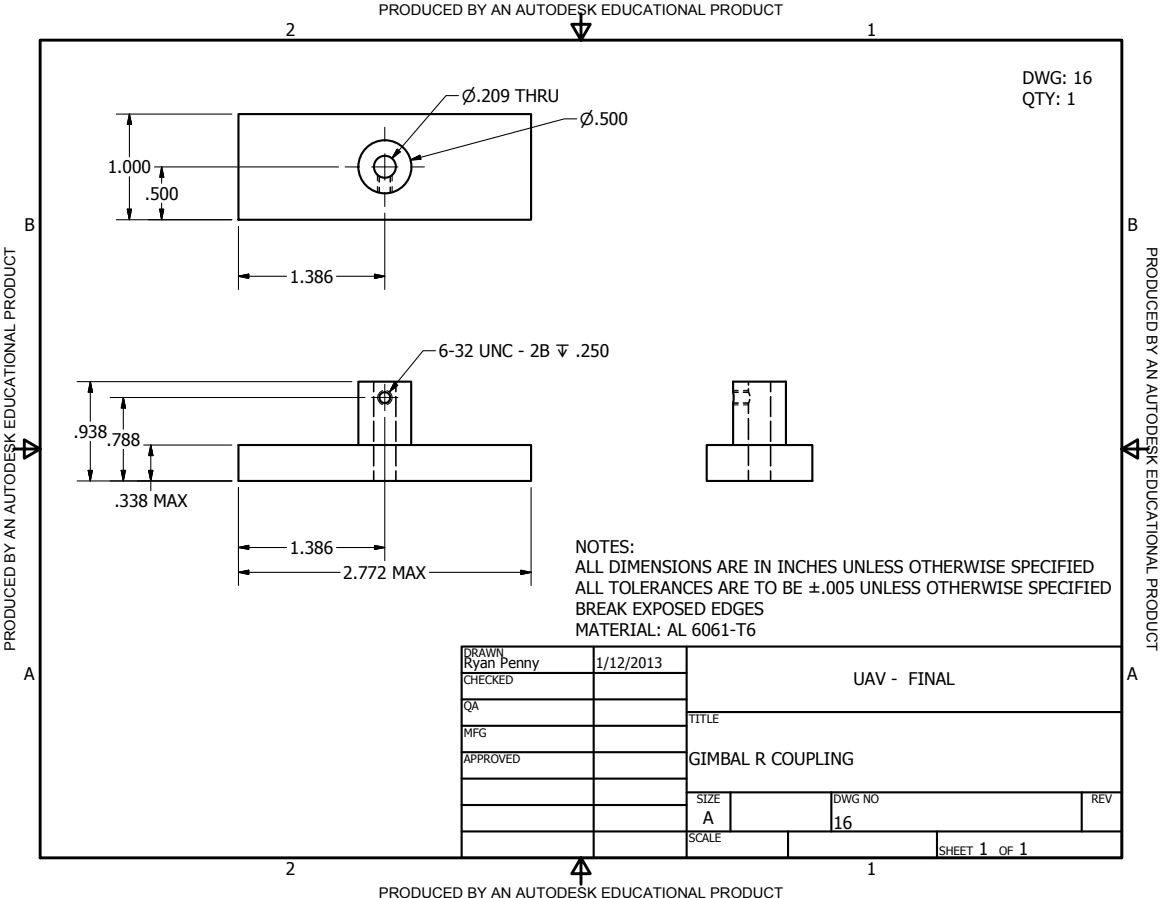
[picture p125: page 1]
TIO; A U T O D E S K E D U C A TIO; DRAWN Ryan Penny; CHECKED; MFG; APPROVED; UAV - FINAL; TITLE; GIMBAL R COUPLING; SIZE A; SCALE; DWG NO 16; REV; SHEET 1 OF 1; 6-32 UNC - 2B Z .250; P.209 THRU; 2.772 MAX; .338 MAX; DWG: 16 QTY: 1

PRODUCED BY AN AUTODESK EDUCATIONAL PRODUCT

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
