saltscapstone/capstone/robot_final/Drawings/RenumberedDrawings/17.pdf

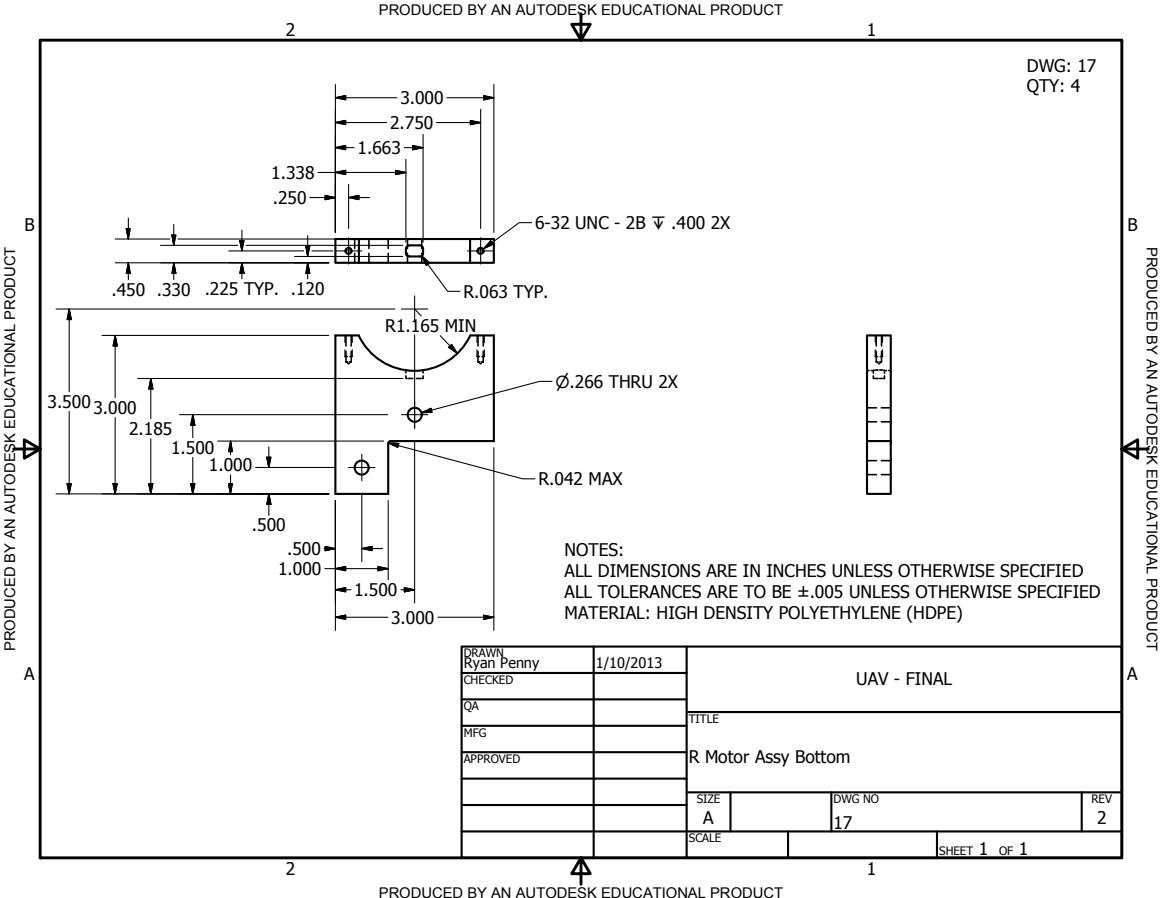
[picture p126: page 1]
TIO; A U T O D E S K E D U C A TIO; DRAWN Ryan Penny; CHECKED; MFG; APPROVED; UAV - FINAL; TITLE; SIZE A; SCALE; DWG NO 17; REV 2; SHEET 1 OF 1; 6-32 UNC - 2B Z .400 2X; R1.165 MIN; R.063 TYP. .450 .330 .225 TYP.; P.266 THRU 2X; R.042 MAX; DWG: 17 QTY: 4

PRODUCED BY AN AUTODESK EDUCATIONAL PRODUCT

NOTES:
ALL DIMENSIONS ARE IN INCHES UNLESS OTHERWISE SPECIFIED
ALL TOLERANCES ARE TO BE ±.005 UNLESS OTHERWISE SPECIFIED
MATERIAL: HIGH DENSITY POLYETHYLENE (HDPE)

R Motor Assy Bottom
