saltscapstone/capstone/robot_final/Drawings/RenumberedDrawings/18.pdf

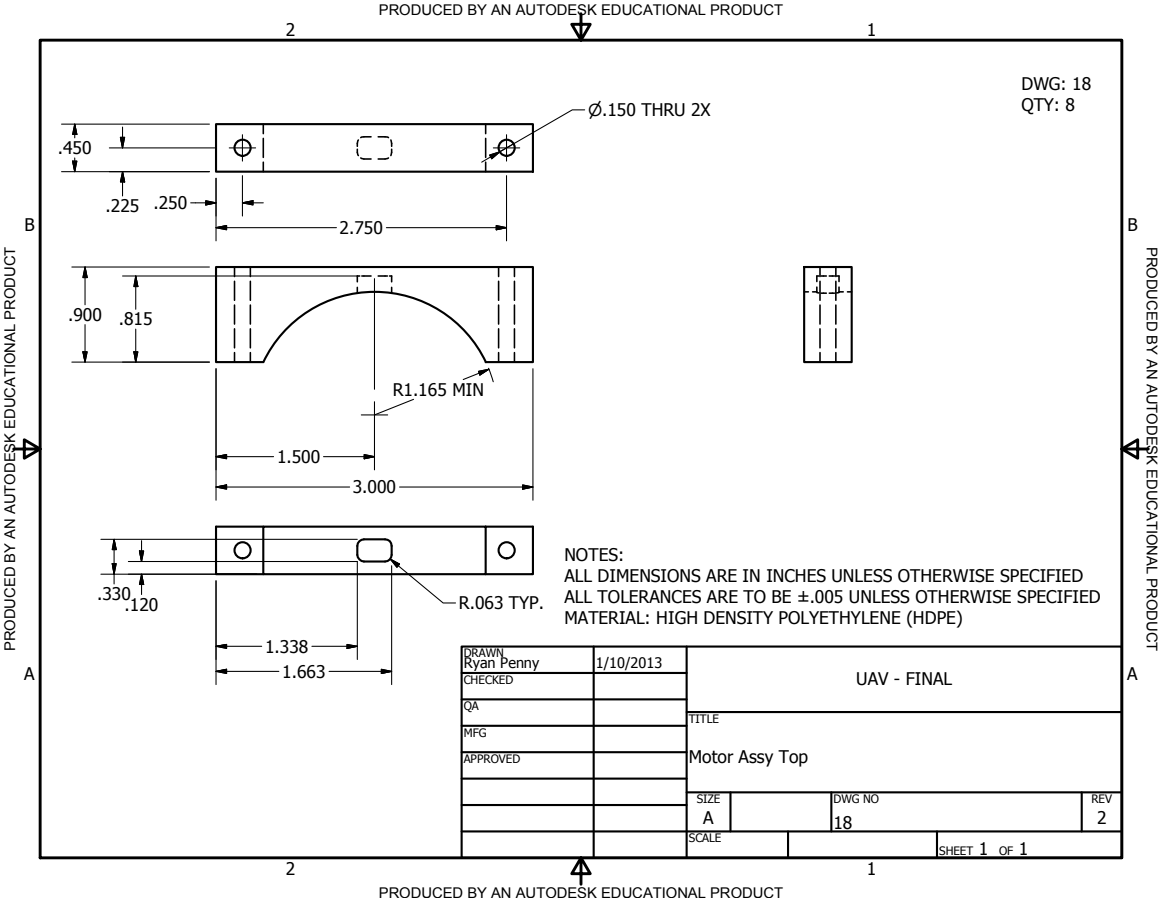
[picture p127: page 1]
TIO; A U T O D E S K E D U C A TIO; DRAWN Ryan Penny; CHECKED; MFG; APPROVED; UAV - FINAL; TITLE; SIZE A; SCALE; DWG NO 18; REV 2; SHEET 1 OF 1; P.150 THRU 2X; R1.165 MIN; R.063 TYP.; DWG: 18 QTY: 8

PRODUCED BY AN AUTODESK EDUCATIONAL PRODUCT

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

Motor Assy Top
