saltscapstone/capstone/robot_final/Drawings/RenumberedDrawings/19.pdf

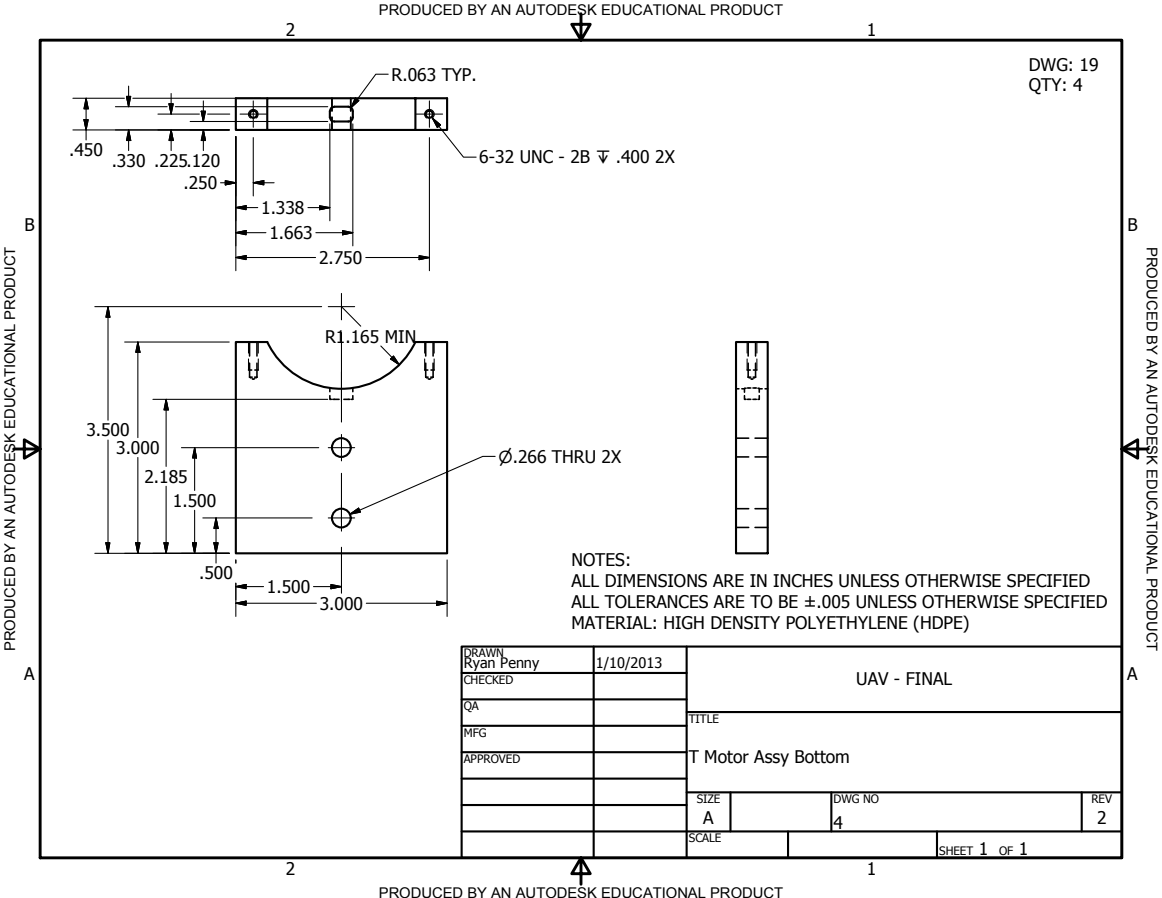
[picture p128: page 1]
TIO; A U T O D E S K E D U C A TIO; DRAWN Ryan Penny; CHECKED; MFG; APPROVED; UAV - FINAL; TITLE; SIZE A; SCALE; DWG NO 4; REV 2; SHEET 1 OF 1; P.266 THRU 2X; 6-32 UNC - 2B Z .400 2X; R.063 TYP.; R1.165 MIN; DWG: 19 QTY: 4

PRODUCED BY AN AUTODESK EDUCATIONAL PRODUCT

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

T Motor Assy Bottom
