saltscapstone/capstone/robot_final/Drawings/RenumberedDrawings/20.pdf

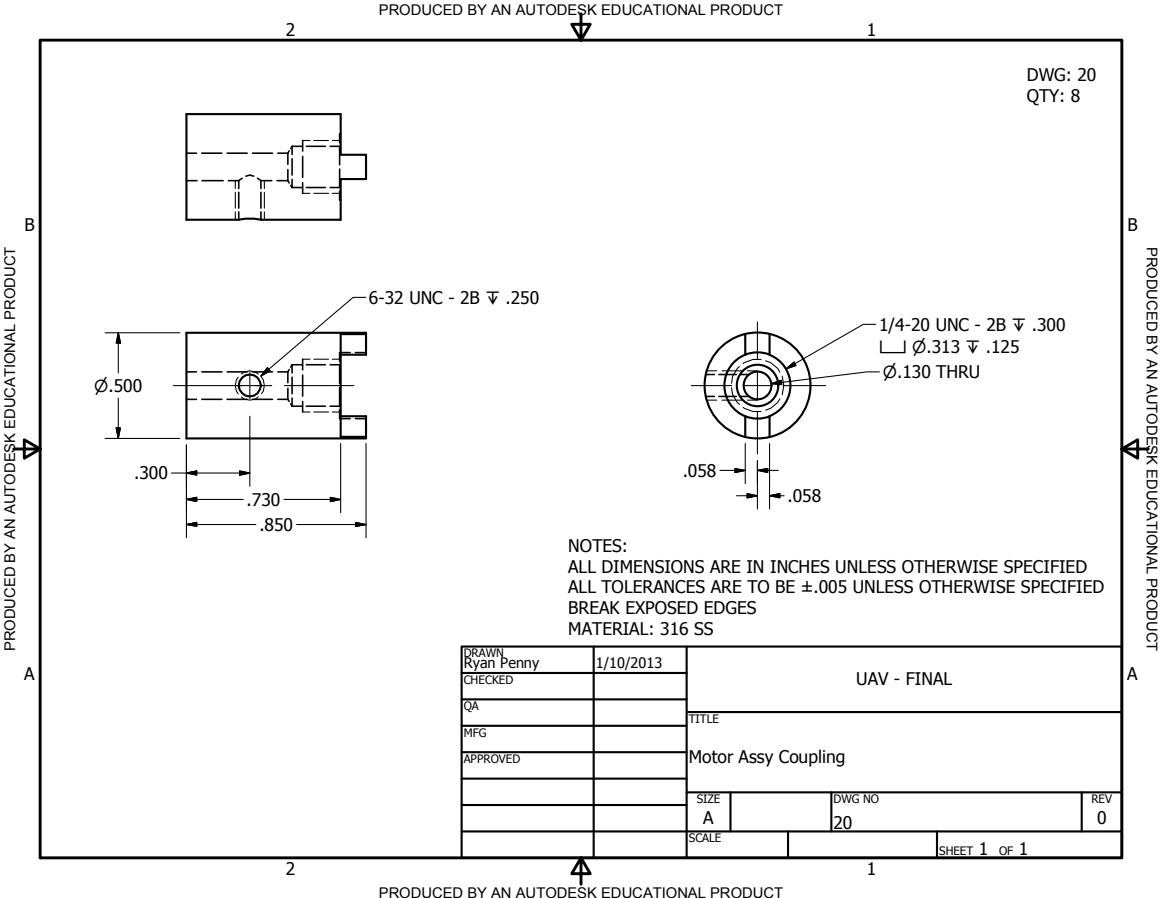
[picture p129: page 1]
TIO; A U T O D E S K E D U C A TIO; DRAWN Ryan Penny; CHECKED; MFG; APPROVED; UAV - FINAL; TITLE; SIZE A; SCALE; DWG NO 20; REV 0; SHEET 1 OF 1; 1/4-20 UNC - 2B Z .300 X P.313 Z .125 P.130 THRU; 6-32 UNC - 2B Z .250; DWG: 20 QTY: 8

PRODUCED BY AN AUTODESK EDUCATIONAL PRODUCT

NOTES:
ALL DIMENSIONS ARE IN INCHES UNLESS OTHERWISE SPECIFIED
ALL TOLERANCES ARE TO BE ±.005 UNLESS OTHERWISE SPECIFIED
BREAK EXPOSED EDGES
MATERIAL: 316 SS

Motor Assy Coupling
