saltscapstone/capstone/robot_final/Drawings/RenumberedDrawings/22-23.pdf

A
B

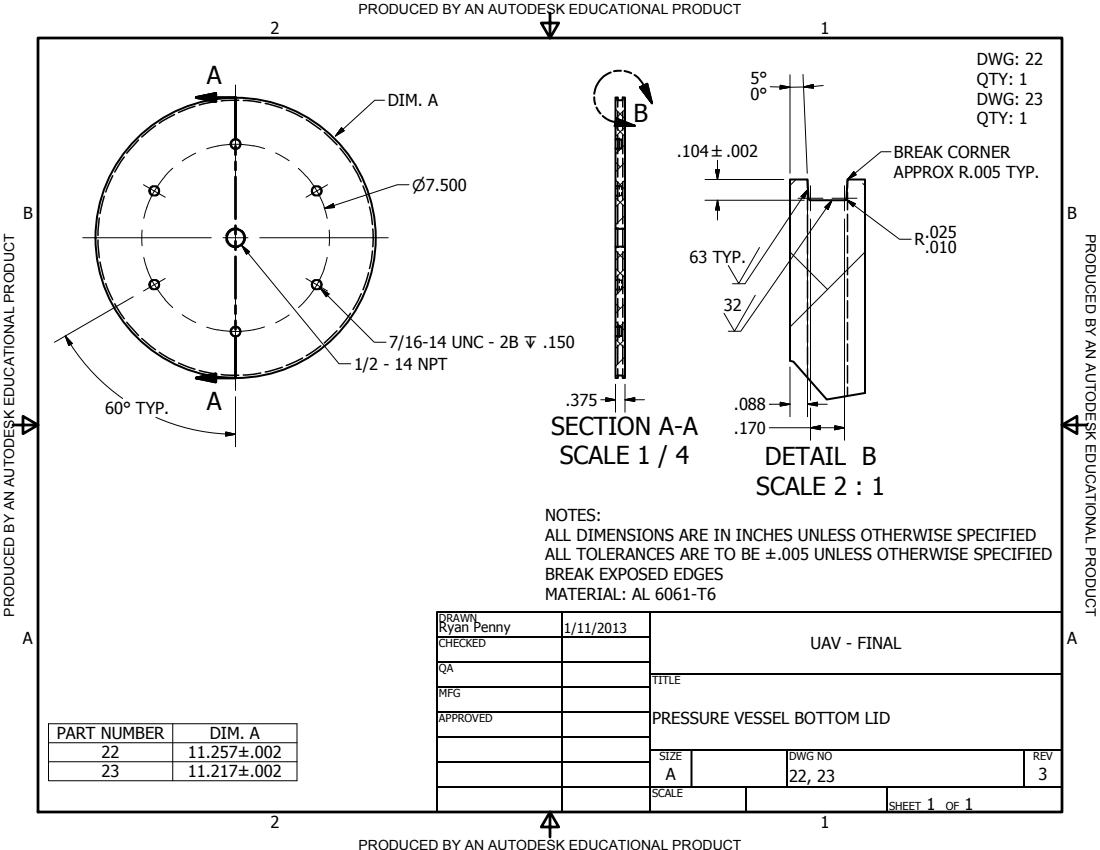
[picture p130: page 1]
SECTION A-A; SCALE 1 / 4; DETAIL B; SCALE 2 : 1; TIO; A U T O D E S K E D U C A TIO; DRAWN Ryan Penny; CHECKED; MFG; APPROVED; UAV - FINAL; TITLE; SIZE A; SCALE; DWG NO 22, 23; REV 3; SHEET 1 OF 1; 1/2 - 14 NPT; 7/16-14 UNC - 2B Z .150; 60° TYP.; DIM. A; PART NUMBER; BREAK CORNER APPROX R.005 TYP.; 63 TYP.; DWG: 22 QTY: 1 DWG: 23 QTY: 1

PRODUCED BY AN AUTODESK EDUCATIONAL PRODUCT

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

PRESSURE VESSEL BOTTOM LID
