saltscapstone/capstone/robot_final/Drawings/RenumberedDrawings/27-32.pdf

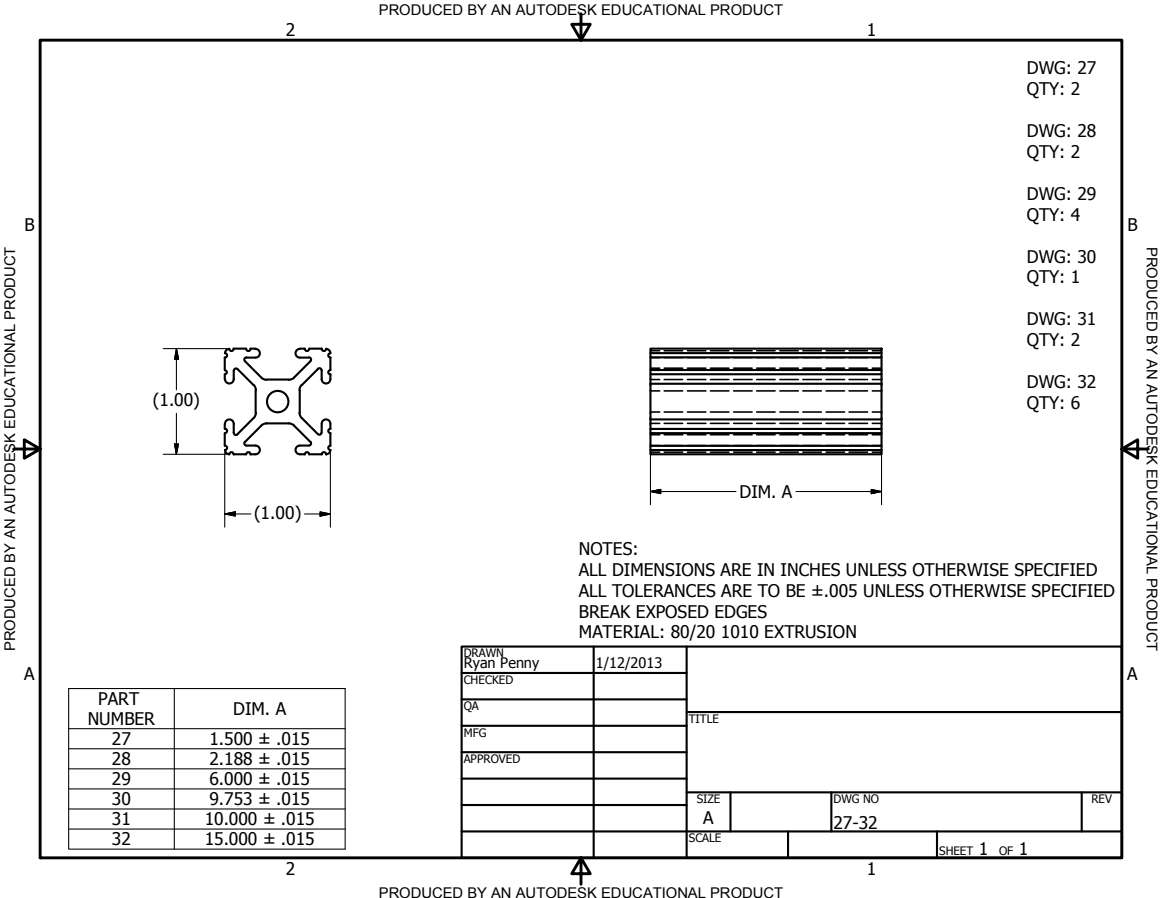
[picture p131: page 1]
TIO; A U T O D E S K E D U C A TIO; DRAWN Ryan Penny; CHECKED; MFG; APPROVED; TITLE; SIZE A; SCALE; DWG NO 27-32; REV; SHEET 1 OF 1; DIM. A; PART NUMBER; DWG: 27 QTY: 2; DWG: 28 QTY: 2; DWG: 29 QTY: 4; DWG: 30 QTY: 1; DWG: 31 QTY: 2; DWG: 32 QTY: 6

PRODUCED BY AN AUTODESK EDUCATIONAL PRODUCT

NOTES:
ALL DIMENSIONS ARE IN INCHES UNLESS OTHERWISE SPECIFIED
ALL TOLERANCES ARE TO BE ±.005 UNLESS OTHERWISE SPECIFIED
BREAK EXPOSED EDGES
MATERIAL: 80/20 1010 EXTRUSION
