saltscapstone/capstone/robot_final/Drawings/RenumberedDrawings/3.pdf

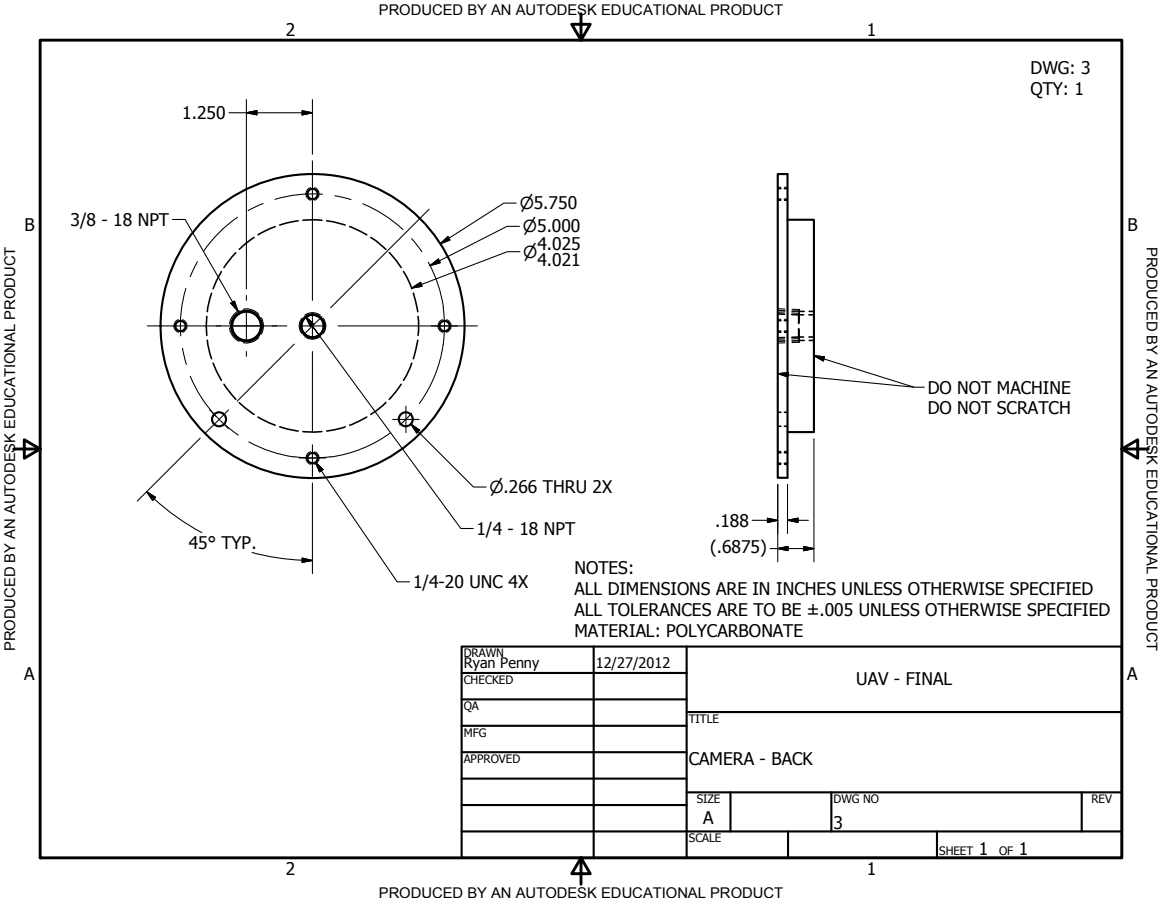
[picture p132: page 1]
TIO; A U T O D E S K E D U C A TIO; DRAWN Ryan Penny; CHECKED; MFG; APPROVED; UAV - FINAL; TITLE; CAMERA - BACK; SIZE A; SCALE; DWG NO 3; REV; SHEET 1 OF 1; 1/4-20 UNC 4X; P.266 THRU 2X; 1/4 - 18 NPT; 45° TYP.; 3/8 - 18 NPT; DWG: 3 QTY: 1

PRODUCED BY AN AUTODESK EDUCATIONAL PRODUCT

DO NOT MACHINE
DO NOT SCRATCH

NOTES:
ALL DIMENSIONS ARE IN INCHES UNLESS OTHERWISE SPECIFIED
ALL TOLERANCES ARE TO BE ±.005 UNLESS OTHERWISE SPECIFIED
MATERIAL: POLYCARBONATE
