saltscapstone/capstone/robot_final/Drawings/RenumberedDrawings/33.pdf

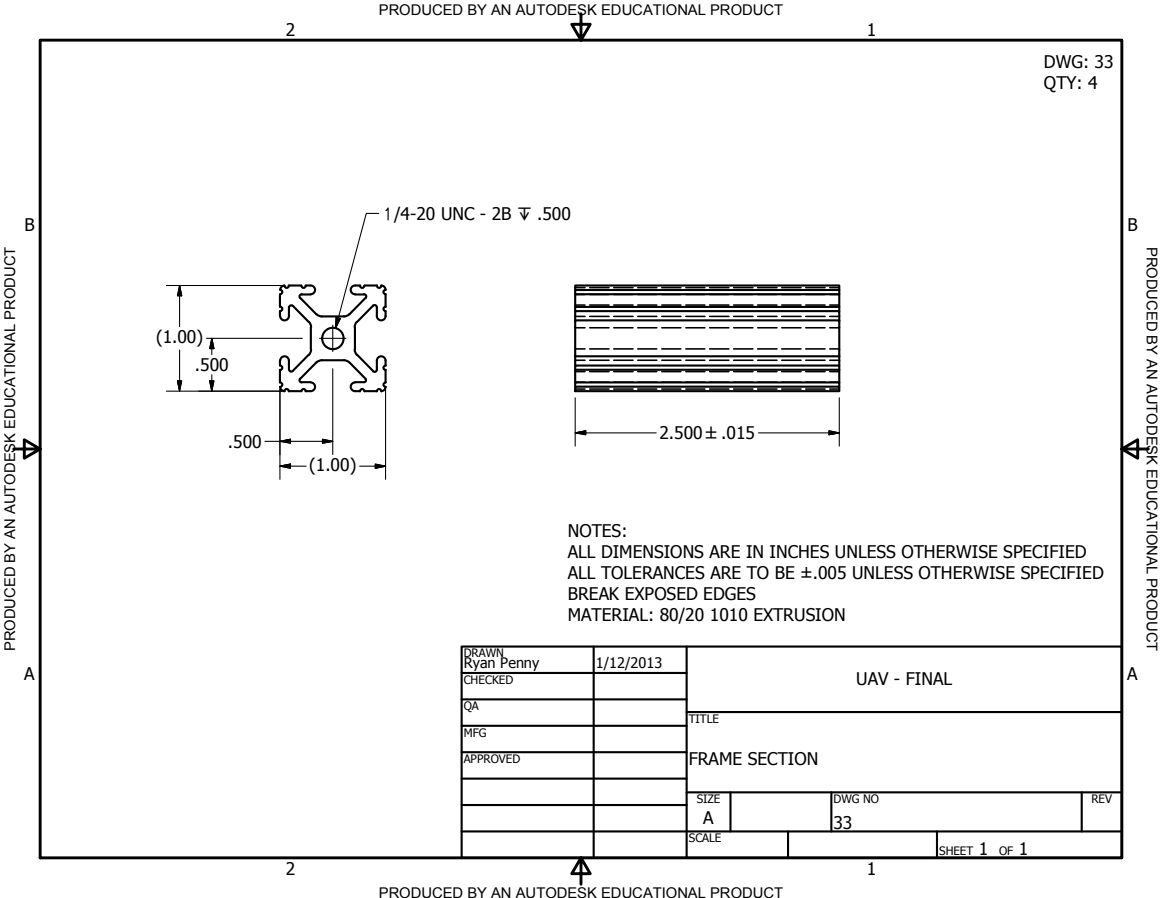
[picture p133: page 1]
TIO; A U T O D E S K E D U C A TIO; DRAWN Ryan Penny; CHECKED; MFG; APPROVED; UAV - FINAL; TITLE; FRAME SECTION; SIZE A; SCALE; DWG NO 33; REV; SHEET 1 OF 1; /4-20 UNC - 2B Z .500; DWG: 33 QTY: 4

PRODUCED BY AN AUTODESK EDUCATIONAL PRODUCT

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
