saltscapstone/capstone/robot_final/Drawings/RenumberedDrawings/34.pdf

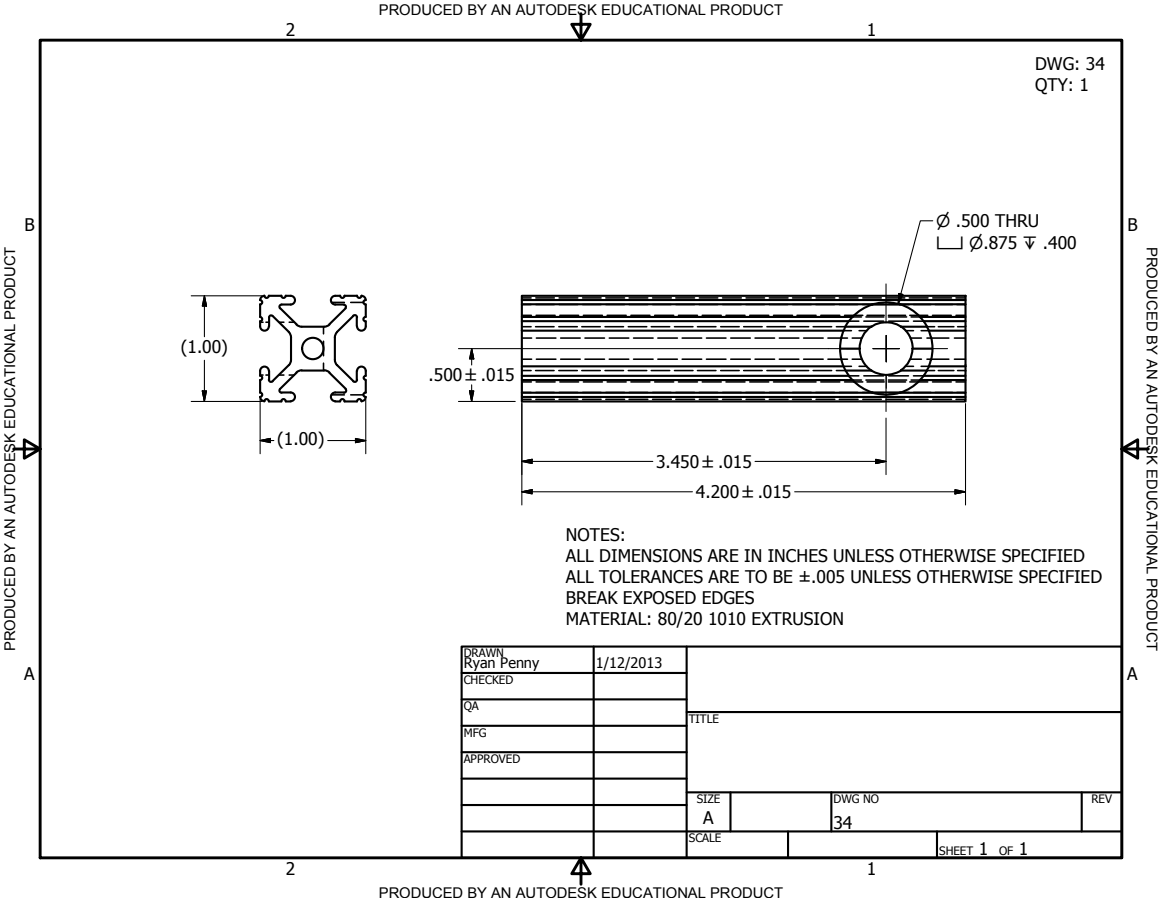
[picture p134: page 1]
TIO; A U T O D E S K E D U C A TIO; DRAWN Ryan Penny; CHECKED; MFG; APPROVED; TITLE; SIZE A; SCALE; DWG NO 34; REV; SHEET 1 OF 1; P .500 THRU X P.875 Z .400; DWG: 34 QTY: 1

PRODUCED BY AN AUTODESK EDUCATIONAL PRODUCT

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
