saltscapstone/capstone/robot_final/Drawings/RenumberedDrawings/35.pdf

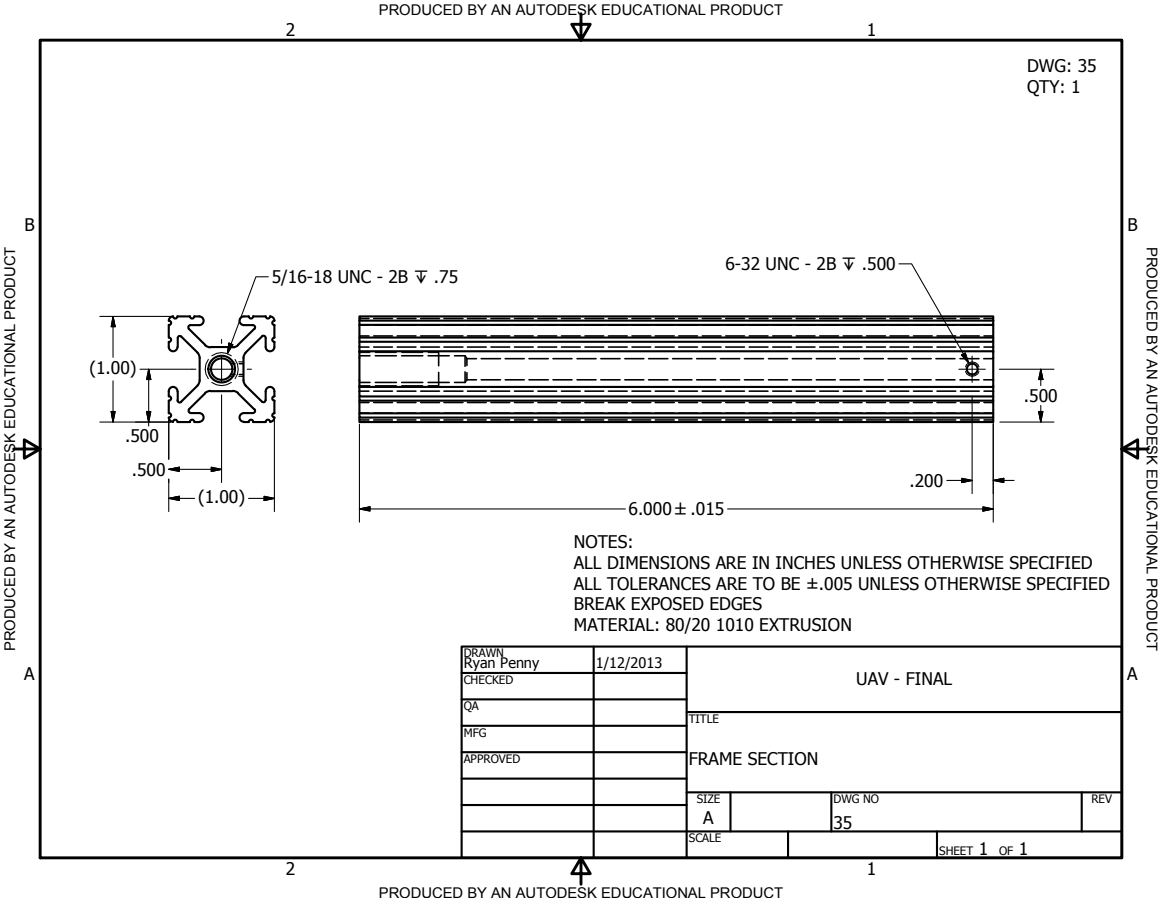
[picture p135: page 1]
TIO; A U T O D E S K E D U C A TIO; DRAWN Ryan Penny; CHECKED; MFG; APPROVED; UAV - FINAL; TITLE; FRAME SECTION; SIZE A; SCALE; DWG NO 35; REV; SHEET 1 OF 1; 5/16-18 UNC - 2B Z .75; 6-32 UNC - 2B Z .500; DWG: 35 QTY: 1

PRODUCED BY AN AUTODESK EDUCATIONAL PRODUCT

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
