saltscapstone/capstone/robot_final/Drawings/RenumberedDrawings/4.pdf

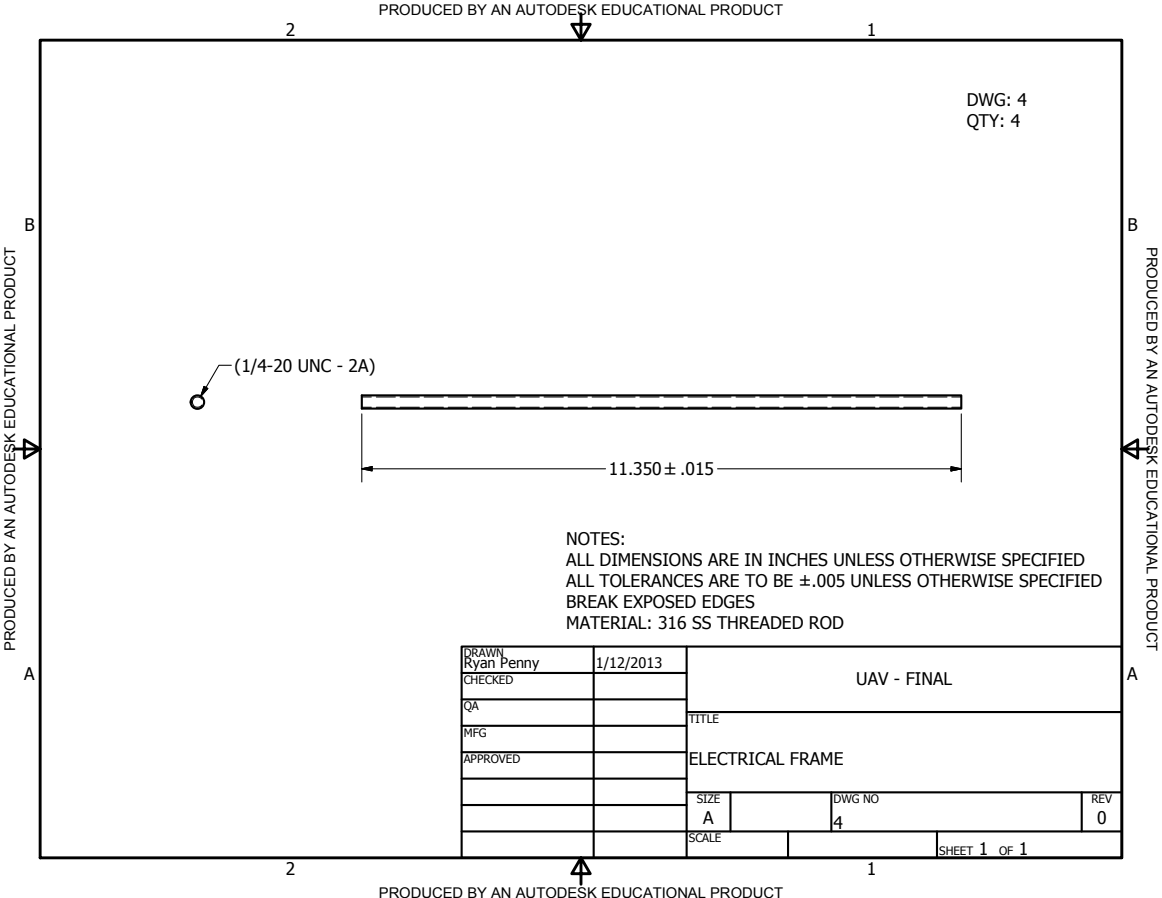
[picture p136: page 1]
TIO; A U T O D E S K E D U C A TIO; DRAWN Ryan Penny; CHECKED; MFG; APPROVED; UAV - FINAL; TITLE; ELECTRICAL FRAME; SIZE A; SCALE; DWG NO 4; REV 0; SHEET 1 OF 1; (1/4-20 UNC - 2A); DWG: 4 QTY: 4

PRODUCED BY AN AUTODESK EDUCATIONAL PRODUCT

NOTES:
ALL DIMENSIONS ARE IN INCHES UNLESS OTHERWISE SPECIFIED
ALL TOLERANCES ARE TO BE ±.005 UNLESS OTHERWISE SPECIFIED
BREAK EXPOSED EDGES
MATERIAL: 316 SS THREADED ROD
