saltscapstone/capstone/robot_final/Drawings/RenumberedDrawings/8.pdf

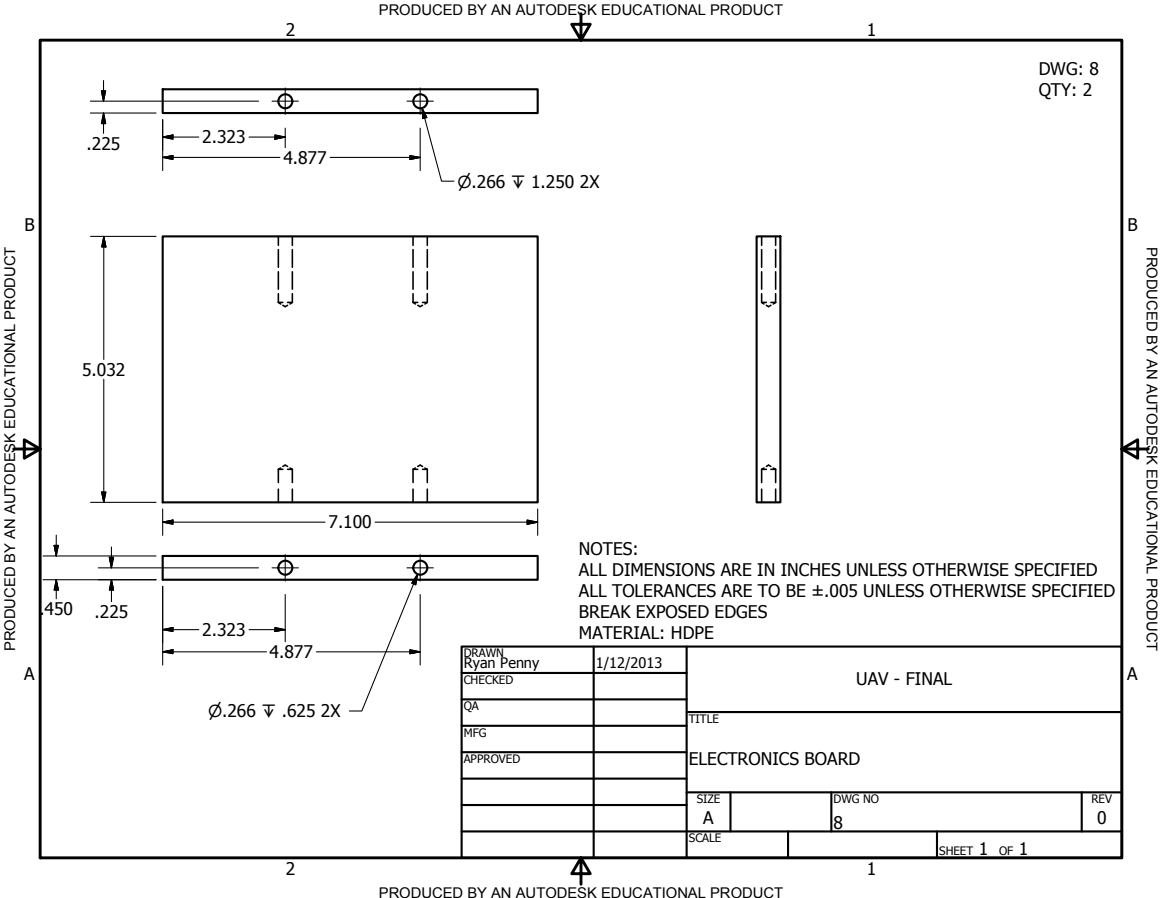
[picture p137: page 1]
TIO; A U T O D E S K E D U C A TIO; DRAWN Ryan Penny; CHECKED; MFG; APPROVED; UAV - FINAL; TITLE; ELECTRONICS BOARD; SIZE A; SCALE; DWG NO 8; REV 0; SHEET 1 OF 1; DWG: 8 QTY: 2

PRODUCED BY AN AUTODESK EDUCATIONAL PRODUCT

NOTES:
ALL DIMENSIONS ARE IN INCHES UNLESS OTHERWISE SPECIFIED
ALL TOLERANCES ARE TO BE ±.005 UNLESS OTHERWISE SPECIFIED
BREAK EXPOSED EDGES
MATERIAL: HDPE
