saltscapstone/capstone/robot_final/Drawings/RenumberedDrawings/9.pdf

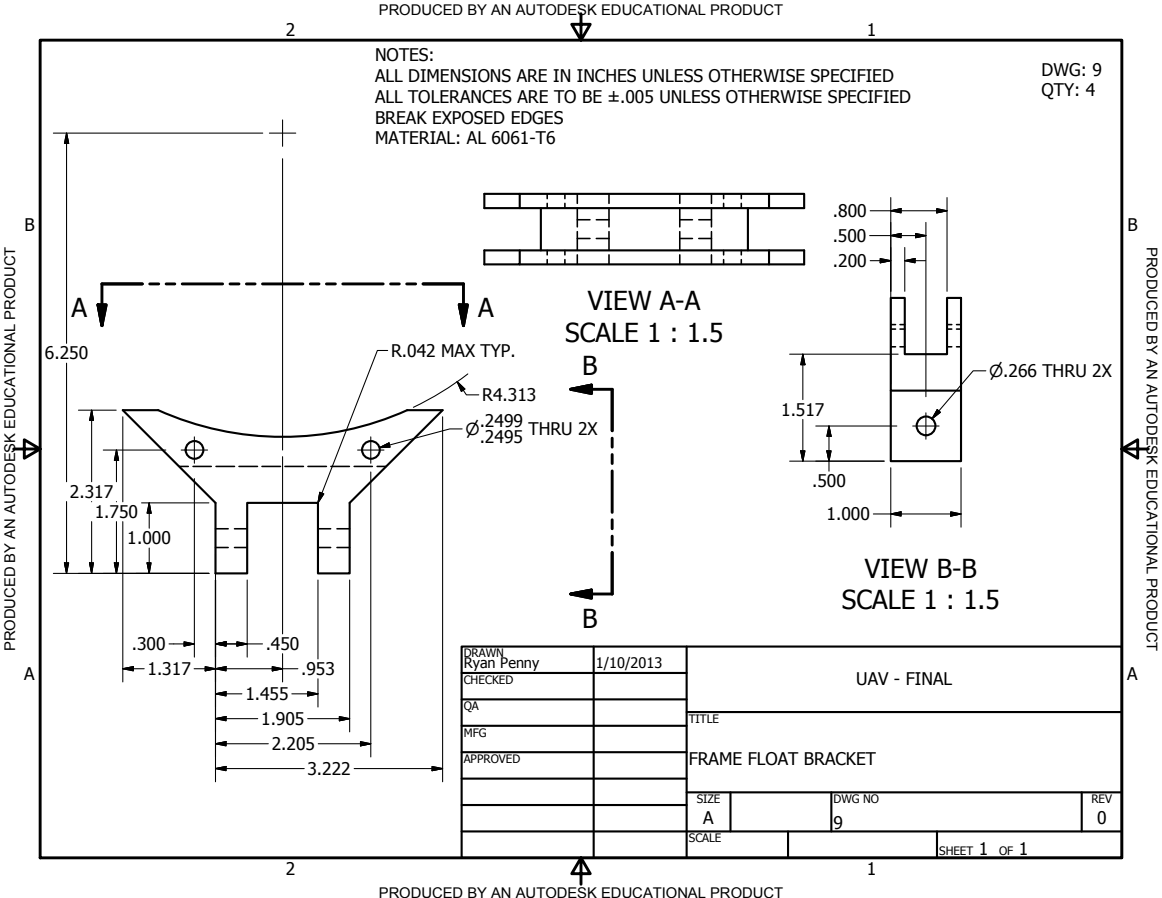
[picture p138: page 1]
VIEW B-B SCALE 1 : 1.5; VIEW A-A SCALE 1 : 1.5; TIO; A U T O D E S K E D U C A TIO; DRAWN Ryan Penny; CHECKED; MFG; APPROVED; UAV - FINAL; TITLE; SIZE A; SCALE; DWG NO 9; REV 0; SHEET 1 OF 1; THRU 2X; P.266 THRU 2X; R.042 MAX TYP.; DWG: 9 QTY: 4

PRODUCED BY AN AUTODESK EDUCATIONAL PRODUCT

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

FRAME FLOAT BRACKET
