saltscapstone/capstone/robot_final/Drawings/RenumberedDrawings/14.pdf

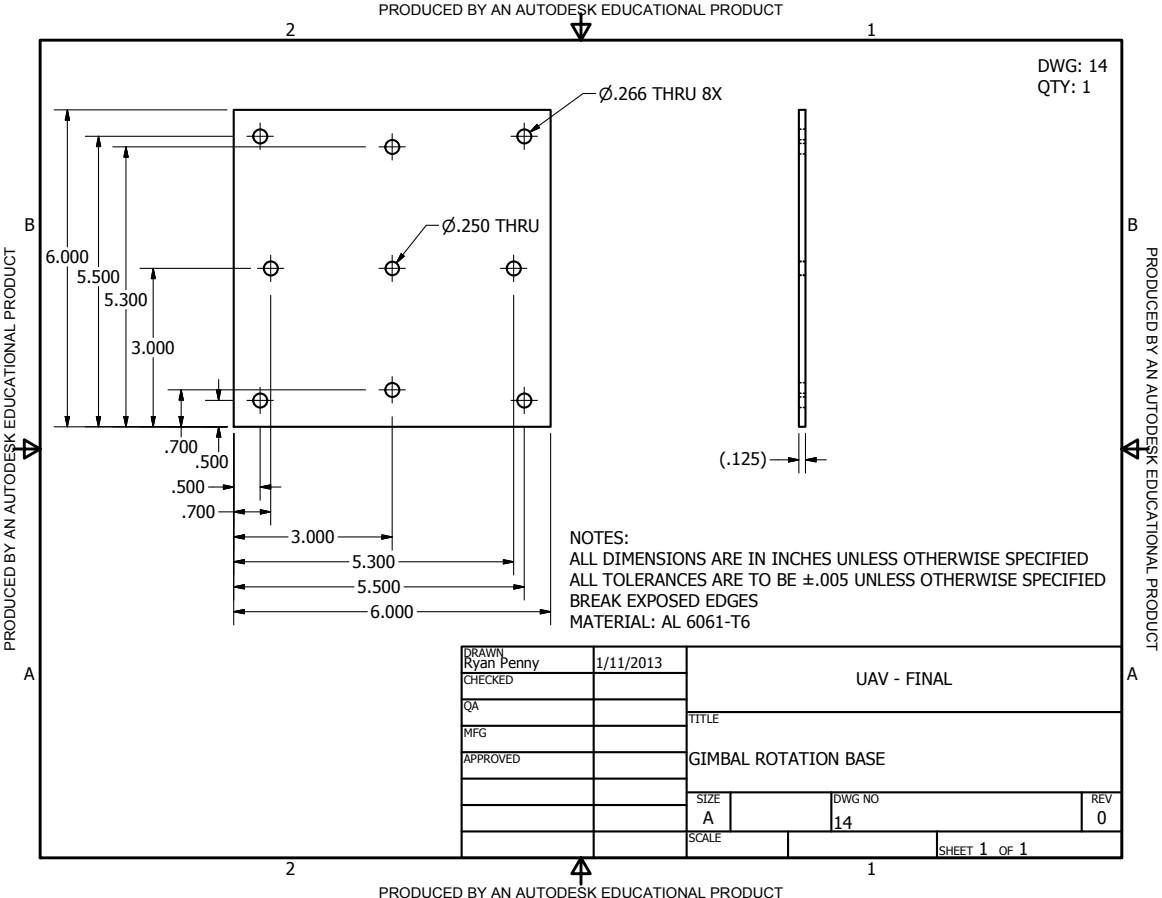
[picture p139: page 1]
TIO; A U T O D E S K E D U C A TIO; DRAWN Ryan Penny; CHECKED; MFG; APPROVED; UAV - FINAL; TITLE; SIZE A; SCALE; DWG NO 14; REV 0; SHEET 1 OF 1; P.266 THRU 8X; P.250 THRU; DWG: 14 QTY: 1

PRODUCED BY AN AUTODESK EDUCATIONAL PRODUCT

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

GIMBAL ROTATION BASE
