saltscapstone/capstone/robot_final/Drawings/RenumberedDrawings/2.pdf

AA
P

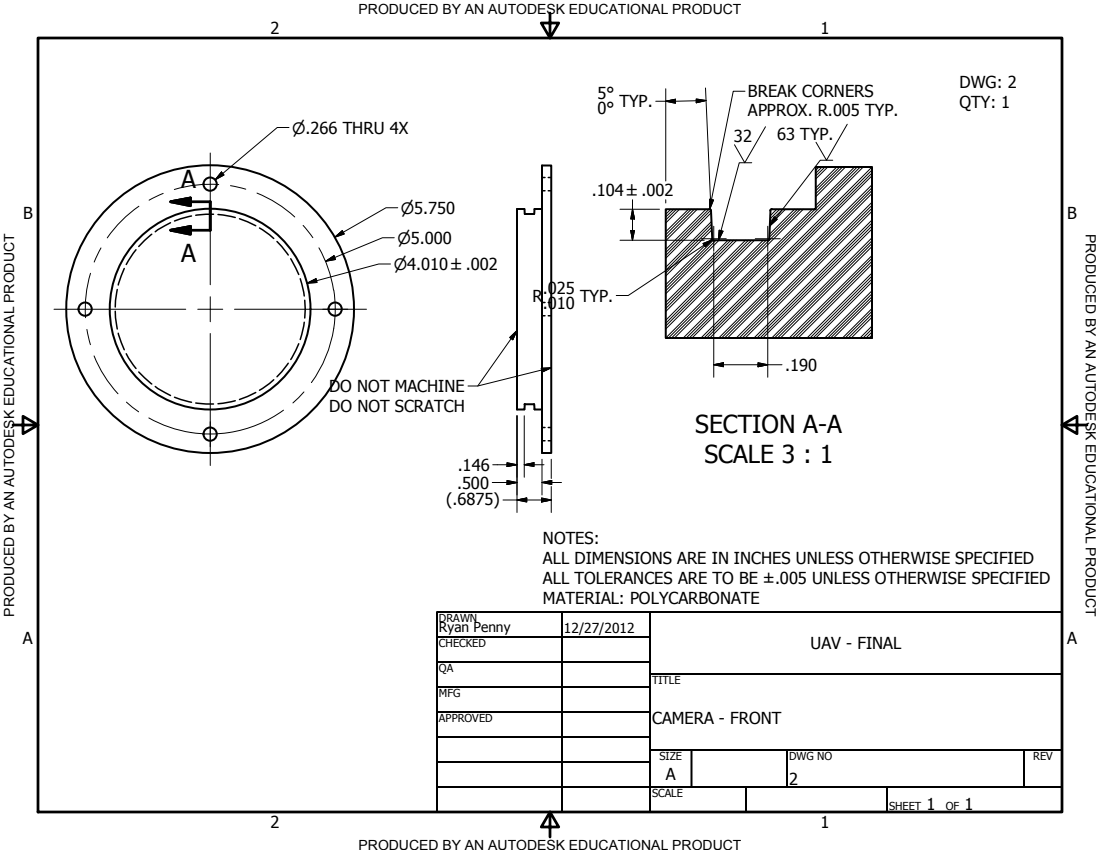
[picture p140: page 1]
TIO; RAT

PRODUCED BY AN AUTODESK EDUCATIONAL PRODUCT
