saltscapstone/capstone/robot_final/Drawings/RenumberedDrawings/21.pdf

AA
B

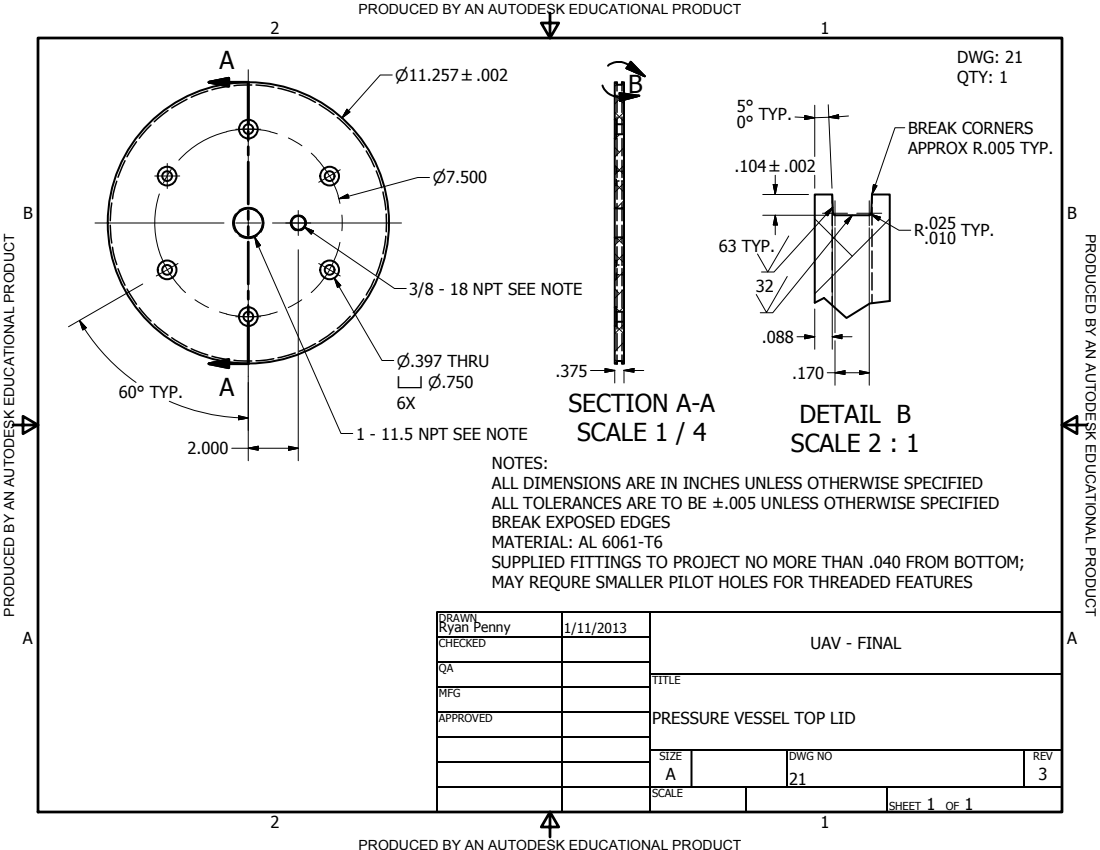
[picture p141: page 1]
TIO; SDW

PRODUCED BY AN AUTODESK EDUCATIONAL PRODUCT
