saltscapstone/capstone/robot_final/Drawings/RenumberedDrawings/25.pdf

AA

B

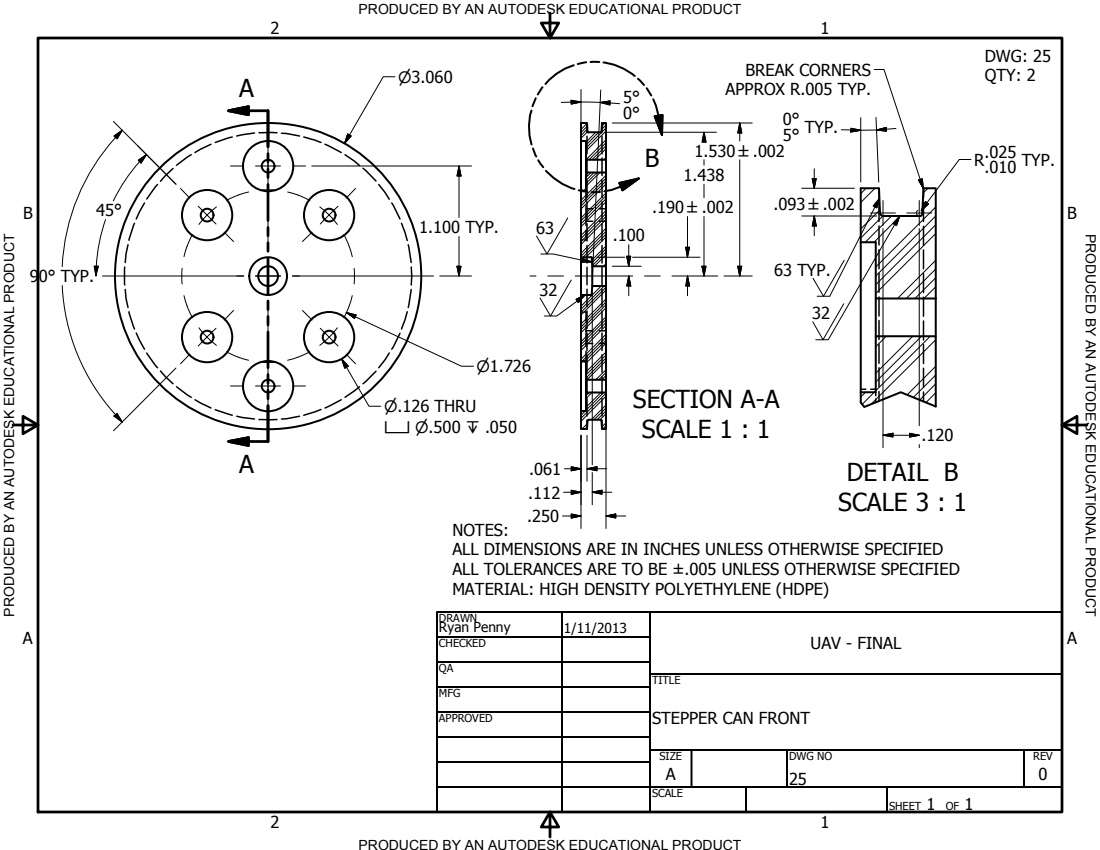
[picture p142: page 1]
TIO

PRODUCED BY AN AUTODESK EDUCATIONAL PRODUCT
