saltscapstone/capstone/robot_final/Drawings/RenumberedDrawings/26.pdf

P
P

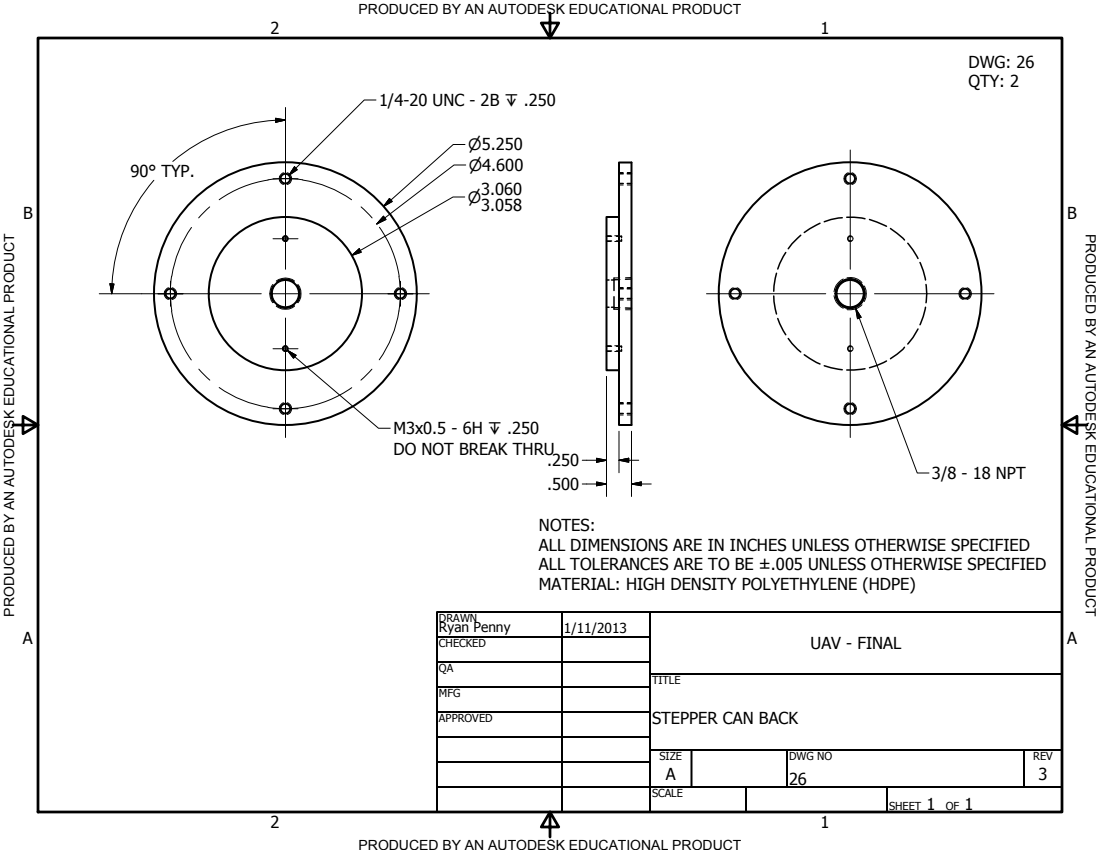
[picture p143: page 1]
TIO

PRODUCED BY AN AUTODESK EDUCATIONAL PRODUCT
