saltscapstone/capstone/robot_final/Drawings/RenumberedDrawings/5-REDIM.pdf

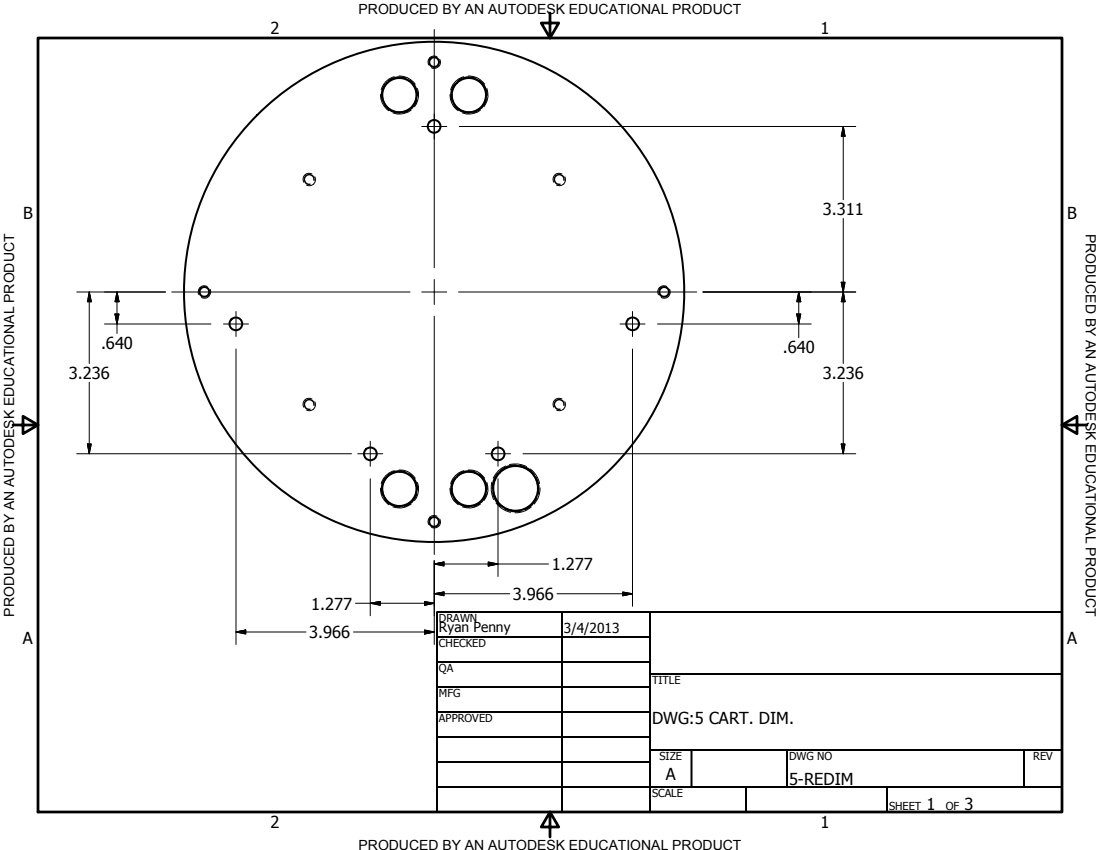
[picture p144: page 1]
TIO

PRODUCED BY AN AUTODESK EDUCATIONAL PRODUCT

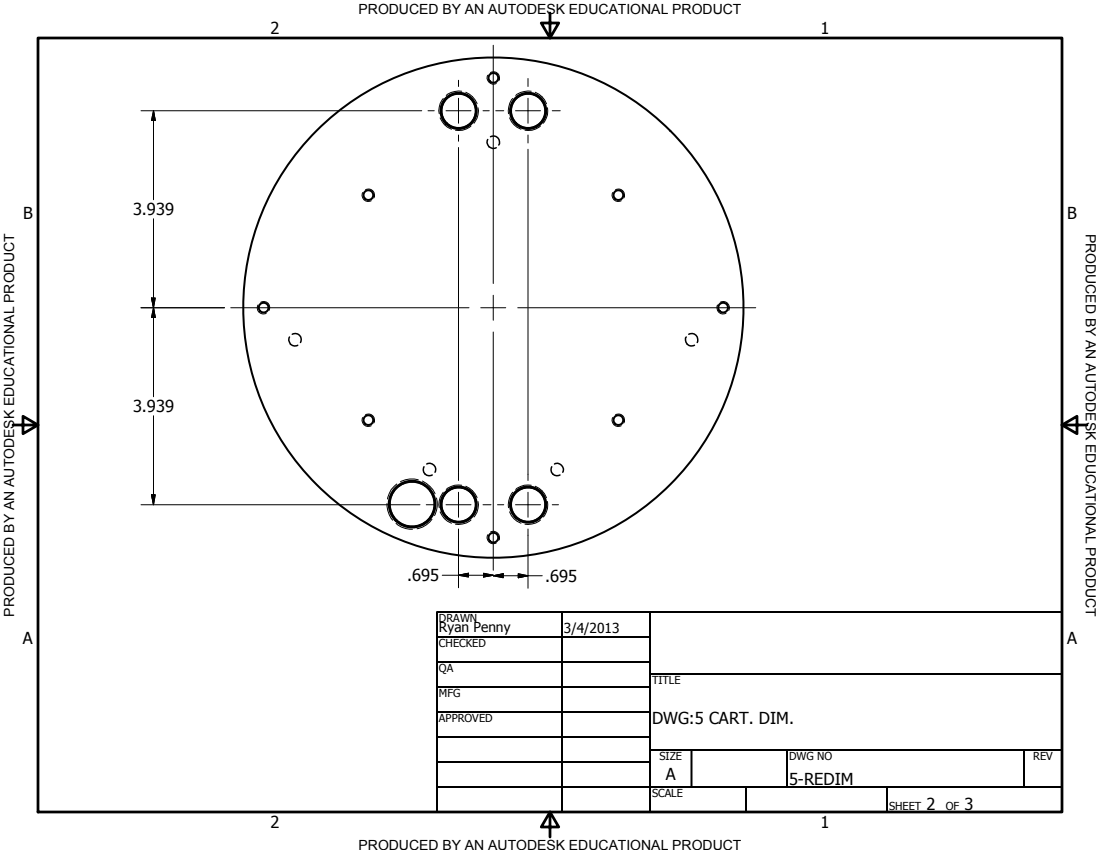
[picture p145: page 2]

PRODUCED BY AN AUTODESK EDUCATIONAL PRODUCT

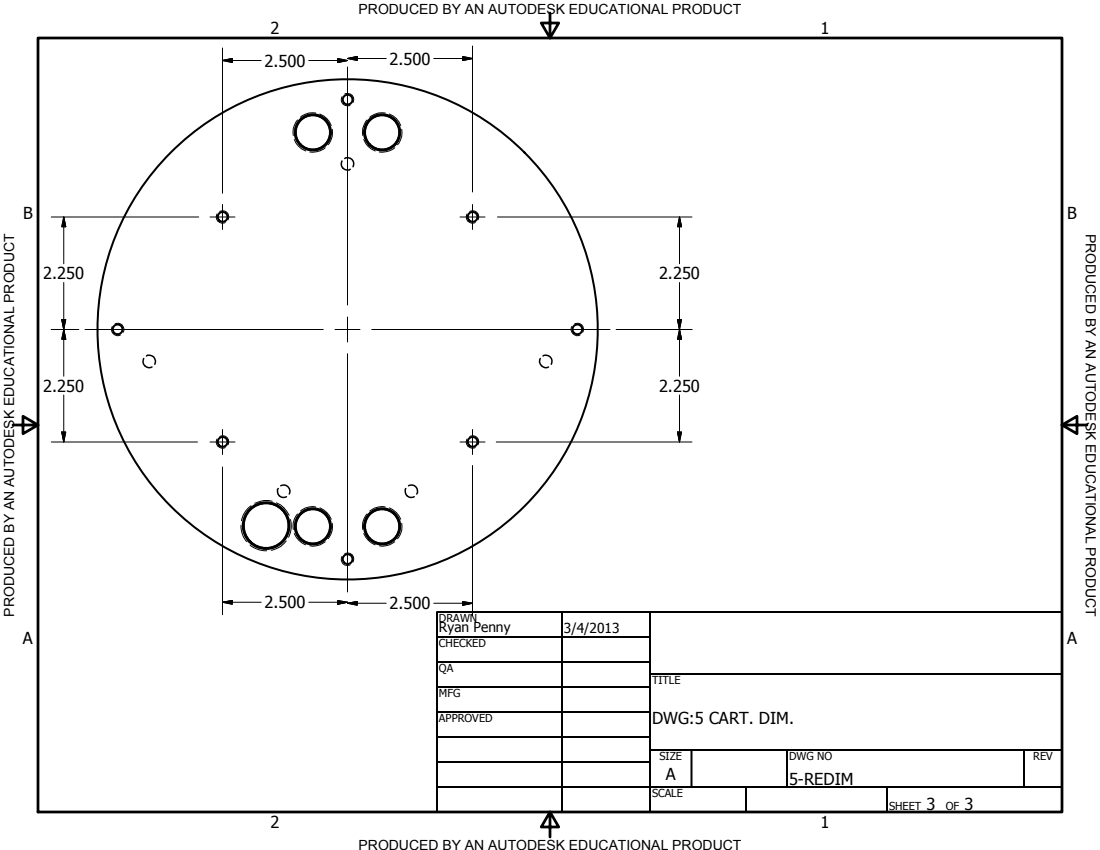
[picture p146: page 3]

PRODUCED BY AN AUTODESK EDUCATIONAL PRODUCT
