saltscapstone/capstone/robot_final/Drawings/RenumberedDrawings/5.pdf

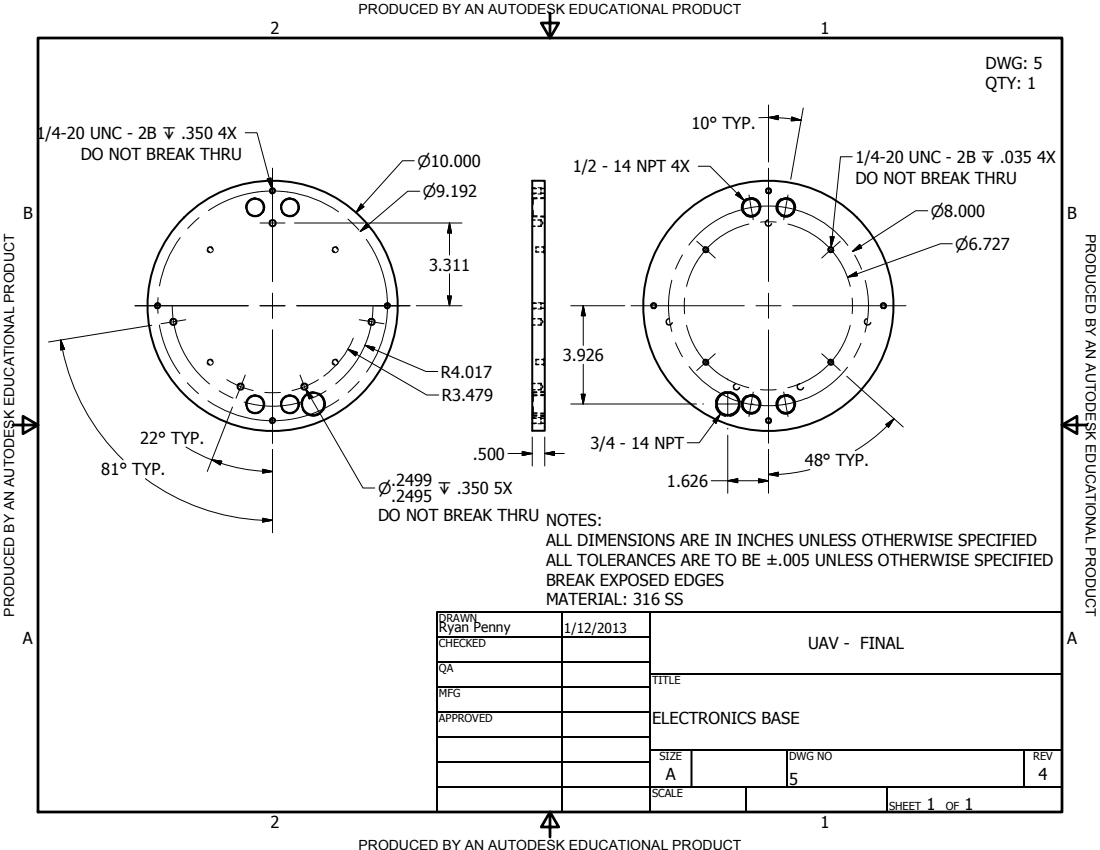
[picture p147: page 1]
TIO; A U T O D E S K E D U C A TIO; DRAWN Ryan Penny; CHECKED; MFG; APPROVED; UAV - FINAL; TITLE; ELECTRONICS BASE; SIZE A; SCALE; DWG NO 5; REV 4; SHEET 1 OF 1; 48° TYP.; 1/2 - 14 NPT 4X; 3/4 - 14 NPT; 22° TYP.; 81° TYP.; 10° TYP.; DWG: 5 QTY: 1

PRODUCED BY AN AUTODESK EDUCATIONAL PRODUCT

1/4-20 UNC - 2B Z .350 4X
DO NOT BREAK THRU

1/4-20 UNC - 2B Z .035 4X

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
