saltscapstone/capstone/robot_final/Drawings/RenumberedDrawings/6-7-REDIM.pdf

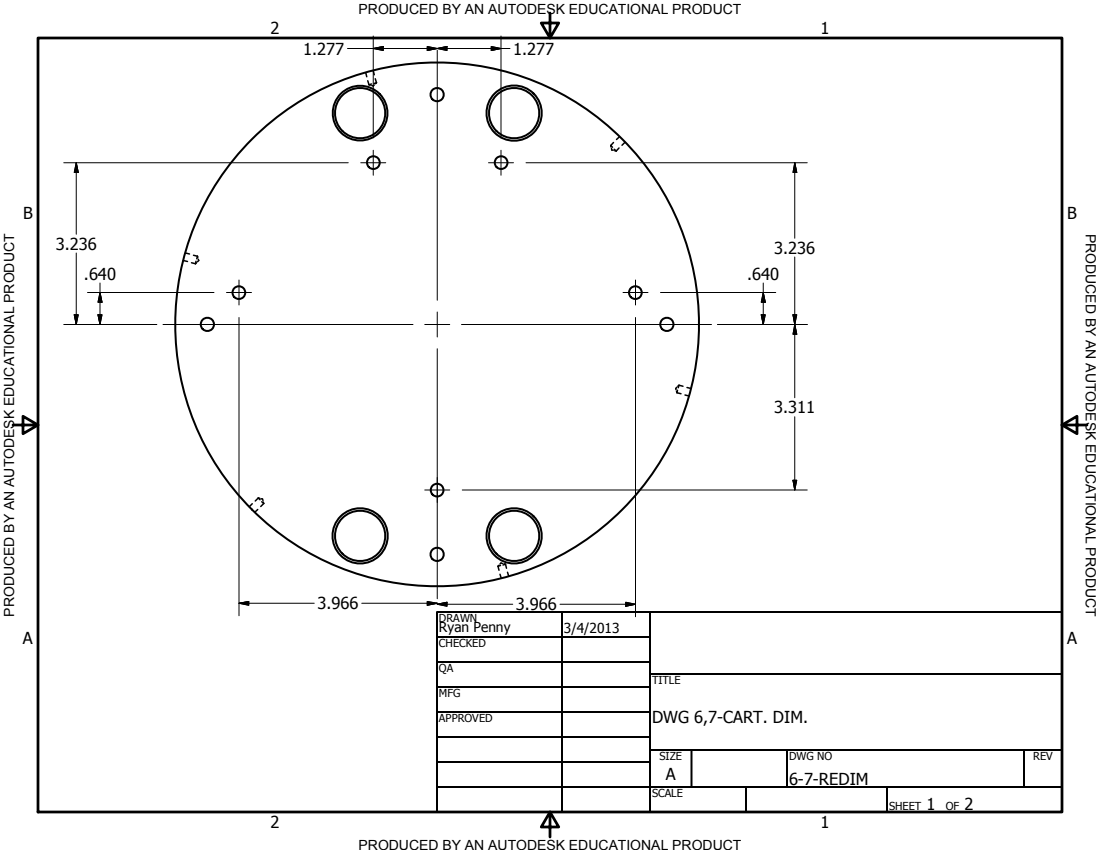
[picture p148: page 1]
TIO

PRODUCED BY AN AUTODESK EDUCATIONAL PRODUCT

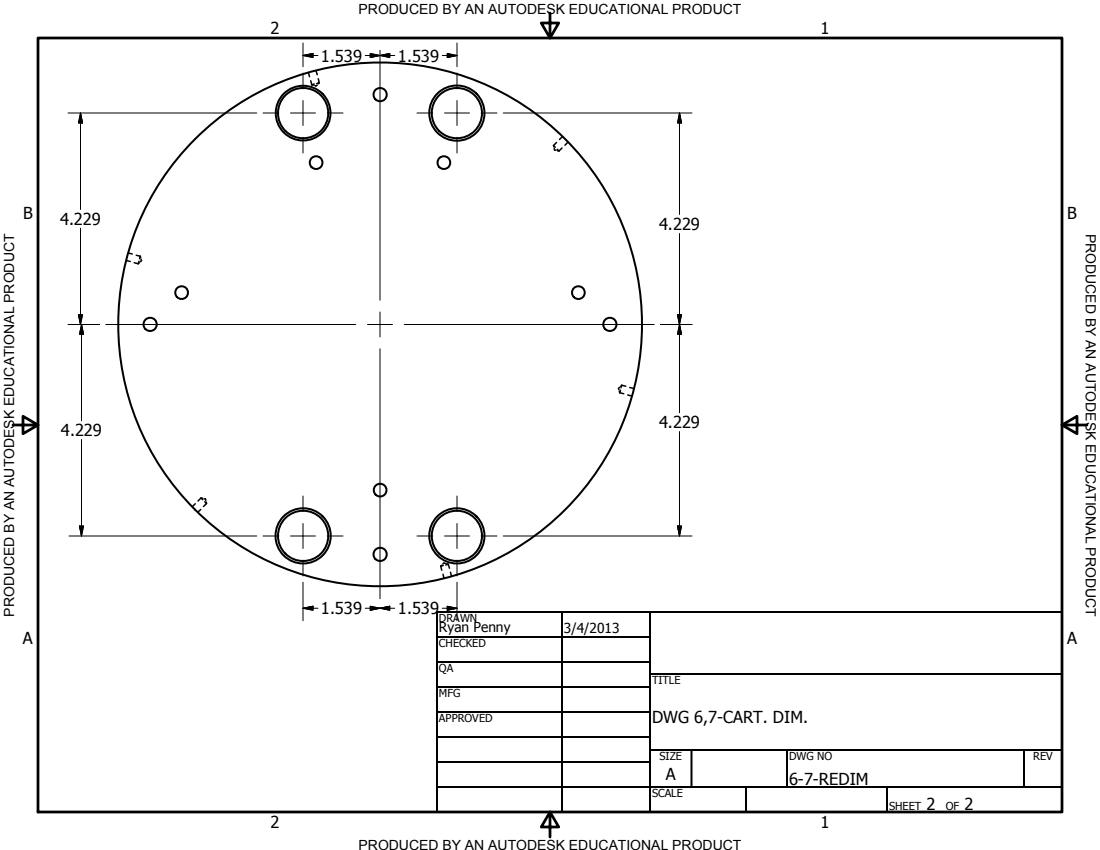
[picture p149: page 2]
TIO

PRODUCED BY AN AUTODESK EDUCATIONAL PRODUCT
