saltscapstone/capstone/robot_final/Drawings/RenumberedDrawings/6-7.pdf

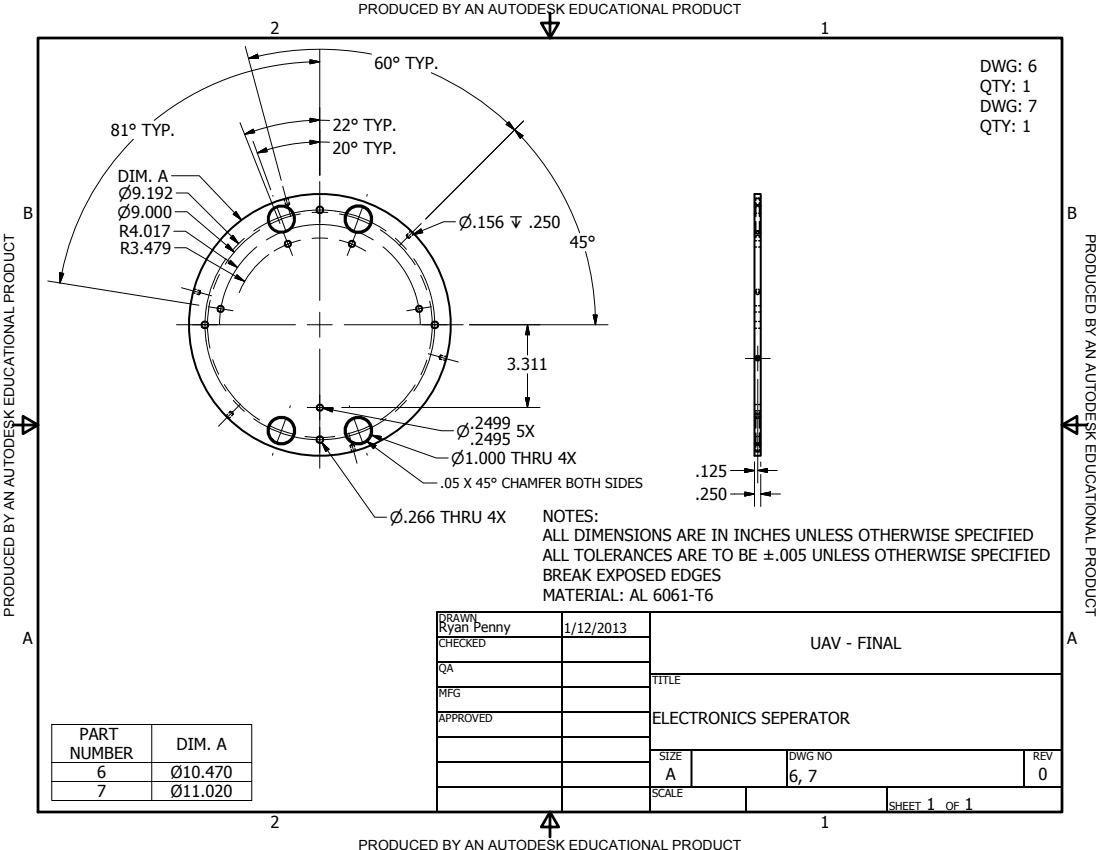
[picture p150: page 1]
TIO; A U T O D E S K E D U C A TIO; DRAWN Ryan Penny; CHECKED; MFG; APPROVED; UAV - FINAL; TITLE; ELECTRONICS SEPERATOR; SIZE A; SCALE; DWG NO 6, 7; REV 0; SHEET 1 OF 1; 60° TYP.; P1.000 THRU 4X; P.266 THRU 4X; 20° TYP.; 22° TYP. ° TYP.; PART NUMBER; DIM. A; DWG: 6 QTY: 1 DWG: 7 QTY: 1

PRODUCED BY AN AUTODESK EDUCATIONAL PRODUCT

.05 X 45° CHAMFER BOTH SIDES

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
