saltscapstone/capstone/robot_board/robot.brd

## EAGLE design robot_board/robot.brd (2013-04-26)

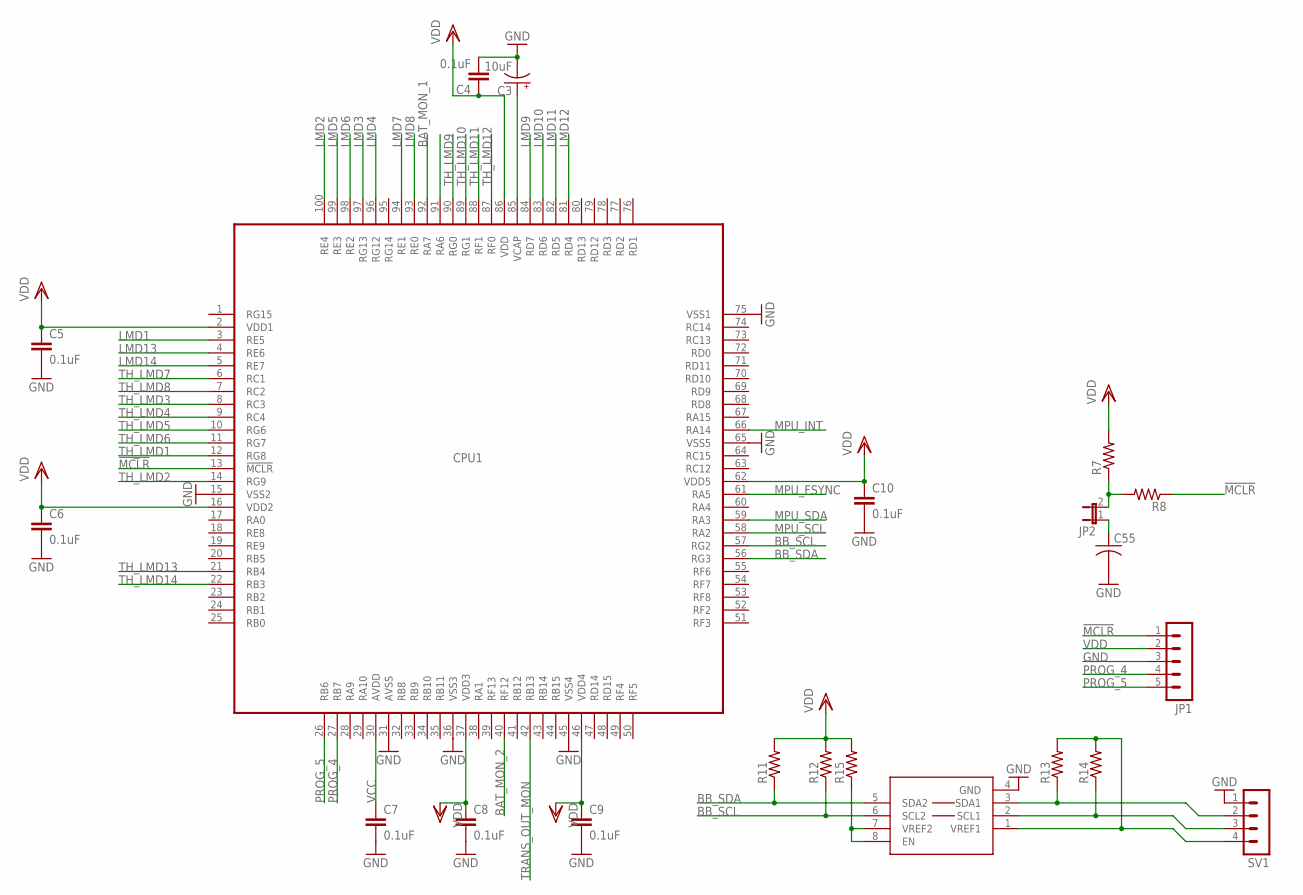
[picture p151: schematic robot.sch, sheet 1, PIC32]

Parts:
C3: 10uF; EIA3216
C4, C5, C6, C7, C8, C9, C10: 0.1uF; 0402-CAP
C55: C-USC0603; C0603
CPU1: DSPIC33FJ32GS610TQFP; TQFP100-14X14
JP1: MA05-1
JP2: JP1E; JP1
R7, R8, R11, R12, R13, R14, R15: R-US_R0603; R0603
SV1: MA04-1
U$17: PCA9306; PSOP-8

Connections:
!MCLR: CPU1.13 (!MCLR), JP1.1, R8.1
BAT_MON_1: CPU1.92 (RA7); also elsewhere on the board
BAT_MON_2: CPU1.40 (RF12); also elsewhere on the board
BB_SCL: CPU1.57 (RG2), R12.1, U$17.6 (SCL2)
BB_SDA: CPU1.56 (RG3), R11.1, U$17.5 (SDA2)
GND: C3.C (-), C4.2, C5.2, C6.2, C7.2, C8.2, C9.2, C10.2, C55.2, CPU1.15 (VSS2), CPU1.31 (AVSS), CPU1.36 (VSS3), CPU1.45 (VSS4), CPU1.65 (VSS5), CPU1.75 (VSS1), JP1.3, SV1.1, U$17.4 (GND); also elsewhere on the board
LMD1: CPU1.3 (RE5); also elsewhere on the board
LMD2: CPU1.100 (RE4); also elsewhere on the board
LMD3: CPU1.97 (RG13); also elsewhere on the board
LMD4: CPU1.96 (RG12); also elsewhere on the board
LMD5: CPU1.99 (RE3); also elsewhere on the board
LMD6: CPU1.98 (RE2); also elsewhere on the board
LMD7: CPU1.94 (RE1); also elsewhere on the board
LMD8: CPU1.93 (RE0); also elsewhere on the board
LMD9: CPU1.84 (RD7); also elsewhere on the board
LMD10: CPU1.83 (RD6); also elsewhere on the board
LMD11: CPU1.82 (RD5); also elsewhere on the board
LMD12: CPU1.81 (RD4); also elsewhere on the board
LMD13: CPU1.4 (RE6); also elsewhere on the board
LMD14: CPU1.5 (RE7); also elsewhere on the board
MPU_FSYNC: CPU1.61 (RA5); also elsewhere on the board
MPU_INT: CPU1.66 (RA14); also elsewhere on the board
MPU_SCL: CPU1.58 (RA2); also elsewhere on the board
MPU_SDA: CPU1.59 (RA3); also elsewhere on the board
unnamed: C3.A (+), CPU1.85 (VCAP)
unnamed: JP2.2, R7.1, R8.2
unnamed: C55.1, JP2.1
unnamed: R15.1, U$17.7 (VREF2), U$17.8 (EN)
unnamed: R13.1, SV1.2, U$17.3 (SDA1)
unnamed: R14.1, SV1.3, U$17.2 (SCL1)
unnamed: R13.2, R14.2, SV1.4, U$17.1 (VREF1)
PROG_4: CPU1.27 (RB7), JP1.4
PROG_5: CPU1.26 (RB6), JP1.5
TH_LMD1: CPU1.12 (RG8); also elsewhere on the board
TH_LMD2: CPU1.14 (RG9); also elsewhere on the board
TH_LMD3: CPU1.8 (RC3); also elsewhere on the board
TH_LMD4: CPU1.9 (RC4); also elsewhere on the board
TH_LMD5: CPU1.10 (RG6); also elsewhere on the board
TH_LMD6: CPU1.11 (RG7); also elsewhere on the board
TH_LMD7: CPU1.6 (RC1); also elsewhere on the board
TH_LMD8: CPU1.7 (RC2); also elsewhere on the board
TH_LMD9: CPU1.90 (RG0); also elsewhere on the board
TH_LMD10: CPU1.89 (RG1); also elsewhere on the board
TH_LMD11: CPU1.88 (RF1); also elsewhere on the board
TH_LMD12: CPU1.87 (RF0); also elsewhere on the board
TH_LMD13: CPU1.21 (RB4); also elsewhere on the board
TH_LMD14: CPU1.22 (RB3); also elsewhere on the board
TRANS_OUT_MON: CPU1.42 (RB13); also elsewhere on the board
VCC: C7.1, CPU1.30 (AVDD); also elsewhere on the board
VDD: C4.1, C5.1, C6.1, C8.1, C9.1, C10.1, CPU1.2 (VDD1), CPU1.16 (VDD2), CPU1.37 (VDD3), CPU1.46 (VDD4), CPU1.62 (VDD5), CPU1.86 (VDD), JP1.2, R7.2, R11.2, R12.2, R15.2; also elsewhere on the board

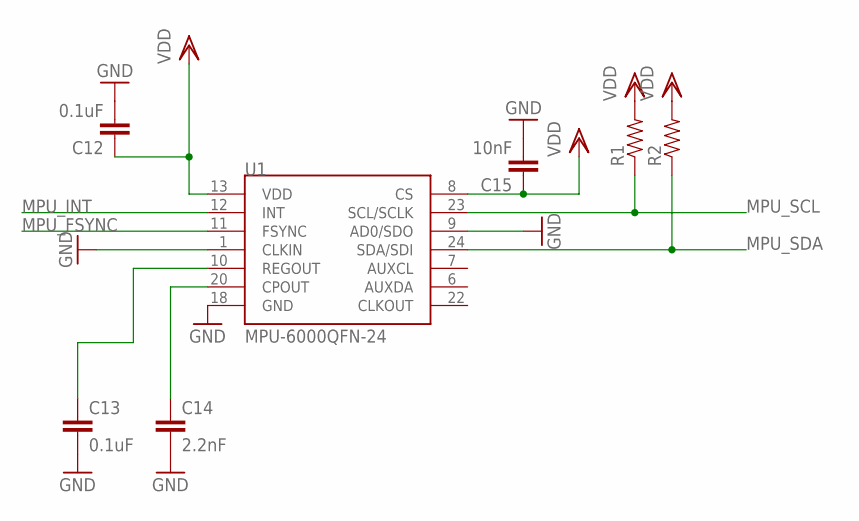
[picture p152: schematic robot.sch, sheet 2, MPU]

Parts:
C12, C13: 0.1uF; 0402-CAP
C14: 2.2nF; 0402-CAP
C15: 10nF; 0402-CAP
R1, R2: RESISTOR0603-RES; 0603-RES
U1: MPU-6000QFN-24; QFN-24-TESTING

Connections:
GND: C12.2, C13.2, C14.2, C15.2, U1.1 (CLKIN), U1.9 (AD0/SDO), U1.18 (GND); also elsewhere on the board
MPU_FSYNC: U1.11 (FSYNC); also elsewhere on the board
MPU_INT: U1.12 (INT); also elsewhere on the board
MPU_SCL: R1.1, U1.23 (SCL/SCLK); also elsewhere on the board
MPU_SDA: R2.1, U1.24 (SDA/SDI); also elsewhere on the board
unnamed: C14.1, U1.20 (CPOUT)
unnamed: C13.1, U1.10 (REGOUT)
VDD: C12.1, C15.1, R1.2, R2.2, U1.8 (CS), U1.13 (VDD); also elsewhere on the board

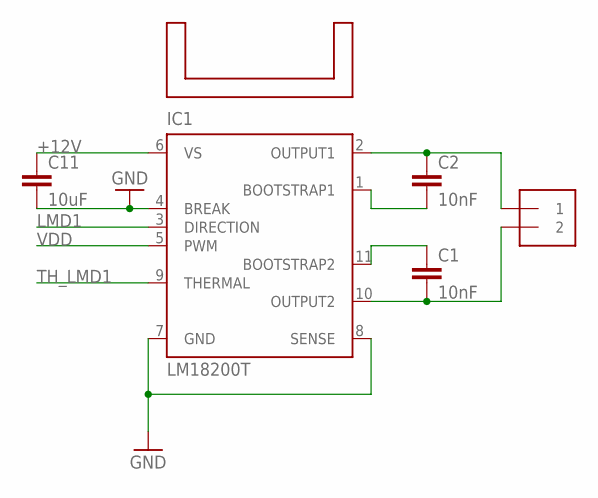
[picture p153: schematic robot.sch, sheet 3, LMD1]

Parts:
C1, C2: 10nF; 0402-CAP
C11: 10uF; 1206
IC1: LM18200T; TO-220-11
J13: 1X2-3.5MM
U$3: 593002B03400G

Connections:
+12V: C11.1, IC1.6 (VS); also elsewhere on the board
GND: C11.2, IC1.4 (BREAK), IC1.7 (GND), IC1.8 (SENSE); also elsewhere on the board
LMD1: IC1.3 (DIRECTION); also elsewhere on the board
unnamed: C2.1, IC1.2 (OUTPUT1), J13.1
unnamed: C2.2, IC1.1 (BOOTSTRAP1)
unnamed: C1.1, IC1.11 (BOOTSTRAP2)
unnamed: C1.2, IC1.10 (OUTPUT2), J13.2
TH_LMD1: IC1.9 (THERMAL); also elsewhere on the board
VDD: IC1.5 (PWM); also elsewhere on the board

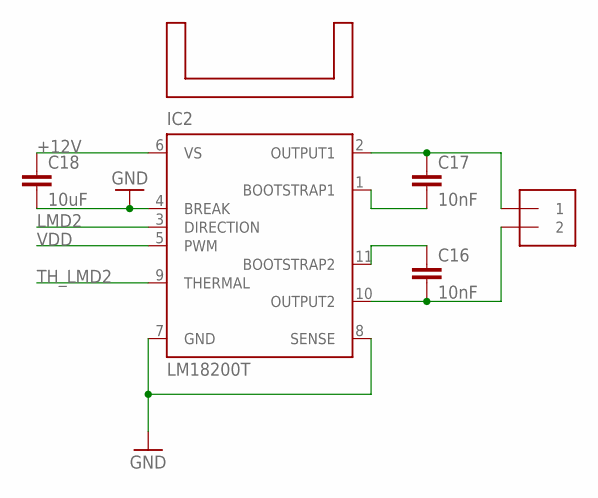
[picture p154: schematic robot.sch, sheet 4, LMD2]

Parts:
C16, C17: 10nF; 0402-CAP
C18: 10uF; 1206
IC2: LM18200T; TO-220-11
J2: 1X2-3.5MM
U$4: 593002B03400G

Connections:
+12V: C18.1, IC2.6 (VS); also elsewhere on the board
GND: C18.2, IC2.4 (BREAK), IC2.7 (GND), IC2.8 (SENSE); also elsewhere on the board
LMD2: IC2.3 (DIRECTION); also elsewhere on the board
unnamed: C17.1, IC2.2 (OUTPUT1), J2.1
unnamed: C17.2, IC2.1 (BOOTSTRAP1)
unnamed: C16.1, IC2.11 (BOOTSTRAP2)
unnamed: C16.2, IC2.10 (OUTPUT2), J2.2
TH_LMD2: IC2.9 (THERMAL); also elsewhere on the board
VDD: IC2.5 (PWM); also elsewhere on the board

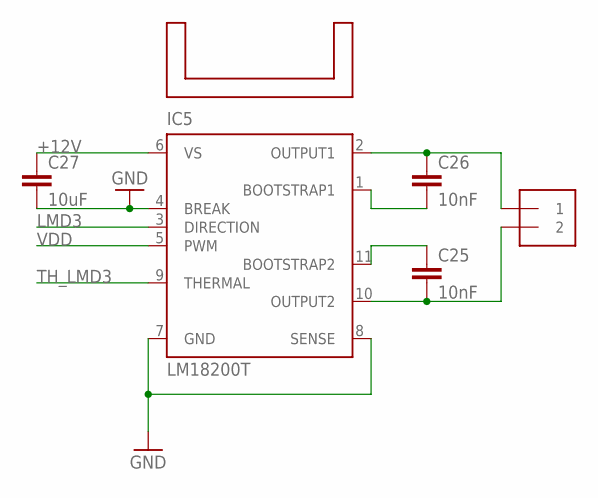
[picture p155: schematic robot.sch, sheet 5, LMD3]

Parts:
C25, C26: 10nF; 0402-CAP
C27: 10uF; 1206
IC5: LM18200T; TO-220-11
J5: 1X2-3.5MM
U$5: 593002B03400G

Connections:
+12V: C27.1, IC5.6 (VS); also elsewhere on the board
GND: C27.2, IC5.4 (BREAK), IC5.7 (GND), IC5.8 (SENSE); also elsewhere on the board
LMD3: IC5.3 (DIRECTION); also elsewhere on the board
unnamed: C26.1, IC5.2 (OUTPUT1), J5.1
unnamed: C26.2, IC5.1 (BOOTSTRAP1)
unnamed: C25.1, IC5.11 (BOOTSTRAP2)
unnamed: C25.2, IC5.10 (OUTPUT2), J5.2
TH_LMD3: IC5.9 (THERMAL); also elsewhere on the board
VDD: IC5.5 (PWM); also elsewhere on the board

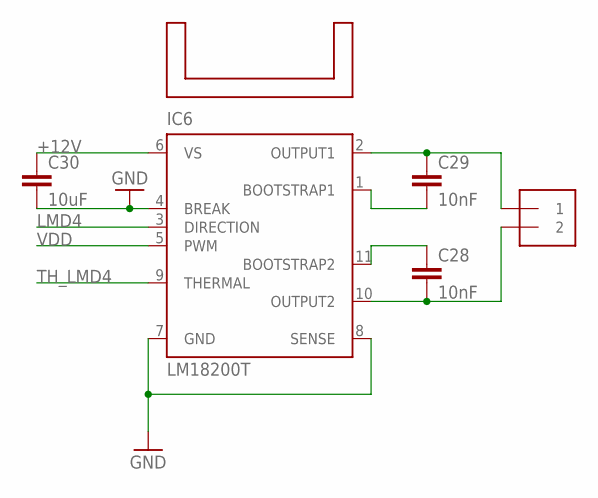
[picture p156: schematic robot.sch, sheet 6, LMD4]

Parts:
C28, C29: 10nF; 0402-CAP
C30: 10uF; 1206
IC6: LM18200T; TO-220-11
J6: 1X2-3.5MM
U$6: 593002B03400G

Connections:
+12V: C30.1, IC6.6 (VS); also elsewhere on the board
GND: C30.2, IC6.4 (BREAK), IC6.7 (GND), IC6.8 (SENSE); also elsewhere on the board
LMD4: IC6.3 (DIRECTION); also elsewhere on the board
unnamed: C29.1, IC6.2 (OUTPUT1), J6.1
unnamed: C29.2, IC6.1 (BOOTSTRAP1)
unnamed: C28.1, IC6.11 (BOOTSTRAP2)
unnamed: C28.2, IC6.10 (OUTPUT2), J6.2
TH_LMD4: IC6.9 (THERMAL); also elsewhere on the board
VDD: IC6.5 (PWM); also elsewhere on the board

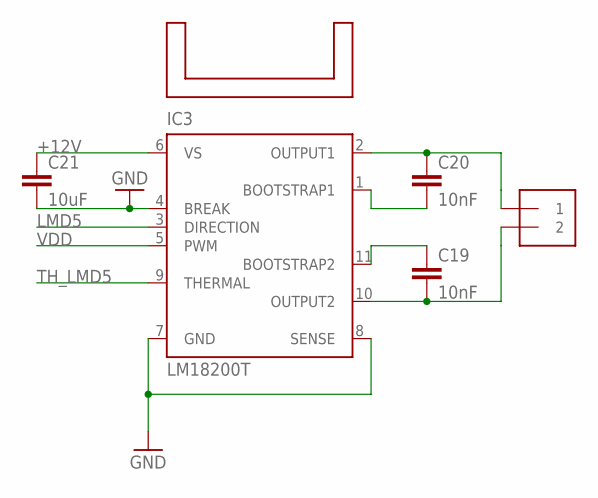
[picture p157: schematic robot.sch, sheet 7, LMD5]

Parts:
C19, C20: 10nF; 0402-CAP
C21: 10uF; 1206
IC3: LM18200T; TO-220-11
J3: 1X2-3.5MM
U$7: 593002B03400G

Connections:
+12V: C21.1, IC3.6 (VS); also elsewhere on the board
GND: C21.2, IC3.4 (BREAK), IC3.7 (GND), IC3.8 (SENSE); also elsewhere on the board
LMD5: IC3.3 (DIRECTION); also elsewhere on the board
unnamed: C20.1, IC3.2 (OUTPUT1), J3.1
unnamed: C20.2, IC3.1 (BOOTSTRAP1)
unnamed: C19.1, IC3.11 (BOOTSTRAP2)
unnamed: C19.2, IC3.10 (OUTPUT2), J3.2
TH_LMD5: IC3.9 (THERMAL); also elsewhere on the board
VDD: IC3.5 (PWM); also elsewhere on the board

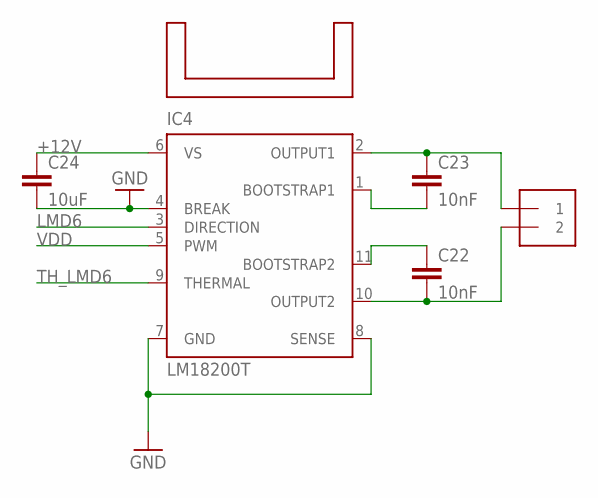
[picture p158: schematic robot.sch, sheet 8, LMD6]

Parts:
C22, C23: 10nF; 0402-CAP
C24: 10uF; 1206
IC4: LM18200T; TO-220-11
J4: 1X2-3.5MM
U$8: 593002B03400G

Connections:
+12V: C24.1, IC4.6 (VS); also elsewhere on the board
GND: C24.2, IC4.4 (BREAK), IC4.7 (GND), IC4.8 (SENSE); also elsewhere on the board
LMD6: IC4.3 (DIRECTION); also elsewhere on the board
unnamed: C23.1, IC4.2 (OUTPUT1), J4.1
unnamed: C23.2, IC4.1 (BOOTSTRAP1)
unnamed: C22.1, IC4.11 (BOOTSTRAP2)
unnamed: C22.2, IC4.10 (OUTPUT2), J4.2
TH_LMD6: IC4.9 (THERMAL); also elsewhere on the board
VDD: IC4.5 (PWM); also elsewhere on the board

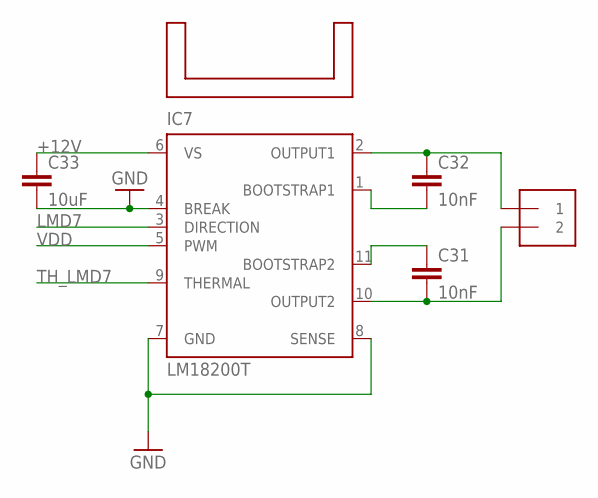
[picture p159: schematic robot.sch, sheet 9, LMD7]

Parts:
C31, C32: 10nF; 0402-CAP
C33: 10uF; 1206
IC7: LM18200T; TO-220-11
J7: 1X2-3.5MM
U$9: 593002B03400G

Connections:
+12V: C33.1, IC7.6 (VS); also elsewhere on the board
GND: C33.2, IC7.4 (BREAK), IC7.7 (GND), IC7.8 (SENSE); also elsewhere on the board
LMD7: IC7.3 (DIRECTION); also elsewhere on the board
unnamed: C32.1, IC7.2 (OUTPUT1), J7.1
unnamed: C32.2, IC7.1 (BOOTSTRAP1)
unnamed: C31.1, IC7.11 (BOOTSTRAP2)
unnamed: C31.2, IC7.10 (OUTPUT2), J7.2
TH_LMD7: IC7.9 (THERMAL); also elsewhere on the board
VDD: IC7.5 (PWM); also elsewhere on the board

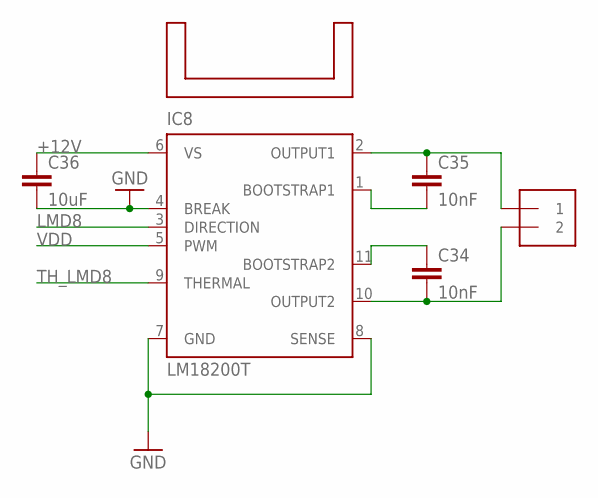
[picture p160: schematic robot.sch, sheet 10, LMD8]

Parts:
C34, C35: 10nF; 0402-CAP
C36: 10uF; 1206
IC8: LM18200T; TO-220-11
J8: 1X2-3.5MM
U$10: 593002B03400G

Connections:
+12V: C36.1, IC8.6 (VS); also elsewhere on the board
GND: C36.2, IC8.4 (BREAK), IC8.7 (GND), IC8.8 (SENSE); also elsewhere on the board
LMD8: IC8.3 (DIRECTION); also elsewhere on the board
unnamed: C35.1, IC8.2 (OUTPUT1), J8.1
unnamed: C35.2, IC8.1 (BOOTSTRAP1)
unnamed: C34.1, IC8.11 (BOOTSTRAP2)
unnamed: C34.2, IC8.10 (OUTPUT2), J8.2
TH_LMD8: IC8.9 (THERMAL); also elsewhere on the board
VDD: IC8.5 (PWM); also elsewhere on the board

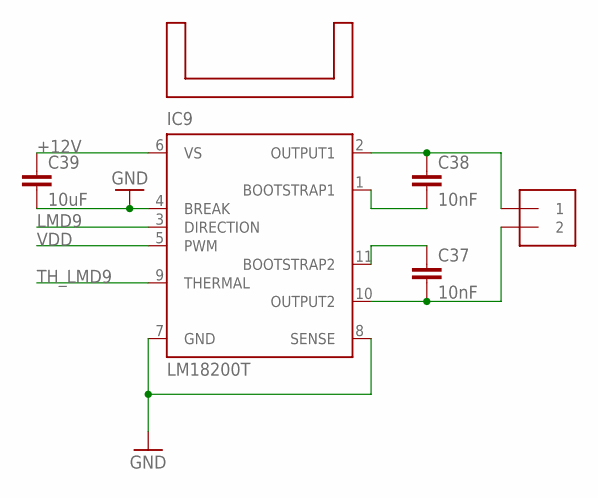
[picture p161: schematic robot.sch, sheet 11, LMD9]

Parts:
C37, C38: 10nF; 0402-CAP
C39: 10uF; 1206
IC9: LM18200T; TO-220-11
J9: 1X2-3.5MM
U$11: 593002B03400G

Connections:
+12V: C39.1, IC9.6 (VS); also elsewhere on the board
GND: C39.2, IC9.4 (BREAK), IC9.7 (GND), IC9.8 (SENSE); also elsewhere on the board
LMD9: IC9.3 (DIRECTION); also elsewhere on the board
unnamed: C38.1, IC9.2 (OUTPUT1), J9.1
unnamed: C38.2, IC9.1 (BOOTSTRAP1)
unnamed: C37.1, IC9.11 (BOOTSTRAP2)
unnamed: C37.2, IC9.10 (OUTPUT2), J9.2
TH_LMD9: IC9.9 (THERMAL); also elsewhere on the board
VDD: IC9.5 (PWM); also elsewhere on the board

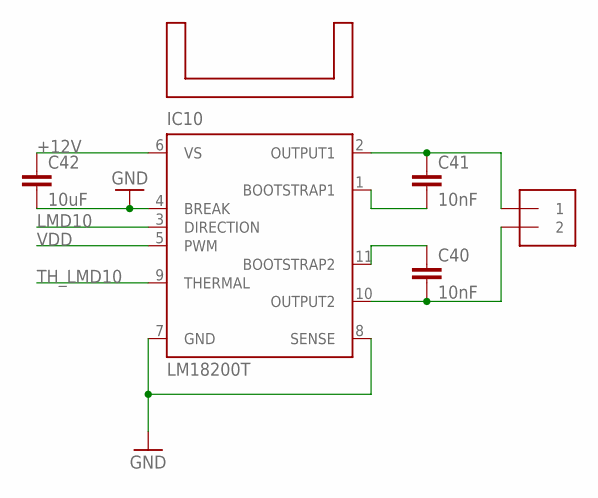
[picture p162: schematic robot.sch, sheet 12, LMD10]

Parts:
C40, C41: 10nF; 0402-CAP
C42: 10uF; 1206
IC10: LM18200T; TO-220-11
J10: 1X2-3.5MM
U$12: 593002B03400G

Connections:
+12V: C42.1, IC10.6 (VS); also elsewhere on the board
GND: C42.2, IC10.4 (BREAK), IC10.7 (GND), IC10.8 (SENSE); also elsewhere on the board
LMD10: IC10.3 (DIRECTION); also elsewhere on the board
unnamed: C41.1, IC10.2 (OUTPUT1), J10.1
unnamed: C41.2, IC10.1 (BOOTSTRAP1)
unnamed: C40.1, IC10.11 (BOOTSTRAP2)
unnamed: C40.2, IC10.10 (OUTPUT2), J10.2
TH_LMD10: IC10.9 (THERMAL); also elsewhere on the board
VDD: IC10.5 (PWM); also elsewhere on the board

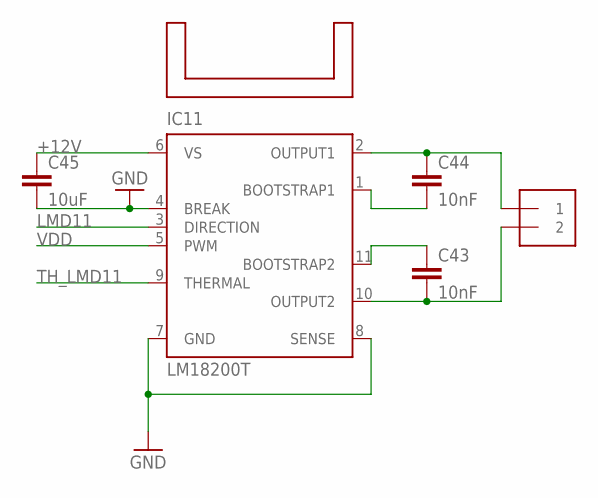
[picture p163: schematic robot.sch, sheet 13, LMD11]

Parts:
C43, C44: 10nF; 0402-CAP
C45: 10uF; 1206
IC11: LM18200T; TO-220-11
J11: 1X2-3.5MM
U$13: 593002B03400G

Connections:
+12V: C45.1, IC11.6 (VS); also elsewhere on the board
GND: C45.2, IC11.4 (BREAK), IC11.7 (GND), IC11.8 (SENSE); also elsewhere on the board
LMD11: IC11.3 (DIRECTION); also elsewhere on the board
unnamed: C44.1, IC11.2 (OUTPUT1), J11.1
unnamed: C44.2, IC11.1 (BOOTSTRAP1)
unnamed: C43.1, IC11.11 (BOOTSTRAP2)
unnamed: C43.2, IC11.10 (OUTPUT2), J11.2
TH_LMD11: IC11.9 (THERMAL); also elsewhere on the board
VDD: IC11.5 (PWM); also elsewhere on the board

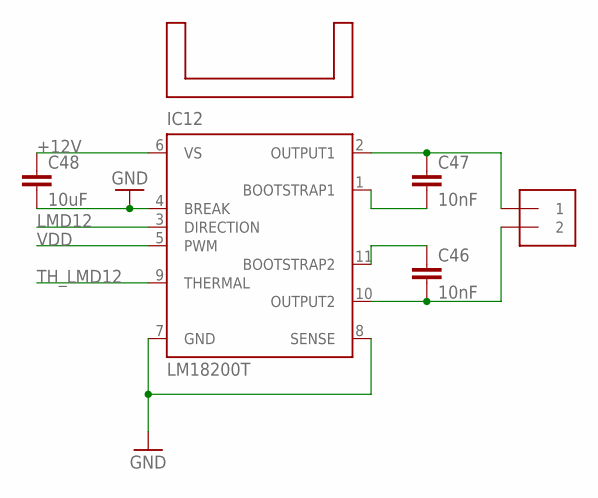
[picture p164: schematic robot.sch, sheet 14, LMD12]

Parts:
C46, C47: 10nF; 0402-CAP
C48: 10uF; 1206
IC12: LM18200T; TO-220-11
J14: 1X2-3.5MM
U$14: 593002B03400G

Connections:
+12V: C48.1, IC12.6 (VS); also elsewhere on the board
GND: C48.2, IC12.4 (BREAK), IC12.7 (GND), IC12.8 (SENSE); also elsewhere on the board
LMD12: IC12.3 (DIRECTION); also elsewhere on the board
unnamed: C47.1, IC12.2 (OUTPUT1), J14.1
unnamed: C47.2, IC12.1 (BOOTSTRAP1)
unnamed: C46.1, IC12.11 (BOOTSTRAP2)
unnamed: C46.2, IC12.10 (OUTPUT2), J14.2
TH_LMD12: IC12.9 (THERMAL); also elsewhere on the board
VDD: IC12.5 (PWM); also elsewhere on the board

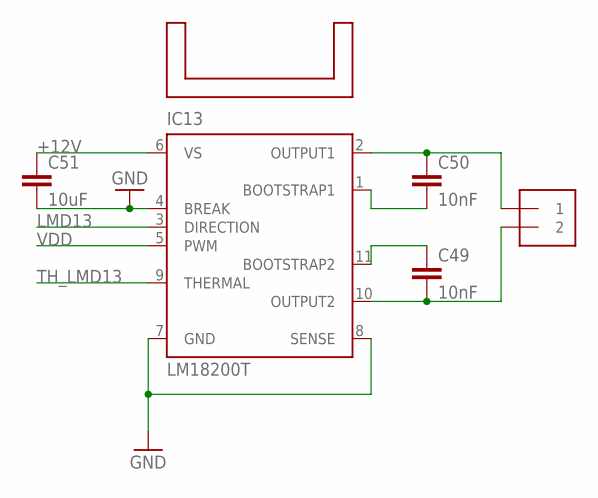
[picture p165: schematic robot.sch, sheet 15, LMD13]

Parts:
C49, C50: 10nF; 0402-CAP
C51: 10uF; 1206
IC13: LM18200T; TO-220-11
J15: 1X2-3.5MM
U$15: 593002B03400G

Connections:
+12V: C51.1, IC13.6 (VS); also elsewhere on the board
GND: C51.2, IC13.4 (BREAK), IC13.7 (GND), IC13.8 (SENSE); also elsewhere on the board
LMD13: IC13.3 (DIRECTION); also elsewhere on the board
unnamed: C50.1, IC13.2 (OUTPUT1), J15.1
unnamed: C50.2, IC13.1 (BOOTSTRAP1)
unnamed: C49.1, IC13.11 (BOOTSTRAP2)
unnamed: C49.2, IC13.10 (OUTPUT2), J15.2
TH_LMD13: IC13.9 (THERMAL); also elsewhere on the board
VDD: IC13.5 (PWM); also elsewhere on the board

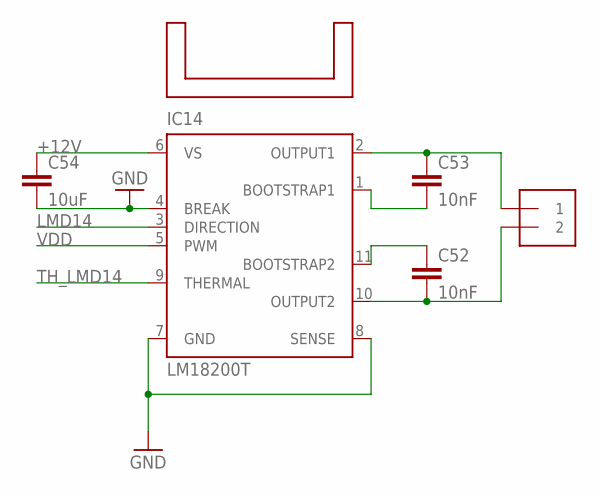
[picture p166: schematic robot.sch, sheet 16, LMD14]

Parts:
C52, C53: 10nF; 0402-CAP
C54: 10uF; 1206
IC14: LM18200T; TO-220-11
J16: 1X2-3.5MM
U$16: 593002B03400G

Connections:
+12V: C54.1, IC14.6 (VS); also elsewhere on the board
GND: C54.2, IC14.4 (BREAK), IC14.7 (GND), IC14.8 (SENSE); also elsewhere on the board
LMD14: IC14.3 (DIRECTION); also elsewhere on the board
unnamed: C53.1, IC14.2 (OUTPUT1), J16.1
unnamed: C53.2, IC14.1 (BOOTSTRAP1)
unnamed: C52.1, IC14.11 (BOOTSTRAP2)
unnamed: C52.2, IC14.10 (OUTPUT2), J16.2
TH_LMD14: IC14.9 (THERMAL); also elsewhere on the board
VDD: IC14.5 (PWM); also elsewhere on the board

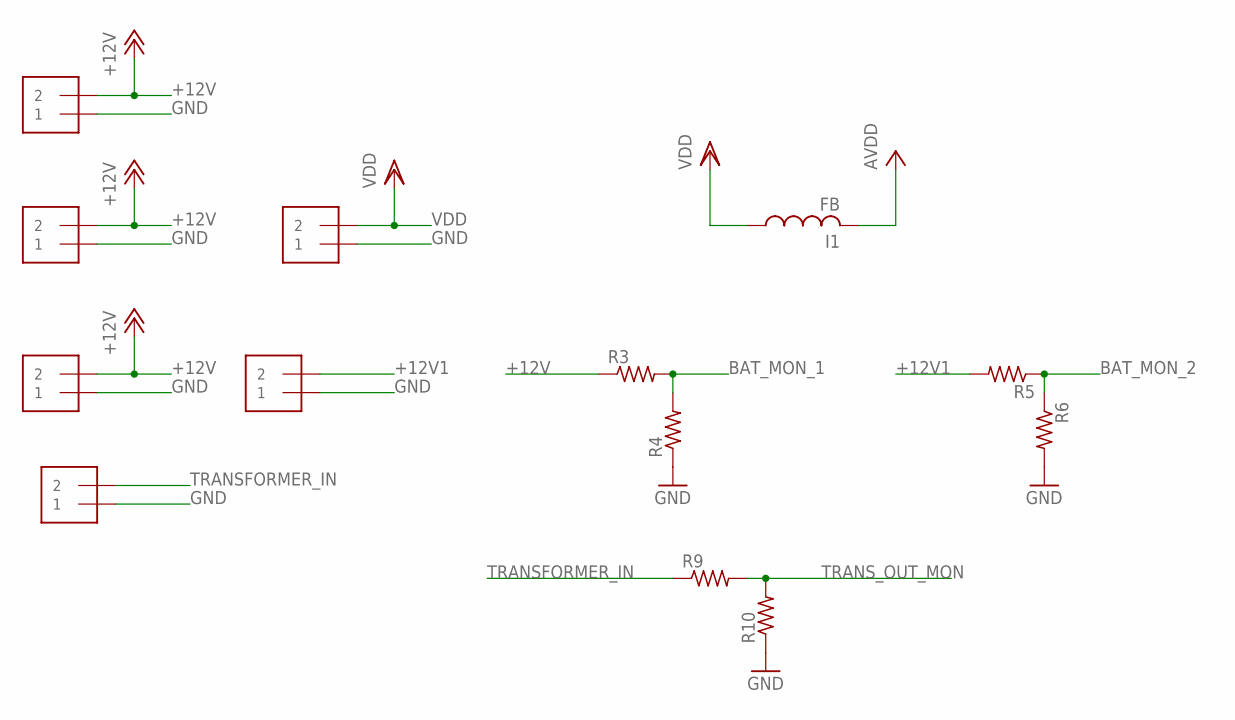
[picture p167: schematic robot.sch, sheet 17, Power & Battery Monitor]

Parts:
I1: FB
J1, J12, J17, J18, J19, J20: 1X2-3.5MM
R3, R4, R5, R6, R9, R10: R-US_R0603; R0603

Connections:
+12V: J12.2, J17.2, J20.2, R3.1; also elsewhere on the board
+12V1: J18.2, R5.2
BAT_MON_1: R3.2, R4.2; also elsewhere on the board
BAT_MON_2: R5.1, R6.1; also elsewhere on the board
GND: J1.1, J12.1, J17.1, J18.1, J19.1, J20.1, R4.1, R6.2, R10.1; also elsewhere on the board
TRANSFORMER_IN: J19.2, R9.1
TRANS_OUT_MON: R9.2, R10.2; also elsewhere on the board
VCC: I1.P$2 (2); also elsewhere on the board
VDD: I1.P$1 (1), J1.2; also elsewhere on the board

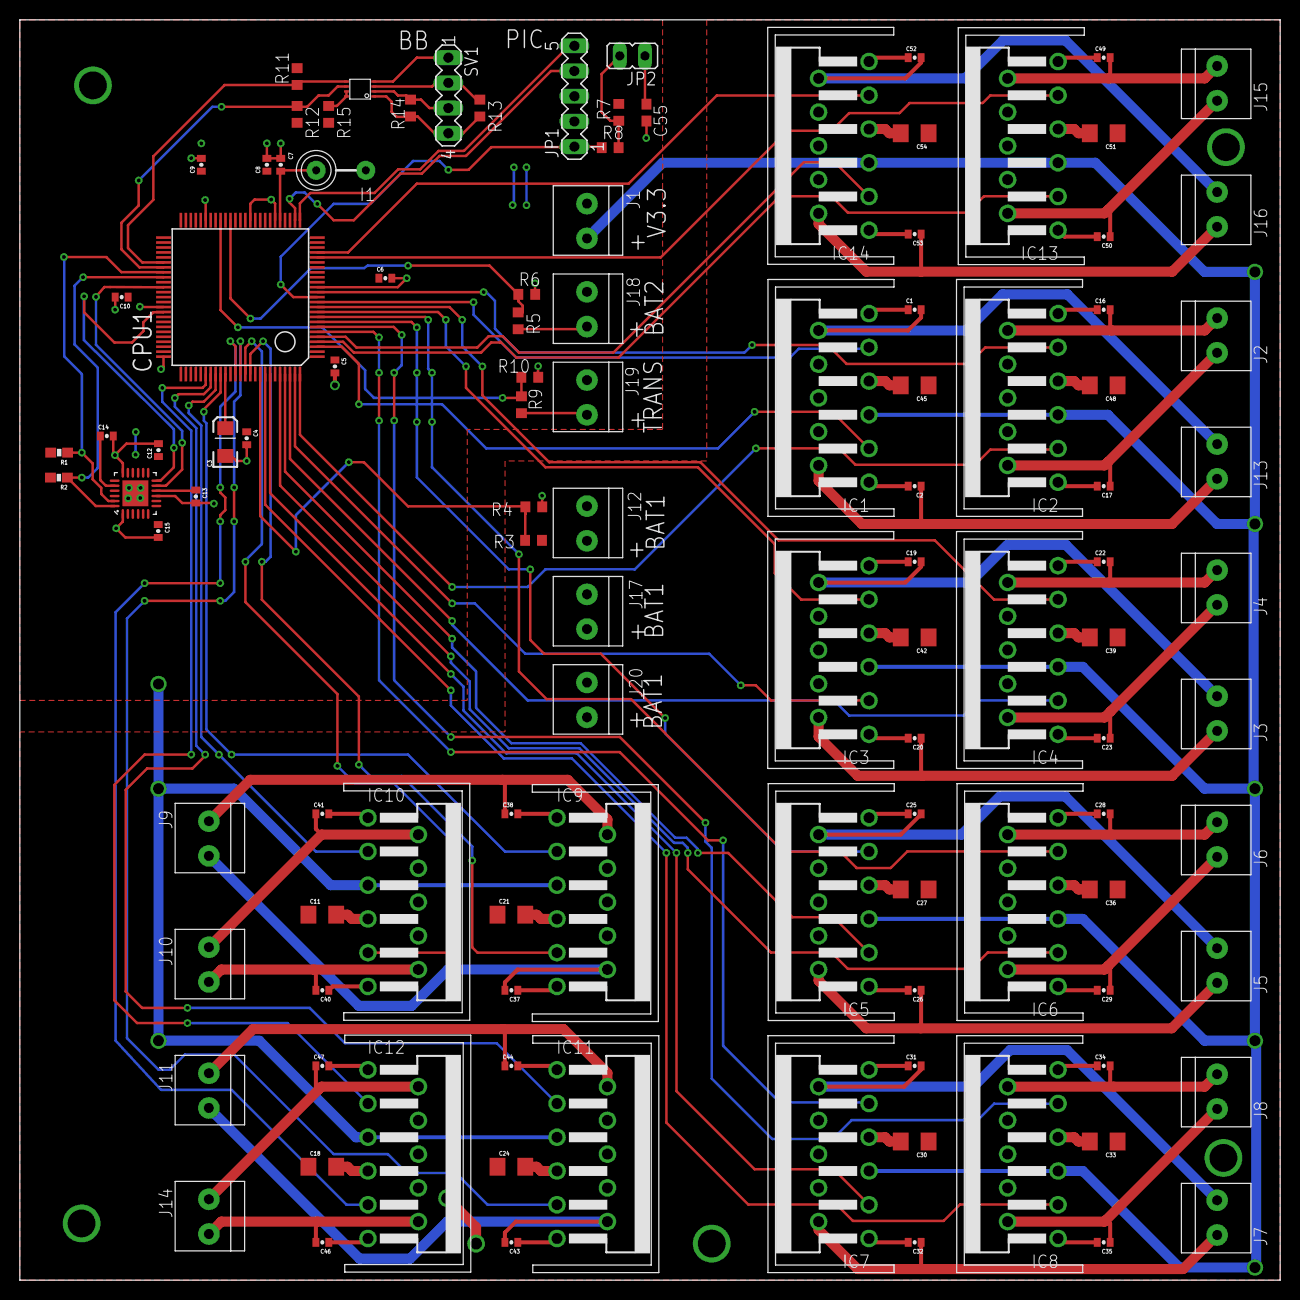
[picture p168: board robot.brd from above]

Board: 2 copper layers, 127.0 x 127.0 mm, 125 parts (0 on the bottom side), 111 nets.
