saltscapstone/capstone/robot_code/Ini.h

/* 
 * File:   Ini.h
 * Author: Ryan
 *
 * Created on March 20, 2013, 2:20 PM
 */

#ifndef INI_H
#define	INI_H

#include "p33FJ64GS610.h"



void InitializeOsc(void);
void InitializeIO(void);
void InitializeMpu(void);

#endif	/* INI_H */
